ravithakkar011/ECE445-Home-Appliance-Energy-Monitor/boards/board3/plainboard.jpg

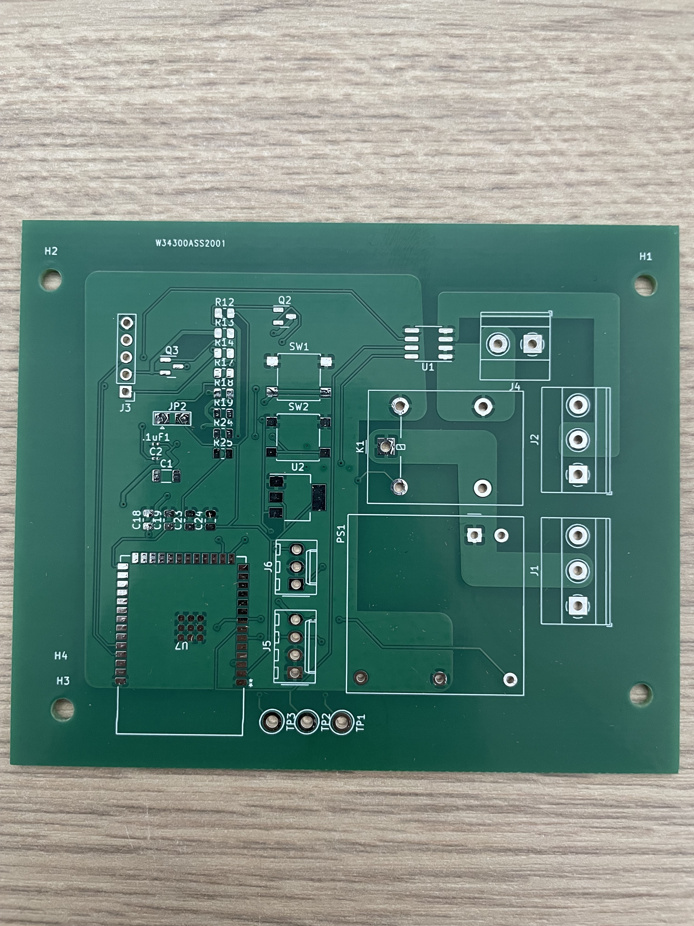
boards/board3/plainboard.jpg
