ravithakkar011/ECE445-Home-Appliance-Energy-Monitor/shared-notebook/FinalPresentation.pdf

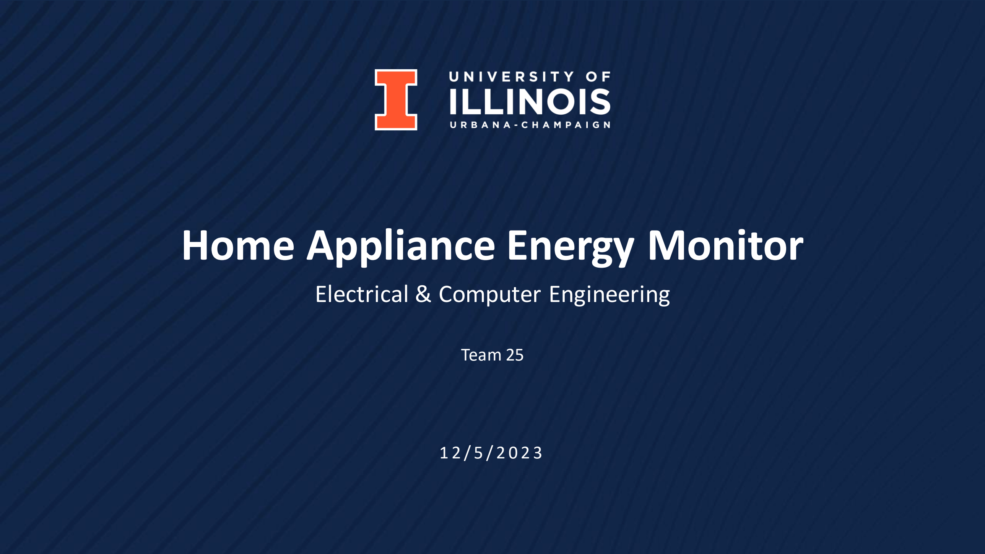
[picture p17: page 1]

# Home Appliance Energy Monitor

## Electrical & Computer Engineering

Team 25

1 2 / 5 / 2 0 2 3

## Team Members

- Guneet Sachdeva: Senior in Computer Engineering
- Om Patel: Senior in Computer Engineering
- Ravi Thakkar: Senior in Computer Engineering

Photos of Team Members

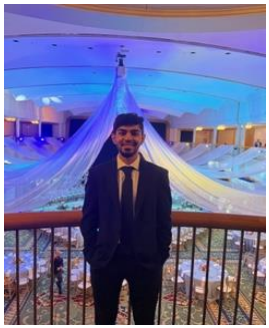
[picture p18: figure]
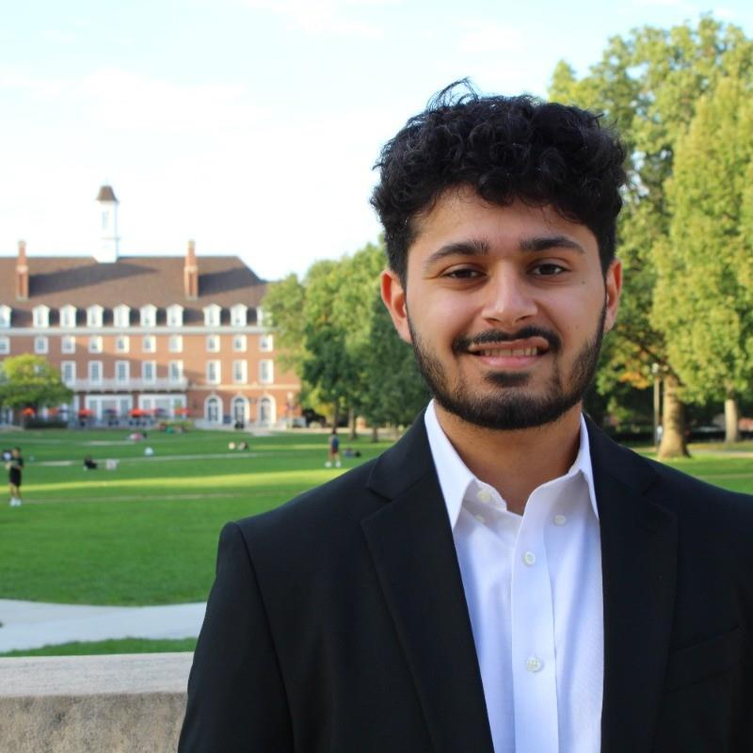
[picture p19: figure]

1 | G R A I N G E R E N G I N E E R I N G

## Team Intro

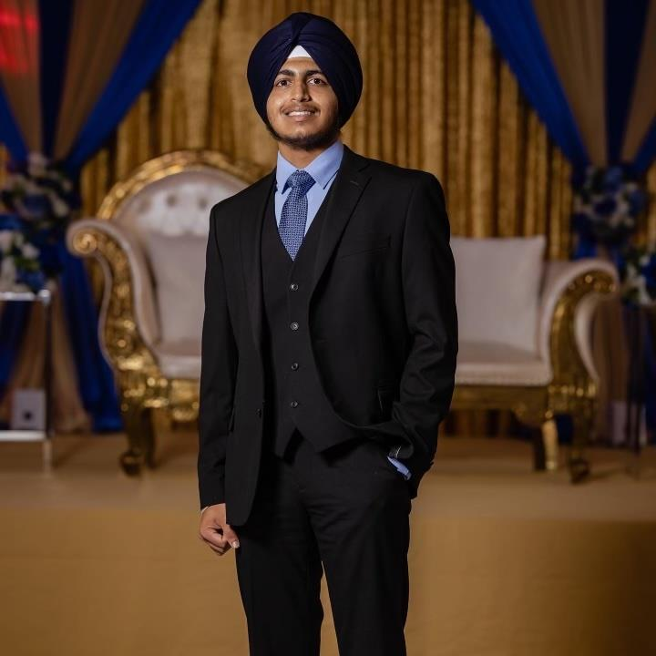
[picture p20: figure]

E L E C T R I C A L & C O M P U T E R E N G I N E E R I N G

## What compelled us to pick this project?

## Background

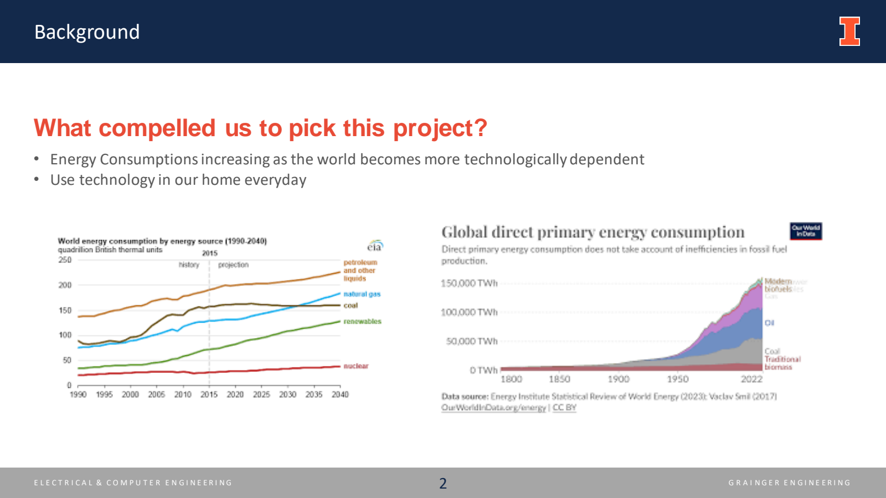
[picture p21: page 3]

- Energy Consumptions increasing as the world becomes more technologically dependent
- Use technology in our home everyday

## What problems need to be solved?

- The modern lifestyle does not allow us to be mindful of electricity consumption
- Users are unaware of which appliances disproportionately contribute to the total electricity consumption
- Therefore, an average of 34% of electricity in a household is wasted

## Problem

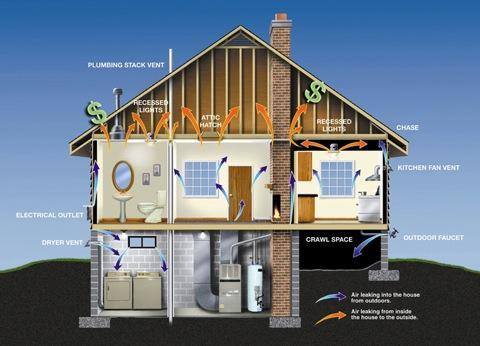
[picture p22: figure]

## What is the solution to the problem?

- An energy metering system that relays power consumption data to a user-friendly application

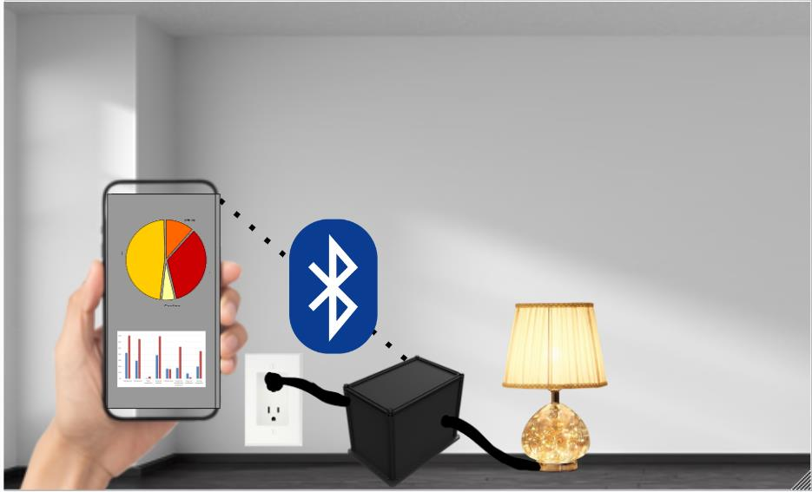
[picture p23: figure]

Visual Aid of Solution

## Solution

## Agenda

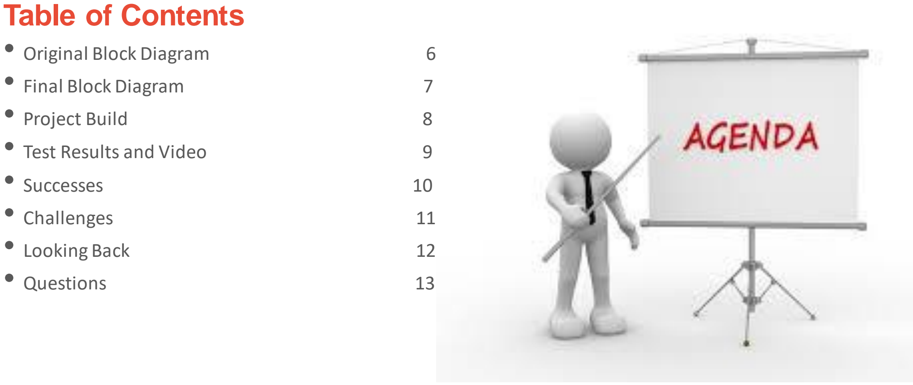
[picture p24: figure]
Table of Contents; • Original Block Diagram; • Final Block Diagram; • Project Build; • Test Results and Video; • Successes; • Challenges; • Looking Back; • Questions

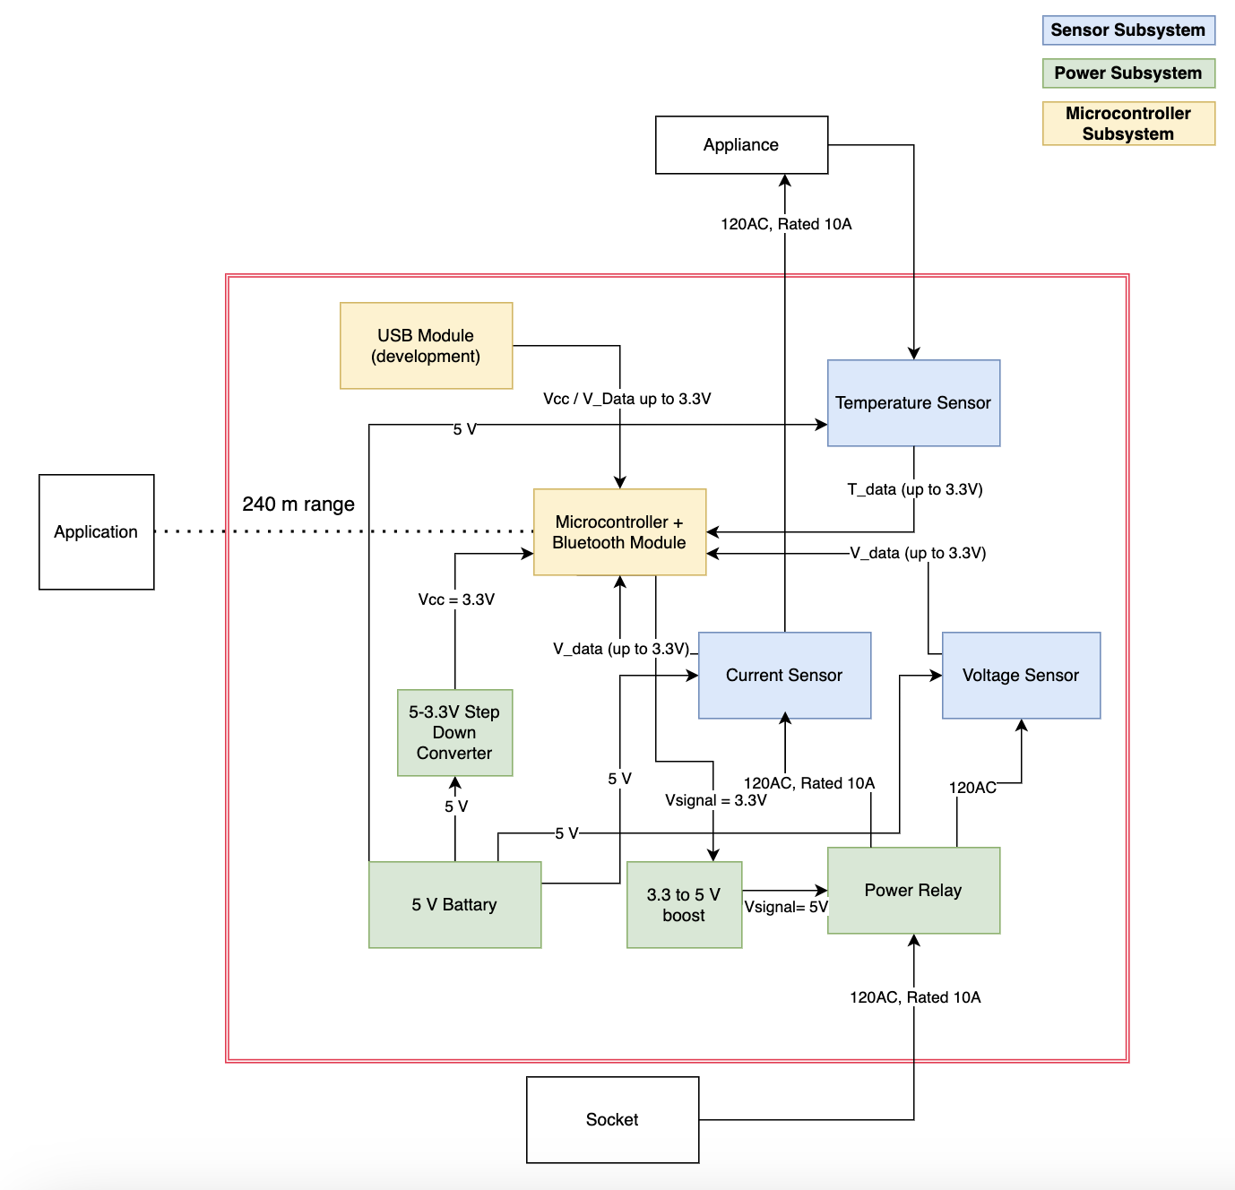
[picture p25: figure]

## - 4 Subsystem Model

### oHigh Power oLow Power oSensor

- Temperature
- Current
- Voltage

### oMicrocontroller

- MCU Control Firmware
- Graphical Application
- BLE Server/Service Setup Firmware

## Original Block Diagram

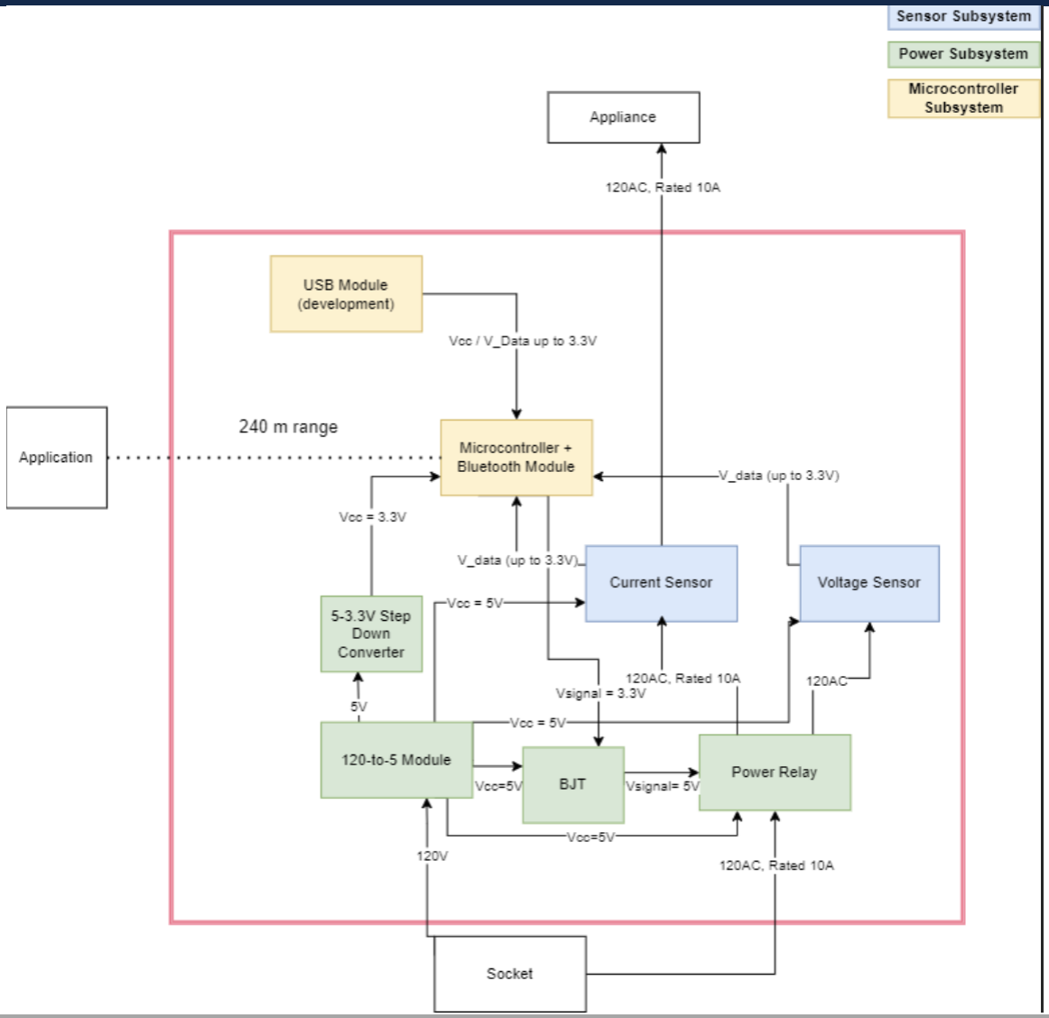
[picture p26: figure]

## - 3 Subsystem Model

### oHigh Power oLow Power oSensor

- Temperature
- Current
- Voltage

### oMicrocontroller

- MCU Control Firmware
- Graphical Application
- BLE Server/Service Setup Firmware

## Final Block Diagram

## What our project looks like?

## Project Build

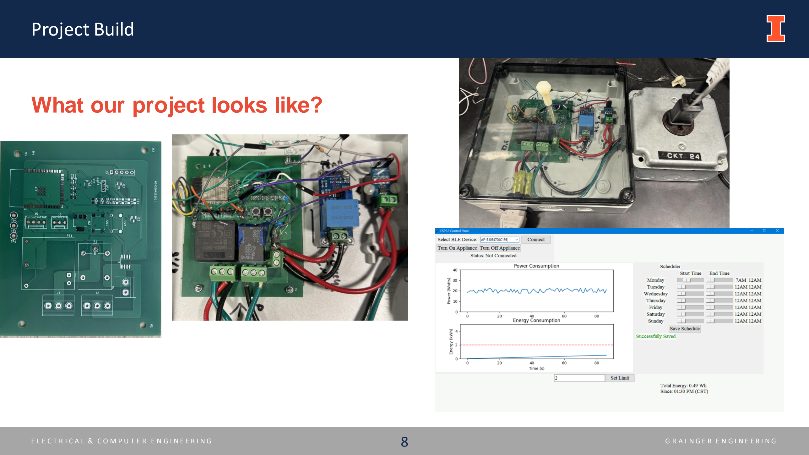
[picture p27: page 9]

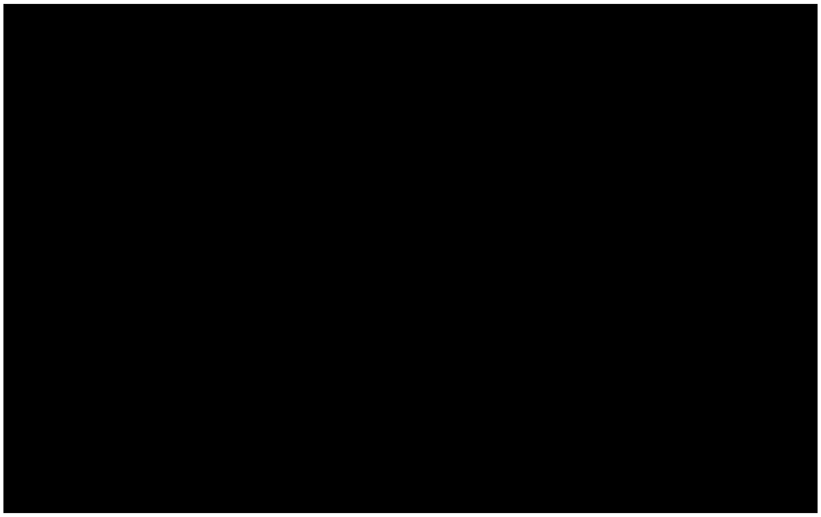
[picture p28: figure]

## Tests and Results: Fan

- Fan off, Power Relay On
- Voltmeter: about 120 Volts
- Ammeter: 0 A
- Fan on level 1, Power Relay On
- Voltmeter: about 120 Volts
- Ammeter: 242.5 mA
- Fan on level 2, Power Relay On
- Voltmeter: about 120 Volts
- Ammeter: 312.5 mA
- Fan on level 1, Power Relay Off
- Voltmeter: about 0 Volts
- Ammeter: 0 A

## Test Results and Video

## Where did we succeed in our project?

- Handling high voltage and current coming out of the socket
- Controlling power supply to the connected appliance
- Relaying information to the application via Bluetooth Low Energy

## Successes

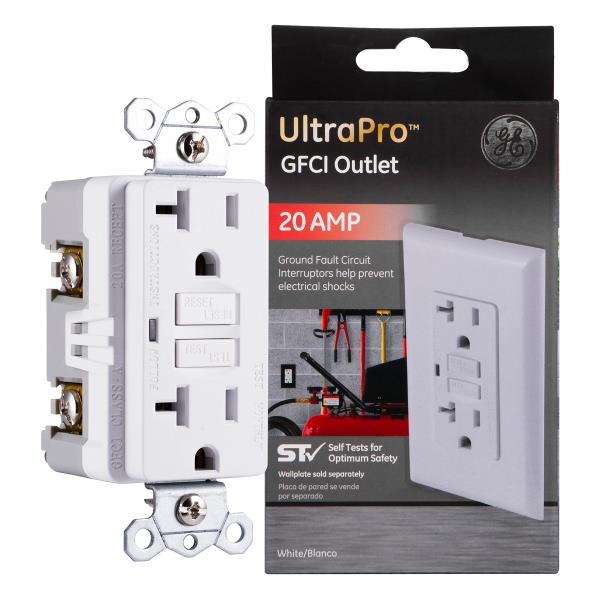
[picture p29: figure]
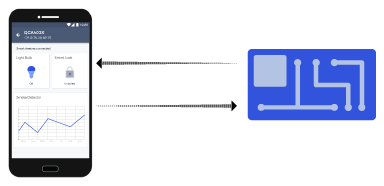
[picture p30: figure]
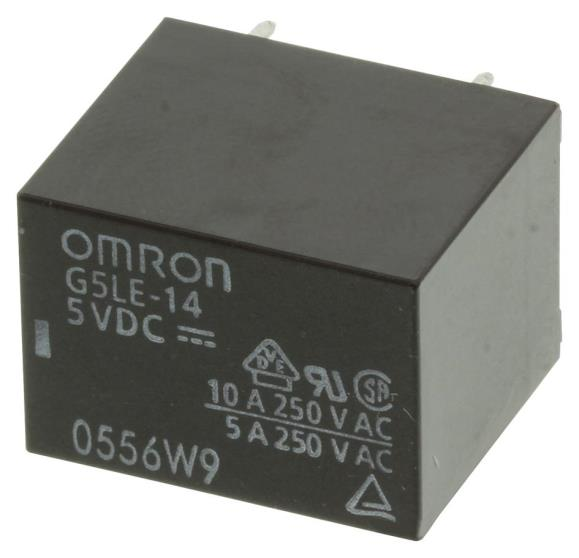
[picture p31: figure]

## - What are some challenges we faced with our project?

- Understanding the Microcontroller pin assignments
- Soldering the Microcontroller
- Current Sensor got Burnt during testing
- Too much power draw by Microcontroller chip
- Could not use 3.3V to 5V boost

## Challenges

## What process and design elements would we change?

- Solder components that use the oven first
- Get extra parts early on
- Check user rating of modules that we use
- Separate PCBs for high and low voltage
- Include more access points for testing

What did we learn?
- Theoretical circuit design vs physical implementation
- Microcontroller based logic
- Industry based design procedures

## Looking Back

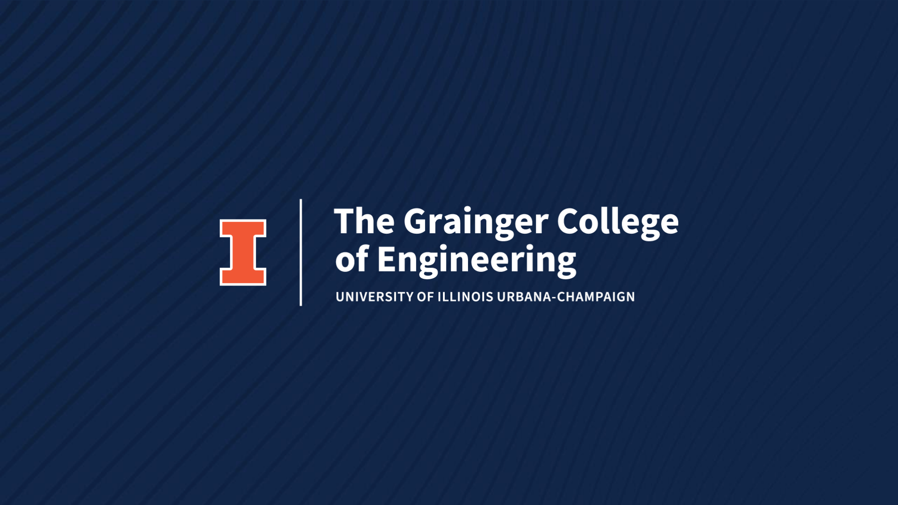
[picture p32: page 14]
