ravithakkar011/ECE445-Home-Appliance-Energy-Monitor/models/originalBlockDiagram.pdf

Sensor Subsystem

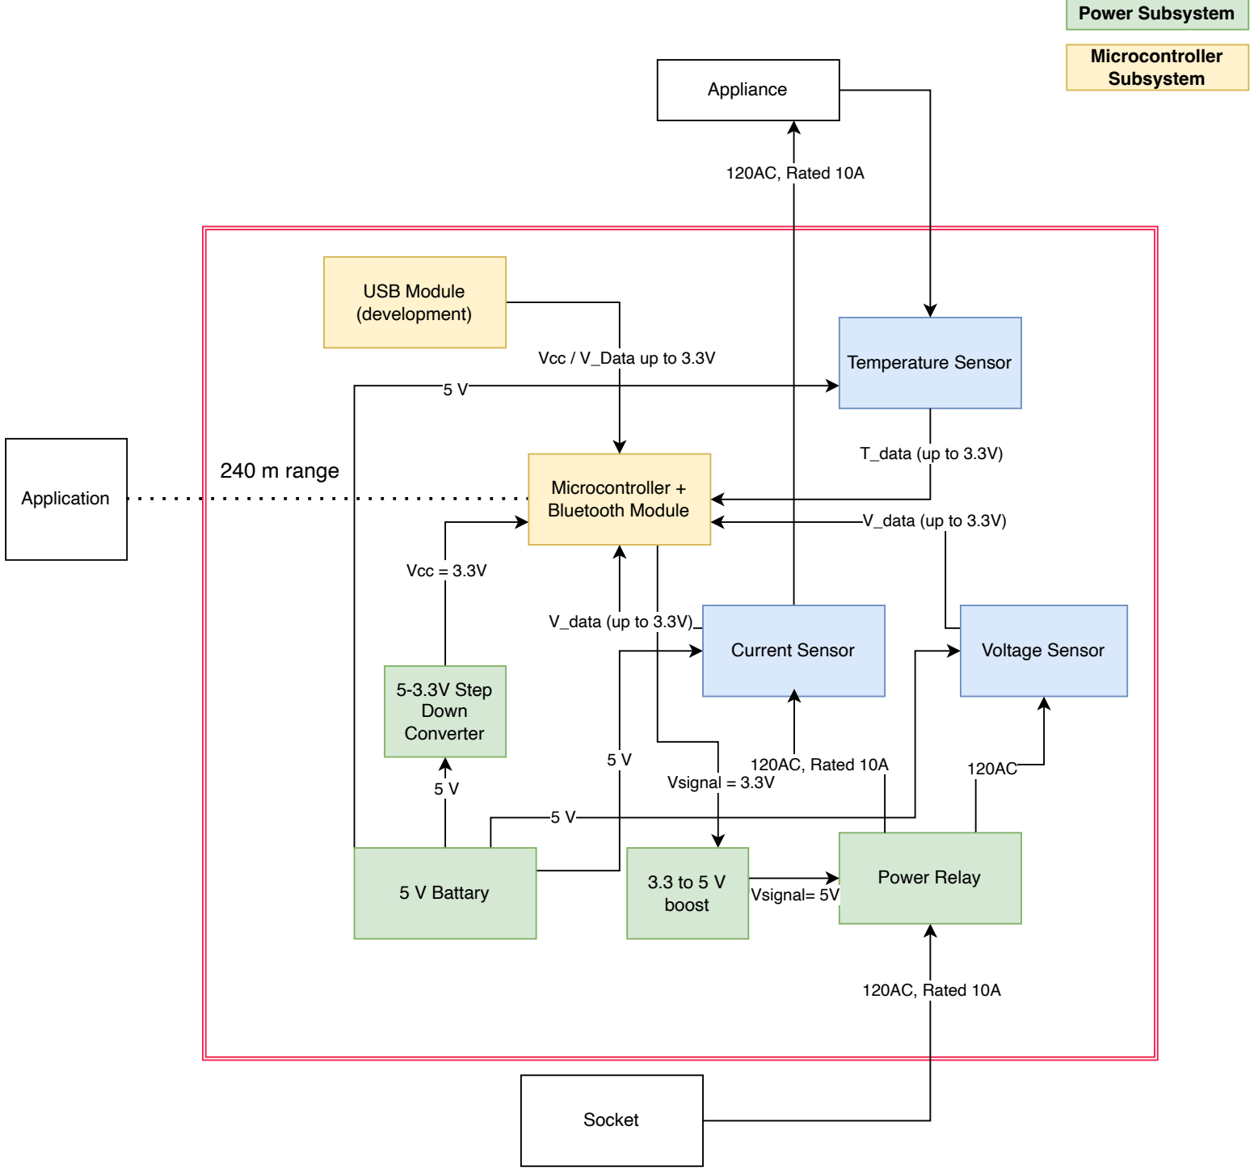
[picture p33: figure]
Appliance; Vsignal = 3.3V; Microcontroller + Bluetooth Module; 120AC, Rated 10A; Socket; Application; 240 m range; 5 V Battary; Power Relay; V_data (up to 3.3V); Voltage Sensor; Current Sensor; Vcc = 3.3V; 5-3.3V Step Down Converter; Power Subsystem; Microcontroller Subsystem; Vcc / V_Data up to 3.3V; USB Module (development); Vsignal= 5V 3.3 to 5 V boost; Temperature Sensor; T_data (up to 3.3V)
