ravithakkar011/ECE445-Home-Appliance-Energy-Monitor/notebooks/guneet/SensorEquationsAndUnderstanding.pdf

// currSensorValue = analogRead(A12);

Read the sensor values from an actual ADC pin

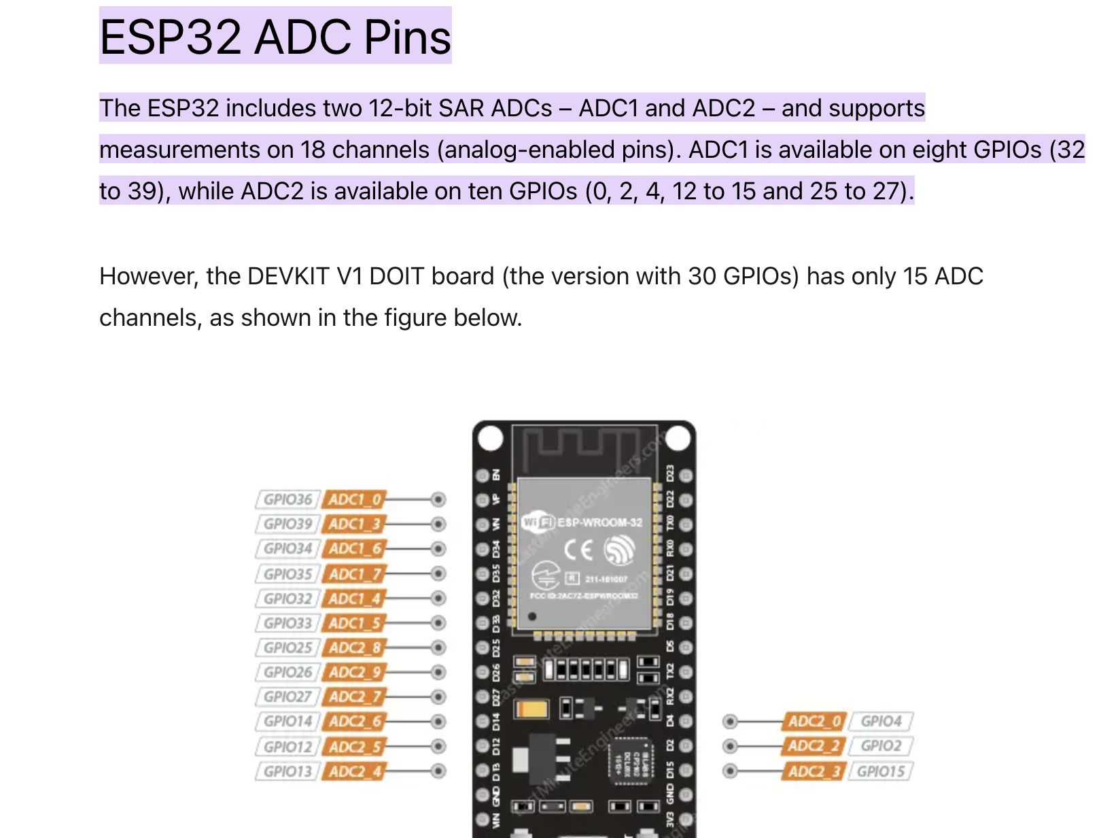
[picture p34: figure]

// currVoltage = (currSensorValue * (5.0/ 1024));

Have to bring this signal to a digital equivalent by multiplying by Vref and then dividing by the ADC resolution bits.

// current = (2.5 - currVoltage) / 0.185;

Match the Vout to a sensed current using the linear equation from the graph

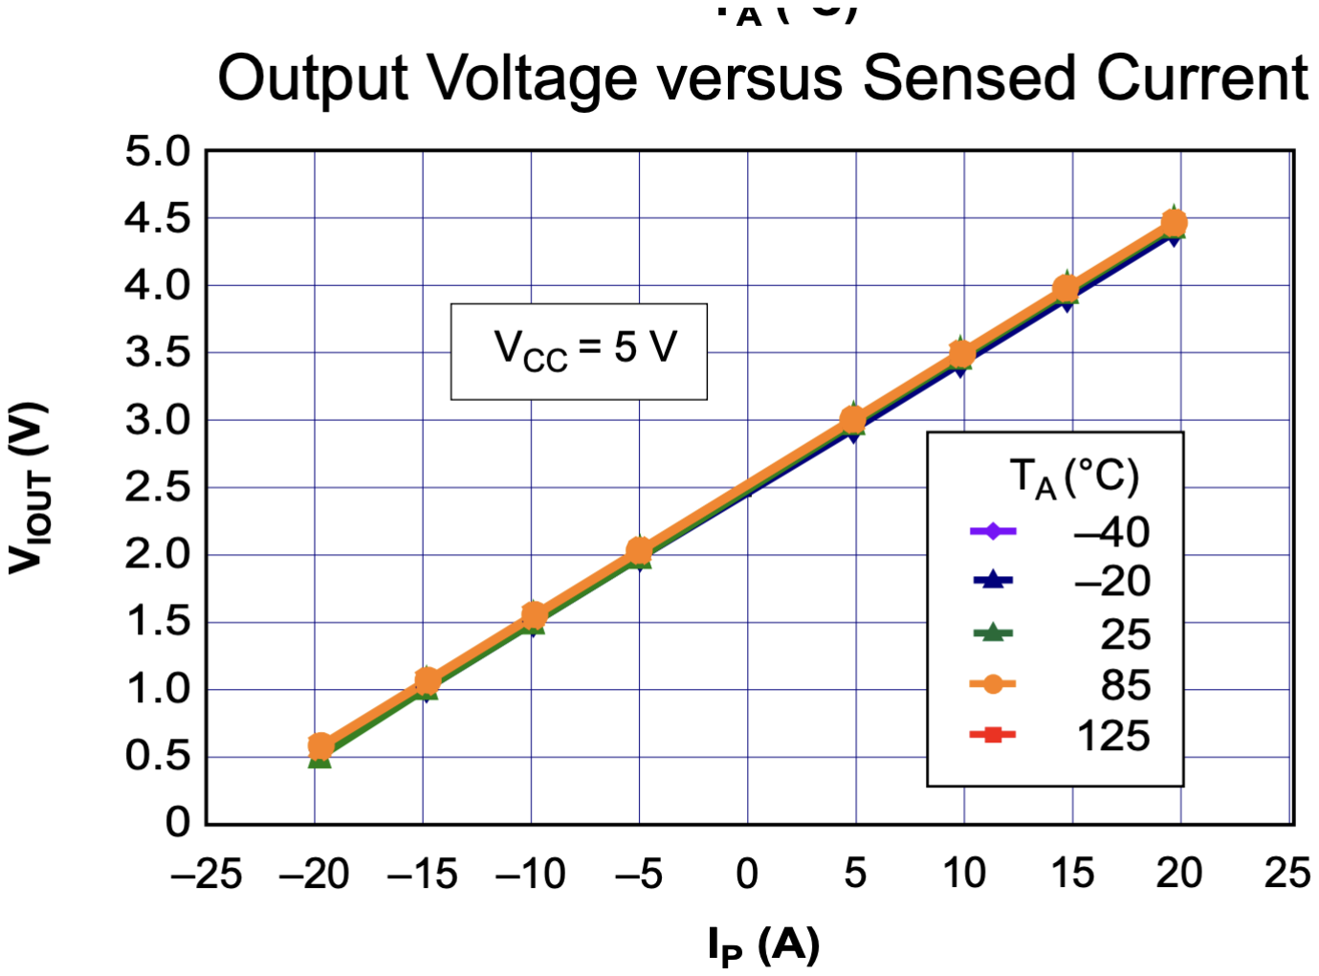
[picture p35: figure]

// volSensorValue = analogRead(12);
Analog read on an actual ADC pin

// voltage = (volSensorValue / 4095.0) * 3.3;
Have to bring this signal to a digital equivalent by multiplying by Vref and then dividing by the ADC resolution bits.

Don’t have anything else to do with the signal because the module takes care of everything else.
