ravithakkar011/ECE445-Home-Appliance-Energy-Monitor/notebooks/om/ 9. 9-19-23 Team Meeting.pdf

Date: 9/19/23

Overview: Team meeting to start Design Document

Record: Met with the team to start our design document. We started the design process by first picking the necessary parts. When looking for parts, we made sure that the high voltage interacting parts were rated for international standards of 250 V, 20 Amps. As a team we decided to use the following parts:

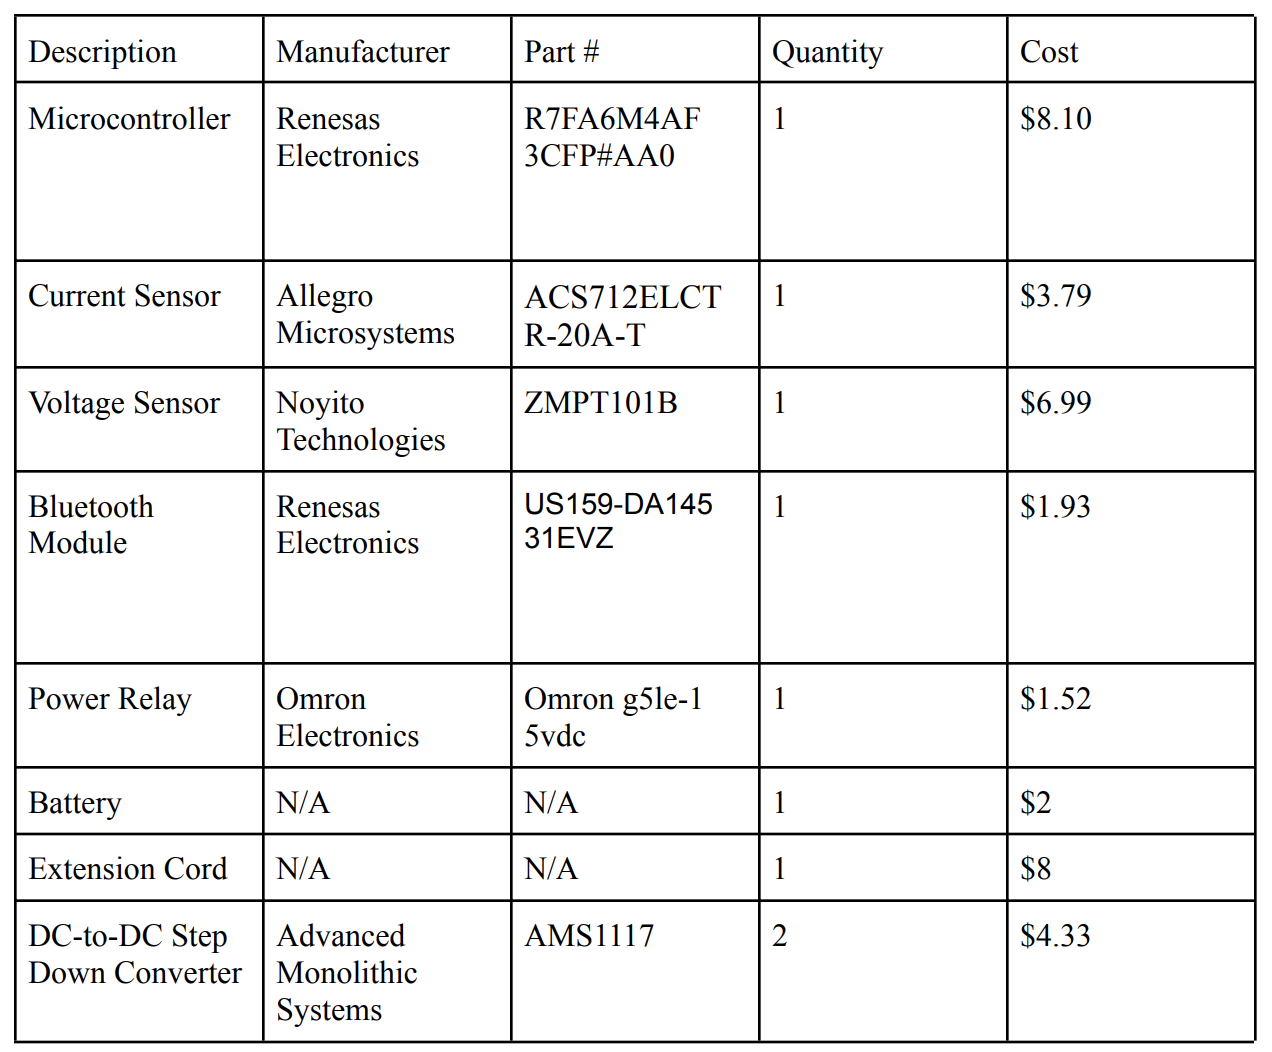
[picture p36: figure]

The microcontroller and bluetooth module were picked by Guneet Sachdeva as he has had prior experience using these components. Once we picked parts, we split up tasks where I was given the cost and schedule section, and the ethics section. I also helped with the subsystem description and requirements.
