ravithakkar011/ECE445-Home-Appliance-Energy-Monitor/notebooks/ravi/Peer Meeting Notes/9-1-23 Initial Design.pdf

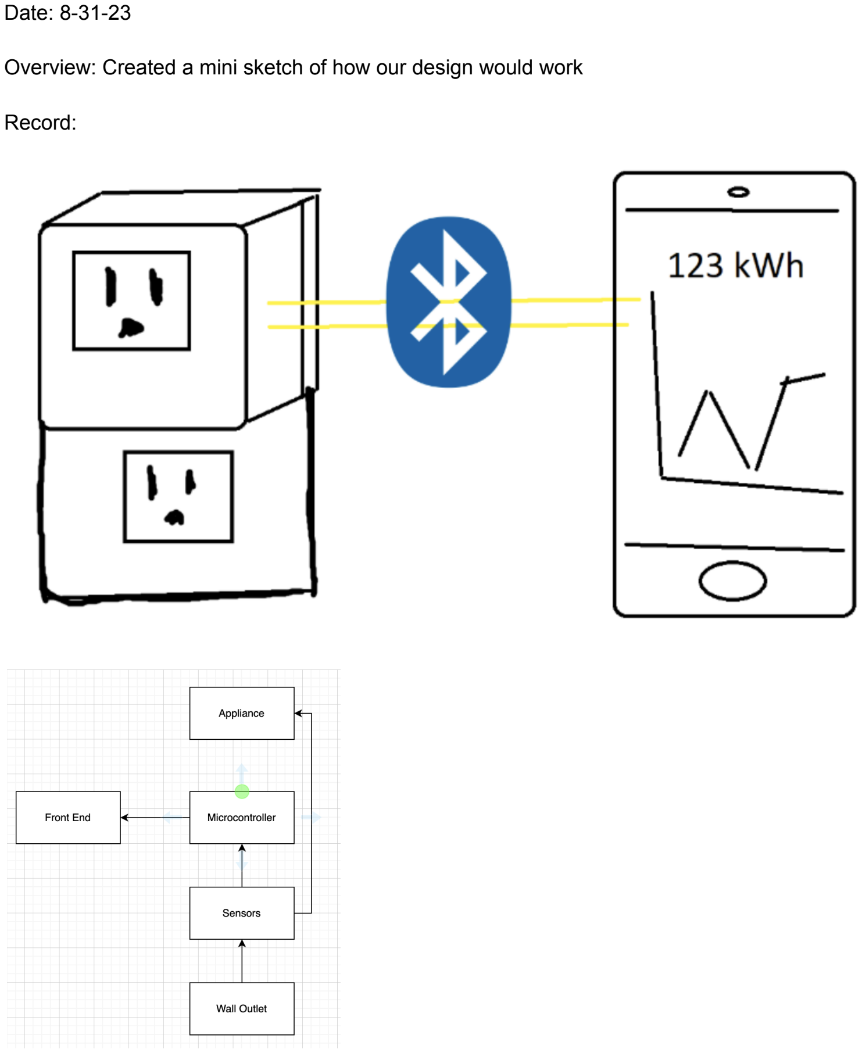
[picture p38: page 1]

Date: 8-31-23

Overview: Created a mini sketch of how our design would work

Record:
