ravithakkar011/ECE445-Home-Appliance-Energy-Monitor/notebooks/om/ 10. 9-21-23 Team Meeting.pdf

Date: 9/21/23

Overview: Team meeting with TA

Record: Discussed with our ta the parts that we picked and verified our block diagram. TA suggested that we add labels to our connections. This produced our submitted block diagram on the design document. Here is the block diagram:

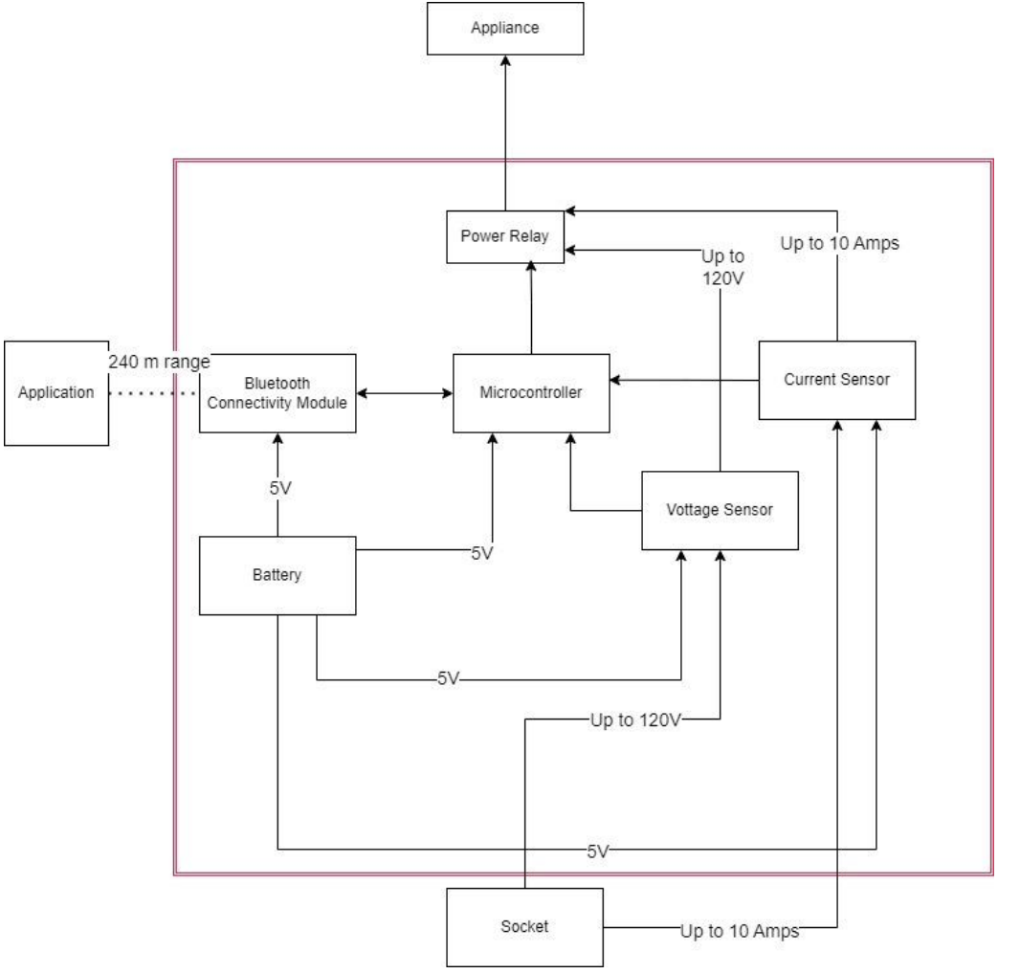
[picture p39: figure]

Not much else was discussed, the meeting was more for our team and TA to check that we were on track.
