ravithakkar011/ECE445-Home-Appliance-Energy-Monitor/notebooks/om/Schematic1_img.png

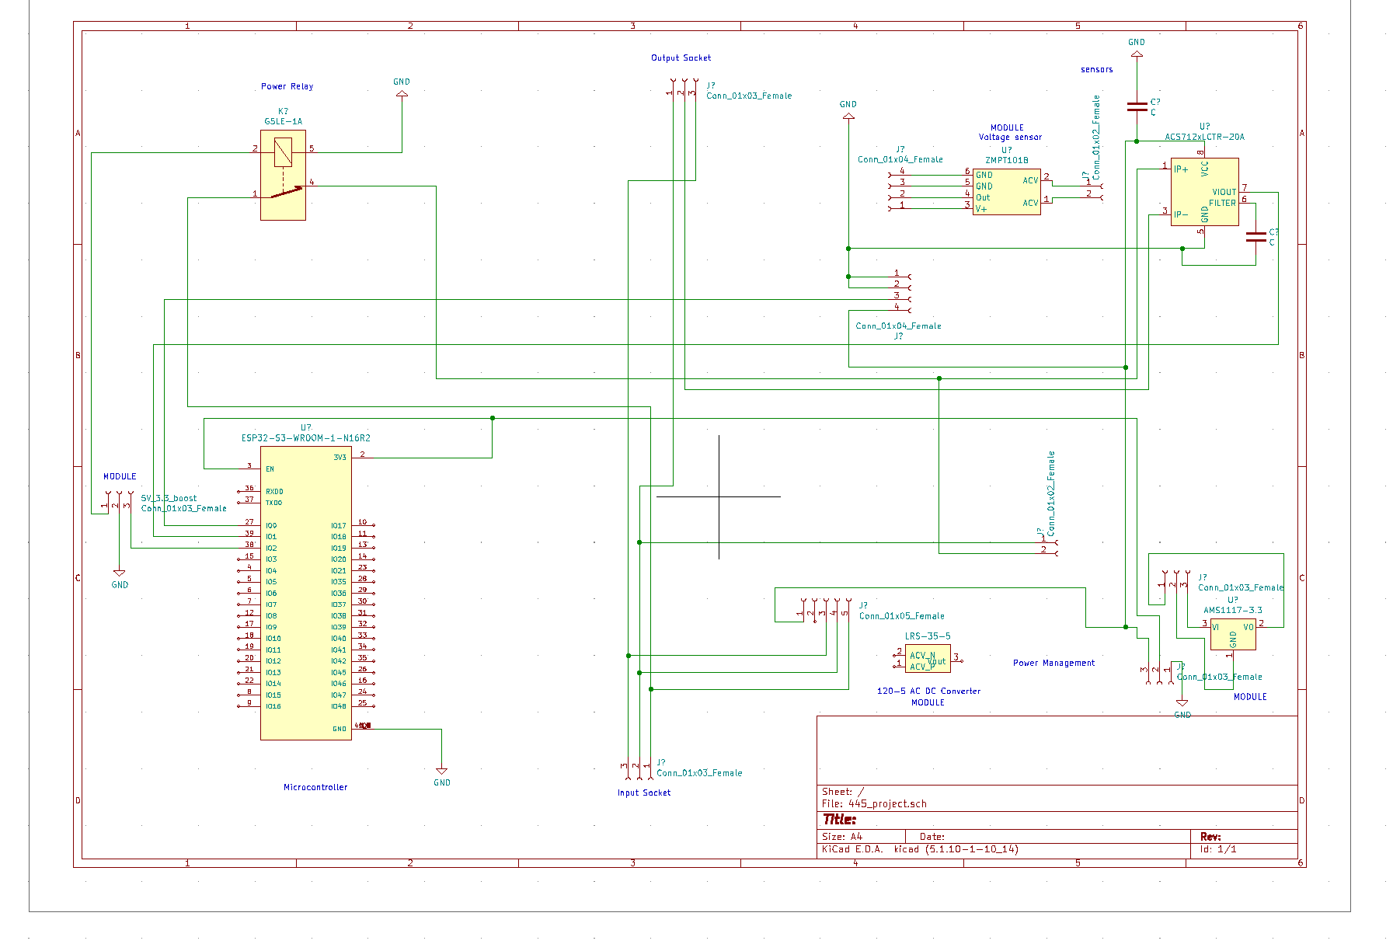
notebooks/om/Schematic1_img.png
