ravithakkar011/ECE445-Home-Appliance-Energy-Monitor/notebooks/ravi/BlockDiagram_Draft2.jpg

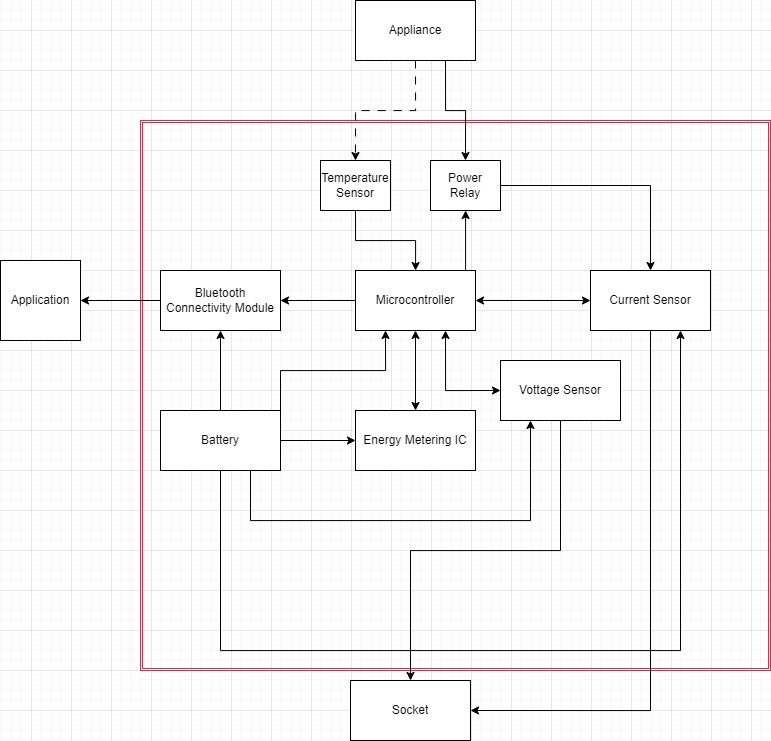
notebooks/ravi/BlockDiagram_Draft2.jpg
