ravithakkar011/ECE445-Home-Appliance-Energy-Monitor/code/Final ESP Python Interface/build/esp_controller/xref-esp_controller.html

# modulegraph cross reference for esp_controller.py, pyi_rth__tkinter.py, pyi_rth_inspect.py, pyi_rth_mplconfig.py, pyi_rth_multiprocessing.py, pyi_rth_pkgres.py, pyi_rth_pkgutil.py

esp_controller.py Script

imports: _collections_abc • _weakrefset • abc • asyncio • bleak • codecs • collections • collections.abc • copyreg • encodings • encodings.aliases • encodings.ascii • encodings.base64_codec • encodings.big5 • encodings.big5hkscs • encodings.bz2_codec • encodings.charmap • encodings.cp037 • encodings.cp1006 • encodings.cp1026 • encodings.cp1125 • encodings.cp1140 • encodings.cp1250 • encodings.cp1251 • encodings.cp1252 • encodings.cp1253 • encodings.cp1254 • encodings.cp1255 • encodings.cp1256 • encodings.cp1257 • encodings.cp1258 • encodings.cp273 • encodings.cp424 • encodings.cp437 • encodings.cp500 • encodings.cp720 • encodings.cp737 • encodings.cp775 • encodings.cp850 • encodings.cp852 • encodings.cp855 • encodings.cp856 • encodings.cp857 • encodings.cp858 • encodings.cp860 • encodings.cp861 • encodings.cp862 • encodings.cp863 • encodings.cp864 • encodings.cp865 • encodings.cp866 • encodings.cp869 • encodings.cp874 • encodings.cp875 • encodings.cp932 • encodings.cp949 • encodings.cp950 • encodings.euc_jis_2004 • encodings.euc_jisx0213 • encodings.euc_jp • encodings.euc_kr • encodings.gb18030 • encodings.gb2312 • encodings.gbk • encodings.hex_codec • encodings.hp_roman8 • encodings.hz • encodings.idna • encodings.iso2022_jp • encodings.iso2022_jp_1 • encodings.iso2022_jp_2 • encodings.iso2022_jp_2004 • encodings.iso2022_jp_3 • encodings.iso2022_jp_ext • encodings.iso2022_kr • encodings.iso8859_1 • encodings.iso8859_10 • encodings.iso8859_11 • encodings.iso8859_13 • encodings.iso8859_14 • encodings.iso8859_15 • encodings.iso8859_16 • encodings.iso8859_2 • encodings.iso8859_3 • encodings.iso8859_4 • encodings.iso8859_5 • encodings.iso8859_6 • encodings.iso8859_7 • encodings.iso8859_8 • encodings.iso8859_9 • encodings.johab • encodings.koi8_r • encodings.koi8_t • encodings.koi8_u • encodings.kz1048 • encodings.latin_1 • encodings.mac_arabic • encodings.mac_croatian • encodings.mac_cyrillic • encodings.mac_farsi • encodings.mac_greek • encodings.mac_iceland • encodings.mac_latin2 • encodings.mac_roman • encodings.mac_romanian • encodings.mac_turkish • encodings.mbcs • encodings.oem • encodings.palmos • encodings.ptcp154 • encodings.punycode • encodings.quopri_codec • encodings.raw_unicode_escape • encodings.rot_13 • encodings.shift_jis • encodings.shift_jis_2004 • encodings.shift_jisx0213 • encodings.tis_620 • encodings.undefined • encodings.unicode_escape • encodings.utf_16 • encodings.utf_16_be • encodings.utf_16_le • encodings.utf_32 • encodings.utf_32_be • encodings.utf_32_le • encodings.utf_7 • encodings.utf_8 • encodings.utf_8_sig • encodings.uu_codec • encodings.zlib_codec • enum • functools • genericpath • heapq • io • keyword • linecache • locale • matplotlib.backends.backend_tkagg • matplotlib.figure • ntpath • operator • os • posixpath • pyi_rth__tkinter.py • pyi_rth_inspect.py • pyi_rth_mplconfig.py • pyi_rth_multiprocessing.py • pyi_rth_pkgres.py • pyi_rth_pkgutil.py • re • re._casefix • re._compiler • re._constants • re._parser • reprlib • sre_compile • sre_constants • sre_parse • stat • threading • tkinter • tkinter.ttk • traceback • types • warnings • weakref

pyi_rth__tkinter.py Script

imports: os • sys

imported by: esp_controller.py

pyi_rth_inspect.py Script

imports: inspect • os • sys

imported by: esp_controller.py

pyi_rth_mplconfig.py Script

imports: _pyi_rth_utils.tempfile • atexit • os • shutil

imported by: esp_controller.py

pyi_rth_multiprocessing.py Script

imports: multiprocessing • multiprocessing.popen_forkserver • multiprocessing.popen_spawn_posix • multiprocessing.popen_spawn_win32 • multiprocessing.spawn • os • subprocess • sys • threading

imported by: esp_controller.py

pyi_rth_pkgres.py Script

imports: os • pathlib • pkg_resources • pyimod02_importers • sys

imported by: esp_controller.py

pyi_rth_pkgutil.py Script

imports: _pyi_rth_utils • pathlib • pkgutil • pyimod02_importers • sys

imported by: esp_controller.py

'IPython.core' MissingModule

imported by: matplotlib.backend_bases • matplotlib.pyplot

'android.broadcast' MissingModule

imported by: bleak.backends.p4android.scanner

'android.permissions' MissingModule

imported by: bleak.backends.p4android.scanner

'bleak_winrt.windows.applicationmodel' MissingModule

imported by: bleak_winrt.windows.devices.enumeration

'bleak_winrt.windows.devices.bluetooth.rfcomm' MissingModule

imported by: bleak_winrt.windows.devices.bluetooth

'bleak_winrt.windows.devices.radios' MissingModule

imported by: bleak_winrt.windows.devices.bluetooth

'bleak_winrt.windows.networking' MissingModule

imported by: bleak_winrt.windows.devices.bluetooth

'bleak_winrt.windows.security' MissingModule

imported by: bleak_winrt.windows.devices.enumeration

'bleak_winrt.windows.system' MissingModule

imported by: bleak_winrt.windows.storage.streams

'bleak_winrt.windows.ui' MissingModule

imported by: bleak_winrt.windows.devices.enumeration

'com.sun' MissingModule

imported by: pkg_resources._vendor.appdirs

'dbus_fast.aio' MissingModule

imported by: bleak.backends.bluezdbus.manager • bleak.backends.bluezdbus.signals

'dbus_fast.auth' MissingModule

imported by: bleak.backends.bluezdbus.utils

'dbus_fast.constants' MissingModule

imported by: bleak.backends.bluezdbus.client • bleak.backends.bluezdbus.utils

'dbus_fast.errors' MissingModule

imported by: bleak.backends.bluezdbus.signals

'dbus_fast.message' MissingModule

imported by: bleak.backends.bluezdbus.client • bleak.backends.bluezdbus.signals • bleak.backends.bluezdbus.utils

'dbus_fast.service' MissingModule

imported by: bleak.backends.bluezdbus.advertisement_monitor

'dbus_fast.signature' MissingModule

imported by: bleak.backends.bluezdbus.client

'dbus_fast.validators' MissingModule

imported by: bleak.backends.bluezdbus.signals

'java.lang' MissingModule

imported by: platform • xml.sax._exceptions

'org.python' MissingModule

imported by: copy • xml.sax

'pkg_resources.extern.importlib_resources' MissingModule

imported by: pkg_resources._vendor.jaraco.text

'pkg_resources.extern.jaraco' MissingModule

imported by: pkg_resources • pkg_resources._vendor.jaraco.text

'pkg_resources.extern.more_itertools' MissingModule

imported by: pkg_resources._vendor.jaraco.functools

'pkg_resources.extern.pyparsing' MissingModule

imported by: pkg_resources._vendor.packaging.markers • pkg_resources._vendor.packaging.requirements

'tornado.ioloop' MissingModule

imported by: matplotlib.backends.backend_webagg

'tornado.template' MissingModule

imported by: matplotlib.backends.backend_webagg

'tornado.web' MissingModule

imported by: matplotlib.backends.backend_webagg

'tornado.websocket' MissingModule

imported by: matplotlib.backends.backend_webagg

'win32com.shell' MissingModule

imported by: pkg_resources._vendor.appdirs

'winrt.windows' MissingModule

imported by: bleak.backends.winrt.characteristic • bleak.backends.winrt.client • bleak.backends.winrt.descriptor • bleak.backends.winrt.service

CoreBluetooth MissingModule

imported by: bleak.backends.corebluetooth.CentralManagerDelegate • bleak.backends.corebluetooth.PeripheralDelegate • bleak.backends.corebluetooth.characteristic • bleak.backends.corebluetooth.client • bleak.backends.corebluetooth.descriptor • bleak.backends.corebluetooth.scanner • bleak.backends.corebluetooth.service • bleak.backends.corebluetooth.utils

Foundation MissingModule

imported by: bleak.backends.corebluetooth.CentralManagerDelegate • bleak.backends.corebluetooth.PeripheralDelegate • bleak.backends.corebluetooth.client • bleak.backends.corebluetooth.scanner • bleak.backends.corebluetooth.utils

IPython MissingModule

imported by: matplotlib.backend_bases • matplotlib.pyplot

PIL Package

imports: PIL • PIL.BmpImagePlugin • PIL.ExifTags • PIL.GifImagePlugin • PIL.GimpGradientFile • PIL.GimpPaletteFile • PIL.Image • PIL.ImageChops • PIL.ImageCms • PIL.ImageColor • PIL.ImageFile • PIL.ImageFilter • PIL.ImageMode • PIL.ImageOps • PIL.ImagePalette • PIL.ImageQt • PIL.ImageSequence • PIL.ImageShow • PIL.ImageTk • PIL.ImageWin • PIL.Jpeg2KImagePlugin • PIL.JpegImagePlugin • PIL.PaletteFile • PIL.PdfParser • PIL.PngImagePlugin • PIL.PpmImagePlugin • PIL.PyAccess • PIL.TiffImagePlugin • PIL.TiffTags • PIL._imaging • PIL._imagingcms • PIL._imagingtk • PIL._version • PIL._webp • PIL.features

imported by: PIL • PIL.BlpImagePlugin • PIL.BmpImagePlugin • PIL.BufrStubImagePlugin • PIL.CurImagePlugin • PIL.DcxImagePlugin • PIL.DdsImagePlugin • PIL.EpsImagePlugin • PIL.ExifTags • PIL.FitsImagePlugin • PIL.FliImagePlugin • PIL.FpxImagePlugin • PIL.FtexImagePlugin • PIL.GbrImagePlugin • PIL.GifImagePlugin • PIL.GimpGradientFile • PIL.GimpPaletteFile • PIL.GribStubImagePlugin • PIL.Hdf5StubImagePlugin • PIL.IcnsImagePlugin • PIL.IcoImagePlugin • PIL.ImImagePlugin • PIL.Image • PIL.ImageChops • PIL.ImageCms • PIL.ImageColor • PIL.ImageFile • PIL.ImageFilter • PIL.ImageMode • PIL.ImageOps • PIL.ImagePalette • PIL.ImageQt • PIL.ImageSequence • PIL.ImageShow • PIL.ImageTk • PIL.ImageWin • PIL.ImtImagePlugin • PIL.IptcImagePlugin • PIL.Jpeg2KImagePlugin • PIL.JpegImagePlugin • PIL.JpegPresets • PIL.McIdasImagePlugin • PIL.MicImagePlugin • PIL.MpegImagePlugin • PIL.MpoImagePlugin • PIL.MspImagePlugin • PIL.PaletteFile • PIL.PalmImagePlugin • PIL.PcdImagePlugin • PIL.PcxImagePlugin • PIL.PdfImagePlugin • PIL.PdfParser • PIL.PixarImagePlugin • PIL.PngImagePlugin • PIL.PpmImagePlugin • PIL.PsdImagePlugin • PIL.PyAccess • PIL.QoiImagePlugin • PIL.SgiImagePlugin • PIL.SpiderImagePlugin • PIL.SunImagePlugin • PIL.TgaImagePlugin • PIL.TiffImagePlugin • PIL.TiffTags • PIL.WebPImagePlugin • PIL.WmfImagePlugin • PIL.XVThumbImagePlugin • PIL.XbmImagePlugin • PIL.XpmImagePlugin • PIL._binary • PIL._deprecate • PIL._imaging • PIL._imagingcms • PIL._imagingtk • PIL._util • PIL._version • PIL._webp • PIL.features • matplotlib.backends._backend_tk • matplotlib.backends.backend_webagg_core • matplotlib.colors

PIL.BlpImagePlugin SourceModule

imports: PIL • PIL.Image • PIL.ImageFile • PIL.JpegImagePlugin • enum • io • os • struct

imported by: PIL.Image

PIL.BmpImagePlugin SourceModule

imports: PIL • PIL.Image • PIL.ImageFile • PIL.ImagePalette • PIL._binary • os

imported by: PIL • PIL.CurImagePlugin • PIL.IcoImagePlugin • PIL.Image

PIL.BufrStubImagePlugin SourceModule

imports: PIL • PIL.Image • PIL.ImageFile

imported by: PIL.Image

PIL.CurImagePlugin SourceModule

imports: PIL • PIL.BmpImagePlugin • PIL.Image • PIL._binary

imported by: PIL.Image

PIL.DcxImagePlugin SourceModule

imports: PIL • PIL.Image • PIL.PcxImagePlugin • PIL._binary

imported by: PIL.Image

PIL.DdsImagePlugin SourceModule

imports: PIL • PIL.Image • PIL.ImageFile • PIL.ImagePalette • PIL._binary • io • struct

imported by: PIL.Image

PIL.EpsImagePlugin SourceModule

imports: PIL • PIL.Image • PIL.ImageFile • PIL._binary • PIL._deprecate • io • os • re • shutil • subprocess • sys • tempfile

imported by: PIL.Image

PIL.ExifTags SourceModule

imports: PIL • enum

imported by: PIL • PIL.Image • PIL.ImageOps • PIL.MpoImagePlugin • PIL.TiffImagePlugin

PIL.FitsImagePlugin SourceModule

imports: PIL • PIL.Image • PIL.ImageFile • math

imported by: PIL.Image

PIL.FliImagePlugin SourceModule

imports: PIL • PIL.Image • PIL.ImageFile • PIL.ImagePalette • PIL._binary • os

imported by: PIL.Image

PIL.FpxImagePlugin SourceModule

imports: PIL • PIL.Image • PIL.ImageFile • PIL._binary • olefile

imported by: PIL.Image

PIL.FtexImagePlugin SourceModule

imports: PIL • PIL.Image • PIL.ImageFile • enum • io • struct

imported by: PIL.Image

PIL.GbrImagePlugin SourceModule

imports: PIL • PIL.Image • PIL.ImageFile • PIL._binary

imported by: PIL.Image

PIL.GifImagePlugin SourceModule

imports: PIL • PIL.Image • PIL.ImageChops • PIL.ImageFile • PIL.ImagePalette • PIL.ImageSequence • PIL._binary • copy • enum • itertools • math • os • subprocess

imported by: PIL • PIL.Image

PIL.GimpGradientFile SourceModule

imports: PIL • PIL._binary • math

imported by: PIL • PIL.ImagePalette

PIL.GimpPaletteFile SourceModule

imports: PIL • PIL._binary • re

imported by: PIL • PIL.ImagePalette

PIL.GribStubImagePlugin SourceModule

imports: PIL • PIL.Image • PIL.ImageFile

imported by: PIL.Image

PIL.Hdf5StubImagePlugin SourceModule

imports: PIL • PIL.Image • PIL.ImageFile

imported by: PIL.Image

PIL.IcnsImagePlugin SourceModule

imports: PIL • PIL.Image • PIL.ImageFile • PIL.Jpeg2KImagePlugin • PIL.PngImagePlugin • PIL.features • io • os • struct • sys

imported by: PIL.Image

PIL.IcoImagePlugin SourceModule

imports: PIL • PIL.BmpImagePlugin • PIL.Image • PIL.ImageFile • PIL.PngImagePlugin • PIL._binary • io • math • warnings

imported by: PIL.Image

PIL.ImImagePlugin SourceModule

imports: PIL • PIL.Image • PIL.ImageFile • PIL.ImagePalette • os • re

imported by: PIL.Image

PIL.Image SourceModule

imports: PIL • PIL.BlpImagePlugin • PIL.BmpImagePlugin • PIL.BufrStubImagePlugin • PIL.CurImagePlugin • PIL.DcxImagePlugin • PIL.DdsImagePlugin • PIL.EpsImagePlugin • PIL.ExifTags • PIL.FitsImagePlugin • PIL.FliImagePlugin • PIL.FpxImagePlugin • PIL.FtexImagePlugin • PIL.GbrImagePlugin • PIL.GifImagePlugin • PIL.GribStubImagePlugin • PIL.Hdf5StubImagePlugin • PIL.IcnsImagePlugin • PIL.IcoImagePlugin • PIL.ImImagePlugin • PIL.ImageCms • PIL.ImageColor • PIL.ImageFilter • PIL.ImageMode • PIL.ImagePalette • PIL.ImageQt • PIL.ImageShow • PIL.ImtImagePlugin • PIL.IptcImagePlugin • PIL.Jpeg2KImagePlugin • PIL.JpegImagePlugin • PIL.McIdasImagePlugin • PIL.MicImagePlugin • PIL.MpegImagePlugin • PIL.MpoImagePlugin • PIL.MspImagePlugin • PIL.PalmImagePlugin • PIL.PcdImagePlugin • PIL.PcxImagePlugin • PIL.PdfImagePlugin • PIL.PixarImagePlugin • PIL.PngImagePlugin • PIL.PpmImagePlugin • PIL.PsdImagePlugin • PIL.PyAccess • PIL.QoiImagePlugin • PIL.SgiImagePlugin • PIL.SpiderImagePlugin • PIL.SunImagePlugin • PIL.TgaImagePlugin • PIL.TiffImagePlugin • PIL.TiffTags • PIL.WebPImagePlugin • PIL.WmfImagePlugin • PIL.XVThumbImagePlugin • PIL.XbmImagePlugin • PIL.XpmImagePlugin • PIL._binary • PIL._imaging • PIL._util • atexit • builtins • cffi • collections.abc • defusedxml • enum • io • logging • math • numpy • os • packaging.version • pathlib • re • struct • sys • tempfile • warnings

imported by: PIL • PIL.BlpImagePlugin • PIL.BmpImagePlugin • PIL.BufrStubImagePlugin • PIL.CurImagePlugin • PIL.DcxImagePlugin • PIL.DdsImagePlugin • PIL.EpsImagePlugin • PIL.FitsImagePlugin • PIL.FliImagePlugin • PIL.FpxImagePlugin • PIL.FtexImagePlugin • PIL.GbrImagePlugin • PIL.GifImagePlugin • PIL.GribStubImagePlugin • PIL.Hdf5StubImagePlugin • PIL.IcnsImagePlugin • PIL.IcoImagePlugin • PIL.ImImagePlugin • PIL.ImageChops • PIL.ImageCms • PIL.ImageColor • PIL.ImageFile • PIL.ImageFilter • PIL.ImageOps • PIL.ImageQt • PIL.ImageShow • PIL.ImageTk • PIL.ImageWin • PIL.ImtImagePlugin • PIL.IptcImagePlugin • PIL.Jpeg2KImagePlugin • PIL.JpegImagePlugin • PIL.McIdasImagePlugin • PIL.MicImagePlugin • PIL.MpegImagePlugin • PIL.MpoImagePlugin • PIL.MspImagePlugin • PIL.PalmImagePlugin • PIL.PcdImagePlugin • PIL.PcxImagePlugin • PIL.PdfImagePlugin • PIL.PixarImagePlugin • PIL.PngImagePlugin • PIL.PpmImagePlugin • PIL.PsdImagePlugin • PIL.QoiImagePlugin • PIL.SgiImagePlugin • PIL.SpiderImagePlugin • PIL.SunImagePlugin • PIL.TgaImagePlugin • PIL.TiffImagePlugin • PIL.WebPImagePlugin • PIL.WmfImagePlugin • PIL.XVThumbImagePlugin • PIL.XbmImagePlugin • PIL.XpmImagePlugin • PIL.features • matplotlib.backends._backend_tk • matplotlib.backends.backend_webagg_core • matplotlib.colors • matplotlib.image • matplotlib.pyplot

PIL.ImageChops SourceModule

imports: PIL • PIL.Image

imported by: PIL • PIL.GifImagePlugin • PIL.PngImagePlugin

PIL.ImageCms SourceModule

imports: PIL • PIL.Image • PIL.ImageWin • PIL._imagingcms • PIL._util • enum • sys

imported by: PIL • PIL.Image

PIL.ImageColor SourceModule

imports: PIL • PIL.Image • colorsys • re

imported by: PIL • PIL.Image • PIL.ImageOps • PIL.ImagePalette

PIL.ImageFile SourceModule

imports: PIL • PIL.Image • PIL._util • io • itertools • mmap • struct • sys

imported by: PIL • PIL.BlpImagePlugin • PIL.BmpImagePlugin • PIL.BufrStubImagePlugin • PIL.DdsImagePlugin • PIL.EpsImagePlugin • PIL.FitsImagePlugin • PIL.FliImagePlugin • PIL.FpxImagePlugin • PIL.FtexImagePlugin • PIL.GbrImagePlugin • PIL.GifImagePlugin • PIL.GribStubImagePlugin • PIL.Hdf5StubImagePlugin • PIL.IcnsImagePlugin • PIL.IcoImagePlugin • PIL.ImImagePlugin • PIL.ImtImagePlugin • PIL.IptcImagePlugin • PIL.Jpeg2KImagePlugin • PIL.JpegImagePlugin • PIL.McIdasImagePlugin • PIL.MpegImagePlugin • PIL.MpoImagePlugin • PIL.MspImagePlugin • PIL.PalmImagePlugin • PIL.PcdImagePlugin • PIL.PcxImagePlugin • PIL.PdfImagePlugin • PIL.PixarImagePlugin • PIL.PngImagePlugin • PIL.PpmImagePlugin • PIL.PsdImagePlugin • PIL.QoiImagePlugin • PIL.SgiImagePlugin • PIL.SpiderImagePlugin • PIL.SunImagePlugin • PIL.TgaImagePlugin • PIL.TiffImagePlugin • PIL.WebPImagePlugin • PIL.WmfImagePlugin • PIL.XVThumbImagePlugin • PIL.XbmImagePlugin • PIL.XpmImagePlugin

PIL.ImageFilter SourceModule

imports: PIL • PIL.Image • functools

imported by: PIL • PIL.Image

PIL.ImageMode SourceModule

imports: PIL • sys

imported by: PIL • PIL.Image

PIL.ImageOps SourceModule

imports: PIL • PIL.ExifTags • PIL.Image • PIL.ImageColor • PIL.ImagePalette • functools • operator • re

imported by: PIL • PIL.TiffImagePlugin

PIL.ImagePalette SourceModule

imports: PIL • PIL.GimpGradientFile • PIL.GimpPaletteFile • PIL.ImageColor • PIL.PaletteFile • array • random

imported by: PIL • PIL.BmpImagePlugin • PIL.DdsImagePlugin • PIL.FliImagePlugin • PIL.GifImagePlugin • PIL.ImImagePlugin • PIL.Image • PIL.ImageOps • PIL.PcxImagePlugin • PIL.PngImagePlugin • PIL.PsdImagePlugin • PIL.SunImagePlugin • PIL.TgaImagePlugin • PIL.TiffImagePlugin • PIL.XVThumbImagePlugin • PIL.XpmImagePlugin

PIL.ImageQt SourceModule

imports: PIL • PIL.Image • PIL._util • io • sys

imported by: PIL • PIL.Image

PIL.ImageSequence SourceModule

imports: PIL

imported by: PIL • PIL.GifImagePlugin • PIL.MpoImagePlugin • PIL.PdfImagePlugin • PIL.PngImagePlugin

PIL.ImageShow SourceModule

imports: PIL • PIL.Image • os • shlex • shutil • subprocess • sys

imported by: PIL • PIL.Image

PIL.ImageTk SourceModule

imports: PIL • PIL.Image • PIL._imagingtk • io

imported by: PIL • PIL.SpiderImagePlugin • matplotlib.backends._backend_tk

PIL.ImageWin SourceModule

imports: PIL • PIL.Image

imported by: PIL • PIL.ImageCms

PIL.ImtImagePlugin SourceModule

imports: PIL • PIL.Image • PIL.ImageFile • re

imported by: PIL.Image

PIL.IptcImagePlugin SourceModule

imports: PIL • PIL.Image • PIL.ImageFile • PIL.JpegImagePlugin • PIL.TiffImagePlugin • PIL._binary • io • os • tempfile

imported by: PIL.Image

PIL.Jpeg2KImagePlugin SourceModule

imports: PIL • PIL.Image • PIL.ImageFile • PIL._binary • io • os • struct

imported by: PIL • PIL.IcnsImagePlugin • PIL.Image

PIL.JpegImagePlugin SourceModule

imports: PIL • PIL.Image • PIL.ImageFile • PIL.JpegPresets • PIL.MpoImagePlugin • PIL.TiffImagePlugin • PIL._binary • array • io • math • os • struct • subprocess • sys • tempfile • warnings

imported by: PIL • PIL.BlpImagePlugin • PIL.Image • PIL.IptcImagePlugin • PIL.MpoImagePlugin

PIL.JpegPresets SourceModule

imports: PIL

imported by: PIL.JpegImagePlugin

PIL.McIdasImagePlugin SourceModule

imports: PIL • PIL.Image • PIL.ImageFile • struct

imported by: PIL.Image

PIL.MicImagePlugin SourceModule

imports: PIL • PIL.Image • PIL.TiffImagePlugin • olefile

imported by: PIL.Image

PIL.MpegImagePlugin SourceModule

imports: PIL • PIL.Image • PIL.ImageFile • PIL._binary

imported by: PIL.Image

PIL.MpoImagePlugin SourceModule

imports: PIL • PIL.ExifTags • PIL.Image • PIL.ImageFile • PIL.ImageSequence • PIL.JpegImagePlugin • PIL.TiffImagePlugin • PIL._binary • itertools • os • struct

imported by: PIL.Image • PIL.JpegImagePlugin

PIL.MspImagePlugin SourceModule

imports: PIL • PIL.Image • PIL.ImageFile • PIL._binary • io • struct

imported by: PIL.Image

PIL.PaletteFile SourceModule

imports: PIL • PIL._binary

imported by: PIL • PIL.ImagePalette

PIL.PalmImagePlugin SourceModule

imports: PIL • PIL.Image • PIL.ImageFile • PIL._binary

imported by: PIL.Image

PIL.PcdImagePlugin SourceModule

imports: PIL • PIL.Image • PIL.ImageFile

imported by: PIL.Image

PIL.PcxImagePlugin SourceModule

imports: PIL • PIL.Image • PIL.ImageFile • PIL.ImagePalette • PIL._binary • io • logging

imported by: PIL.DcxImagePlugin • PIL.Image

PIL.PdfImagePlugin SourceModule

imports: PIL • PIL.Image • PIL.ImageFile • PIL.ImageSequence • PIL.PdfParser • PIL.features • io • math • os • time

imported by: PIL.Image

PIL.PdfParser SourceModule

imports: PIL • calendar • codecs • collections • mmap • os • re • time • zlib

imported by: PIL • PIL.PdfImagePlugin

PIL.PixarImagePlugin SourceModule

imports: PIL • PIL.Image • PIL.ImageFile • PIL._binary

imported by: PIL.Image

PIL.PngImagePlugin SourceModule

imports: PIL • PIL.Image • PIL.ImageChops • PIL.ImageFile • PIL.ImagePalette • PIL.ImageSequence • PIL._binary • enum • itertools • logging • re • struct • warnings • zlib

imported by: PIL • PIL.IcnsImagePlugin • PIL.IcoImagePlugin • PIL.Image • matplotlib.colors • matplotlib.image

PIL.PpmImagePlugin SourceModule

imports: PIL • PIL.Image • PIL.ImageFile • PIL._binary

imported by: PIL • PIL.Image

PIL.PsdImagePlugin SourceModule

imports: PIL • PIL.Image • PIL.ImageFile • PIL.ImagePalette • PIL._binary • io

imported by: PIL.Image

PIL.PyAccess SourceModule

imports: PIL • PIL._deprecate • PIL._util • cffi • logging • sys

imported by: PIL • PIL.Image

PIL.QoiImagePlugin SourceModule

imports: PIL • PIL.Image • PIL.ImageFile • PIL._binary • os

imported by: PIL.Image

PIL.SgiImagePlugin SourceModule

imports: PIL • PIL.Image • PIL.ImageFile • PIL._binary • os • struct

imported by: PIL.Image

PIL.SpiderImagePlugin SourceModule

imports: PIL • PIL.Image • PIL.ImageFile • PIL.ImageTk • os • struct • sys

imported by: PIL.Image

PIL.SunImagePlugin SourceModule

imports: PIL • PIL.Image • PIL.ImageFile • PIL.ImagePalette • PIL._binary

imported by: PIL.Image

PIL.TgaImagePlugin SourceModule

imports: PIL • PIL.Image • PIL.ImageFile • PIL.ImagePalette • PIL._binary • warnings

imported by: PIL.Image

PIL.TiffImagePlugin SourceModule

imports: PIL • PIL.ExifTags • PIL.Image • PIL.ImageFile • PIL.ImageOps • PIL.ImagePalette • PIL.TiffTags • PIL._binary • collections.abc • fractions • io • itertools • logging • math • numbers • os • struct • warnings

imported by: PIL • PIL.Image • PIL.IptcImagePlugin • PIL.JpegImagePlugin • PIL.MicImagePlugin • PIL.MpoImagePlugin

PIL.TiffTags SourceModule

imports: PIL • collections

imported by: PIL • PIL.Image • PIL.TiffImagePlugin

PIL.WebPImagePlugin SourceModule

imports: PIL • PIL.Image • PIL.ImageFile • PIL._webp • io

imported by: PIL.Image

PIL.WmfImagePlugin SourceModule

imports: PIL • PIL.Image • PIL.ImageFile • PIL._binary

imported by: PIL.Image

PIL.XVThumbImagePlugin SourceModule

imports: PIL • PIL.Image • PIL.ImageFile • PIL.ImagePalette • PIL._binary

imported by: PIL.Image

PIL.XbmImagePlugin SourceModule

imports: PIL • PIL.Image • PIL.ImageFile • re

imported by: PIL.Image

PIL.XpmImagePlugin SourceModule

imports: PIL • PIL.Image • PIL.ImageFile • PIL.ImagePalette • PIL._binary • re

imported by: PIL.Image

PIL._binary SourceModule

imports: PIL • struct

imported by: PIL.BmpImagePlugin • PIL.CurImagePlugin • PIL.DcxImagePlugin • PIL.DdsImagePlugin • PIL.EpsImagePlugin • PIL.FliImagePlugin • PIL.FpxImagePlugin • PIL.GbrImagePlugin • PIL.GifImagePlugin • PIL.GimpGradientFile • PIL.GimpPaletteFile • PIL.IcoImagePlugin • PIL.Image • PIL.IptcImagePlugin • PIL.Jpeg2KImagePlugin • PIL.JpegImagePlugin • PIL.MpegImagePlugin • PIL.MpoImagePlugin • PIL.MspImagePlugin • PIL.PaletteFile • PIL.PalmImagePlugin • PIL.PcxImagePlugin • PIL.PixarImagePlugin • PIL.PngImagePlugin • PIL.PpmImagePlugin • PIL.PsdImagePlugin • PIL.QoiImagePlugin • PIL.SgiImagePlugin • PIL.SunImagePlugin • PIL.TgaImagePlugin • PIL.TiffImagePlugin • PIL.WmfImagePlugin • PIL.XVThumbImagePlugin • PIL.XpmImagePlugin

PIL._deprecate SourceModule

imports: PIL • __future__ • warnings

imported by: PIL.EpsImagePlugin • PIL.PyAccess

PIL._imaging C:\Users\Admin\myenv\Lib\site-packages\PIL\_imaging.cp311-win_amd64.pyd

imports: PIL

imported by: PIL • PIL.Image

PIL._imagingcms C:\Users\Admin\myenv\Lib\site-packages\PIL\_imagingcms.cp311-win_amd64.pyd

imports: PIL

imported by: PIL • PIL.ImageCms

PIL._imagingtk C:\Users\Admin\myenv\Lib\site-packages\PIL\_imagingtk.cp311-win_amd64.pyd

imports: PIL

imported by: PIL • PIL.ImageTk

PIL._util SourceModule

imports: PIL • os • pathlib

imported by: PIL.Image • PIL.ImageCms • PIL.ImageFile • PIL.ImageQt • PIL.PyAccess

PIL._version SourceModule

imports: PIL

imported by: PIL

PIL._webp C:\Users\Admin\myenv\Lib\site-packages\PIL\_webp.cp311-win_amd64.pyd

imports: PIL

imported by: PIL • PIL.WebPImagePlugin

PIL.features SourceModule

imports: PIL • PIL.Image • collections • os • sys • warnings

imported by: PIL • PIL.IcnsImagePlugin • PIL.PdfImagePlugin

StringIO MissingModule

imported by: six

__future__ SourceModule

imported by: PIL._deprecate • bleak • codeop • contourpy • contourpy.array • contourpy.chunk • contourpy.convert • contourpy.dechunk • contourpy.enum_util • contourpy.typecheck • contourpy.types • cycler • dateutil.parser._parser • doctest • matplotlib._mathtext • matplotlib._mathtext_data • matplotlib.pyplot • numpy._typing • numpy._typing._array_like • numpy._typing._nested_sequence • numpy.array_api._array_object • numpy.array_api._creation_functions • numpy.array_api._data_type_functions • numpy.array_api._elementwise_functions • numpy.array_api._indexing_functions • numpy.array_api._manipulation_functions • numpy.array_api._searching_functions • numpy.array_api._set_functions • numpy.array_api._sorting_functions • numpy.array_api._statistical_functions • numpy.array_api._typing • numpy.array_api._utility_functions • numpy.array_api.linalg • numpy.version • pydoc • six

_abc (builtin module)

imported by: abc

_aix_support SourceModule

imports: _bootsubprocess • subprocess • sys • sysconfig

imported by: sysconfig

_ast (builtin module)

imported by: ast

_asyncio C:\Python311\DLLs\_asyncio.pyd

imported by: asyncio.events • asyncio.futures • asyncio.tasks

_bisect (builtin module)

imported by: bisect

_blake2 (builtin module)

imported by: hashlib

_bootsubprocess SourceModule

imports: os

imported by: _aix_support

_bz2 C:\Python311\DLLs\_bz2.pyd

imported by: bz2

_codecs (builtin module)

imported by: codecs

_codecs_cn (builtin module)

imported by: encodings.gb18030 • encodings.gb2312 • encodings.gbk • encodings.hz

_codecs_hk (builtin module)

imported by: encodings.big5hkscs

_codecs_iso2022 (builtin module)

imported by: encodings.iso2022_jp • encodings.iso2022_jp_1 • encodings.iso2022_jp_2 • encodings.iso2022_jp_2004 • encodings.iso2022_jp_3 • encodings.iso2022_jp_ext • encodings.iso2022_kr

_codecs_jp (builtin module)

imported by: encodings.cp932 • encodings.euc_jis_2004 • encodings.euc_jisx0213 • encodings.euc_jp • encodings.shift_jis • encodings.shift_jis_2004 • encodings.shift_jisx0213

_codecs_kr (builtin module)

imported by: encodings.cp949 • encodings.euc_kr • encodings.johab

_codecs_tw (builtin module)

imported by: encodings.big5 • encodings.cp950

_collections (builtin module)

imported by: collections • threading

_collections_abc SourceModule

imports: abc • sys

imported by: collections • collections.abc • contextlib • esp_controller.py • locale • os • pathlib • random • types • weakref

_compat_pickle SourceModule

imported by: _pickle • pickle

_compression SourceModule

imports: io • sys

imported by: bz2 • gzip • lzma

_contextvars (builtin module)

imported by: contextvars

_csv (builtin module)

imported by: csv

_ctypes C:\Python311\DLLs\_ctypes.pyd

imported by: ctypes • numpy.core._dtype_ctypes

_datetime (builtin module)

imports: _strptime • time

imported by: datetime

_decimal C:\Python311\DLLs\_decimal.pyd

imported by: decimal

_dummy_thread MissingModule

imported by: numpy.core.arrayprint

_frozen_importlib ExcludedModule

imported by: importlib • importlib.abc • zipimport

_frozen_importlib_external MissingModule

imported by: importlib • importlib._bootstrap • importlib.abc • zipimport

_functools (builtin module)

imported by: functools

_hashlib C:\Python311\DLLs\_hashlib.pyd

imported by: hashlib • hmac

_heapq (builtin module)

imported by: heapq

_imp (builtin module)

imported by: imp • importlib • importlib._bootstrap_external • importlib.util • pkg_resources • sysconfig • zipimport

_io (builtin module)

imported by: importlib._bootstrap_external • io • zipimport

_json (builtin module)

imports: json.decoder

imported by: json.decoder • json.encoder • json.scanner

_locale (builtin module)

imported by: locale

_lzma C:\Python311\DLLs\_lzma.pyd

imported by: lzma

_manylinux MissingModule

imported by: packaging._manylinux • pkg_resources._vendor.packaging._manylinux

_md5 (builtin module)

imported by: hashlib

_multibytecodec (builtin module)

imported by: encodings.big5 • encodings.big5hkscs • encodings.cp932 • encodings.cp949 • encodings.cp950 • encodings.euc_jis_2004 • encodings.euc_jisx0213 • encodings.euc_jp • encodings.euc_kr • encodings.gb18030 • encodings.gb2312 • encodings.gbk • encodings.hz • encodings.iso2022_jp • encodings.iso2022_jp_1 • encodings.iso2022_jp_2 • encodings.iso2022_jp_2004 • encodings.iso2022_jp_3 • encodings.iso2022_jp_ext • encodings.iso2022_kr • encodings.johab • encodings.shift_jis • encodings.shift_jis_2004 • encodings.shift_jisx0213

_multiprocessing C:\Python311\DLLs\_multiprocessing.pyd

imported by: multiprocessing.connection • multiprocessing.queues • multiprocessing.resource_tracker • multiprocessing.synchronize

_opcode (builtin module)

imported by: opcode

_operator (builtin module)

imported by: hmac • operator

_overlapped C:\Python311\DLLs\_overlapped.pyd

imported by: asyncio.windows_events

_pickle (builtin module)

imports: _compat_pickle • codecs • copyreg

imported by: pickle

_posixshmem MissingModule

imported by: multiprocessing.resource_tracker • multiprocessing.shared_memory

_posixsubprocess MissingModule

imports: gc

imported by: multiprocessing.util • subprocess

_py_abc SourceModule

imports: _weakrefset

imported by: abc

_pydecimal SourceModule

imports: collections • contextvars • itertools • locale • math • numbers • re • sys

imported by: decimal

_pyi_rth_utils Package

imports: _pyi_rth_utils • _pyi_rth_utils._win32 • sys

imported by: _pyi_rth_utils • _pyi_rth_utils._win32 • _pyi_rth_utils.tempfile • pyi_rth_pkgutil.py

_pyi_rth_utils._win32 SourceModule

imports: _pyi_rth_utils • ctypes • ctypes.wintypes

imported by: _pyi_rth_utils • _pyi_rth_utils.tempfile

_pyi_rth_utils.tempfile SourceModule

imports: _pyi_rth_utils • _pyi_rth_utils._win32 • errno • os • sys • tempfile

imported by: pyi_rth_mplconfig.py

_queue C:\Python311\DLLs\_queue.pyd

imported by: queue

_random (builtin module)

imported by: random

_scproxy MissingModule

imported by: urllib.request

_sha1 (builtin module)

imported by: hashlib

_sha256 (builtin module)

imported by: hashlib

_sha3 (builtin module)

imported by: hashlib

_sha512 (builtin module)

imported by: hashlib • random

_signal (builtin module)

imported by: signal

_socket C:\Python311\DLLs\_socket.pyd

imported by: socket

_sre (builtin module)

imports: copy • re

imported by: re._compiler • re._constants

_ssl C:\Python311\DLLs\_ssl.pyd

imports: socket

imported by: ssl

_stat (builtin module)

imported by: stat

_statistics (builtin module)

imported by: statistics

_string (builtin module)

imported by: jinja2.sandbox • string

_strptime SourceModule

imports: _thread • calendar • datetime • locale • re • time

imported by: _datetime • datetime • time

_struct (builtin module)

imported by: struct

_thread (builtin module)

imported by: _strptime • _thread • asyncio.base_futures • dataclasses • functools • numpy.core.arrayprint • reprlib • tempfile • threading

_thread AliasNode

imports: _thread

imported by: dateutil.rrule • dateutil.tz._factories • dateutil.tz.tz • six.moves

_threading_local SourceModule

imports: contextlib • threading • weakref

imported by: threading

_tkinter C:\Python311\DLLs\_tkinter.pyd

imported by: tkinter

_tokenize (builtin module)

imported by: tokenize

_tracemalloc (builtin module)

imported by: tracemalloc

_typing (builtin module)

imported by: typing

_uuid C:\Python311\DLLs\_uuid.pyd

imported by: uuid

_warnings (builtin module)

imported by: importlib._bootstrap_external • warnings • zipimport

_weakref (builtin module)

imported by: _weakrefset • collections • weakref • xml.sax.expatreader

_weakrefset SourceModule

imports: _weakref • types

imported by: _py_abc • esp_controller.py • multiprocessing.process • threading • weakref

_winapi (builtin module)

imported by: asyncio.windows_events • asyncio.windows_utils • encodings • mimetypes • multiprocessing.connection • multiprocessing.heap • multiprocessing.popen_spawn_win32 • multiprocessing.reduction • multiprocessing.shared_memory • multiprocessing.spawn • ntpath • subprocess

_winreg MissingModule

imported by: pkg_resources._vendor.appdirs • platform

abc SourceModule

imports: _abc • _py_abc

imported by: _collections_abc • bleak.backends.characteristic • bleak.backends.client • bleak.backends.descriptor • bleak.backends.scanner • bleak.backends.service • contextlib • dataclasses • email._policybase • esp_controller.py • functools • importlib._abc • importlib.abc • importlib.metadata • importlib.resources.abc • inspect • io • matplotlib._mathtext • multiprocessing.reduction • numbers • numpy.polynomial._polybase • os • packaging.specifiers • pkg_resources._vendor.importlib_resources._compat • pkg_resources._vendor.importlib_resources.abc • pkg_resources._vendor.importlib_resources.simple • pkg_resources._vendor.packaging.specifiers • pkg_resources._vendor.pyparsing.core • pyparsing.core • selectors • typing • typing_extensions

android MissingModule

imported by: bleak.backends.p4android.client

argparse SourceModule

imports: copy • gettext • os • re • shutil • sys • textwrap • warnings

imported by: ast • bleak • calendar • code • dis • doctest • gzip • http.server • inspect • matplotlib.dviread • py_compile • tarfile • tokenize • unittest.main • zipfile

array (builtin module)

imported by: PIL.ImagePalette • PIL.JpegImagePlugin • multiprocessing.dummy • multiprocessing.managers • multiprocessing.reduction • pkg_resources._vendor.appdirs • socket

ast SourceModule

imports: _ast • argparse • collections • contextlib • enum • inspect • sys • warnings

imported by: inspect • jinja2.lexer • matplotlib.rcsetup • numpy.core._internal • numpy.lib.utils • numpy.matrixlib.defmatrix • packaging._parser • traceback

async_timeout MissingModule

imported by: bleak • bleak.backends.bluezdbus.client • bleak.backends.corebluetooth.CentralManagerDelegate • bleak.backends.corebluetooth.PeripheralDelegate • bleak.backends.p4android.scanner • bleak.backends.winrt.client

asyncio Package

imports: asyncio • asyncio.DefaultEventLoopPolicy • asyncio.base_events • asyncio.base_futures • asyncio.base_subprocess • asyncio.base_tasks • asyncio.constants • asyncio.coroutines • asyncio.events • asyncio.exceptions • asyncio.format_helpers • asyncio.futures • asyncio.locks • asyncio.mixins • asyncio.proactor_events • asyncio.protocols • asyncio.queues • asyncio.runners • asyncio.selector_events • asyncio.sslproto • asyncio.staggered • asyncio.streams • asyncio.subprocess • asyncio.taskgroups • asyncio.tasks • asyncio.threads • asyncio.timeouts • asyncio.transports • asyncio.trsock • asyncio.unix_events • asyncio.windows_events • asyncio.windows_utils • sys

imported by: asyncio • asyncio.base_events • asyncio.base_futures • asyncio.base_subprocess • asyncio.base_tasks • asyncio.constants • asyncio.coroutines • asyncio.events • asyncio.exceptions • asyncio.format_helpers • asyncio.futures • asyncio.locks • asyncio.log • asyncio.mixins • asyncio.proactor_events • asyncio.protocols • asyncio.queues • asyncio.runners • asyncio.selector_events • asyncio.sslproto • asyncio.staggered • asyncio.streams • asyncio.subprocess • asyncio.taskgroups • asyncio.tasks • asyncio.threads • asyncio.timeouts • asyncio.transports • asyncio.trsock • asyncio.unix_events • asyncio.windows_events • asyncio.windows_utils • bleak • bleak.backends.bluezdbus.client • bleak.backends.bluezdbus.manager • bleak.backends.bluezdbus.version • bleak.backends.client • bleak.backends.corebluetooth.CentralManagerDelegate • bleak.backends.corebluetooth.PeripheralDelegate • bleak.backends.corebluetooth.client • bleak.backends.p4android.client • bleak.backends.p4android.scanner • bleak.backends.p4android.utils • bleak.backends.scanner • bleak.backends.winrt.client • bleak.backends.winrt.scanner • esp_controller.py • jinja2.environment • matplotlib.backends.backend_webagg • matplotlib.backends.backend_webagg_core • unittest.async_case

asyncio.DefaultEventLoopPolicy MissingModule

imported by: asyncio • asyncio.events

asyncio.base_events SourceModule

imports: asyncio • asyncio.constants • asyncio.coroutines • asyncio.events • asyncio.exceptions • asyncio.futures • asyncio.log • asyncio.protocols • asyncio.sslproto • asyncio.staggered • asyncio.tasks • asyncio.transports • asyncio.trsock • collections • collections.abc • concurrent.futures • functools • heapq • itertools • os • socket • ssl • stat • subprocess • sys • threading • time • traceback • warnings • weakref

imported by: asyncio • asyncio.proactor_events • asyncio.selector_events • asyncio.unix_events

asyncio.base_futures SourceModule

imports: _thread • asyncio • asyncio.format_helpers • reprlib

imported by: asyncio • asyncio.base_tasks • asyncio.futures

asyncio.base_subprocess SourceModule

imports: asyncio • asyncio.log • asyncio.protocols • asyncio.transports • collections • subprocess • warnings

imported by: asyncio • asyncio.unix_events • asyncio.windows_events

asyncio.base_tasks SourceModule

imports: asyncio • asyncio.base_futures • asyncio.coroutines • linecache • reprlib • traceback

imported by: asyncio • asyncio.tasks

asyncio.constants SourceModule

imports: asyncio • enum

imported by: asyncio • asyncio.base_events • asyncio.format_helpers • asyncio.proactor_events • asyncio.selector_events • asyncio.sslproto • asyncio.unix_events

asyncio.coroutines SourceModule

imports: asyncio • collections.abc • inspect • os • sys • traceback • types

imported by: asyncio • asyncio.base_events • asyncio.base_tasks • asyncio.runners • asyncio.streams • asyncio.tasks • asyncio.unix_events

asyncio.events SourceModule

imports: _asyncio • asyncio • asyncio.DefaultEventLoopPolicy • asyncio.format_helpers • contextvars • os • socket • subprocess • sys • threading • warnings

imported by: asyncio • asyncio.base_events • asyncio.futures • asyncio.mixins • asyncio.runners • asyncio.selector_events • asyncio.staggered • asyncio.streams • asyncio.subprocess • asyncio.taskgroups • asyncio.tasks • asyncio.threads • asyncio.timeouts • asyncio.unix_events • asyncio.windows_events

asyncio.exceptions SourceModule

imports: asyncio

imported by: asyncio • asyncio.base_events • asyncio.futures • asyncio.locks • asyncio.proactor_events • asyncio.runners • asyncio.sslproto • asyncio.staggered • asyncio.streams • asyncio.taskgroups • asyncio.tasks • asyncio.timeouts • asyncio.unix_events • asyncio.windows_events

asyncio.format_helpers SourceModule

imports: asyncio • asyncio.constants • functools • inspect • reprlib • sys • traceback

imported by: asyncio • asyncio.base_futures • asyncio.events • asyncio.futures • asyncio.streams

asyncio.futures SourceModule

imports: _asyncio • asyncio • asyncio.base_futures • asyncio.events • asyncio.exceptions • asyncio.format_helpers • concurrent.futures • contextvars • logging • sys • types

imported by: asyncio • asyncio.base_events • asyncio.proactor_events • asyncio.selector_events • asyncio.tasks • asyncio.unix_events • asyncio.windows_events

asyncio.locks SourceModule

imports: asyncio • asyncio.exceptions • asyncio.mixins • asyncio.tasks • collections • enum

imported by: asyncio • asyncio.queues • asyncio.staggered

asyncio.log SourceModule

imports: asyncio • logging

imported by: asyncio.base_events • asyncio.base_subprocess • asyncio.proactor_events • asyncio.selector_events • asyncio.sslproto • asyncio.streams • asyncio.subprocess • asyncio.unix_events • asyncio.windows_events

asyncio.mixins SourceModule

imports: asyncio • asyncio.events • threading

imported by: asyncio • asyncio.locks • asyncio.queues

asyncio.proactor_events SourceModule

imports: asyncio • asyncio.base_events • asyncio.constants • asyncio.exceptions • asyncio.futures • asyncio.log • asyncio.protocols • asyncio.sslproto • asyncio.transports • asyncio.trsock • collections • io • os • signal • socket • threading • warnings

imported by: asyncio • asyncio.windows_events

asyncio.protocols SourceModule

imports: asyncio

imported by: asyncio • asyncio.base_events • asyncio.base_subprocess • asyncio.proactor_events • asyncio.selector_events • asyncio.sslproto • asyncio.streams • asyncio.subprocess

asyncio.queues SourceModule

imports: asyncio • asyncio.locks • asyncio.mixins • collections • heapq • types

imported by: asyncio • asyncio.tasks

asyncio.runners SourceModule

imports: asyncio • asyncio.coroutines • asyncio.events • asyncio.exceptions • asyncio.tasks • contextvars • enum • functools • signal • sys • threading

imported by: asyncio

asyncio.selector_events SourceModule

imports: asyncio • asyncio.base_events • asyncio.constants • asyncio.events • asyncio.futures • asyncio.log • asyncio.protocols • asyncio.sslproto • asyncio.transports • asyncio.trsock • collections • errno • functools • selectors • socket • ssl • warnings • weakref

imported by: asyncio • asyncio.unix_events • asyncio.windows_events

asyncio.sslproto SourceModule

imports: asyncio • asyncio.constants • asyncio.exceptions • asyncio.log • asyncio.protocols • asyncio.transports • collections • enum • ssl • warnings

imported by: asyncio • asyncio.base_events • asyncio.proactor_events • asyncio.selector_events

asyncio.staggered SourceModule

imports: asyncio • asyncio.events • asyncio.exceptions • asyncio.locks • asyncio.tasks • contextlib • typing

imported by: asyncio • asyncio.base_events

asyncio.streams SourceModule

imports: asyncio • asyncio.coroutines • asyncio.events • asyncio.exceptions • asyncio.format_helpers • asyncio.log • asyncio.protocols • asyncio.tasks • collections • socket • sys • warnings • weakref

imported by: asyncio • asyncio.subprocess

asyncio.subprocess SourceModule

imports: asyncio • asyncio.events • asyncio.log • asyncio.protocols • asyncio.streams • asyncio.tasks • subprocess

imported by: asyncio

asyncio.taskgroups SourceModule

imports: asyncio • asyncio.events • asyncio.exceptions • asyncio.tasks

imported by: asyncio

asyncio.tasks SourceModule

imports: _asyncio • asyncio • asyncio.base_tasks • asyncio.coroutines • asyncio.events • asyncio.exceptions • asyncio.futures • asyncio.queues • concurrent.futures • contextvars • functools • inspect • itertools • types • warnings • weakref

imported by: asyncio • asyncio.base_events • asyncio.locks • asyncio.runners • asyncio.staggered • asyncio.streams • asyncio.subprocess • asyncio.taskgroups • asyncio.timeouts • asyncio.unix_events • asyncio.windows_events

asyncio.threads SourceModule

imports: asyncio • asyncio.events • contextvars • functools

imported by: asyncio

asyncio.timeouts SourceModule

imports: asyncio • asyncio.events • asyncio.exceptions • asyncio.tasks • enum • types • typing

imported by: asyncio

asyncio.transports SourceModule

imports: asyncio

imported by: asyncio • asyncio.base_events • asyncio.base_subprocess • asyncio.proactor_events • asyncio.selector_events • asyncio.sslproto • asyncio.unix_events

asyncio.trsock SourceModule

imports: asyncio • socket

imported by: asyncio • asyncio.base_events • asyncio.proactor_events • asyncio.selector_events

asyncio.unix_events SourceModule

imports: asyncio • asyncio.base_events • asyncio.base_subprocess • asyncio.constants • asyncio.coroutines • asyncio.events • asyncio.exceptions • asyncio.futures • asyncio.log • asyncio.selector_events • asyncio.tasks • asyncio.transports • errno • io • itertools • os • selectors • signal • socket • stat • subprocess • sys • threading • warnings

imported by: asyncio

asyncio.windows_events SourceModule

imports: _overlapped • _winapi • asyncio • asyncio.base_subprocess • asyncio.events • asyncio.exceptions • asyncio.futures • asyncio.log • asyncio.proactor_events • asyncio.selector_events • asyncio.tasks • asyncio.windows_utils • errno • math • msvcrt • socket • struct • sys • time • weakref

imported by: asyncio

asyncio.windows_utils SourceModule

imports: _winapi • asyncio • itertools • msvcrt • os • subprocess • sys • tempfile • warnings

imported by: asyncio • asyncio.windows_events

atexit (builtin module)

imported by: PIL.Image • logging • matplotlib • matplotlib._pylab_helpers • multiprocessing.util • pyi_rth_mplconfig.py • weakref

base64 SourceModule

imports: binascii • getopt • re • struct • sys

imported by: email._encoded_words • email.base64mime • email.encoders • encodings.base64_codec • http.server • matplotlib.colors • matplotlib.font_manager • secrets • ssl • urllib.request • xmlrpc.client

bdb SourceModule

imports: fnmatch • inspect • linecache • os • reprlib • sys

imported by: pdb

binascii (builtin module)

imported by: base64 • email._encoded_words • email.base64mime • email.contentmanager • email.header • email.message • encodings.hex_codec • encodings.uu_codec • http.server • plistlib • quopri • secrets • zipfile

bisect SourceModule

imports: _bisect

imported by: dateutil.tz.tz • multiprocessing.heap • random • statistics • urllib.request

bleak Package

imports: __future__ • argparse • async_timeout • asyncio • bleak • bleak.backends.bluezdbus.scanner • bleak.backends.characteristic • bleak.backends.client • bleak.backends.corebluetooth.scanner • bleak.backends.device • bleak.backends.scanner • bleak.backends.service • bleak.backends.winrt.client • bleak.exc • bleak.uuids • collections.abc • functools • inspect • logging • os • sys • typing • typing_extensions • uuid • warnings

imported by: bleak • bleak.assigned_numbers • bleak.backends • bleak.backends.bluezdbus.client • bleak.backends.corebluetooth.client • bleak.backends.winrt.client • bleak.exc • bleak.uuids • esp_controller.py

bleak.assigned_numbers SourceModule

imports: bleak • enum

imported by: bleak.backends.bluezdbus.advertisement_monitor • bleak.backends.winrt.scanner

bleak.backends Package

imports: bleak

imported by: bleak.backends.bluezdbus • bleak.backends.characteristic • bleak.backends.client • bleak.backends.corebluetooth • bleak.backends.descriptor • bleak.backends.device • bleak.backends.p4android • bleak.backends.scanner • bleak.backends.service • bleak.backends.winrt

bleak.backends.bluezdbus Package

imports: bleak.backends • bleak.backends.bluezdbus • bleak.backends.bluezdbus.defs

imported by: bleak.backends.bluezdbus • bleak.backends.bluezdbus.advertisement_monitor • bleak.backends.bluezdbus.characteristic • bleak.backends.bluezdbus.client • bleak.backends.bluezdbus.defs • bleak.backends.bluezdbus.descriptor • bleak.backends.bluezdbus.manager • bleak.backends.bluezdbus.scanner • bleak.backends.bluezdbus.service • bleak.backends.bluezdbus.signals • bleak.backends.bluezdbus.utils • bleak.backends.bluezdbus.version

bleak.backends.bluezdbus.advertisement_monitor SourceModule

imports: 'dbus_fast.service' • bleak.assigned_numbers • bleak.backends.bluezdbus • bleak.backends.bluezdbus.defs • logging • typing

imported by: bleak.backends.bluezdbus.manager • bleak.backends.bluezdbus.scanner

bleak.backends.bluezdbus.characteristic SourceModule

imports: bleak.backends.bluezdbus • bleak.backends.bluezdbus.defs • bleak.backends.bluezdbus.utils • bleak.backends.characteristic • bleak.backends.descriptor • typing • uuid

imported by: bleak.backends.bluezdbus.client • bleak.backends.bluezdbus.manager • bleak.backends.bluezdbus.service

bleak.backends.bluezdbus.client SourceModule

imports: 'dbus_fast.constants' • 'dbus_fast.message' • 'dbus_fast.signature' • async_timeout • asyncio • bleak • bleak.backends.bluezdbus • bleak.backends.bluezdbus.characteristic • bleak.backends.bluezdbus.defs • bleak.backends.bluezdbus.manager • bleak.backends.bluezdbus.scanner • bleak.backends.bluezdbus.utils • bleak.backends.bluezdbus.version • bleak.backends.characteristic • bleak.backends.client • bleak.backends.device • bleak.backends.service • bleak.exc • collections.abc • dbus_fast • logging • os • sys • typing • typing_extensions • uuid • warnings

imported by: bleak.backends.client

bleak.backends.bluezdbus.defs SourceModule

imports: bleak.backends.bluezdbus • typing

imported by: bleak.backends.bluezdbus • bleak.backends.bluezdbus.advertisement_monitor • bleak.backends.bluezdbus.characteristic • bleak.backends.bluezdbus.client • bleak.backends.bluezdbus.descriptor • bleak.backends.bluezdbus.manager • bleak.backends.bluezdbus.scanner

bleak.backends.bluezdbus.descriptor SourceModule

imports: bleak.backends.bluezdbus • bleak.backends.bluezdbus.defs • bleak.backends.descriptor

imported by: bleak.backends.bluezdbus.manager

bleak.backends.bluezdbus.manager SourceModule

imports: 'dbus_fast.aio' • asyncio • bleak.backends.bluezdbus • bleak.backends.bluezdbus.advertisement_monitor • bleak.backends.bluezdbus.characteristic • bleak.backends.bluezdbus.defs • bleak.backends.bluezdbus.descriptor • bleak.backends.bluezdbus.service • bleak.backends.bluezdbus.signals • bleak.backends.bluezdbus.utils • bleak.backends.service • bleak.exc • contextlib • dbus_fast • logging • os • typing • weakref

imported by: bleak.backends.bluezdbus.client • bleak.backends.bluezdbus.scanner

bleak.backends.bluezdbus.scanner SourceModule

imports: bleak.backends.bluezdbus • bleak.backends.bluezdbus.advertisement_monitor • bleak.backends.bluezdbus.defs • bleak.backends.bluezdbus.manager • bleak.backends.bluezdbus.utils • bleak.backends.scanner • bleak.exc • dbus_fast • logging • typing • warnings

imported by: bleak • bleak.backends.bluezdbus.client • bleak.backends.scanner

bleak.backends.bluezdbus.service SourceModule

imports: bleak.backends.bluezdbus • bleak.backends.bluezdbus.characteristic • bleak.backends.bluezdbus.utils • bleak.backends.service • typing

imported by: bleak.backends.bluezdbus.manager

bleak.backends.bluezdbus.signals SourceModule

imports: 'dbus_fast.aio' • 'dbus_fast.errors' • 'dbus_fast.message' • 'dbus_fast.validators' • bleak.backends.bluezdbus • re • typing

imported by: bleak.backends.bluezdbus.manager

bleak.backends.bluezdbus.utils SourceModule

imports: 'dbus_fast.auth' • 'dbus_fast.constants' • 'dbus_fast.message' • bleak.backends.bluezdbus • bleak.exc • os • re

imported by: bleak.backends.bluezdbus.characteristic • bleak.backends.bluezdbus.client • bleak.backends.bluezdbus.manager • bleak.backends.bluezdbus.scanner • bleak.backends.bluezdbus.service

bleak.backends.bluezdbus.version SourceModule

imports: asyncio • bleak.backends.bluezdbus • contextlib • logging • re • typing

imported by: bleak.backends.bluezdbus.client

bleak.backends.characteristic SourceModule

imports: abc • bleak.backends • bleak.backends.descriptor • bleak.uuids • enum • typing • uuid

imported by: bleak • bleak.backends.bluezdbus.characteristic • bleak.backends.bluezdbus.client • bleak.backends.client • bleak.backends.corebluetooth.characteristic • bleak.backends.corebluetooth.client • bleak.backends.p4android.characteristic • bleak.backends.p4android.client • bleak.backends.service • bleak.backends.winrt.characteristic • bleak.backends.winrt.client

bleak.backends.client SourceModule

imports: abc • asyncio • bleak.backends • bleak.backends.bluezdbus.client • bleak.backends.characteristic • bleak.backends.corebluetooth.client • bleak.backends.device • bleak.backends.p4android.client • bleak.backends.service • bleak.backends.winrt.client • bleak.exc • collections.abc • os • platform • sys • typing • typing_extensions • uuid • warnings

imported by: bleak • bleak.backends.bluezdbus.client • bleak.backends.corebluetooth.PeripheralDelegate • bleak.backends.corebluetooth.client • bleak.backends.p4android.client • bleak.backends.winrt.client

bleak.backends.corebluetooth Package

imports: bleak.backends • objc

imported by: bleak.backends.corebluetooth.CentralManagerDelegate • bleak.backends.corebluetooth.PeripheralDelegate • bleak.backends.corebluetooth.characteristic • bleak.backends.corebluetooth.client • bleak.backends.corebluetooth.descriptor • bleak.backends.corebluetooth.scanner • bleak.backends.corebluetooth.service • bleak.backends.corebluetooth.utils

bleak.backends.corebluetooth.CentralManagerDelegate SourceModule

imports: CoreBluetooth • Foundation • async_timeout • asyncio • bleak.backends.corebluetooth • bleak.exc • libdispatch • logging • objc • sys • threading • typing

imported by: bleak.backends.corebluetooth.client • bleak.backends.corebluetooth.scanner

bleak.backends.corebluetooth.PeripheralDelegate SourceModule

imports: CoreBluetooth • Foundation • async_timeout • asyncio • bleak.backends.client • bleak.backends.corebluetooth • bleak.exc • itertools • logging • objc • sys • typing

imported by: bleak.backends.corebluetooth.client

bleak.backends.corebluetooth.characteristic SourceModule

imports: CoreBluetooth • bleak.backends.characteristic • bleak.backends.corebluetooth • bleak.backends.corebluetooth.descriptor • bleak.backends.corebluetooth.utils • bleak.backends.descriptor • enum • typing

imported by: bleak.backends.corebluetooth.client • bleak.backends.corebluetooth.service

bleak.backends.corebluetooth.client SourceModule

imports: CoreBluetooth • Foundation • asyncio • bleak • bleak.backends.characteristic • bleak.backends.client • bleak.backends.corebluetooth • bleak.backends.corebluetooth.CentralManagerDelegate • bleak.backends.corebluetooth.PeripheralDelegate • bleak.backends.corebluetooth.characteristic • bleak.backends.corebluetooth.descriptor • bleak.backends.corebluetooth.scanner • bleak.backends.corebluetooth.service • bleak.backends.corebluetooth.utils • bleak.backends.device • bleak.backends.service • bleak.exc • collections.abc • logging • sys • typing • typing_extensions • uuid

imported by: bleak.backends.client

bleak.backends.corebluetooth.descriptor SourceModule

imports: CoreBluetooth • bleak.backends.corebluetooth • bleak.backends.corebluetooth.utils • bleak.backends.descriptor

imported by: bleak.backends.corebluetooth.characteristic • bleak.backends.corebluetooth.client

bleak.backends.corebluetooth.scanner SourceModule

imports: CoreBluetooth • Foundation • bleak.backends.corebluetooth • bleak.backends.corebluetooth.CentralManagerDelegate • bleak.backends.corebluetooth.utils • bleak.backends.scanner • bleak.exc • logging • objc • typing

imported by: bleak • bleak.backends.corebluetooth.client • bleak.backends.scanner

bleak.backends.corebluetooth.service SourceModule

imports: CoreBluetooth • bleak.backends.corebluetooth • bleak.backends.corebluetooth.characteristic • bleak.backends.corebluetooth.utils • bleak.backends.service • typing

imported by: bleak.backends.corebluetooth.client

bleak.backends.corebluetooth.utils SourceModule

imports: CoreBluetooth • Foundation • bleak.backends.corebluetooth • bleak.uuids

imported by: bleak.backends.corebluetooth.characteristic • bleak.backends.corebluetooth.client • bleak.backends.corebluetooth.descriptor • bleak.backends.corebluetooth.scanner • bleak.backends.corebluetooth.service

bleak.backends.descriptor SourceModule

imports: abc • bleak.backends • bleak.uuids • typing

imported by: bleak.backends.bluezdbus.characteristic • bleak.backends.bluezdbus.descriptor • bleak.backends.characteristic • bleak.backends.corebluetooth.characteristic • bleak.backends.corebluetooth.descriptor • bleak.backends.p4android.characteristic • bleak.backends.p4android.descriptor • bleak.backends.service • bleak.backends.winrt.characteristic • bleak.backends.winrt.descriptor

bleak.backends.device SourceModule

imports: bleak.backends • typing • warnings

imported by: bleak • bleak.backends.bluezdbus.client • bleak.backends.client • bleak.backends.corebluetooth.client • bleak.backends.p4android.client • bleak.backends.scanner • bleak.backends.winrt.client

bleak.backends.p4android Package

imports: bleak.backends • bleak.backends.p4android • bleak.backends.p4android.defs • bleak.backends.p4android.utils

imported by: bleak.backends.p4android • bleak.backends.p4android.characteristic • bleak.backends.p4android.client • bleak.backends.p4android.defs • bleak.backends.p4android.descriptor • bleak.backends.p4android.scanner • bleak.backends.p4android.service • bleak.backends.p4android.utils

bleak.backends.p4android.characteristic SourceModule

imports: bleak.backends.characteristic • bleak.backends.descriptor • bleak.backends.p4android • bleak.backends.p4android.defs • bleak.exc • typing • uuid

imported by: bleak.backends.p4android.client • bleak.backends.p4android.service

bleak.backends.p4android.client SourceModule

imports: android • asyncio • bleak.backends.characteristic • bleak.backends.client • bleak.backends.device • bleak.backends.p4android • bleak.backends.p4android.characteristic • bleak.backends.p4android.defs • bleak.backends.p4android.descriptor • bleak.backends.p4android.service • bleak.backends.p4android.utils • bleak.backends.service • bleak.exc • jnius • logging • typing • uuid • warnings

imported by: bleak.backends.client

bleak.backends.p4android.defs SourceModule

imports: bleak.backends.p4android • bleak.exc • enum • jnius

imported by: bleak.backends.p4android • bleak.backends.p4android.characteristic • bleak.backends.p4android.client • bleak.backends.p4android.scanner

bleak.backends.p4android.descriptor SourceModule

imports: bleak.backends.descriptor • bleak.backends.p4android

imported by: bleak.backends.p4android.client

bleak.backends.p4android.scanner SourceModule

imports: 'android.broadcast' • 'android.permissions' • async_timeout • asyncio • bleak.backends.p4android • bleak.backends.p4android.defs • bleak.backends.p4android.utils • bleak.backends.scanner • bleak.exc • jnius • logging • sys • typing • warnings

imported by: bleak.backends.scanner

bleak.backends.p4android.service SourceModule

imports: bleak.backends.p4android • bleak.backends.p4android.characteristic • bleak.backends.service • typing

imported by: bleak.backends.p4android.client

bleak.backends.p4android.utils SourceModule

imports: asyncio • bleak.backends.p4android • bleak.exc • jnius • logging • warnings

imported by: bleak.backends.p4android • bleak.backends.p4android.client • bleak.backends.p4android.scanner

bleak.backends.scanner SourceModule

imports: abc • asyncio • bleak.backends • bleak.backends.bluezdbus.scanner • bleak.backends.corebluetooth.scanner • bleak.backends.device • bleak.backends.p4android.scanner • bleak.backends.winrt.scanner • bleak.exc • inspect • os • platform • typing

imported by: bleak • bleak.backends.bluezdbus.scanner • bleak.backends.corebluetooth.scanner • bleak.backends.p4android.scanner • bleak.backends.winrt.scanner

bleak.backends.service SourceModule

imports: abc • bleak.backends • bleak.backends.characteristic • bleak.backends.descriptor • bleak.exc • bleak.uuids • logging • typing • uuid

imported by: bleak • bleak.backends.bluezdbus.client • bleak.backends.bluezdbus.manager • bleak.backends.bluezdbus.service • bleak.backends.client • bleak.backends.corebluetooth.client • bleak.backends.corebluetooth.service • bleak.backends.p4android.client • bleak.backends.p4android.service • bleak.backends.winrt.client • bleak.backends.winrt.service

bleak.backends.winrt Package

imports: bleak.backends

imported by: bleak.backends.winrt.characteristic • bleak.backends.winrt.client • bleak.backends.winrt.descriptor • bleak.backends.winrt.scanner • bleak.backends.winrt.service

bleak.backends.winrt.characteristic SourceModule

imports: 'winrt.windows' • bleak.backends.characteristic • bleak.backends.descriptor • bleak.backends.winrt • bleak_winrt.windows.devices.bluetooth.genericattributeprofile • sys • typing • uuid

imported by: bleak.backends.winrt.client • bleak.backends.winrt.service

bleak.backends.winrt.client SourceModule

imports: 'winrt.windows' • async_timeout • asyncio • bleak • bleak.backends.characteristic • bleak.backends.client • bleak.backends.device • bleak.backends.service • bleak.backends.winrt • bleak.backends.winrt.characteristic • bleak.backends.winrt.descriptor • bleak.backends.winrt.scanner • bleak.backends.winrt.service • bleak.exc • bleak_winrt.windows.devices.bluetooth • bleak_winrt.windows.devices.bluetooth.genericattributeprofile • bleak_winrt.windows.devices.enumeration • bleak_winrt.windows.foundation • bleak_winrt.windows.storage.streams • collections.abc • ctypes • logging • sys • typing • typing_extensions • uuid • warnings

imported by: bleak • bleak.backends.client

bleak.backends.winrt.descriptor SourceModule

imports: 'winrt.windows' • bleak.backends.descriptor • bleak.backends.winrt • bleak_winrt.windows.devices.bluetooth.genericattributeprofile • sys

imported by: bleak.backends.winrt.client

bleak.backends.winrt.scanner SourceModule

imports: asyncio • bleak.assigned_numbers • bleak.backends.scanner • bleak.backends.winrt • bleak.uuids • bleak_winrt.windows.devices.bluetooth.advertisement • logging • sys • typing • uuid • winrt

imported by: bleak.backends.scanner • bleak.backends.winrt.client

bleak.backends.winrt.service SourceModule

imports: 'winrt.windows' • bleak.backends.service • bleak.backends.winrt • bleak.backends.winrt.characteristic • bleak_winrt.windows.devices.bluetooth.genericattributeprofile • sys • typing

imported by: bleak.backends.winrt.client

bleak.exc SourceModule

imports: bleak • typing

imported by: bleak • bleak.backends.bluezdbus.client • bleak.backends.bluezdbus.manager • bleak.backends.bluezdbus.scanner • bleak.backends.bluezdbus.utils • bleak.backends.client • bleak.backends.corebluetooth.CentralManagerDelegate • bleak.backends.corebluetooth.PeripheralDelegate • bleak.backends.corebluetooth.client • bleak.backends.corebluetooth.scanner • bleak.backends.p4android.characteristic • bleak.backends.p4android.client • bleak.backends.p4android.defs • bleak.backends.p4android.scanner • bleak.backends.p4android.utils • bleak.backends.scanner • bleak.backends.service • bleak.backends.winrt.client

bleak.uuids SourceModule

imports: bleak • typing • uuid

imported by: bleak • bleak.backends.characteristic • bleak.backends.corebluetooth.utils • bleak.backends.descriptor • bleak.backends.service • bleak.backends.winrt.scanner

bleak_winrt Package

imports: bleak_winrt • bleak_winrt._winrt • importlib.machinery • importlib.util • types

imported by: bleak_winrt • bleak_winrt._winrt • bleak_winrt.windows • bleak_winrt.windows.devices.bluetooth • bleak_winrt.windows.devices.bluetooth.advertisement • bleak_winrt.windows.devices.bluetooth.genericattributeprofile • bleak_winrt.windows.devices.enumeration • bleak_winrt.windows.foundation • bleak_winrt.windows.foundation.collections • bleak_winrt.windows.storage.streams

bleak_winrt._winrt C:\Users\Admin\myenv\Lib\site-packages\bleak_winrt\_winrt.pyd

imports: bleak_winrt

imported by: bleak_winrt

bleak_winrt.windows NamespacePackage

imports: bleak_winrt

imported by: bleak_winrt.windows.devices • bleak_winrt.windows.foundation • bleak_winrt.windows.storage

bleak_winrt.windows.devices NamespacePackage

imports: bleak_winrt.windows

imported by: bleak_winrt.windows.devices.bluetooth • bleak_winrt.windows.devices.enumeration

bleak_winrt.windows.devices.bluetooth Package

imports: 'bleak_winrt.windows.devices.bluetooth.rfcomm' • 'bleak_winrt.windows.devices.radios' • 'bleak_winrt.windows.networking' • bleak_winrt • bleak_winrt.windows.devices • bleak_winrt.windows.devices.bluetooth.genericattributeprofile • bleak_winrt.windows.devices.enumeration • bleak_winrt.windows.foundation • bleak_winrt.windows.foundation.collections • bleak_winrt.windows.storage.streams • enum

imported by: bleak.backends.winrt.client • bleak_winrt.windows.devices.bluetooth.advertisement • bleak_winrt.windows.devices.bluetooth.genericattributeprofile

bleak_winrt.windows.devices.bluetooth.advertisement Package

imports: bleak_winrt • bleak_winrt.windows.devices.bluetooth • bleak_winrt.windows.foundation • bleak_winrt.windows.foundation.collections • bleak_winrt.windows.storage.streams • enum

imported by: bleak.backends.winrt.scanner

bleak_winrt.windows.devices.bluetooth.genericattributeprofile Package

imports: bleak_winrt • bleak_winrt.windows.devices.bluetooth • bleak_winrt.windows.devices.enumeration • bleak_winrt.windows.foundation • bleak_winrt.windows.foundation.collections • bleak_winrt.windows.storage.streams • enum

imported by: bleak.backends.winrt.characteristic • bleak.backends.winrt.client • bleak.backends.winrt.descriptor • bleak.backends.winrt.service • bleak_winrt.windows.devices.bluetooth

bleak_winrt.windows.devices.enumeration Package

imports: 'bleak_winrt.windows.applicationmodel' • 'bleak_winrt.windows.security' • 'bleak_winrt.windows.ui' • bleak_winrt • bleak_winrt.windows.devices • bleak_winrt.windows.foundation • bleak_winrt.windows.foundation.collections • bleak_winrt.windows.storage.streams • enum

imported by: bleak.backends.winrt.client • bleak_winrt.windows.devices.bluetooth • bleak_winrt.windows.devices.bluetooth.genericattributeprofile

bleak_winrt.windows.foundation Package

imports: bleak_winrt • bleak_winrt.windows • bleak_winrt.windows.foundation.collections • enum

imported by: bleak.backends.winrt.client • bleak_winrt.windows.devices.bluetooth • bleak_winrt.windows.devices.bluetooth.advertisement • bleak_winrt.windows.devices.bluetooth.genericattributeprofile • bleak_winrt.windows.devices.enumeration • bleak_winrt.windows.foundation.collections • bleak_winrt.windows.storage.streams

bleak_winrt.windows.foundation.collections Package

imports: bleak_winrt • bleak_winrt.windows.foundation • enum

imported by: bleak_winrt.windows.devices.bluetooth • bleak_winrt.windows.devices.bluetooth.advertisement • bleak_winrt.windows.devices.bluetooth.genericattributeprofile • bleak_winrt.windows.devices.enumeration • bleak_winrt.windows.foundation • bleak_winrt.windows.storage.streams

bleak_winrt.windows.storage NamespacePackage

imports: bleak_winrt.windows

imported by: bleak_winrt.windows.storage.streams

bleak_winrt.windows.storage.streams Package

imports: 'bleak_winrt.windows.system' • bleak_winrt • bleak_winrt.windows.foundation • bleak_winrt.windows.foundation.collections • bleak_winrt.windows.storage • enum

imported by: bleak.backends.winrt.client • bleak_winrt.windows.devices.bluetooth • bleak_winrt.windows.devices.bluetooth.advertisement • bleak_winrt.windows.devices.bluetooth.genericattributeprofile • bleak_winrt.windows.devices.enumeration

builtins (builtin module)

imported by: PIL.Image • bz2 • codecs • dataclasses • doctest • enum • gettext • gzip • inspect • locale • lzma • matplotlib.axes._axes • numpy • numpy.core.numeric • numpy.core.numerictypes • numpy.lib.function_base • numpy.ma.core • operator • pydoc • reprlib • subprocess • tarfile • tokenize • warnings

bz2 SourceModule

imports: _bz2 • _compression • builtins • io • os

imported by: encodings.bz2_codec • matplotlib.cbook • numpy.lib._datasource • shutil • tarfile • zipfile

calendar SourceModule

imports: argparse • datetime • itertools • locale • sys

imported by: PIL.PdfParser • _strptime • dateutil.parser._parser • dateutil.parser.isoparser • dateutil.relativedelta • dateutil.rrule • email._parseaddr • http.cookiejar • ssl

certifi MissingModule

imported by: matplotlib

cffi MissingModule

imported by: PIL.Image • PIL.PyAccess

cmd SourceModule

imports: readline • string • sys

imported by: pdb

code SourceModule

imports: argparse • codeop • readline • sys • traceback

imported by: pdb

codecs SourceModule

imports: _codecs • builtins • encodings • sys

imported by: PIL.PdfParser • _pickle • encodings • encodings.ascii • encodings.base64_codec • encodings.big5 • encodings.big5hkscs • encodings.bz2_codec • encodings.charmap • encodings.cp037 • encodings.cp1006 • encodings.cp1026 • encodings.cp1125 • encodings.cp1140 • encodings.cp1250 • encodings.cp1251 • encodings.cp1252 • encodings.cp1253 • encodings.cp1254 • encodings.cp1255 • encodings.cp1256 • encodings.cp1257 • encodings.cp1258 • encodings.cp273 • encodings.cp424 • encodings.cp437 • encodings.cp500 • encodings.cp720 • encodings.cp737 • encodings.cp775 • encodings.cp850 • encodings.cp852 • encodings.cp855 • encodings.cp856 • encodings.cp857 • encodings.cp858 • encodings.cp860 • encodings.cp861 • encodings.cp862 • encodings.cp863 • encodings.cp864 • encodings.cp865 • encodings.cp866 • encodings.cp869 • encodings.cp874 • encodings.cp875 • encodings.cp932 • encodings.cp949 • encodings.cp950 • encodings.euc_jis_2004 • encodings.euc_jisx0213 • encodings.euc_jp • encodings.euc_kr • encodings.gb18030 • encodings.gb2312 • encodings.gbk • encodings.hex_codec • encodings.hp_roman8 • encodings.hz • encodings.idna • encodings.iso2022_jp • encodings.iso2022_jp_1 • encodings.iso2022_jp_2 • encodings.iso2022_jp_2004 • encodings.iso2022_jp_3 • encodings.iso2022_jp_ext • encodings.iso2022_kr • encodings.iso8859_1 • encodings.iso8859_10 • encodings.iso8859_11 • encodings.iso8859_13 • encodings.iso8859_14 • encodings.iso8859_15 • encodings.iso8859_16 • encodings.iso8859_2 • encodings.iso8859_3 • encodings.iso8859_4 • encodings.iso8859_5 • encodings.iso8859_6 • encodings.iso8859_7 • encodings.iso8859_8 • encodings.iso8859_9 • encodings.johab • encodings.koi8_r • encodings.koi8_t • encodings.koi8_u • encodings.kz1048 • encodings.latin_1 • encodings.mac_arabic • encodings.mac_croatian • encodings.mac_cyrillic • encodings.mac_farsi • encodings.mac_greek • encodings.mac_iceland • encodings.mac_latin2 • encodings.mac_roman • encodings.mac_romanian • encodings.mac_turkish • encodings.mbcs • encodings.oem • encodings.palmos • encodings.ptcp154 • encodings.punycode • encodings.quopri_codec • encodings.raw_unicode_escape • encodings.rot_13 • encodings.shift_jis • encodings.shift_jis_2004 • encodings.shift_jisx0213 • encodings.tis_620 • encodings.undefined • encodings.unicode_escape • encodings.utf_16 • encodings.utf_16_be • encodings.utf_16_le • encodings.utf_32 • encodings.utf_32_be • encodings.utf_32_le • encodings.utf_7 • encodings.utf_8 • encodings.utf_8_sig • encodings.uu_codec • encodings.zlib_codec • esp_controller.py • json • pickle • plistlib • tokenize • xml.sax.saxutils

codeop SourceModule

imports: __future__ • warnings

imported by: code

collections Package

imports: _collections • _collections_abc • _weakref • copy • heapq • itertools • keyword • operator • reprlib • sys

imported by: PIL.PdfParser • PIL.TiffTags • PIL.features • _pydecimal • ast • asyncio.base_events • asyncio.base_subprocess • asyncio.locks • asyncio.proactor_events • asyncio.queues • asyncio.selector_events • asyncio.sslproto • asyncio.streams • collections.abc • concurrent.futures._base • contextlib • dateutil.tz._factories • dateutil.tz.tz • difflib • dis • doctest • email.feedparser • esp_controller.py • functools • importlib.metadata • importlib.metadata._collections • importlib.resources.readers • inspect • jinja2.environment • jinja2.filters • jinja2.lexer • jinja2.loaders • jinja2.nodes • jinja2.runtime • jinja2.sandbox • jinja2.tests • jinja2.utils • matplotlib • matplotlib._afm • matplotlib._pylab_helpers • matplotlib.artist • matplotlib.backend_bases • matplotlib.category • matplotlib.cbook • matplotlib.dviread • matplotlib.font_manager • matplotlib.patches • matplotlib.textpath • mpl_toolkits.mplot3d.axes3d • multiprocessing.heap • multiprocessing.pool • multiprocessing.queues • numpy.core.overrides • numpy.core.records • packaging._manylinux • packaging.version • pkg_resources • pkg_resources._vendor.importlib_resources.readers • pkg_resources._vendor.jaraco.functools • pkg_resources._vendor.more_itertools.more • pkg_resources._vendor.more_itertools.recipes • pkg_resources._vendor.packaging._manylinux • pkg_resources._vendor.packaging.version • pkg_resources._vendor.pyparsing.util • pkg_resources._vendor.zipp • pkgutil • platform • pprint • pydoc • pyparsing.core • pyparsing.util • queue • selectors • shlex • shutil • ssl • statistics • string • threading • tkinter • tokenize • typing • typing_extensions • unittest._log • unittest.case • unittest.util • urllib.parse

collections.abc SourceModule

imports: _collections_abc • collections

imported by: PIL.Image • PIL.TiffImagePlugin • asyncio.base_events • asyncio.coroutines • bleak • bleak.backends.bluezdbus.client • bleak.backends.client • bleak.backends.corebluetooth.client • bleak.backends.winrt.client • cycler • esp_controller.py • http.client • inspect • jinja2.filters • jinja2.loaders • jinja2.runtime • jinja2.sandbox • jinja2.tests • jinja2.utils • logging • matplotlib • matplotlib._mathtext • matplotlib.axes._base • matplotlib.cbook • matplotlib.cm • matplotlib.colors • matplotlib.markers • matplotlib.pyplot • matplotlib.spines • matplotlib.typing • numpy._typing._array_like • numpy._typing._dtype_like • numpy._typing._nested_sequence • numpy._typing._shape • numpy.array_api._creation_functions • numpy.array_api._data_type_functions • numpy.core._ufunc_config • numpy.lib.function_base • numpy.lib.npyio • pkg_resources._vendor.more_itertools.more • pkg_resources._vendor.pyparsing.core • pkg_resources._vendor.pyparsing.results • pyparsing.core • pyparsing.results • selectors • traceback • tracemalloc • typing • typing_extensions

colorsys SourceModule

imported by: PIL.ImageColor

com MissingModule

imported by: pkg_resources._vendor.appdirs

concurrent Package

imported by: concurrent.futures

concurrent.futures Package

imports: concurrent • concurrent.futures._base • concurrent.futures.process • concurrent.futures.thread

imported by: asyncio.base_events • asyncio.futures • asyncio.tasks • concurrent.futures._base • concurrent.futures.process • concurrent.futures.thread

concurrent.futures._base SourceModule

imports: collections • concurrent.futures • logging • threading • time • types

imported by: concurrent.futures • concurrent.futures.process • concurrent.futures.thread

concurrent.futures.process SourceModule

imports: concurrent.futures • concurrent.futures._base • functools • itertools • multiprocessing • multiprocessing.connection • multiprocessing.queues • multiprocessing.synchronize • os • queue • sys • threading • traceback • weakref

imported by: concurrent.futures

concurrent.futures.thread SourceModule

imports: concurrent.futures • concurrent.futures._base • itertools • os • queue • threading • types • weakref

imported by: concurrent.futures

contextlib SourceModule

imports: _collections_abc • abc • collections • functools • os • sys • types

imported by: _threading_local • ast • asyncio.staggered • bleak.backends.bluezdbus.manager • bleak.backends.bluezdbus.version • dateutil.tz.tz • getpass • glob • http.server • importlib.metadata • importlib.resources._adapters • importlib.resources._common • importlib.util • jinja2.compiler • matplotlib • matplotlib._api.deprecation • matplotlib.artist • matplotlib.axes._base • matplotlib.backend_bases • matplotlib.backends._backend_tk • matplotlib.backends.backend_agg • matplotlib.backends.backend_webagg • matplotlib.cbook • matplotlib.contour • matplotlib.figure • matplotlib.layout_engine • matplotlib.pyplot • matplotlib.style.core • matplotlib.widgets • mpl_toolkits.mplot3d.art3d • numpy.core._methods • numpy.core._ufunc_config • numpy.core.arrayprint • numpy.core.memmap • numpy.core.records • numpy.lib.histograms • numpy.lib.npyio • numpy.testing._private.utils • packaging._manylinux • packaging._tokenizer • pkg_resources._vendor.importlib_resources._adapters • pkg_resources._vendor.importlib_resources._common • pkg_resources._vendor.importlib_resources._compat • pkg_resources._vendor.jaraco.context • pkg_resources._vendor.packaging._musllinux • pkg_resources._vendor.pyparsing.testing • pkg_resources._vendor.zipp • pyparsing.testing • subprocess • traceback • typing • unittest.case • urllib.request • zipfile

contextvars SourceModule

imports: _contextvars

imported by: _pydecimal • asyncio.events • asyncio.futures • asyncio.runners • asyncio.tasks • asyncio.threads • numpy.core._ufunc_config • unittest.async_case

contourpy Package

imports: __future__ • contourpy._contourpy • contourpy._version • contourpy.chunk • contourpy.convert • contourpy.dechunk • contourpy.enum_util • numpy • numpy.typing • typing

imported by: contourpy._contourpy • contourpy._version • contourpy.array • contourpy.chunk • contourpy.convert • contourpy.dechunk • contourpy.enum_util • contourpy.typecheck • contourpy.types • matplotlib.contour

contourpy._contourpy C:\Users\Admin\myenv\Lib\site-packages\contourpy\_contourpy.cp311-win_amd64.pyd

imports: contourpy

imported by: contourpy • contourpy.array • contourpy.convert • contourpy.dechunk • contourpy.enum_util • contourpy.typecheck

contourpy._version SourceModule

imports: contourpy

imported by: contourpy

contourpy.array SourceModule

imports: __future__ • contourpy • contourpy._contourpy • contourpy.typecheck • contourpy.types • itertools • numpy • typing

imported by: contourpy.convert • contourpy.dechunk

contourpy.chunk SourceModule

imports: __future__ • contourpy • math

imported by: contourpy

contourpy.convert SourceModule

imports: __future__ • contourpy • contourpy._contourpy • contourpy.array • contourpy.enum_util • contourpy.typecheck • contourpy.types • numpy • typing

imported by: contourpy

contourpy.dechunk SourceModule

imports: __future__ • contourpy • contourpy._contourpy • contourpy.array • contourpy.enum_util • contourpy.typecheck • typing

imported by: contourpy

contourpy.enum_util SourceModule

imports: __future__ • contourpy • contourpy._contourpy

imported by: contourpy • contourpy.convert • contourpy.dechunk • contourpy.typecheck

contourpy.typecheck SourceModule

imports: __future__ • contourpy • contourpy._contourpy • contourpy.enum_util • contourpy.types • numpy • typing

imported by: contourpy.array • contourpy.convert • contourpy.dechunk

contourpy.types SourceModule

imports: __future__ • contourpy • numpy

imported by: contourpy.array • contourpy.convert • contourpy.typecheck

copy SourceModule

imports: 'org.python' • copyreg • types • weakref

imported by: PIL.GifImagePlugin • _sre • argparse • collections • cycler • dataclasses • email.generator • gettext • http.cookiejar • http.server • matplotlib._mathtext • matplotlib.font_manager • matplotlib.gridspec • matplotlib.lines • matplotlib.markers • matplotlib.path • matplotlib.transforms • matplotlib.widgets • numpy.ma.core • pkg_resources._vendor.pyparsing.core • pyparsing.core • tarfile • weakref • webbrowser

copyreg SourceModule

imports: functools • operator

imported by: _pickle • copy • esp_controller.py • multiprocessing.reduction • numpy.core • pickle • re

csv SourceModule

imports: _csv • io • re

imported by: importlib.metadata

ctypes Package

imports: _ctypes • ctypes._endian • ctypes.wintypes • nt • os • struct • sys • types

imported by: _pyi_rth_utils._win32 • bleak.backends.winrt.client • ctypes._endian • ctypes.wintypes • dateutil.tz.win • multiprocessing.sharedctypes • numpy._distributor_init • numpy.core._dtype_ctypes • numpy.core._internal • numpy.ctypeslib • packaging._manylinux • pkg_resources._vendor.appdirs • pkg_resources._vendor.packaging._manylinux

ctypes._endian SourceModule

imports: ctypes • sys

imported by: ctypes

ctypes.wintypes SourceModule

imports: ctypes

imported by: _pyi_rth_utils._win32 • ctypes • dateutil.tz.win

cycler Package

imports: __future__ • collections.abc • copy • functools • itertools • operator • typing

imported by: matplotlib.pyplot • matplotlib.rcsetup • matplotlib.widgets

dataclasses SourceModule

imports: _thread • abc • builtins • copy • functools • inspect • itertools • keyword • re • sys • types

imported by: matplotlib._text_helpers • matplotlib.font_manager • numpy.array_api._data_type_functions • packaging._tokenizer • pprint

datetime SourceModule

imports: _datetime • _strptime • math • operator • sys • time

imported by: _strptime • calendar • dateutil.easter • dateutil.parser._parser • dateutil.parser.isoparser • dateutil.relativedelta • dateutil.rrule • dateutil.tz._common • dateutil.tz._factories • dateutil.tz.tz • dateutil.tz.win • email.utils • http.cookiejar • http.server • matplotlib.axis • matplotlib.backends.backend_webagg_core • matplotlib.dates • matplotlib.pyplot • pkg_resources._vendor.pyparsing.common • plistlib • pyparsing.common • xmlrpc.client

dateutil Package

imports: dateutil • dateutil._version • dateutil.easter • dateutil.relativedelta • dateutil.rrule • dateutil.tz

imported by: dateutil • dateutil._common • dateutil._version • dateutil.easter • dateutil.parser • dateutil.parser._parser • dateutil.parser.isoparser • dateutil.relativedelta • dateutil.rrule • dateutil.tz • dateutil.tz.tz • dateutil.zoneinfo

dateutil._common SourceModule

imports: dateutil

imported by: dateutil.relativedelta • dateutil.rrule

dateutil._version SourceModule

imports: dateutil

imported by: dateutil

dateutil.easter SourceModule

imports: datetime • dateutil

imported by: dateutil • dateutil.rrule

dateutil.parser Package

imports: dateutil • dateutil.parser._parser • dateutil.parser.isoparser • functools • warnings

imported by: dateutil.parser._parser • dateutil.parser.isoparser • dateutil.rrule • dateutil.tz.tz • matplotlib.category • matplotlib.dates

dateutil.parser._parser SourceModule

imports: __future__ • calendar • datetime • dateutil • dateutil.parser • dateutil.relativedelta • dateutil.tz • decimal • io • re • six • string • time • warnings

imported by: dateutil.parser • dateutil.tz.tz

dateutil.parser.isoparser SourceModule

imports: calendar • datetime • dateutil • dateutil.parser • dateutil.tz • functools • re • six

imported by: dateutil.parser

dateutil.relativedelta SourceModule

imports: calendar • datetime • dateutil • dateutil._common • math • operator • six • warnings

imported by: dateutil • dateutil.parser._parser • dateutil.tz.tz • matplotlib.dates

dateutil.rrule SourceModule

imports: _thread • calendar • datetime • dateutil • dateutil._common • dateutil.easter • dateutil.parser • dateutil.tz • fractions • functools • heapq • itertools • math • re • six • six.moves • six.moves.range • sys • warnings

imported by: dateutil • dateutil.tz.tz • matplotlib.dates

dateutil.tz Package

imports: dateutil • dateutil.tz.tz • dateutil.tz.tzfile

imported by: dateutil • dateutil.parser._parser • dateutil.parser.isoparser • dateutil.rrule • dateutil.tz._common • dateutil.tz._factories • dateutil.tz.tz • dateutil.tz.win • dateutil.zoneinfo • matplotlib.axis • matplotlib.dates

dateutil.tz._common SourceModule

imports: datetime • dateutil.tz • functools • six

imported by: dateutil.tz.tz • dateutil.tz.win

dateutil.tz._factories SourceModule

imports: _thread • collections • datetime • dateutil.tz • six.moves • weakref

imported by: dateutil.tz.tz

dateutil.tz.tz SourceModule

imports: _thread • bisect • collections • contextlib • datetime • dateutil • dateutil.parser • dateutil.parser._parser • dateutil.relativedelta • dateutil.rrule • dateutil.tz • dateutil.tz._common • dateutil.tz._factories • dateutil.tz.win • dateutil.zoneinfo • os • six • six.moves • struct • sys • time • warnings • weakref

imported by: dateutil.tz

dateutil.tz.tzfile MissingModule

imported by: dateutil.tz • dateutil.zoneinfo

dateutil.tz.win SourceModule

imports: ctypes • ctypes.wintypes • datetime • dateutil.tz • dateutil.tz._common • six • six.moves • struct • winreg

imported by: dateutil.tz.tz

dateutil.zoneinfo Package

imports: dateutil • dateutil.tz • dateutil.tz.tzfile • io • json • pkgutil • tarfile • warnings

imported by: dateutil.tz.tz

dbus_fast MissingModule

imported by: bleak.backends.bluezdbus.client • bleak.backends.bluezdbus.manager • bleak.backends.bluezdbus.scanner

decimal SourceModule

imports: _decimal • _pydecimal

imported by: dateutil.parser._parser • fractions • matplotlib.units • statistics • xmlrpc.client

defusedxml MissingModule

imported by: PIL.Image

difflib SourceModule

imports: collections • difflib • heapq • re • types

imported by: difflib • doctest • numpy.testing._private.utils • unittest.case

dis SourceModule

imports: argparse • collections • io • opcode • sys • types

imported by: inspect • pdb

doctest SourceModule

imports: __future__ • argparse • builtins • collections • difflib • inspect • io • linecache • os • pdb • re • sys • traceback • unittest

imported by: numpy.testing._private.utils

email Package

imports: email._header_value_parser • email.charset • email.errors • email.header • email.parser

imported by: email._encoded_words • email._header_value_parser • email._parseaddr • email._policybase • email.base64mime • email.charset • email.contentmanager • email.encoders • email.errors • email.feedparser • email.generator • email.header • email.headerregistry • email.iterators • email.message • email.parser • email.policy • email.quoprimime • email.utils • importlib.metadata • urllib.request

email._encoded_words SourceModule

imports: base64 • binascii • email • email.errors • functools • re • string

imported by: email._header_value_parser • email.message

email._header_value_parser SourceModule

imports: email • email._encoded_words • email.errors • email.utils • operator • re • string • sys • urllib

imported by: email • email.headerregistry

email._parseaddr SourceModule

imports: calendar • email • time

imported by: email.utils

email._policybase SourceModule

imports: abc • email • email.charset • email.header • email.utils

imported by: email.feedparser • email.message • email.parser • email.policy

email.base64mime SourceModule

imports: base64 • binascii • email

imported by: email.charset • email.header

email.charset SourceModule

imports: email • email.base64mime • email.encoders • email.errors • email.quoprimime • functools

imported by: email • email._policybase • email.contentmanager • email.header • email.message • email.utils

email.contentmanager SourceModule

imports: binascii • email • email.charset • email.errors • email.message • email.quoprimime

imported by: email.policy

email.encoders SourceModule

imports: base64 • email • quopri

imported by: email.charset

email.errors SourceModule

imports: email

imported by: email • email._encoded_words • email._header_value_parser • email.charset • email.contentmanager • email.feedparser • email.header • email.headerregistry • email.message

email.feedparser SourceModule

imports: collections • email • email._policybase • email.errors • email.message • io • re

imported by: email.parser • packaging.metadata

email.generator SourceModule

imports: copy • email • email.utils • io • random • re • sys • time

imported by: email.message

email.header SourceModule

imports: binascii • email • email.base64mime • email.charset • email.errors • email.quoprimime • re

imported by: email • email._policybase • packaging.metadata

email.headerregistry SourceModule

imports: email • email._header_value_parser • email.errors • email.utils • types

imported by: email.policy

email.iterators SourceModule

imports: email • io • sys

imported by: email.message

email.message SourceModule

imports: binascii • email • email._encoded_words • email._policybase • email.charset • email.errors • email.generator • email.iterators • email.policy • email.utils • io • quopri • re

imported by: email.contentmanager • email.feedparser • email.policy • http.client • importlib.metadata._adapters • packaging.metadata • pydoc

email.parser SourceModule

imports: email • email._policybase • email.feedparser • io

imported by: email • http.client • packaging.metadata • pkg_resources

email.policy SourceModule

imports: email • email._policybase • email.contentmanager • email.headerregistry • email.message • email.utils • re • sys

imported by: email.message • packaging.metadata

email.quoprimime SourceModule

imports: email • re • string

imported by: email.charset • email.contentmanager • email.header

email.utils SourceModule

imports: datetime • email • email._parseaddr • email.charset • os • random • re • socket • time • urllib.parse

imported by: email._header_value_parser • email._policybase • email.generator • email.headerregistry • email.message • email.policy • http.server • urllib.request

encodings Package

imports: _winapi • codecs • encodings • encodings.aliases • encodings.ascii • encodings.base64_codec • encodings.big5 • encodings.big5hkscs • encodings.bz2_codec • encodings.charmap • encodings.cp037 • encodings.cp1006 • encodings.cp1026 • encodings.cp1125 • encodings.cp1140 • encodings.cp1250 • encodings.cp1251 • encodings.cp1252 • encodings.cp1253 • encodings.cp1254 • encodings.cp1255 • encodings.cp1256 • encodings.cp1257 • encodings.cp1258 • encodings.cp273 • encodings.cp424 • encodings.cp437 • encodings.cp500 • encodings.cp720 • encodings.cp737 • encodings.cp775 • encodings.cp850 • encodings.cp852 • encodings.cp855 • encodings.cp856 • encodings.cp857 • encodings.cp858 • encodings.cp860 • encodings.cp861 • encodings.cp862 • encodings.cp863 • encodings.cp864 • encodings.cp865 • encodings.cp866 • encodings.cp869 • encodings.cp874 • encodings.cp875 • encodings.cp932 • encodings.cp949 • encodings.cp950 • encodings.euc_jis_2004 • encodings.euc_jisx0213 • encodings.euc_jp • encodings.euc_kr • encodings.gb18030 • encodings.gb2312 • encodings.gbk • encodings.hex_codec • encodings.hp_roman8 • encodings.hz • encodings.idna • encodings.iso2022_jp • encodings.iso2022_jp_1 • encodings.iso2022_jp_2 • encodings.iso2022_jp_2004 • encodings.iso2022_jp_3 • encodings.iso2022_jp_ext • encodings.iso2022_kr • encodings.iso8859_1 • encodings.iso8859_10 • encodings.iso8859_11 • encodings.iso8859_13 • encodings.iso8859_14 • encodings.iso8859_15 • encodings.iso8859_16 • encodings.iso8859_2 • encodings.iso8859_3 • encodings.iso8859_4 • encodings.iso8859_5 • encodings.iso8859_6 • encodings.iso8859_7 • encodings.iso8859_8 • encodings.iso8859_9 • encodings.johab • encodings.koi8_r • encodings.koi8_t • encodings.koi8_u • encodings.kz1048 • encodings.latin_1 • encodings.mac_arabic • encodings.mac_croatian • encodings.mac_cyrillic • encodings.mac_farsi • encodings.mac_greek • encodings.mac_iceland • encodings.mac_latin2 • encodings.mac_roman • encodings.mac_romanian • encodings.mac_turkish • encodings.mbcs • encodings.oem • encodings.palmos • encodings.ptcp154 • encodings.punycode • encodings.quopri_codec • encodings.raw_unicode_escape • encodings.rot_13 • encodings.shift_jis • encodings.shift_jis_2004 • encodings.shift_jisx0213 • encodings.tis_620 • encodings.undefined • encodings.unicode_escape • encodings.utf_16 • encodings.utf_16_be • encodings.utf_16_le • encodings.utf_32 • encodings.utf_32_be • encodings.utf_32_le • encodings.utf_7 • encodings.utf_8 • encodings.utf_8_sig • encodings.uu_codec • encodings.zlib_codec • sys

imported by: codecs • encodings • encodings.aliases • encodings.ascii • encodings.base64_codec • encodings.big5 • encodings.big5hkscs • encodings.bz2_codec • encodings.charmap • encodings.cp037 • encodings.cp1006 • encodings.cp1026 • encodings.cp1125 • encodings.cp1140 • encodings.cp1250 • encodings.cp1251 • encodings.cp1252 • encodings.cp1253 • encodings.cp1254 • encodings.cp1255 • encodings.cp1256 • encodings.cp1257 • encodings.cp1258 • encodings.cp273 • encodings.cp424 • encodings.cp437 • encodings.cp500 • encodings.cp720 • encodings.cp737 • encodings.cp775 • encodings.cp850 • encodings.cp852 • encodings.cp855 • encodings.cp856 • encodings.cp857 • encodings.cp858 • encodings.cp860 • encodings.cp861 • encodings.cp862 • encodings.cp863 • encodings.cp864 • encodings.cp865 • encodings.cp866 • encodings.cp869 • encodings.cp874 • encodings.cp875 • encodings.cp932 • encodings.cp949 • encodings.cp950 • encodings.euc_jis_2004 • encodings.euc_jisx0213 • encodings.euc_jp • encodings.euc_kr • encodings.gb18030 • encodings.gb2312 • encodings.gbk • encodings.hex_codec • encodings.hp_roman8 • encodings.hz • encodings.idna • encodings.iso2022_jp • encodings.iso2022_jp_1 • encodings.iso2022_jp_2 • encodings.iso2022_jp_2004 • encodings.iso2022_jp_3 • encodings.iso2022_jp_ext • encodings.iso2022_kr • encodings.iso8859_1 • encodings.iso8859_10 • encodings.iso8859_11 • encodings.iso8859_13 • encodings.iso8859_14 • encodings.iso8859_15 • encodings.iso8859_16 • encodings.iso8859_2 • encodings.iso8859_3 • encodings.iso8859_4 • encodings.iso8859_5 • encodings.iso8859_6 • encodings.iso8859_7 • encodings.iso8859_8 • encodings.iso8859_9 • encodings.johab • encodings.koi8_r • encodings.koi8_t • encodings.koi8_u • encodings.kz1048 • encodings.latin_1 • encodings.mac_arabic • encodings.mac_croatian • encodings.mac_cyrillic • encodings.mac_farsi • encodings.mac_greek • encodings.mac_iceland • encodings.mac_latin2 • encodings.mac_roman • encodings.mac_romanian • encodings.mac_turkish • encodings.mbcs • encodings.oem • encodings.palmos • encodings.ptcp154 • encodings.punycode • encodings.quopri_codec • encodings.raw_unicode_escape • encodings.rot_13 • encodings.shift_jis • encodings.shift_jis_2004 • encodings.shift_jisx0213 • encodings.tis_620 • encodings.undefined • encodings.unicode_escape • encodings.utf_16 • encodings.utf_16_be • encodings.utf_16_le • encodings.utf_32 • encodings.utf_32_be • encodings.utf_32_le • encodings.utf_7 • encodings.utf_8 • encodings.utf_8_sig • encodings.uu_codec • encodings.zlib_codec • esp_controller.py • locale

encodings.aliases SourceModule

imports: encodings

imported by: encodings • esp_controller.py • locale

encodings.ascii SourceModule

imports: codecs • encodings

imported by: encodings • esp_controller.py

encodings.base64_codec SourceModule

imports: base64 • codecs • encodings

imported by: encodings • esp_controller.py

encodings.big5 SourceModule

imports: _codecs_tw • _multibytecodec • codecs • encodings

imported by: encodings • esp_controller.py

encodings.big5hkscs SourceModule

imports: _codecs_hk • _multibytecodec • codecs • encodings

imported by: encodings • esp_controller.py

encodings.bz2_codec SourceModule

imports: bz2 • codecs • encodings

imported by: encodings • esp_controller.py

encodings.charmap SourceModule

imports: codecs • encodings

imported by: encodings • esp_controller.py

encodings.cp037 SourceModule

imports: codecs • encodings

imported by: encodings • esp_controller.py

encodings.cp1006 SourceModule

imports: codecs • encodings

imported by: encodings • esp_controller.py

encodings.cp1026 SourceModule

imports: codecs • encodings

imported by: encodings • esp_controller.py

encodings.cp1125 SourceModule

imports: codecs • encodings

imported by: encodings • esp_controller.py

encodings.cp1140 SourceModule

imports: codecs • encodings

imported by: encodings • esp_controller.py

encodings.cp1250 SourceModule

imports: codecs • encodings

imported by: encodings • esp_controller.py

encodings.cp1251 SourceModule

imports: codecs • encodings

imported by: encodings • esp_controller.py

encodings.cp1252 SourceModule

imports: codecs • encodings

imported by: encodings • esp_controller.py

encodings.cp1253 SourceModule

imports: codecs • encodings

imported by: encodings • esp_controller.py

encodings.cp1254 SourceModule

imports: codecs • encodings

imported by: encodings • esp_controller.py

encodings.cp1255 SourceModule

imports: codecs • encodings

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

imports: _codecs_jp • _multibytecodec • codecs • encodings

imported by: encodings • esp_controller.py

encodings.tis_620 SourceModule

imports: codecs • encodings

imported by: encodings • esp_controller.py

encodings.undefined SourceModule

imports: codecs • encodings

imported by: encodings • esp_controller.py

encodings.unicode_escape SourceModule

imports: codecs • encodings

imported by: encodings • esp_controller.py

encodings.utf_16 SourceModule

imports: codecs • encodings • sys

imported by: encodings • esp_controller.py

encodings.utf_16_be SourceModule

imports: codecs • encodings

imported by: encodings • esp_controller.py

encodings.utf_16_le SourceModule

imports: codecs • encodings

imported by: encodings • esp_controller.py

encodings.utf_32 SourceModule

imports: codecs • encodings • sys

imported by: encodings • esp_controller.py

encodings.utf_32_be SourceModule

imports: codecs • encodings

imported by: encodings • esp_controller.py

encodings.utf_32_le SourceModule

imports: codecs • encodings

imported by: encodings • esp_controller.py

encodings.utf_7 SourceModule

imports: codecs • encodings

imported by: encodings • esp_controller.py

encodings.utf_8 SourceModule

imports: codecs • encodings

imported by: encodings • esp_controller.py

encodings.utf_8_sig SourceModule

imports: codecs • encodings

imported by: encodings • esp_controller.py

encodings.uu_codec SourceModule

imports: binascii • codecs • encodings • io

imported by: encodings • esp_controller.py

encodings.zlib_codec SourceModule

imports: codecs • encodings • zlib

imported by: encodings • esp_controller.py

enum SourceModule

imports: builtins • functools • operator • sys • types • warnings

imported by: PIL.BlpImagePlugin • PIL.ExifTags • PIL.FtexImagePlugin • PIL.GifImagePlugin • PIL.Image • PIL.ImageCms • PIL.PngImagePlugin • ast • asyncio.constants • asyncio.locks • asyncio.runners • asyncio.sslproto • asyncio.timeouts • bleak.assigned_numbers • bleak.backends.characteristic • bleak.backends.corebluetooth.characteristic • bleak.backends.p4android.defs • bleak_winrt.windows.devices.bluetooth • bleak_winrt.windows.devices.bluetooth.advertisement • bleak_winrt.windows.devices.bluetooth.genericattributeprofile • bleak_winrt.windows.devices.enumeration • bleak_winrt.windows.foundation • bleak_winrt.windows.foundation.collections • bleak_winrt.windows.storage.streams • esp_controller.py • http • inspect • jinja2.utils • matplotlib._enums • matplotlib._mathtext • matplotlib.backend_bases • matplotlib.backend_tools • matplotlib.dviread • matplotlib.pyplot • numpy._globals • numpy.array_api._array_object • packaging._elffile • pkg_resources._vendor.pyparsing.core • plistlib • py_compile • pyparsing.core • re • signal • socket • ssl • tkinter • uuid

errno (builtin module)

imported by: _pyi_rth_utils.tempfile • asyncio.selector_events • asyncio.unix_events • asyncio.windows_events • gettext • gzip • http.client • jinja2.bccache • matplotlib.backends.backend_webagg • multiprocessing.forkserver • multiprocessing.queues • multiprocessing.shared_memory • pathlib • pkg_resources • shutil • socket • ssl • subprocess • tempfile • xmlrpc.client

fcntl MissingModule

imported by: subprocess

fnmatch SourceModule

imports: functools • os • posixpath • re

imported by: bdb • glob • jinja2.bccache • pathlib • shutil • tkinter.filedialog • tracemalloc • unittest.loader • urllib.request

fractions SourceModule

imports: decimal • math • numbers • operator • re • sys

imported by: PIL.TiffImagePlugin • dateutil.rrule • statistics

ftplib SourceModule

imports: netrc • re • socket • ssl • sys • warnings

imported by: urllib.request

functools SourceModule

imports: _functools • _thread • abc • collections • reprlib • types • typing • weakref

imported by: PIL.ImageFilter • PIL.ImageOps • asyncio.base_events • asyncio.format_helpers • asyncio.runners • asyncio.selector_events • asyncio.tasks • asyncio.threads • bleak • concurrent.futures.process • contextlib • copyreg • cycler • dataclasses • dateutil.parser • dateutil.parser.isoparser • dateutil.rrule • dateutil.tz._common • email._encoded_words • email.charset • enum • esp_controller.py • fnmatch • importlib.metadata • importlib.metadata._functools • importlib.resources._common • importlib.resources._legacy • importlib.util • inspect • jinja2.async_utils • jinja2.compiler • jinja2.environment • jinja2.runtime • linecache • locale • markupsafe • matplotlib • matplotlib._api • matplotlib._api.deprecation • matplotlib._cm • matplotlib._fontconfig_pattern • matplotlib._mathtext • matplotlib.artist • matplotlib.axes._axes • matplotlib.axes._base • matplotlib.axis • matplotlib.backend_bases • matplotlib.backend_tools • matplotlib.bezier • matplotlib.cbook • matplotlib.cm • matplotlib.colors • matplotlib.contour • matplotlib.dates • matplotlib.dviread • matplotlib.font_manager • matplotlib.mathtext • matplotlib.mlab • matplotlib.offsetbox • matplotlib.patches • matplotlib.path • matplotlib.pyplot • matplotlib.rcsetup • matplotlib.spines • matplotlib.texmanager • matplotlib.text • matplotlib.transforms • mpl_toolkits.mplot3d.axes3d • multiprocessing.reduction • multiprocessing.shared_memory • numpy.core.arrayprint • numpy.core.defchararray • numpy.core.fromnumeric • numpy.core.function_base • numpy.core.multiarray • numpy.core.numeric • numpy.core.overrides • numpy.core.shape_base • numpy.fft._pocketfft • numpy.lib.arraysetops • numpy.lib.arrayterator • numpy.lib.function_base • numpy.lib.histograms • numpy.lib.index_tricks • numpy.lib.nanfunctions • numpy.lib.npyio • numpy.lib.polynomial • numpy.lib.shape_base • numpy.lib.twodim_base • numpy.lib.type_check • numpy.lib.ufunclike • numpy.lib.utils • numpy.linalg.linalg • numpy.ma.core • numpy.polynomial.polyutils • numpy.testing._private.utils • operator • packaging._manylinux • packaging._musllinux • pathlib • pdb • pickle • pkg_resources • pkg_resources._vendor.importlib_resources._common • pkg_resources._vendor.importlib_resources._legacy • pkg_resources._vendor.jaraco.context • pkg_resources._vendor.jaraco.functools • pkg_resources._vendor.jaraco.text • pkg_resources._vendor.more_itertools.more • pkg_resources._vendor.packaging._manylinux • pkg_resources._vendor.packaging._musllinux • pkg_resources._vendor.packaging.specifiers • pkg_resources._vendor.pyparsing.core • pkg_resources._vendor.pyparsing.util • pkgutil • platform • pyparsing.core • pyparsing.util • re • six • statistics • tempfile • threading • tokenize • tracemalloc • types • typing • typing_extensions • unittest.case • unittest.loader • unittest.result • unittest.signals • urllib.parse

gc (builtin module)

imports: time

imported by: _posixsubprocess • matplotlib.cbook • numpy.testing._private.utils • weakref

genericpath SourceModule

imports: os • stat

imported by: esp_controller.py • ntpath • posixpath

getopt SourceModule

imports: gettext • os • sys

imported by: base64 • mimetypes • pdb • pydoc • quopri • webbrowser

getpass SourceModule

imports: contextlib • io • msvcrt • os • pwd • sys • termios • warnings

imported by: urllib.request

gettext SourceModule

imports: builtins • copy • errno • locale • os • re • struct • sys • warnings

imported by: argparse • getopt • jinja2.ext

gi MissingModule

imported by: matplotlib.cbook

glob SourceModule

imports: contextlib • fnmatch • itertools • os • re • stat • sys

imported by: numpy._distributor_init • pdb • webbrowser

grp MissingModule

imported by: pathlib • shutil • subprocess • tarfile

gzip SourceModule

imports: _compression • argparse • builtins • errno • io • os • struct • sys • time • warnings • zlib

imported by: matplotlib.cbook • numpy.lib._datasource • tarfile • xmlrpc.client

hashlib SourceModule

imports: _blake2 • _hashlib • _md5 • _sha1 • _sha256 • _sha3 • _sha512 • logging • warnings

imported by: hmac • jinja2.bccache • jinja2.loaders • matplotlib.texmanager • random • urllib.request • uuid

heapq SourceModule

imports: _heapq

imported by: asyncio.base_events • asyncio.queues • collections • dateutil.rrule • difflib • esp_controller.py • pkg_resources._vendor.more_itertools.more • queue

hmac SourceModule

imports: _hashlib • _operator • hashlib • warnings

imported by: multiprocessing.connection • secrets

html Package

imports: html.entities • re

imported by: html.entities • http.server • markupsafe

html.entities SourceModule

imports: html

imported by: html • pkg_resources._vendor.pyparsing.helpers • pyparsing.helpers

http Package

imports: enum

imported by: http.client • http.cookiejar • http.server

http.client SourceModule

imports: collections.abc • email.message • email.parser • errno • http • io • re • socket • ssl • sys • urllib.parse • warnings

imported by: http.cookiejar • http.server • urllib.request • xmlrpc.client

http.cookiejar SourceModule

imports: calendar • copy • datetime • http • http.client • io • logging • os • re • threading • time • traceback • urllib.parse • urllib.request • warnings

imported by: urllib.request

http.server SourceModule

imports: argparse • base64 • binascii • contextlib • copy • datetime • email.utils • html • http • http.client • io • mimetypes • os • posixpath • pwd • select • shutil • socket • socketserver • subprocess • sys • time • urllib.parse

imported by: pydoc

imp SourceModule

imports: _imp • importlib • importlib._bootstrap • importlib._bootstrap_external • importlib.machinery • importlib.util • os • sys • tokenize • types • warnings

imported by: pkg_resources

importlib Package

imports: _frozen_importlib • _frozen_importlib_external • _imp • importlib • importlib._bootstrap • importlib._bootstrap_external • sys • warnings

imported by: imp • importlib • importlib._abc • importlib._bootstrap • importlib._bootstrap_external • importlib.abc • importlib.machinery • importlib.metadata • importlib.readers • importlib.resources • importlib.resources._common • importlib.util • inspect • jinja2.loaders • matplotlib • matplotlib.backend_bases • matplotlib.colors • matplotlib.pyplot • pkg_resources • pkg_resources._vendor.importlib_resources._common • pkgutil

importlib._abc SourceModule

imports: abc • importlib • importlib._bootstrap • warnings

imported by: importlib.abc • importlib.util

importlib._bootstrap SourceModule

imports: _frozen_importlib_external • importlib

imported by: imp • importlib • importlib._abc • importlib.machinery • importlib.util • pydoc

importlib._bootstrap_external SourceModule

imports: _imp • _io • _warnings • importlib • importlib.metadata • importlib.readers • marshal • nt • posix • sys • tokenize • winreg

imported by: imp • importlib • importlib.abc • importlib.machinery • importlib.util • py_compile • pydoc

importlib.abc SourceModule

imports: _frozen_importlib • _frozen_importlib_external • abc • importlib • importlib._abc • importlib._bootstrap_external • importlib.machinery • importlib.resources.abc • warnings

imported by: importlib.metadata

importlib.machinery SourceModule

imports: importlib • importlib._bootstrap • importlib._bootstrap_external

imported by: bleak_winrt • imp • importlib.abc • inspect • numpy.compat.py3k • packaging.tags • pkg_resources • pkg_resources._vendor.packaging.tags • pkgutil • py_compile • pydoc • runpy

importlib.metadata Package

imports: abc • collections • contextlib • csv • email • functools • importlib • importlib.abc • importlib.metadata • importlib.metadata._adapters • importlib.metadata._collections • importlib.metadata._functools • importlib.metadata._itertools • importlib.metadata._meta • itertools • operator • os • pathlib • posixpath • re • sys • textwrap • typing • warnings • zipfile

imported by: importlib._bootstrap_external • importlib.metadata • importlib.metadata._adapters • importlib.metadata._collections • importlib.metadata._functools • importlib.metadata._itertools • importlib.metadata._meta • importlib.metadata._text

importlib.metadata._adapters SourceModule

imports: email.message • importlib.metadata • importlib.metadata._text • re • textwrap

imported by: importlib.metadata

importlib.metadata._collections SourceModule

imports: collections • importlib.metadata

imported by: importlib.metadata

importlib.metadata._functools SourceModule

imports: functools • importlib.metadata • types

imported by: importlib.metadata • importlib.metadata._text

importlib.metadata._itertools SourceModule

imports: importlib.metadata • itertools

imported by: importlib.metadata

importlib.metadata._meta SourceModule

imports: importlib.metadata • typing

imported by: importlib.metadata

importlib.metadata._text SourceModule

imports: importlib.metadata • importlib.metadata._functools • re

imported by: importlib.metadata._adapters

importlib.readers SourceModule

imports: importlib • importlib.resources.readers

imported by: importlib._bootstrap_external • zipimport

importlib.resources Package

imports: importlib • importlib.resources • importlib.resources._common • importlib.resources._legacy • importlib.resources.abc

imported by: importlib.resources • importlib.resources._adapters • importlib.resources._common • importlib.resources._itertools • importlib.resources._legacy • importlib.resources.abc • importlib.resources.readers • matplotlib.style.core • pkg_resources._vendor.jaraco.text

importlib.resources._adapters SourceModule

imports: contextlib • importlib.resources • importlib.resources.abc • io

imported by: importlib.resources._common

importlib.resources._common SourceModule

imports: contextlib • functools • importlib • importlib.resources • importlib.resources._adapters • importlib.resources.abc • os • pathlib • tempfile • types • typing

imported by: importlib.resources • importlib.resources._legacy

importlib.resources._itertools SourceModule

imports: importlib.resources • itertools • typing

imported by: importlib.resources.readers

importlib.resources._legacy SourceModule

imports: functools • importlib.resources • importlib.resources._common • os • pathlib • types • typing • warnings

imported by: importlib.resources

importlib.resources.abc SourceModule

imports: abc • importlib.resources • io • os • typing

imported by: importlib.abc • importlib.resources • importlib.resources._adapters • importlib.resources._common • importlib.resources.readers

importlib.resources.readers SourceModule

imports: collections • importlib.resources • importlib.resources._itertools • importlib.resources.abc • operator • pathlib • zipfile

imported by: importlib.readers

importlib.util SourceModule

imports: _imp • contextlib • functools • importlib • importlib._abc • importlib._bootstrap • importlib._bootstrap_external • sys • types • warnings

imported by: bleak_winrt • imp • jinja2.loaders • numpy.testing._private.extbuild • pkg_resources.extern • pkgutil • py_compile • pydoc • runpy • six • zipfile

importlib_resources MissingModule

imported by: matplotlib.style.core

inspect SourceModule

imports: abc • argparse • ast • builtins • collections • collections.abc • dis • enum • functools • importlib • importlib.machinery • itertools • keyword • linecache • operator • os • re • sys • token • tokenize • types

imported by: ast • asyncio.coroutines • asyncio.format_helpers • asyncio.tasks • bdb • bleak • bleak.backends.scanner • dataclasses • doctest • jinja2.async_utils • jinja2.nodes • matplotlib • matplotlib._api.deprecation • matplotlib._docstring • matplotlib.artist • matplotlib.axes._base • matplotlib.backend_bases • matplotlib.colors • matplotlib.figure • matplotlib.patches • matplotlib.pyplot • matplotlib.scale • mpl_toolkits.mplot3d.axis3d • numpy.lib.utils • numpy.ma.core • numpy.testing._private.utils • pdb • pkg_resources • pkg_resources._vendor.jaraco.functools • pkg_resources._vendor.pyparsing.diagram • pkg_resources._vendor.pyparsing.exceptions • pkgutil • pydoc • pyi_rth_inspect.py • pyparsing.diagram • pyparsing.exceptions • pyparsing.util • typing_extensions • unittest.async_case

io SourceModule

imports: _io • abc • warnings

imported by: PIL.BlpImagePlugin • PIL.DdsImagePlugin • PIL.EpsImagePlugin • PIL.FtexImagePlugin • PIL.IcnsImagePlugin • PIL.IcoImagePlugin • PIL.Image • PIL.ImageFile • PIL.ImageQt • PIL.ImageTk • PIL.IptcImagePlugin • PIL.Jpeg2KImagePlugin • PIL.JpegImagePlugin • PIL.MspImagePlugin • PIL.PcxImagePlugin • PIL.PdfImagePlugin • PIL.PsdImagePlugin • PIL.TiffImagePlugin • PIL.WebPImagePlugin • _compression • asyncio.proactor_events • asyncio.unix_events • bz2 • csv • dateutil.parser._parser • dateutil.zoneinfo • dis • doctest • email.feedparser • email.generator • email.iterators • email.message • email.parser • encodings.quopri_codec • encodings.uu_codec • esp_controller.py • getpass • gzip • http.client • http.cookiejar • http.server • importlib.resources._adapters • importlib.resources.abc • jinja2.bccache • jinja2.compiler • logging • lzma • matplotlib.backend_bases • matplotlib.backends.backend_webagg • matplotlib.backends.backend_webagg_core • matplotlib.colors • matplotlib.font_manager • multiprocessing.connection • multiprocessing.popen_forkserver • multiprocessing.popen_spawn_posix • multiprocessing.reduction • numpy.compat.py3k • numpy.lib._datasource • numpy.lib.format • numpy.lib.utils • numpy.testing._private.utils • os • pathlib • pdb • pickle • pkg_resources • pkg_resources._vendor.importlib_resources._adapters • pkg_resources._vendor.importlib_resources.simple • pkg_resources._vendor.pyparsing.diagram • pkg_resources._vendor.zipp • plistlib • pprint • pydoc • pyparsing.diagram • quopri • runpy • shlex • six • socket • socketserver • subprocess • tarfile • tempfile • tokenize • unittest.result • urllib.request • uuid • xml.sax • xml.sax.saxutils • xmlrpc.client • zipfile

itertools (builtin module)

imported by: PIL.GifImagePlugin • PIL.ImageFile • PIL.MpoImagePlugin • PIL.PngImagePlugin • PIL.TiffImagePlugin • _pydecimal • asyncio.base_events • asyncio.tasks • asyncio.unix_events • asyncio.windows_utils • bleak.backends.corebluetooth.PeripheralDelegate • calendar • collections • concurrent.futures.process • concurrent.futures.thread • contourpy.array • cycler • dataclasses • dateutil.rrule • glob • importlib.metadata • importlib.metadata._itertools • importlib.resources._itertools • inspect • jinja2.compiler • jinja2.filters • jinja2.runtime • matplotlib._api • matplotlib._layoutgrid • matplotlib.axes._axes • matplotlib.backend_bases • matplotlib.category • matplotlib.cbook • matplotlib.collections • matplotlib.colors • matplotlib.dviread • matplotlib.figure • matplotlib.legend • matplotlib.legend_handler • matplotlib.stackplot • matplotlib.ticker • matplotlib.widgets • mpl_toolkits.mplot3d.axes3d • multiprocessing.connection • multiprocessing.pool • multiprocessing.process • multiprocessing.util • numpy.core.einsumfunc • numpy.core.numeric • numpy.core.shape_base • numpy.lib.npyio • numpy.lib.recfunctions • numpy.ma.extras • packaging.specifiers • packaging.version • pickle • pkg_resources • pkg_resources._vendor.importlib_resources._itertools • pkg_resources._vendor.importlib_resources.simple • pkg_resources._vendor.jaraco.functools • pkg_resources._vendor.jaraco.text • pkg_resources._vendor.more_itertools.more • pkg_resources._vendor.more_itertools.recipes • pkg_resources._vendor.packaging.specifiers • pkg_resources._vendor.packaging.version • pkg_resources._vendor.pyparsing.unicode • pkg_resources._vendor.pyparsing.util • pkg_resources._vendor.zipp • platform • plistlib • pyparsing.unicode • pyparsing.util • random • reprlib • six • statistics • threading • tkinter.font • tokenize • traceback • weakref • zipfile

java MissingModule

imported by: platform

jinja2 Package

imports: jinja2 • jinja2.bccache • jinja2.environment • jinja2.exceptions • jinja2.ext • jinja2.loaders • jinja2.nodes • jinja2.runtime • jinja2.utils

imported by: jinja2 • jinja2._identifier • jinja2.async_utils • jinja2.bccache • jinja2.compiler • jinja2.constants • jinja2.debug • jinja2.defaults • jinja2.environment • jinja2.exceptions • jinja2.ext • jinja2.filters • jinja2.idtracking • jinja2.lexer • jinja2.loaders • jinja2.nodes • jinja2.optimizer • jinja2.parser • jinja2.runtime • jinja2.sandbox • jinja2.tests • jinja2.utils • jinja2.visitor • pkg_resources._vendor.pyparsing.diagram • pyparsing.diagram

jinja2._identifier SourceModule

imports: jinja2 • re

imported by: jinja2.lexer

jinja2.async_utils SourceModule

imports: functools • inspect • jinja2 • jinja2.utils • typing

imported by: jinja2.filters • jinja2.runtime

jinja2.bccache SourceModule

imports: errno • fnmatch • hashlib • io • jinja2 • jinja2.environment • marshal • os • pickle • stat • sys • tempfile • types • typing • typing_extensions

imported by: jinja2 • jinja2.environment

jinja2.compiler SourceModule

imports: contextlib • functools • io • itertools • jinja2 • jinja2.environment • jinja2.exceptions • jinja2.idtracking • jinja2.nodes • jinja2.optimizer • jinja2.runtime • jinja2.utils • jinja2.visitor • keyword • markupsafe • typing • typing_extensions

imported by: jinja2.environment • jinja2.nodes

jinja2.constants SourceModule

imports: jinja2

imported by: jinja2.utils

jinja2.debug SourceModule

imports: jinja2 • jinja2.exceptions • jinja2.runtime • jinja2.utils • sys • types • typing

imported by: jinja2.environment

jinja2.defaults SourceModule

imports: jinja2 • jinja2.filters • jinja2.tests • jinja2.utils • typing • typing_extensions

imported by: jinja2.environment • jinja2.ext

jinja2.environment SourceModule

imports: asyncio • collections • functools • jinja2 • jinja2.bccache • jinja2.compiler • jinja2.debug • jinja2.defaults • jinja2.exceptions • jinja2.ext • jinja2.lexer • jinja2.loaders • jinja2.nodes • jinja2.parser • jinja2.runtime • jinja2.utils • markupsafe • os • types • typing • typing_extensions • weakref • zipfile

imported by: jinja2 • jinja2.bccache • jinja2.compiler • jinja2.ext • jinja2.filters • jinja2.lexer • jinja2.loaders • jinja2.nodes • jinja2.optimizer • jinja2.parser • jinja2.runtime • jinja2.sandbox • jinja2.tests • jinja2.utils

jinja2.exceptions SourceModule

imports: jinja2 • jinja2.runtime • typing

imported by: jinja2 • jinja2.compiler • jinja2.debug • jinja2.environment • jinja2.ext • jinja2.filters • jinja2.lexer • jinja2.loaders • jinja2.parser • jinja2.runtime • jinja2.sandbox

jinja2.ext SourceModule

imports: gettext • jinja2 • jinja2.defaults • jinja2.environment • jinja2.exceptions • jinja2.lexer • jinja2.nodes • jinja2.parser • jinja2.runtime • jinja2.utils • markupsafe • pprint • re • typing • typing_extensions

imported by: jinja2 • jinja2.environment

jinja2.filters SourceModule

imports: collections • collections.abc • itertools • jinja2 • jinja2.async_utils • jinja2.environment • jinja2.exceptions • jinja2.nodes • jinja2.runtime • jinja2.sandbox • jinja2.utils • markupsafe • math • random • re • textwrap • typing • typing_extensions

imported by: jinja2.defaults

jinja2.idtracking SourceModule

imports: jinja2 • jinja2.nodes • jinja2.visitor • typing

imported by: jinja2.compiler

jinja2.lexer SourceModule

imports: ast • collections • jinja2 • jinja2._identifier • jinja2.environment • jinja2.exceptions • jinja2.utils • re • sys • typing • typing_extensions

imported by: jinja2.environment • jinja2.ext • jinja2.parser • jinja2.utils

jinja2.loaders SourceModule

imports: collections • collections.abc • hashlib • importlib • importlib.util • jinja2 • jinja2.environment • jinja2.exceptions • jinja2.utils • os • posixpath • sys • types • typing • weakref • zipimport

imported by: jinja2 • jinja2.environment

jinja2.nodes SourceModule

imports: collections • inspect • jinja2 • jinja2.compiler • jinja2.environment • jinja2.utils • markupsafe • operator • typing • typing_extensions

imported by: jinja2 • jinja2.compiler • jinja2.environment • jinja2.ext • jinja2.filters • jinja2.idtracking • jinja2.optimizer • jinja2.parser • jinja2.runtime • jinja2.visitor

jinja2.optimizer SourceModule

imports: jinja2 • jinja2.environment • jinja2.nodes • jinja2.visitor • typing

imported by: jinja2.compiler

jinja2.parser SourceModule

imports: jinja2 • jinja2.environment • jinja2.exceptions • jinja2.lexer • jinja2.nodes • typing • typing_extensions

imported by: jinja2.environment • jinja2.ext

jinja2.runtime SourceModule

imports: collections • collections.abc • functools • itertools • jinja2 • jinja2.async_utils • jinja2.environment • jinja2.exceptions • jinja2.nodes • jinja2.utils • logging • markupsafe • sys • typing • typing_extensions

imported by: jinja2 • jinja2.compiler • jinja2.debug • jinja2.environment • jinja2.exceptions • jinja2.ext • jinja2.filters • jinja2.sandbox • jinja2.tests • jinja2.utils

jinja2.sandbox SourceModule

imports: _string • collections • collections.abc • jinja2 • jinja2.environment • jinja2.exceptions • jinja2.runtime • markupsafe • operator • string • types • typing

imported by: jinja2.filters

jinja2.tests SourceModule

imports: collections • collections.abc • jinja2 • jinja2.environment • jinja2.runtime • jinja2.utils • numbers • operator • typing

imported by: jinja2.defaults

jinja2.utils SourceModule

imports: collections • collections.abc • enum • jinja2 • jinja2.constants • jinja2.environment • jinja2.lexer • jinja2.runtime • json • markupsafe • os • pprint • random • re • threading • types • typing • typing_extensions • urllib.parse

imported by: jinja2 • jinja2.async_utils • jinja2.compiler • jinja2.debug • jinja2.defaults • jinja2.environment • jinja2.ext • jinja2.filters • jinja2.lexer • jinja2.loaders • jinja2.nodes • jinja2.runtime • jinja2.tests

jinja2.visitor SourceModule

imports: jinja2 • jinja2.nodes • typing • typing_extensions

imported by: jinja2.compiler • jinja2.idtracking • jinja2.optimizer

jnius MissingModule

imported by: bleak.backends.p4android.client • bleak.backends.p4android.defs • bleak.backends.p4android.scanner • bleak.backends.p4android.utils

json Package

imports: codecs • json.decoder • json.encoder • json.scanner

imported by: dateutil.zoneinfo • jinja2.utils • json.decoder • json.encoder • json.scanner • matplotlib.backends.backend_webagg • matplotlib.backends.backend_webagg_core • matplotlib.font_manager • numpy._version

json.decoder SourceModule

imports: _json • json • json.scanner • re

imported by: _json • json

json.encoder SourceModule

imports: _json • json • re

imported by: json

json.scanner SourceModule

imports: _json • json • re

imported by: json • json.decoder

keyword SourceModule

imported by: collections • dataclasses • esp_controller.py • inspect • jinja2.compiler

kiwisolver Package

imports: kiwisolver._cext • kiwisolver.exceptions

imported by: kiwisolver._cext • kiwisolver.exceptions • matplotlib._layoutgrid

kiwisolver._cext C:\Users\Admin\myenv\Lib\site-packages\kiwisolver\_cext.cp311-win_amd64.pyd

imports: kiwisolver

imported by: kiwisolver

kiwisolver.exceptions SourceModule

imports: kiwisolver

imported by: kiwisolver

libdispatch MissingModule

imported by: bleak.backends.corebluetooth.CentralManagerDelegate

linecache SourceModule

imports: functools • os • sys • tokenize

imported by: asyncio.base_tasks • bdb • doctest • esp_controller.py • inspect • pdb • pkg_resources • traceback • tracemalloc • warnings

locale SourceModule

imports: _collections_abc • _locale • builtins • encodings • encodings.aliases • functools • os • re • sys • warnings

imported by: _pydecimal • _strptime • calendar • esp_controller.py • gettext • matplotlib • matplotlib.ticker • subprocess • tkinter.filedialog

logging Package

imports: atexit • collections.abc • io • os • pickle • re • string • sys • threading • time • traceback • types • warnings • weakref

imported by: PIL.Image • PIL.PcxImagePlugin • PIL.PngImagePlugin • PIL.PyAccess • PIL.TiffImagePlugin • asyncio.futures • asyncio.log • bleak • bleak.backends.bluezdbus.advertisement_monitor • bleak.backends.bluezdbus.client • bleak.backends.bluezdbus.manager • bleak.backends.bluezdbus.scanner • bleak.backends.bluezdbus.version • bleak.backends.corebluetooth.CentralManagerDelegate • bleak.backends.corebluetooth.PeripheralDelegate • bleak.backends.corebluetooth.client • bleak.backends.corebluetooth.scanner • bleak.backends.p4android.client • bleak.backends.p4android.scanner • bleak.backends.p4android.utils • bleak.backends.service • bleak.backends.winrt.client • bleak.backends.winrt.scanner • concurrent.futures._base • hashlib • http.cookiejar • jinja2.runtime • matplotlib • matplotlib._afm • matplotlib._constrained_layout • matplotlib._layoutgrid • matplotlib._mathtext • matplotlib.artist • matplotlib.axes._axes • matplotlib.axes._base • matplotlib.axis • matplotlib.backend_bases • matplotlib.backends._backend_tk • matplotlib.backends.backend_webagg_core • matplotlib.category • matplotlib.colorbar • matplotlib.dates • matplotlib.dviread • matplotlib.figure • matplotlib.font_manager • matplotlib.gridspec • matplotlib.image • matplotlib.legend • matplotlib.lines • matplotlib.mathtext • matplotlib.pyplot • matplotlib.style.core • matplotlib.texmanager • matplotlib.text • matplotlib.textpath • matplotlib.ticker • multiprocessing.util • packaging.tags • pkg_resources._vendor.packaging.tags • unittest._log

lzma SourceModule

imports: _compression • _lzma • builtins • io • os

imported by: numpy.lib._datasource • shutil • tarfile • zipfile

markupsafe Package

imports: functools • html • markupsafe • markupsafe._native • markupsafe._speedups • re • string • sys • typing • typing_extensions

imported by: jinja2.compiler • jinja2.environment • jinja2.ext • jinja2.filters • jinja2.nodes • jinja2.runtime • jinja2.sandbox • jinja2.utils • markupsafe • markupsafe._native • markupsafe._speedups

markupsafe._native SourceModule

imports: markupsafe • typing

imported by: markupsafe

markupsafe._speedups C:\Users\Admin\myenv\Lib\site-packages\markupsafe\_speedups.cp311-win_amd64.pyd

imports: markupsafe

imported by: markupsafe

marshal (builtin module)

imported by: importlib._bootstrap_external • jinja2.bccache • pkgutil • zipimport

math (builtin module)

imported by: PIL.FitsImagePlugin • PIL.GifImagePlugin • PIL.GimpGradientFile • PIL.IcoImagePlugin • PIL.Image • PIL.JpegImagePlugin • PIL.PdfImagePlugin • PIL.TiffImagePlugin • _pydecimal • asyncio.windows_events • contourpy.chunk • datetime • dateutil.relativedelta • dateutil.rrule • fractions • jinja2.filters • matplotlib._api.deprecation • matplotlib.axes._axes • matplotlib.backends._backend_tk • matplotlib.backends.backend_agg • matplotlib.bezier • matplotlib.cbook • matplotlib.collections • matplotlib.contour • matplotlib.image • matplotlib.patches • matplotlib.projections.polar • matplotlib.quiver • matplotlib.text • matplotlib.ticker • matplotlib.transforms • mpl_toolkits.mplot3d.art3d • mpl_toolkits.mplot3d.axes3d • numpy • numpy.core._machar • numpy.lib • numpy.lib.index_tricks • pkg_resources._vendor.more_itertools.more • random • selectors • statistics

matplotlib Package

imports: atexit • certifi • collections • collections.abc • contextlib • functools • importlib • inspect • locale • logging • matplotlib • matplotlib._afm • matplotlib._api • matplotlib._blocking_input • matplotlib._c_internal_utils • matplotlib._cm • matplotlib._docstring • matplotlib._image • matplotlib._mathtext • matplotlib._qhull • matplotlib._text_helpers • matplotlib._tight_bbox • matplotlib._tri • matplotlib._version • matplotlib.axes • matplotlib.backend_tools • matplotlib.cbook • matplotlib.cm • matplotlib.collections • matplotlib.colors • matplotlib.dviread • matplotlib.font_manager • matplotlib.ft2font • matplotlib.legend_handler • matplotlib.lines • matplotlib.offsetbox • matplotlib.projections • matplotlib.pyplot • matplotlib.rcsetup • matplotlib.scale • matplotlib.style • matplotlib.style.core • matplotlib.text • matplotlib.ticker • matplotlib.transforms • matplotlib.widgets • numpy • os • packaging.version • pathlib • pprint • re • setuptools_scm • shutil • ssl • subprocess • sys • tempfile • urllib.request • warnings • winreg

imported by: matplotlib • matplotlib._afm • matplotlib._api • matplotlib._blocking_input • matplotlib._c_internal_utils • matplotlib._cm • matplotlib._cm_listed • matplotlib._color_data • matplotlib._constrained_layout • matplotlib._docstring • matplotlib._enums • matplotlib._fontconfig_pattern • matplotlib._image • matplotlib._layoutgrid • matplotlib._mathtext • matplotlib._mathtext_data • matplotlib._path • matplotlib._pylab_helpers • matplotlib._qhull • matplotlib._text_helpers • matplotlib._tight_bbox • matplotlib._tight_layout • matplotlib._tri • matplotlib._version • matplotlib.artist • matplotlib.axes • matplotlib.axes._axes • matplotlib.axes._base • matplotlib.axes._secondary_axes • matplotlib.axis • matplotlib.backend_bases • matplotlib.backend_managers • matplotlib.backend_tools • matplotlib.backends • matplotlib.backends._backend_tk • matplotlib.backends.backend_agg • matplotlib.backends.backend_webagg • matplotlib.backends.backend_webagg_core • matplotlib.bezier • matplotlib.category • matplotlib.cbook • matplotlib.cm • matplotlib.collections • matplotlib.colorbar • matplotlib.colors • matplotlib.container • matplotlib.contour • matplotlib.dates • matplotlib.dviread • matplotlib.figure • matplotlib.font_manager • matplotlib.ft2font • matplotlib.gridspec • matplotlib.hatch • matplotlib.image • matplotlib.layout_engine • matplotlib.legend • matplotlib.legend_handler • matplotlib.lines • matplotlib.markers • matplotlib.mathtext • matplotlib.mlab • matplotlib.offsetbox • matplotlib.patches • matplotlib.path • matplotlib.patheffects • matplotlib.projections • matplotlib.projections.geo • matplotlib.projections.polar • matplotlib.pyplot • matplotlib.quiver • matplotlib.rcsetup • matplotlib.scale • matplotlib.spines • matplotlib.stackplot • matplotlib.streamplot • matplotlib.style • matplotlib.style.core • matplotlib.table • matplotlib.texmanager • matplotlib.text • matplotlib.textpath • matplotlib.ticker • matplotlib.transforms • matplotlib.tri • matplotlib.tri._triangulation • matplotlib.tri._tricontour • matplotlib.tri._trifinder • matplotlib.tri._triinterpolate • matplotlib.tri._tripcolor • matplotlib.tri._trirefine • matplotlib.tri._tritools • matplotlib.typing • matplotlib.units • matplotlib.widgets • mpl_toolkits.mplot3d.art3d • mpl_toolkits.mplot3d.axes3d • mpl_toolkits.mplot3d.axis3d • mpl_toolkits.mplot3d.proj3d

matplotlib._afm SourceModule

imports: collections • logging • matplotlib • matplotlib._mathtext_data • re

imported by: matplotlib • matplotlib.font_manager

matplotlib._api Package

imports: functools • itertools • matplotlib • matplotlib._api • matplotlib._api.deprecation • re • sys • warnings

imported by: matplotlib • matplotlib._api • matplotlib._api.deprecation • matplotlib._constrained_layout • matplotlib._docstring • matplotlib._fontconfig_pattern • matplotlib._text_helpers • matplotlib._tight_layout • matplotlib.artist • matplotlib.axes._axes • matplotlib.axes._base • matplotlib.axes._secondary_axes • matplotlib.axis • matplotlib.backend_bases • matplotlib.backend_managers • matplotlib.backend_tools • matplotlib.backends._backend_tk • matplotlib.backends.backend_agg • matplotlib.backends.backend_webagg_core • matplotlib.bezier • matplotlib.category • matplotlib.cbook • matplotlib.cm • matplotlib.collections • matplotlib.colorbar • matplotlib.colors • matplotlib.contour • matplotlib.dates • matplotlib.dviread • matplotlib.figure • matplotlib.font_manager • matplotlib.gridspec • matplotlib.hatch • matplotlib.image • matplotlib.legend • matplotlib.lines • matplotlib.markers • matplotlib.mathtext • matplotlib.mlab • matplotlib.offsetbox • matplotlib.patches • matplotlib.path • matplotlib.projections.geo • matplotlib.projections.polar • matplotlib.pyplot • matplotlib.quiver • matplotlib.rcsetup • matplotlib.scale • matplotlib.spines • matplotlib.stackplot • matplotlib.streamplot • matplotlib.style.core • matplotlib.table • matplotlib.texmanager • matplotlib.text • matplotlib.ticker • matplotlib.transforms • matplotlib.tri._triangulation • matplotlib.tri._trifinder • matplotlib.tri._triinterpolate • matplotlib.tri._tripcolor • matplotlib.tri._trirefine • matplotlib.tri._tritools • matplotlib.widgets • mpl_toolkits.mplot3d.axes3d • mpl_toolkits.mplot3d.axis3d • mpl_toolkits.mplot3d.proj3d

matplotlib._api.deprecation SourceModule

imports: contextlib • functools • inspect • math • matplotlib._api • warnings

imported by: matplotlib._api

matplotlib._blocking_input SourceModule

imports: matplotlib

imported by: matplotlib • matplotlib.figure

matplotlib._c_internal_utils C:\Users\Admin\myenv\Lib\site-packages\matplotlib\_c_internal_utils.cp311-win_amd64.pyd

imports: matplotlib

imported by: matplotlib • matplotlib.backends._backend_tk • matplotlib.cbook

matplotlib._cm SourceModule

imports: functools • matplotlib • numpy

imported by: matplotlib • matplotlib.cm • matplotlib.colors

matplotlib._cm_listed SourceModule

imports: matplotlib • matplotlib.colors

imported by: matplotlib.cm

matplotlib._color_data SourceModule

imports: matplotlib

imported by: matplotlib.colors

matplotlib._constrained_layout SourceModule

imports: logging • matplotlib • matplotlib._api • matplotlib._layoutgrid • matplotlib.artist • matplotlib.transforms • numpy

imported by: matplotlib.layout_engine

matplotlib._docstring SourceModule

imports: inspect • matplotlib • matplotlib._api • matplotlib.artist

imported by: matplotlib • matplotlib._enums • matplotlib.axes._axes • matplotlib.axes._base • matplotlib.axes._secondary_axes • matplotlib.backend_bases • matplotlib.collections • matplotlib.colorbar • matplotlib.contour • matplotlib.figure • matplotlib.legend • matplotlib.lines • matplotlib.mlab • matplotlib.offsetbox • matplotlib.patches • matplotlib.projections • matplotlib.pyplot • matplotlib.quiver • matplotlib.scale • matplotlib.spines • matplotlib.style.core • matplotlib.table • matplotlib.text • matplotlib.tri._tricontour • matplotlib.widgets • mpl_toolkits.mplot3d.axes3d

matplotlib._enums SourceModule

imports: enum • matplotlib • matplotlib._docstring • matplotlib.pyplot • numpy

imported by: matplotlib.backend_bases • matplotlib.collections • matplotlib.lines • matplotlib.markers • matplotlib.patches • matplotlib.rcsetup • matplotlib.typing

matplotlib._fontconfig_pattern SourceModule

imports: functools • matplotlib • matplotlib._api • pyparsing • re

imported by: matplotlib.font_manager • matplotlib.rcsetup

matplotlib._image C:\Users\Admin\myenv\Lib\site-packages\matplotlib\_image.cp311-win_amd64.pyd

imports: matplotlib

imported by: matplotlib • matplotlib.image

matplotlib._layoutgrid SourceModule

imports: itertools • kiwisolver • logging • matplotlib • matplotlib.patches • matplotlib.transforms • numpy

imported by: matplotlib._constrained_layout

matplotlib._mathtext SourceModule

imports: __future__ • abc • collections.abc • copy • enum • functools • logging • matplotlib • matplotlib._mathtext_data • matplotlib.cbook • matplotlib.font_manager • matplotlib.ft2font • numpy • os • packaging.version • pyparsing • re • string • types • typing • unicodedata

imported by: matplotlib • matplotlib.mathtext

matplotlib._mathtext_data SourceModule

imports: __future__ • matplotlib

imported by: matplotlib._afm • matplotlib._mathtext

matplotlib._path C:\Users\Admin\myenv\Lib\site-packages\matplotlib\_path.cp311-win_amd64.pyd

imports: matplotlib

imported by: matplotlib.collections • matplotlib.lines • matplotlib.path • matplotlib.transforms

matplotlib._pylab_helpers SourceModule

imports: atexit • collections • matplotlib

imported by: matplotlib.backend_bases • matplotlib.backend_tools • matplotlib.backends._backend_tk • matplotlib.backends.backend_webagg • matplotlib.figure • matplotlib.gridspec • matplotlib.pyplot

matplotlib._qhull C:\Users\Admin\myenv\Lib\site-packages\matplotlib\_qhull.cp311-win_amd64.pyd

imports: matplotlib

imported by: matplotlib • matplotlib.tri._triangulation

matplotlib._text_helpers SourceModule

imports: dataclasses • matplotlib • matplotlib._api • matplotlib.ft2font

imported by: matplotlib • matplotlib.textpath

matplotlib._tight_bbox SourceModule

imports: matplotlib • matplotlib.transforms

imported by: matplotlib • matplotlib.backend_bases

matplotlib._tight_layout SourceModule

imports: matplotlib • matplotlib._api • matplotlib.artist • matplotlib.font_manager • matplotlib.transforms • numpy

imported by: matplotlib.gridspec • matplotlib.layout_engine

matplotlib._tri C:\Users\Admin\myenv\Lib\site-packages\matplotlib\_tri.cp311-win_amd64.pyd

imports: matplotlib

imported by: matplotlib • matplotlib.tri._triangulation • matplotlib.tri._tricontour • matplotlib.tri._trifinder

matplotlib._version SourceModule

imports: matplotlib • typing

imported by: matplotlib

matplotlib.artist SourceModule

imports: collections • contextlib • functools • inspect • logging • matplotlib • matplotlib._api • matplotlib.backend_bases • matplotlib.cbook • matplotlib.cm • matplotlib.colors • matplotlib.patches • matplotlib.path • matplotlib.transforms • numbers • numpy • re • warnings

imported by: matplotlib._constrained_layout • matplotlib._docstring • matplotlib._tight_layout • matplotlib.axes._base • matplotlib.axis • matplotlib.cbook • matplotlib.collections • matplotlib.colorbar • matplotlib.container • matplotlib.figure • matplotlib.image • matplotlib.legend • matplotlib.lines • matplotlib.offsetbox • matplotlib.patches • matplotlib.pyplot • matplotlib.quiver • matplotlib.spines • matplotlib.table • matplotlib.text • mpl_toolkits.mplot3d.art3d • mpl_toolkits.mplot3d.axes3d • mpl_toolkits.mplot3d.axis3d

matplotlib.axes Package

imports: matplotlib • matplotlib.axes • matplotlib.axes.Axes • matplotlib.axes._axes • matplotlib.axes._base

imported by: matplotlib • matplotlib.axes • matplotlib.axes._axes • matplotlib.axes._base • matplotlib.axes._secondary_axes • matplotlib.figure • matplotlib.legend • matplotlib.projections • matplotlib.projections.geo • matplotlib.projections.polar • matplotlib.pyplot • matplotlib.tri._triplot • mpl_toolkits.mplot3d.axes3d

matplotlib.axes.Axes MissingModule

imported by: matplotlib.axes • matplotlib.figure • matplotlib.legend • matplotlib.projections.geo • matplotlib.projections.polar • matplotlib.pyplot • mpl_toolkits.mplot3d.axes3d

matplotlib.axes._axes SourceModule

imports: builtins • functools • itertools • logging • math • matplotlib • matplotlib._api • matplotlib._docstring • matplotlib.axes • matplotlib.axes._base • matplotlib.axes._secondary_axes • matplotlib.category • matplotlib.cbook • matplotlib.collections • matplotlib.colors • matplotlib.container • matplotlib.contour • matplotlib.dates • matplotlib.image • matplotlib.legend • matplotlib.lines • matplotlib.markers • matplotlib.mlab • matplotlib.patches • matplotlib.path • matplotlib.quiver • matplotlib.stackplot • matplotlib.streamplot • matplotlib.table • matplotlib.text • matplotlib.ticker • matplotlib.transforms • matplotlib.tri • matplotlib.units • numbers • numpy • numpy.ma

imported by: matplotlib.axes

matplotlib.axes._base SourceModule

imports: collections.abc • contextlib • functools • inspect • logging • matplotlib • matplotlib._api • matplotlib._docstring • matplotlib.artist • matplotlib.axes • matplotlib.axis • matplotlib.cbook • matplotlib.collections • matplotlib.colors • matplotlib.font_manager • matplotlib.gridspec • matplotlib.image • matplotlib.lines • matplotlib.offsetbox • matplotlib.patches • matplotlib.rcsetup • matplotlib.spines • matplotlib.table • matplotlib.text • matplotlib.ticker • matplotlib.transforms • numbers • numpy • operator • types

imported by: matplotlib.axes • matplotlib.axes._axes • matplotlib.axes._secondary_axes • matplotlib.pyplot • mpl_toolkits.mplot3d.axes3d

matplotlib.axes._secondary_axes SourceModule

imports: matplotlib • matplotlib._api • matplotlib._docstring • matplotlib.axes • matplotlib.axes._base • matplotlib.axis • matplotlib.ticker • numbers • numpy

imported by: matplotlib.axes._axes

matplotlib.axis SourceModule

imports: datetime • dateutil.tz • functools • logging • matplotlib • matplotlib._api • matplotlib.artist • matplotlib.cbook • matplotlib.colors • matplotlib.lines • matplotlib.scale • matplotlib.text • matplotlib.ticker • matplotlib.transforms • matplotlib.units • numbers • numpy • warnings

imported by: matplotlib.axes._base • matplotlib.axes._secondary_axes • matplotlib.projections.geo • matplotlib.projections.polar • matplotlib.pyplot • mpl_toolkits.mplot3d.axis3d

matplotlib.backend_bases SourceModule

imports: 'IPython.core' • IPython • collections • contextlib • enum • functools • importlib • inspect • io • itertools • logging • matplotlib • matplotlib._api • matplotlib._docstring • matplotlib._enums • matplotlib._pylab_helpers • matplotlib._tight_bbox • matplotlib.backend_managers • matplotlib.backend_tools • matplotlib.cbook • matplotlib.collections • matplotlib.colors • matplotlib.figure • matplotlib.layout_engine • matplotlib.path • matplotlib.pyplot • matplotlib.texmanager • matplotlib.text • matplotlib.transforms • matplotlib.widgets • numpy • os • sys • time • weakref

imported by: matplotlib.artist • matplotlib.backend_tools • matplotlib.backends._backend_tk • matplotlib.backends.backend_agg • matplotlib.backends.backend_webagg • matplotlib.backends.backend_webagg_core • matplotlib.contour • matplotlib.figure • matplotlib.image • matplotlib.patheffects • matplotlib.pyplot

matplotlib.backend_managers SourceModule

imports: matplotlib • matplotlib._api • matplotlib.backend_tools • matplotlib.cbook • matplotlib.widgets

imported by: matplotlib.backend_bases

matplotlib.backend_tools SourceModule

imports: enum • functools • matplotlib • matplotlib._api • matplotlib._pylab_helpers • matplotlib.backend_bases • matplotlib.cbook • numpy • re • time • types • uuid • weakref

imported by: matplotlib • matplotlib.backend_bases • matplotlib.backend_managers • matplotlib.backends._backend_tk • matplotlib.backends.backend_webagg_core • matplotlib.widgets

matplotlib.backends Package

imports: matplotlib • matplotlib.backends • matplotlib.backends._backend_tk • matplotlib.backends._tkagg • matplotlib.backends.backend_agg • matplotlib.backends.backend_tkagg • matplotlib.backends.backend_webagg • matplotlib.backends.backend_webagg_core

imported by: matplotlib.backends • matplotlib.backends._backend_agg • matplotlib.backends._backend_tk • matplotlib.backends._tkagg • matplotlib.backends.backend_agg • matplotlib.backends.backend_tkagg • matplotlib.backends.backend_webagg • matplotlib.backends.backend_webagg_core • matplotlib.figure • matplotlib.mathtext • matplotlib.pyplot

matplotlib.backends._backend_agg C:\Users\Admin\myenv\Lib\site-packages\matplotlib\backends\_backend_agg.cp311-win_amd64.pyd

imports: matplotlib.backends

imported by: matplotlib.backends.backend_agg

matplotlib.backends._backend_tk SourceModule

imports: PIL • PIL.Image • PIL.ImageTk • contextlib • logging • math • matplotlib • matplotlib._api • matplotlib._c_internal_utils • matplotlib._pylab_helpers • matplotlib.backend_bases • matplotlib.backend_tools • matplotlib.backends • matplotlib.backends._tkagg • matplotlib.cbook • ntpath • numpy • pathlib • sys • tkinter • tkinter.filedialog • tkinter.font • tkinter.messagebox • tkinter.simpledialog • uuid • weakref

imported by: matplotlib.backends • matplotlib.backends.backend_tkagg

matplotlib.backends._tkagg C:\Users\Admin\myenv\Lib\site-packages\matplotlib\backends\_tkagg.cp311-win_amd64.pyd

imports: matplotlib.backends

imported by: matplotlib.backends • matplotlib.backends._backend_tk

matplotlib.backends.backend_agg SourceModule

imports: contextlib • math • matplotlib • matplotlib._api • matplotlib.backend_bases • matplotlib.backends • matplotlib.backends._backend_agg • matplotlib.cbook • matplotlib.font_manager • matplotlib.ft2font • matplotlib.mathtext • matplotlib.path • matplotlib.transforms • numpy

imported by: matplotlib.backends • matplotlib.backends.backend_tkagg • matplotlib.backends.backend_webagg_core • matplotlib.mathtext

matplotlib.backends.backend_tkagg SourceModule

imports: matplotlib.backends • matplotlib.backends._backend_tk • matplotlib.backends.backend_agg

imported by: esp_controller.py • matplotlib.backends

matplotlib.backends.backend_webagg SourceModule

imports: 'tornado.ioloop' • 'tornado.template' • 'tornado.web' • 'tornado.websocket' • asyncio • contextlib • errno • io • json • matplotlib • matplotlib._pylab_helpers • matplotlib.backend_bases • matplotlib.backends • matplotlib.backends.backend_webagg_core • mimetypes • pathlib • random • signal • sys • threading • tornado • webbrowser

imported by: matplotlib.backends • matplotlib.figure

matplotlib.backends.backend_webagg_core SourceModule

imports: PIL • PIL.Image • asyncio • datetime • io • json • logging • matplotlib • matplotlib._api • matplotlib.backend_bases • matplotlib.backend_tools • matplotlib.backends • matplotlib.backends.backend_agg • matplotlib.pyplot • numpy • os • pathlib • tornado

imported by: matplotlib.backends • matplotlib.backends.backend_webagg

matplotlib.bezier SourceModule

imports: functools • math • matplotlib • matplotlib._api • matplotlib.path • numpy • warnings

imported by: matplotlib.patches • matplotlib.path

matplotlib.category SourceModule

imports: collections • dateutil.parser • itertools • logging • matplotlib • matplotlib._api • matplotlib.ticker • matplotlib.units • numpy

imported by: matplotlib.axes._axes

matplotlib.cbook SourceModule

imports: bz2 • collections • collections.abc • contextlib • functools • gc • gi • gzip • itertools • math • matplotlib • matplotlib._api • matplotlib._c_internal_utils • matplotlib.artist • numpy • numpy.exceptions • operator • os • pathlib • shlex • subprocess • sys • time • traceback • types • weakref

imported by: matplotlib • matplotlib._mathtext • matplotlib.artist • matplotlib.axes._axes • matplotlib.axes._base • matplotlib.axis • matplotlib.backend_bases • matplotlib.backend_managers • matplotlib.backend_tools • matplotlib.backends._backend_tk • matplotlib.backends.backend_agg • matplotlib.cm • matplotlib.collections • matplotlib.colorbar • matplotlib.colors • matplotlib.container • matplotlib.contour • matplotlib.dates • matplotlib.dviread • matplotlib.figure • matplotlib.font_manager • matplotlib.image • matplotlib.legend • matplotlib.legend_handler • matplotlib.lines • matplotlib.markers • matplotlib.mlab • matplotlib.patches • matplotlib.path • matplotlib.projections.polar • matplotlib.pyplot • matplotlib.quiver • matplotlib.rcsetup • matplotlib.texmanager • matplotlib.text • matplotlib.ticker • matplotlib.tri._triplot • matplotlib.units • matplotlib.widgets • mpl_toolkits.mplot3d.art3d • mpl_toolkits.mplot3d.axes3d

matplotlib.cm SourceModule

imports: collections.abc • functools • matplotlib • matplotlib._api • matplotlib._cm • matplotlib._cm_listed • matplotlib.cbook • matplotlib.colors • matplotlib.scale • numpy • numpy.ma

imported by: matplotlib • matplotlib.artist • matplotlib.collections • matplotlib.colorbar • matplotlib.contour • matplotlib.image • matplotlib.pyplot • matplotlib.streamplot

matplotlib.collections SourceModule

imports: itertools • math • matplotlib • matplotlib._api • matplotlib._docstring • matplotlib._enums • matplotlib._path • matplotlib.artist • matplotlib.cbook • matplotlib.cm • matplotlib.colors • matplotlib.hatch • matplotlib.lines • matplotlib.path • matplotlib.patheffects • matplotlib.transforms • numbers • numpy • warnings

imported by: matplotlib • matplotlib.axes._axes • matplotlib.axes._base • matplotlib.backend_bases • matplotlib.colorbar • matplotlib.contour • matplotlib.legend • matplotlib.legend_handler • matplotlib.pyplot • matplotlib.quiver • matplotlib.streamplot • matplotlib.tri._tripcolor • matplotlib.widgets • mpl_toolkits.mplot3d.art3d • mpl_toolkits.mplot3d.axes3d

matplotlib.colorbar SourceModule

imports: logging • matplotlib • matplotlib._api • matplotlib._docstring • matplotlib.artist • matplotlib.cbook • matplotlib.cm • matplotlib.collections • matplotlib.colors • matplotlib.contour • matplotlib.patches • matplotlib.path • matplotlib.spines • matplotlib.ticker • matplotlib.transforms • numpy

imported by: matplotlib.figure • matplotlib.pyplot

matplotlib.colors SourceModule

imports: PIL • PIL.Image • PIL.PngImagePlugin • base64 • collections.abc • functools • importlib • inspect • io • itertools • matplotlib • matplotlib._api • matplotlib._cm • matplotlib._color_data • matplotlib.cbook • matplotlib.scale • numbers • numpy • re

imported by: matplotlib • matplotlib._cm_listed • matplotlib.artist • matplotlib.axes._axes • matplotlib.axes._base • matplotlib.axis • matplotlib.backend_bases • matplotlib.cm • matplotlib.collections • matplotlib.colorbar • matplotlib.contour • matplotlib.image • matplotlib.legend • matplotlib.lines • matplotlib.patches • matplotlib.patheffects • matplotlib.pyplot • matplotlib.rcsetup • matplotlib.streamplot • matplotlib.widgets • mpl_toolkits.mplot3d.art3d • mpl_toolkits.mplot3d.axes3d • mpl_toolkits.mplot3d.axis3d

matplotlib.container SourceModule

imports: matplotlib • matplotlib.artist • matplotlib.cbook

imported by: matplotlib.axes._axes • matplotlib.legend • matplotlib.pyplot • mpl_toolkits.mplot3d.axes3d

matplotlib.contour SourceModule

imports: contextlib • contourpy • functools • math • matplotlib • matplotlib._api • matplotlib._docstring • matplotlib.backend_bases • matplotlib.cbook • matplotlib.cm • matplotlib.collections • matplotlib.colors • matplotlib.font_manager • matplotlib.lines • matplotlib.patches • matplotlib.path • matplotlib.text • matplotlib.ticker • matplotlib.transforms • numbers • numpy • numpy.ma

imported by: matplotlib.axes._axes • matplotlib.colorbar • matplotlib.pyplot • matplotlib.tri._tricontour

matplotlib.dates SourceModule

imports: datetime • dateutil.parser • dateutil.relativedelta • dateutil.rrule • dateutil.tz • functools • logging • matplotlib • matplotlib._api • matplotlib.cbook • matplotlib.ticker • matplotlib.units • numpy • re

imported by: matplotlib.axes._axes

matplotlib.dviread SourceModule

imports: argparse • collections • enum • functools • itertools • logging • matplotlib • matplotlib._api • matplotlib.cbook • numpy • os • pathlib • re • struct • subprocess • sys

imported by: matplotlib • matplotlib.texmanager • matplotlib.textpath

matplotlib.figure SourceModule

imports: contextlib • inspect • itertools • logging • matplotlib • matplotlib._api • matplotlib._blocking_input • matplotlib._docstring • matplotlib._pylab_helpers • matplotlib.artist • matplotlib.axes • matplotlib.axes.Axes • matplotlib.backend_bases • matplotlib.backends • matplotlib.backends.backend_webagg • matplotlib.cbook • matplotlib.colorbar • matplotlib.gridspec • matplotlib.image • matplotlib.layout_engine • matplotlib.legend • matplotlib.patches • matplotlib.projections • matplotlib.pyplot • matplotlib.text • matplotlib.transforms • numbers • numpy • threading

imported by: esp_controller.py • matplotlib.backend_bases • matplotlib.font_manager • matplotlib.image • matplotlib.legend • matplotlib.mathtext • matplotlib.pyplot

matplotlib.font_manager SourceModule

imports: base64 • collections • copy • dataclasses • functools • io • json • logging • matplotlib • matplotlib._afm • matplotlib._api • matplotlib._fontconfig_pattern • matplotlib.cbook • matplotlib.figure • matplotlib.ft2font • matplotlib.rcsetup • numbers • os • pathlib • re • subprocess • sys • threading • typing • winreg

imported by: matplotlib • matplotlib._mathtext • matplotlib._tight_layout • matplotlib.axes._base • matplotlib.backends.backend_agg • matplotlib.contour • matplotlib.legend • matplotlib.mathtext • matplotlib.offsetbox • matplotlib.text • matplotlib.textpath • matplotlib.ticker

matplotlib.ft2font C:\Users\Admin\myenv\Lib\site-packages\matplotlib\ft2font.cp311-win_amd64.pyd

imports: matplotlib

imported by: matplotlib • matplotlib._mathtext • matplotlib._text_helpers • matplotlib.backends.backend_agg • matplotlib.font_manager • matplotlib.mathtext • matplotlib.textpath

matplotlib.gridspec SourceModule

imports: copy • logging • matplotlib • matplotlib._api • matplotlib._pylab_helpers • matplotlib._tight_layout • matplotlib.transforms • numbers • numpy

imported by: matplotlib.axes._base • matplotlib.figure • matplotlib.pyplot

matplotlib.hatch SourceModule

imports: matplotlib • matplotlib._api • matplotlib.path • numpy

imported by: matplotlib.collections • matplotlib.patches • matplotlib.path

matplotlib.image SourceModule

imports: PIL.Image • PIL.PngImagePlugin • logging • math • matplotlib • matplotlib._api • matplotlib._image • matplotlib.artist • matplotlib.backend_bases • matplotlib.cbook • matplotlib.cm • matplotlib.colors • matplotlib.figure • matplotlib.pyplot • matplotlib.transforms • numpy • os • pathlib • urllib • urllib.parse • warnings

imported by: matplotlib.axes._axes • matplotlib.axes._base • matplotlib.figure • matplotlib.offsetbox • matplotlib.pyplot • mpl_toolkits.mplot3d.axes3d

matplotlib.layout_engine SourceModule

imports: contextlib • matplotlib • matplotlib._constrained_layout • matplotlib._tight_layout

imported by: matplotlib.backend_bases • matplotlib.figure

matplotlib.legend SourceModule

imports: itertools • logging • matplotlib • matplotlib._api • matplotlib._docstring • matplotlib.artist • matplotlib.axes • matplotlib.axes.Axes • matplotlib.cbook • matplotlib.collections • matplotlib.colors • matplotlib.container • matplotlib.figure • matplotlib.font_manager • matplotlib.legend_handler • matplotlib.lines • matplotlib.offsetbox • matplotlib.patches • matplotlib.text • matplotlib.transforms • numbers • numpy • time

imported by: matplotlib.axes._axes • matplotlib.figure • matplotlib.pyplot

matplotlib.legend_handler SourceModule

imports: itertools • matplotlib • matplotlib.cbook • matplotlib.collections • matplotlib.lines • matplotlib.patches • numpy

imported by: matplotlib • matplotlib.legend

matplotlib.lines SourceModule

imports: copy • logging • matplotlib • matplotlib._api • matplotlib._docstring • matplotlib._enums • matplotlib._path • matplotlib.artist • matplotlib.cbook • matplotlib.colors • matplotlib.markers • matplotlib.path • matplotlib.patheffects • matplotlib.transforms • numbers • numpy

imported by: matplotlib • matplotlib.axes._axes • matplotlib.axes._base • matplotlib.axis • matplotlib.collections • matplotlib.contour • matplotlib.legend • matplotlib.legend_handler • matplotlib.patches • matplotlib.pyplot • matplotlib.streamplot • matplotlib.tri._triplot • matplotlib.widgets • mpl_toolkits.mplot3d.art3d • mpl_toolkits.mplot3d.axes3d • mpl_toolkits.mplot3d.axis3d

matplotlib.markers SourceModule

imports: collections.abc • copy • matplotlib • matplotlib._api • matplotlib._enums • matplotlib.cbook • matplotlib.path • matplotlib.text • matplotlib.transforms • numpy

imported by: matplotlib.axes._axes • matplotlib.lines • matplotlib.projections.polar • matplotlib.typing

matplotlib.mathtext SourceModule

imports: functools • logging • matplotlib • matplotlib._api • matplotlib._mathtext • matplotlib.backends • matplotlib.backends.backend_agg • matplotlib.figure • matplotlib.font_manager • matplotlib.ft2font

imported by: matplotlib.backends.backend_agg • matplotlib.textpath

matplotlib.mlab SourceModule

imports: functools • matplotlib • matplotlib._api • matplotlib._docstring • matplotlib.cbook • numbers • numpy

imported by: matplotlib.axes._axes • matplotlib.pyplot

matplotlib.offsetbox SourceModule

imports: functools • matplotlib • matplotlib._api • matplotlib._docstring • matplotlib.artist • matplotlib.font_manager • matplotlib.image • matplotlib.patches • matplotlib.path • matplotlib.text • matplotlib.transforms • numpy

imported by: matplotlib • matplotlib.axes._base • matplotlib.legend • matplotlib.text

matplotlib.patches SourceModule

imports: collections • functools • inspect • math • matplotlib • matplotlib._api • matplotlib._docstring • matplotlib._enums • matplotlib.artist • matplotlib.bezier • matplotlib.cbook • matplotlib.colors • matplotlib.hatch • matplotlib.lines • matplotlib.path • matplotlib.patheffects • matplotlib.transforms • numbers • numpy • textwrap • types

imported by: matplotlib._layoutgrid • matplotlib.artist • matplotlib.axes._axes • matplotlib.axes._base • matplotlib.colorbar • matplotlib.contour • matplotlib.figure • matplotlib.legend • matplotlib.legend_handler • matplotlib.offsetbox • matplotlib.patheffects • matplotlib.projections.geo • matplotlib.projections.polar • matplotlib.pyplot • matplotlib.quiver • matplotlib.spines • matplotlib.streamplot • matplotlib.table • matplotlib.text • matplotlib.widgets • mpl_toolkits.mplot3d.art3d • mpl_toolkits.mplot3d.axes3d • mpl_toolkits.mplot3d.axis3d

matplotlib.path SourceModule

imports: copy • functools • matplotlib • matplotlib._api • matplotlib._path • matplotlib.bezier • matplotlib.cbook • matplotlib.hatch • matplotlib.transforms • numpy • weakref

imported by: matplotlib.artist • matplotlib.axes._axes • matplotlib.backend_bases • matplotlib.backends.backend_agg • matplotlib.bezier • matplotlib.collections • matplotlib.colorbar • matplotlib.contour • matplotlib.hatch • matplotlib.lines • matplotlib.markers • matplotlib.offsetbox • matplotlib.patches • matplotlib.patheffects • matplotlib.projections.geo • matplotlib.projections.polar • matplotlib.spines • matplotlib.table • matplotlib.textpath • matplotlib.transforms • matplotlib.typing • mpl_toolkits.mplot3d.art3d

matplotlib.patheffects SourceModule

imports: matplotlib • matplotlib.backend_bases • matplotlib.colors • matplotlib.patches • matplotlib.path • matplotlib.transforms • numpy

imported by: matplotlib.collections • matplotlib.lines • matplotlib.patches • matplotlib.pyplot • matplotlib.text

matplotlib.projections Package

imports: matplotlib • matplotlib._docstring • matplotlib.axes • matplotlib.projections.geo • matplotlib.projections.polar • mpl_toolkits.mplot3d • warnings

imported by: matplotlib • matplotlib.figure • matplotlib.projections.geo • matplotlib.projections.polar • matplotlib.pyplot • matplotlib.text

matplotlib.projections.geo SourceModule

imports: matplotlib • matplotlib._api • matplotlib.axes • matplotlib.axes.Axes • matplotlib.axis • matplotlib.patches • matplotlib.path • matplotlib.projections • matplotlib.spines • matplotlib.ticker • matplotlib.transforms • numpy

imported by: matplotlib.projections

matplotlib.projections.polar SourceModule

imports: math • matplotlib • matplotlib._api • matplotlib.axes • matplotlib.axes.Axes • matplotlib.axis • matplotlib.cbook • matplotlib.markers • matplotlib.patches • matplotlib.path • matplotlib.projections • matplotlib.spines • matplotlib.ticker • matplotlib.transforms • numpy • types

imported by: matplotlib.projections

matplotlib.pyplot SourceModule

imports: 'IPython.core' • IPython • PIL.Image • __future__ • collections.abc • contextlib • cycler • datetime • enum • functools • importlib • inspect • logging • matplotlib • matplotlib._api • matplotlib._docstring • matplotlib._pylab_helpers • matplotlib.artist • matplotlib.axes • matplotlib.axes.Axes • matplotlib.axes._base • matplotlib.axis • matplotlib.backend_bases • matplotlib.backends • matplotlib.cbook • matplotlib.cm • matplotlib.collections • matplotlib.colorbar • matplotlib.colors • matplotlib.container • matplotlib.contour • matplotlib.figure • matplotlib.gridspec • matplotlib.image • matplotlib.legend • matplotlib.lines • matplotlib.mlab • matplotlib.patches • matplotlib.patheffects • matplotlib.projections • matplotlib.quiver • matplotlib.rcsetup • matplotlib.scale • matplotlib.style • matplotlib.text • matplotlib.ticker • matplotlib.transforms • matplotlib.typing • matplotlib.widgets • numpy • numpy.typing • os • pathlib • re • sys • threading • time • typing • typing_extensions

imported by: matplotlib • matplotlib._enums • matplotlib.backend_bases • matplotlib.backends.backend_webagg_core • matplotlib.figure • matplotlib.image

matplotlib.quiver SourceModule

imports: math • matplotlib • matplotlib._api • matplotlib._docstring • matplotlib.artist • matplotlib.cbook • matplotlib.collections • matplotlib.patches • matplotlib.text • matplotlib.transforms • numpy • numpy.ma

imported by: matplotlib.axes._axes • matplotlib.pyplot

matplotlib.rcsetup SourceModule

imports: ast • cycler • functools • matplotlib • matplotlib._api • matplotlib._enums • matplotlib._fontconfig_pattern • matplotlib.cbook • matplotlib.colors • numbers • numpy • operator • os • re

imported by: matplotlib • matplotlib.axes._base • matplotlib.font_manager • matplotlib.pyplot

matplotlib.scale SourceModule

imports: inspect • matplotlib • matplotlib._api • matplotlib._docstring • matplotlib.ticker • matplotlib.transforms • numpy • textwrap

imported by: matplotlib • matplotlib.axis • matplotlib.cm • matplotlib.colors • matplotlib.pyplot

matplotlib.spines SourceModule

imports: collections.abc • functools • matplotlib • matplotlib._api • matplotlib._docstring • matplotlib.artist • matplotlib.patches • matplotlib.path • matplotlib.transforms • numpy

imported by: matplotlib.axes._base • matplotlib.colorbar • matplotlib.projections.geo • matplotlib.projections.polar

matplotlib.stackplot SourceModule

imports: itertools • matplotlib • matplotlib._api • numpy

imported by: matplotlib.axes._axes

matplotlib.streamplot SourceModule

imports: matplotlib • matplotlib._api • matplotlib.cm • matplotlib.collections • matplotlib.colors • matplotlib.lines • matplotlib.patches • numpy

imported by: matplotlib.axes._axes

matplotlib.style Package

imports: matplotlib • matplotlib.style.core

imported by: matplotlib • matplotlib.pyplot • matplotlib.style.core

matplotlib.style.core SourceModule

imports: contextlib • importlib.resources • importlib_resources • logging • matplotlib • matplotlib._api • matplotlib._docstring • matplotlib.style • os • pathlib • sys • warnings

imported by: matplotlib • matplotlib.style

matplotlib.table SourceModule

imports: matplotlib • matplotlib._api • matplotlib._docstring • matplotlib.artist • matplotlib.patches • matplotlib.path • matplotlib.text • matplotlib.transforms • numpy

imported by: matplotlib.axes._axes • matplotlib.axes._base

matplotlib.texmanager SourceModule

imports: functools • hashlib • logging • matplotlib • matplotlib._api • matplotlib.cbook • matplotlib.dviread • numpy • os • pathlib • subprocess • tempfile

imported by: matplotlib.backend_bases • matplotlib.textpath

matplotlib.text SourceModule

imports: functools • logging • math • matplotlib • matplotlib._api • matplotlib._docstring • matplotlib.artist • matplotlib.cbook • matplotlib.font_manager • matplotlib.offsetbox • matplotlib.patches • matplotlib.patheffects • matplotlib.projections • matplotlib.textpath • matplotlib.transforms • numbers • numpy • weakref

imported by: matplotlib • matplotlib.axes._axes • matplotlib.axes._base • matplotlib.axis • matplotlib.backend_bases • matplotlib.contour • matplotlib.figure • matplotlib.legend • matplotlib.markers • matplotlib.offsetbox • matplotlib.pyplot • matplotlib.quiver • matplotlib.table • matplotlib.textpath • matplotlib.widgets • mpl_toolkits.mplot3d.art3d

matplotlib.textpath SourceModule

imports: collections • logging • matplotlib • matplotlib._text_helpers • matplotlib.dviread • matplotlib.font_manager • matplotlib.ft2font • matplotlib.mathtext • matplotlib.path • matplotlib.texmanager • matplotlib.text • matplotlib.transforms • numpy • urllib.parse

imported by: matplotlib.text

matplotlib.ticker SourceModule

imports: itertools • locale • logging • math • matplotlib • matplotlib._api • matplotlib.cbook • matplotlib.font_manager • matplotlib.transforms • numbers • numpy

imported by: matplotlib • matplotlib.axes._axes • matplotlib.axes._base • matplotlib.axes._secondary_axes • matplotlib.axis • matplotlib.category • matplotlib.colorbar • matplotlib.contour • matplotlib.dates • matplotlib.projections.geo • matplotlib.projections.polar • matplotlib.pyplot • matplotlib.scale • matplotlib.widgets

matplotlib.transforms SourceModule

imports: copy • functools • math • matplotlib • matplotlib._api • matplotlib._path • matplotlib.path • numpy • numpy.linalg • textwrap • weakref

imported by: matplotlib • matplotlib._constrained_layout • matplotlib._layoutgrid • matplotlib._tight_bbox • matplotlib._tight_layout • matplotlib.artist • matplotlib.axes._axes • matplotlib.axes._base • matplotlib.axis • matplotlib.backend_bases • matplotlib.backends.backend_agg • matplotlib.collections • matplotlib.colorbar • matplotlib.contour • matplotlib.figure • matplotlib.gridspec • matplotlib.image • matplotlib.legend • matplotlib.lines • matplotlib.markers • matplotlib.offsetbox • matplotlib.patches • matplotlib.path • matplotlib.patheffects • matplotlib.projections.geo • matplotlib.projections.polar • matplotlib.pyplot • matplotlib.quiver • matplotlib.scale • matplotlib.spines • matplotlib.table • matplotlib.text • matplotlib.textpath • matplotlib.ticker • matplotlib.widgets • mpl_toolkits.mplot3d.axes3d • mpl_toolkits.mplot3d.axis3d

matplotlib.tri Package

imports: matplotlib • matplotlib.tri._triangulation • matplotlib.tri._tricontour • matplotlib.tri._trifinder • matplotlib.tri._triinterpolate • matplotlib.tri._tripcolor • matplotlib.tri._triplot • matplotlib.tri._trirefine • matplotlib.tri._tritools

imported by: matplotlib.axes._axes • matplotlib.tri._triangulation • matplotlib.tri._tricontour • matplotlib.tri._trifinder • matplotlib.tri._triinterpolate • matplotlib.tri._tripcolor • matplotlib.tri._triplot • matplotlib.tri._trirefine • matplotlib.tri._tritools

matplotlib.tri._triangulation SourceModule

imports: matplotlib • matplotlib._api • matplotlib._qhull • matplotlib._tri • matplotlib.tri • matplotlib.tri._trifinder • numpy • sys

imported by: matplotlib.tri • matplotlib.tri._tricontour • matplotlib.tri._tripcolor • matplotlib.tri._triplot • matplotlib.tri._trirefine • mpl_toolkits.mplot3d.axes3d

matplotlib.tri._tricontour SourceModule

imports: matplotlib • matplotlib._docstring • matplotlib._tri • matplotlib.contour • matplotlib.tri • matplotlib.tri._triangulation • numpy

imported by: matplotlib.tri

matplotlib.tri._trifinder SourceModule

imports: matplotlib • matplotlib._api • matplotlib._tri • matplotlib.tri • numpy

imported by: matplotlib.tri • matplotlib.tri._triangulation • matplotlib.tri._triinterpolate

matplotlib.tri._triinterpolate SourceModule

imports: matplotlib • matplotlib._api • matplotlib.tri • matplotlib.tri._trifinder • matplotlib.tri._tritools • numpy

imported by: matplotlib.tri • matplotlib.tri._trirefine

matplotlib.tri._tripcolor SourceModule

imports: matplotlib • matplotlib._api • matplotlib.collections • matplotlib.tri • matplotlib.tri._triangulation • numpy

imported by: matplotlib.tri

matplotlib.tri._triplot SourceModule

imports: matplotlib.axes • matplotlib.cbook • matplotlib.lines • matplotlib.tri • matplotlib.tri._triangulation • numpy

imported by: matplotlib.tri

matplotlib.tri._trirefine SourceModule

imports: matplotlib • matplotlib._api • matplotlib.tri • matplotlib.tri._triangulation • matplotlib.tri._triinterpolate • numpy

imported by: matplotlib.tri

matplotlib.tri._tritools SourceModule

imports: matplotlib • matplotlib._api • matplotlib.tri • numpy

imported by: matplotlib.tri • matplotlib.tri._triinterpolate

matplotlib.typing SourceModule

imports: collections.abc • matplotlib • matplotlib._enums • matplotlib.markers • matplotlib.path • pathlib • typing

imported by: matplotlib.pyplot

matplotlib.units SourceModule

imports: decimal • matplotlib • matplotlib.cbook • numbers • numpy • numpy.ma

imported by: matplotlib.axes._axes • matplotlib.axis • matplotlib.category • matplotlib.dates

matplotlib.widgets SourceModule

imports: contextlib • copy • cycler • itertools • matplotlib • matplotlib._api • matplotlib._docstring • matplotlib.backend_tools • matplotlib.cbook • matplotlib.collections • matplotlib.colors • matplotlib.lines • matplotlib.patches • matplotlib.text • matplotlib.ticker • matplotlib.transforms • numbers • numpy

imported by: matplotlib • matplotlib.backend_bases • matplotlib.backend_managers • matplotlib.pyplot

mimetypes SourceModule

imports: _winapi • getopt • os • posixpath • sys • urllib.parse • winreg

imported by: http.server • matplotlib.backends.backend_webagg • urllib.request

mmap (builtin module)

imported by: PIL.ImageFile • PIL.PdfParser • multiprocessing.heap • multiprocessing.shared_memory • numpy.core.memmap

mpl_toolkits Package

imports: os

imported by: mpl_toolkits.mplot3d

mpl_toolkits.mplot3d Package

imports: mpl_toolkits • mpl_toolkits.mplot3d • mpl_toolkits.mplot3d.art3d • mpl_toolkits.mplot3d.axes3d • mpl_toolkits.mplot3d.axis3d • mpl_toolkits.mplot3d.proj3d

imported by: matplotlib.projections • mpl_toolkits.mplot3d • mpl_toolkits.mplot3d.art3d • mpl_toolkits.mplot3d.axes3d • mpl_toolkits.mplot3d.axis3d • mpl_toolkits.mplot3d.proj3d

mpl_toolkits.mplot3d.art3d SourceModule

imports: contextlib • math • matplotlib • matplotlib.artist • matplotlib.cbook • matplotlib.collections • matplotlib.colors • matplotlib.lines • matplotlib.patches • matplotlib.path • matplotlib.text • mpl_toolkits.mplot3d • mpl_toolkits.mplot3d.proj3d • numpy

imported by: mpl_toolkits.mplot3d • mpl_toolkits.mplot3d.axes3d • mpl_toolkits.mplot3d.axis3d

mpl_toolkits.mplot3d.axes3d SourceModule

imports: collections • functools • itertools • math • matplotlib • matplotlib._api • matplotlib._docstring • matplotlib.artist • matplotlib.axes • matplotlib.axes.Axes • matplotlib.axes._base • matplotlib.cbook • matplotlib.collections • matplotlib.colors • matplotlib.container • matplotlib.image • matplotlib.lines • matplotlib.patches • matplotlib.transforms • matplotlib.tri._triangulation • mpl_toolkits.mplot3d • mpl_toolkits.mplot3d.art3d • mpl_toolkits.mplot3d.axis3d • mpl_toolkits.mplot3d.proj3d • numpy • textwrap

imported by: mpl_toolkits.mplot3d

mpl_toolkits.mplot3d.axis3d SourceModule

imports: inspect • matplotlib • matplotlib._api • matplotlib.artist • matplotlib.axis • matplotlib.colors • matplotlib.lines • matplotlib.patches • matplotlib.transforms • mpl_toolkits.mplot3d • mpl_toolkits.mplot3d.art3d • mpl_toolkits.mplot3d.proj3d • numpy

imported by: mpl_toolkits.mplot3d • mpl_toolkits.mplot3d.axes3d

mpl_toolkits.mplot3d.proj3d SourceModule

imports: matplotlib • matplotlib._api • mpl_toolkits.mplot3d • numpy

imported by: mpl_toolkits.mplot3d • mpl_toolkits.mplot3d.art3d • mpl_toolkits.mplot3d.axes3d • mpl_toolkits.mplot3d.axis3d

msvcrt (builtin module)

imported by: asyncio.windows_events • asyncio.windows_utils • getpass • multiprocessing.popen_spawn_win32 • multiprocessing.spawn • subprocess

multiprocessing Package

imports: multiprocessing • multiprocessing.AuthenticationError • multiprocessing.BufferTooShort • multiprocessing.TimeoutError • multiprocessing.connection • multiprocessing.context • multiprocessing.forkserver • multiprocessing.get_context • multiprocessing.get_start_method • multiprocessing.pool • multiprocessing.process • multiprocessing.reduction • multiprocessing.resource_sharer • multiprocessing.resource_tracker • multiprocessing.set_start_method • multiprocessing.shared_memory • multiprocessing.spawn • multiprocessing.util • sys

imported by: concurrent.futures.process • multiprocessing • multiprocessing.connection • multiprocessing.context • multiprocessing.dummy • multiprocessing.forkserver • multiprocessing.heap • multiprocessing.managers • multiprocessing.pool • multiprocessing.popen_fork • multiprocessing.popen_forkserver • multiprocessing.popen_spawn_posix • multiprocessing.popen_spawn_win32 • multiprocessing.process • multiprocessing.queues • multiprocessing.reduction • multiprocessing.resource_sharer • multiprocessing.resource_tracker • multiprocessing.shared_memory • multiprocessing.sharedctypes • multiprocessing.spawn • multiprocessing.synchronize • multiprocessing.util • pyi_rth_multiprocessing.py

multiprocessing.AuthenticationError MissingModule

imported by: multiprocessing • multiprocessing.connection

multiprocessing.BufferTooShort MissingModule

imported by: multiprocessing • multiprocessing.connection

multiprocessing.TimeoutError MissingModule

imported by: multiprocessing • multiprocessing.pool

multiprocessing.connection SourceModule

imports: _multiprocessing • _winapi • hmac • io • itertools • multiprocessing • multiprocessing.AuthenticationError • multiprocessing.BufferTooShort • multiprocessing.context • multiprocessing.resource_sharer • multiprocessing.util • os • selectors • socket • struct • sys • tempfile • time • xmlrpc.client

imported by: concurrent.futures.process • multiprocessing • multiprocessing.context • multiprocessing.forkserver • multiprocessing.managers • multiprocessing.pool • multiprocessing.popen_fork • multiprocessing.popen_forkserver • multiprocessing.process • multiprocessing.queues • multiprocessing.resource_sharer

multiprocessing.context SourceModule

imports: multiprocessing • multiprocessing.connection • multiprocessing.forkserver • multiprocessing.managers • multiprocessing.pool • multiprocessing.popen_fork • multiprocessing.popen_forkserver • multiprocessing.popen_spawn_posix • multiprocessing.popen_spawn_win32 • multiprocessing.process • multiprocessing.queues • multiprocessing.reduction • multiprocessing.sharedctypes • multiprocessing.spawn • multiprocessing.synchronize • multiprocessing.util • os • sys • threading

imported by: multiprocessing • multiprocessing.connection • multiprocessing.forkserver • multiprocessing.heap • multiprocessing.managers • multiprocessing.popen_forkserver • multiprocessing.popen_spawn_posix • multiprocessing.popen_spawn_win32 • multiprocessing.process • multiprocessing.queues • multiprocessing.reduction • multiprocessing.resource_sharer • multiprocessing.sharedctypes • multiprocessing.spawn • multiprocessing.synchronize

multiprocessing.dummy Package

imports: array • multiprocessing • multiprocessing.dummy.connection • multiprocessing.pool • queue • sys • threading • weakref

imported by: multiprocessing.dummy.connection • multiprocessing.pool

multiprocessing.dummy.connection SourceModule

imports: multiprocessing.dummy • queue

imported by: multiprocessing.dummy

multiprocessing.forkserver SourceModule

imports: errno • multiprocessing • multiprocessing.connection • multiprocessing.context • multiprocessing.process • multiprocessing.resource_tracker • multiprocessing.spawn • multiprocessing.util • os • selectors • signal • socket • struct • sys • threading • warnings

imported by: multiprocessing • multiprocessing.context • multiprocessing.popen_forkserver • multiprocessing.util

multiprocessing.get_context MissingModule

imported by: multiprocessing • multiprocessing.managers • multiprocessing.pool • multiprocessing.sharedctypes

multiprocessing.get_start_method MissingModule

imported by: multiprocessing • multiprocessing.spawn

multiprocessing.heap SourceModule

imports: _winapi • bisect • collections • mmap • multiprocessing • multiprocessing.context • multiprocessing.util • os • sys • tempfile • threading

imported by: multiprocessing.sharedctypes • multiprocessing.synchronize

multiprocessing.managers SourceModule

imports: array • multiprocessing • multiprocessing.connection • multiprocessing.context • multiprocessing.get_context • multiprocessing.pool • multiprocessing.process • multiprocessing.resource_tracker • multiprocessing.shared_memory • multiprocessing.util • os • queue • signal • sys • threading • time • traceback • types

imported by: multiprocessing.context

multiprocessing.pool SourceModule

imports: collections • itertools • multiprocessing • multiprocessing.TimeoutError • multiprocessing.connection • multiprocessing.dummy • multiprocessing.get_context • multiprocessing.util • os • queue • threading • time • traceback • types • warnings

imported by: multiprocessing • multiprocessing.context • multiprocessing.dummy • multiprocessing.managers

multiprocessing.popen_fork SourceModule

imports: multiprocessing • multiprocessing.connection • multiprocessing.util • os • signal

imported by: multiprocessing.context • multiprocessing.popen_forkserver • multiprocessing.popen_spawn_posix

multiprocessing.popen_forkserver SourceModule

imports: io • multiprocessing • multiprocessing.connection • multiprocessing.context • multiprocessing.forkserver • multiprocessing.popen_fork • multiprocessing.spawn • multiprocessing.util • os

imported by: multiprocessing.context • pyi_rth_multiprocessing.py

multiprocessing.popen_spawn_posix SourceModule

imports: io • multiprocessing • multiprocessing.context • multiprocessing.popen_fork • multiprocessing.resource_tracker • multiprocessing.spawn • multiprocessing.util • os

imported by: multiprocessing.context • pyi_rth_multiprocessing.py

multiprocessing.popen_spawn_win32 SourceModule

imports: _winapi • msvcrt • multiprocessing • multiprocessing.context • multiprocessing.spawn • multiprocessing.util • os • signal • sys

imported by: multiprocessing.context • pyi_rth_multiprocessing.py

multiprocessing.process SourceModule

imports: _weakrefset • itertools • multiprocessing • multiprocessing.connection • multiprocessing.context • multiprocessing.util • os • signal • sys • threading • traceback

imported by: multiprocessing • multiprocessing.context • multiprocessing.forkserver • multiprocessing.managers • multiprocessing.resource_sharer • multiprocessing.spawn • multiprocessing.synchronize • multiprocessing.util

multiprocessing.queues SourceModule

imports: _multiprocessing • collections • errno • multiprocessing • multiprocessing.connection • multiprocessing.context • multiprocessing.synchronize • multiprocessing.util • os • queue • sys • threading • time • traceback • types • weakref

imported by: concurrent.futures.process • multiprocessing.context

multiprocessing.reduction SourceModule

imports: _winapi • abc • array • copyreg • functools • io • multiprocessing • multiprocessing.context • multiprocessing.resource_sharer • os • pickle • socket • sys

imported by: multiprocessing • multiprocessing.context

multiprocessing.resource_sharer SourceModule

imports: multiprocessing • multiprocessing.connection • multiprocessing.context • multiprocessing.process • multiprocessing.util • os • signal • socket • sys • threading

imported by: multiprocessing • multiprocessing.connection • multiprocessing.reduction

multiprocessing.resource_tracker SourceModule

imports: _multiprocessing • _posixshmem • multiprocessing • multiprocessing.spawn • multiprocessing.util • os • signal • sys • threading • warnings

imported by: multiprocessing • multiprocessing.forkserver • multiprocessing.managers • multiprocessing.popen_spawn_posix • multiprocessing.shared_memory • multiprocessing.spawn • multiprocessing.synchronize • multiprocessing.util

multiprocessing.set_start_method MissingModule

imported by: multiprocessing • multiprocessing.spawn

multiprocessing.shared_memory SourceModule

imports: _posixshmem • _winapi • errno • functools • mmap • multiprocessing • multiprocessing.resource_tracker • os • secrets • struct • types

imported by: multiprocessing • multiprocessing.managers

multiprocessing.sharedctypes SourceModule

imports: ctypes • multiprocessing • multiprocessing.context • multiprocessing.get_context • multiprocessing.heap • weakref

imported by: multiprocessing.context

multiprocessing.spawn SourceModule

imports: _winapi • msvcrt • multiprocessing • multiprocessing.context • multiprocessing.get_start_method • multiprocessing.process • multiprocessing.resource_tracker • multiprocessing.set_start_method • multiprocessing.util • os • runpy • sys • types

imported by: multiprocessing • multiprocessing.context • multiprocessing.forkserver • multiprocessing.popen_forkserver • multiprocessing.popen_spawn_posix • multiprocessing.popen_spawn_win32 • multiprocessing.resource_tracker • pyi_rth_multiprocessing.py

multiprocessing.synchronize SourceModule

imports: _multiprocessing • multiprocessing • multiprocessing.context • multiprocessing.heap • multiprocessing.process • multiprocessing.resource_tracker • multiprocessing.util • struct • sys • tempfile • threading • time

imported by: concurrent.futures.process • multiprocessing.context • multiprocessing.queues

multiprocessing.util SourceModule

imports: _posixsubprocess • atexit • itertools • logging • multiprocessing • multiprocessing.forkserver • multiprocessing.process • multiprocessing.resource_tracker • os • shutil • subprocess • sys • tempfile • threading • traceback • weakref

imported by: multiprocessing • multiprocessing.connection • multiprocessing.context • multiprocessing.forkserver • multiprocessing.heap • multiprocessing.managers • multiprocessing.pool • multiprocessing.popen_fork • multiprocessing.popen_forkserver • multiprocessing.popen_spawn_posix • multiprocessing.popen_spawn_win32 • multiprocessing.process • multiprocessing.queues • multiprocessing.resource_sharer • multiprocessing.resource_tracker • multiprocessing.spawn • multiprocessing.synchronize

netrc SourceModule

imports: os • pwd • shlex • stat

imported by: ftplib

nt (builtin module)

imported by: ctypes • importlib._bootstrap_external • ntpath • os • shutil

ntpath SourceModule

imports: _winapi • genericpath • nt • os • stat • string • sys

imported by: esp_controller.py • ntpath • os • pathlib • pkg_resources

ntpath AliasNode

imports: ntpath • os

imported by: matplotlib.backends._backend_tk • numpy.core.memmap • os • pkg_resources • pkgutil • py_compile • sysconfig • tracemalloc • unittest • unittest.util

nturl2path SourceModule

imports: string • urllib.parse

imported by: urllib.request

numbers SourceModule

imports: abc

imported by: PIL.TiffImagePlugin • _pydecimal • fractions • jinja2.tests • matplotlib.artist • matplotlib.axes._axes • matplotlib.axes._base • matplotlib.axes._secondary_axes • matplotlib.axis • matplotlib.collections • matplotlib.colors • matplotlib.contour • matplotlib.figure • matplotlib.font_manager • matplotlib.gridspec • matplotlib.legend • matplotlib.lines • matplotlib.mlab • matplotlib.patches • matplotlib.rcsetup • matplotlib.text • matplotlib.ticker • matplotlib.units • matplotlib.widgets • numpy.core.arrayprint • numpy.core.numeric • numpy.core.numerictypes • numpy.polynomial._polybase • statistics

numpy Package

imports: builtins • math • numpy • numpy.__config__ • numpy._distributor_init • numpy._globals • numpy._pytesttester • numpy.amax • numpy.amin • numpy.array • numpy.array_api • numpy.bool_ • numpy.bytes_ • numpy.compat • numpy.complexfloating • numpy.core • numpy.core._dtype_ctypes • numpy.core._multiarray_tests • numpy.ctypeslib • numpy.datetime64 • numpy.dtype • numpy.dtypes • numpy.exceptions • numpy.expand_dims • numpy.eye • numpy.fft • numpy.float32 • numpy.float64 • numpy.floating • numpy.generic • numpy.histogramdd • numpy.int16 • numpy.int32 • numpy.int64 • numpy.int8 • numpy.integer • numpy.iscomplexobj • numpy.isfinite • numpy.isinf • numpy.isnan • numpy.lib • numpy.linalg • numpy.ma • numpy.matrixlib • numpy.ndarray • numpy.number • numpy.object_ • numpy.polynomial • numpy.random • numpy.recarray • numpy.str_ • numpy.testing • numpy.timedelta64 • numpy.ufunc • numpy.uint16 • numpy.uint32 • numpy.uint64 • numpy.uint8 • numpy.unsignedinteger • numpy.version • numpy.void • os • pathlib • sys • warnings

imported by: PIL.Image • contourpy • contourpy.array • contourpy.convert • contourpy.typecheck • contourpy.types • matplotlib • matplotlib._cm • matplotlib._constrained_layout • matplotlib._enums • matplotlib._layoutgrid • matplotlib._mathtext • matplotlib._tight_layout • matplotlib.artist • matplotlib.axes._axes • matplotlib.axes._base • matplotlib.axes._secondary_axes • matplotlib.axis • matplotlib.backend_bases • matplotlib.backend_tools • matplotlib.backends._backend_tk • matplotlib.backends.backend_agg • matplotlib.backends.backend_webagg_core • matplotlib.bezier • matplotlib.category • matplotlib.cbook • matplotlib.cm • matplotlib.collections • matplotlib.colorbar • matplotlib.colors • matplotlib.contour • matplotlib.dates • matplotlib.dviread • matplotlib.figure • matplotlib.gridspec • matplotlib.hatch • matplotlib.image • matplotlib.legend • matplotlib.legend_handler • matplotlib.lines • matplotlib.markers • matplotlib.mlab • matplotlib.offsetbox • matplotlib.patches • matplotlib.path • matplotlib.patheffects • matplotlib.projections.geo • matplotlib.projections.polar • matplotlib.pyplot • matplotlib.quiver • matplotlib.rcsetup • matplotlib.scale • matplotlib.spines • matplotlib.stackplot • matplotlib.streamplot • matplotlib.table • matplotlib.texmanager • matplotlib.text • matplotlib.textpath • matplotlib.ticker • matplotlib.transforms • matplotlib.tri._triangulation • matplotlib.tri._tricontour • matplotlib.tri._trifinder • matplotlib.tri._triinterpolate • matplotlib.tri._tripcolor • matplotlib.tri._triplot • matplotlib.tri._trirefine • matplotlib.tri._tritools • matplotlib.units • matplotlib.widgets • mpl_toolkits.mplot3d.art3d • mpl_toolkits.mplot3d.axes3d • mpl_toolkits.mplot3d.axis3d • mpl_toolkits.mplot3d.proj3d • numpy • numpy.__config__ • numpy._distributor_init • numpy._globals • numpy._pytesttester • numpy._typing • numpy._typing._array_like • numpy._typing._dtype_like • numpy._typing._scalars • numpy._utils • numpy._version • numpy.array_api • numpy.array_api._array_object • numpy.array_api._constants • numpy.array_api._creation_functions • numpy.array_api._data_type_functions • numpy.array_api._dtypes • numpy.array_api._elementwise_functions • numpy.array_api._indexing_functions • numpy.array_api._manipulation_functions • numpy.array_api._searching_functions • numpy.array_api._set_functions • numpy.array_api._sorting_functions • numpy.array_api._statistical_functions • numpy.array_api._typing • numpy.array_api._utility_functions • numpy.array_api.linalg • numpy.compat • numpy.core • numpy.core._dtype • numpy.core._dtype_ctypes • numpy.core._internal • numpy.core.arrayprint • numpy.core.defchararray • numpy.core.fromnumeric • numpy.core.function_base • numpy.core.memmap • numpy.core.numeric • numpy.ctypeslib • numpy.dtypes • numpy.exceptions • numpy.fft • numpy.lib • numpy.lib._iotools • numpy.lib.arraypad • numpy.lib.arraysetops • numpy.lib.format • numpy.lib.function_base • numpy.lib.histograms • numpy.lib.index_tricks • numpy.lib.nanfunctions • numpy.lib.npyio • numpy.lib.recfunctions • numpy.lib.stride_tricks • numpy.lib.twodim_base • numpy.lib.utils • numpy.linalg • numpy.linalg.linalg • numpy.ma • numpy.ma.core • numpy.ma.extras • numpy.ma.mrecords • numpy.matrixlib • numpy.polynomial • numpy.polynomial._polybase • numpy.polynomial.chebyshev • numpy.polynomial.hermite • numpy.polynomial.hermite_e • numpy.polynomial.laguerre • numpy.polynomial.legendre • numpy.polynomial.polynomial • numpy.polynomial.polyutils • numpy.random • numpy.testing • numpy.testing._private.utils • numpy.testing.overrides • numpy.typing • numpy.version

numpy.__config__ SourceModule

imports: numpy • numpy.core._multiarray_umath • os • sys

imported by: numpy

numpy._distributor_init SourceModule

imports: ctypes • glob • numpy • os • warnings

imported by: numpy

numpy._globals SourceModule

imports: enum • numpy • numpy._utils

imported by: numpy • numpy.core._methods

numpy._pytesttester SourceModule

imports: numpy • numpy.array_api • numpy.testing • os • sys • warnings

imported by: numpy • numpy.core • numpy.fft • numpy.lib • numpy.linalg • numpy.ma • numpy.matrixlib • numpy.polynomial • numpy.random • numpy.testing • numpy.typing

numpy._typing Package

imports: __future__ • numpy • numpy._typing._array_like • numpy._typing._char_codes • numpy._typing._dtype_like • numpy._typing._nbit • numpy._typing._nested_sequence • numpy._typing._scalars • numpy._typing._shape • numpy._typing._ufunc • numpy._utils • numpy.ufunc • typing

imported by: numpy._typing._add_docstring • numpy._typing._array_like • numpy._typing._char_codes • numpy._typing._dtype_like • numpy._typing._nbit • numpy._typing._nested_sequence • numpy._typing._scalars • numpy._typing._shape • numpy.linalg.linalg • numpy.typing

numpy._typing._add_docstring SourceModule

imports: numpy._typing • numpy._typing._array_like • re • textwrap

imported by: numpy.typing

numpy._typing._array_like SourceModule

imports: __future__ • collections.abc • numpy • numpy._typing • numpy._typing._nested_sequence • numpy.bool_ • numpy.bytes_ • numpy.complexfloating • numpy.datetime64 • numpy.dtype • numpy.floating • numpy.generic • numpy.integer • numpy.ndarray • numpy.number • numpy.object_ • numpy.str_ • numpy.timedelta64 • numpy.unsignedinteger • numpy.void • typing

imported by: numpy._typing • numpy._typing._add_docstring

numpy._typing._char_codes SourceModule

imports: numpy._typing • typing

imported by: numpy._typing • numpy._typing._dtype_like

numpy._typing._dtype_like SourceModule

imports: collections.abc • numpy • numpy._typing • numpy._typing._char_codes • numpy._typing._shape • typing

imported by: numpy._typing

numpy._typing._nbit SourceModule

imports: numpy._typing • typing

imported by: numpy._typing

numpy._typing._nested_sequence SourceModule

imports: __future__ • collections.abc • numpy._typing • typing

imported by: numpy._typing • numpy._typing._array_like

numpy._typing._scalars SourceModule

imports: numpy • numpy._typing • typing

imported by: numpy._typing

numpy._typing._shape SourceModule

imports: collections.abc • numpy._typing • typing

imported by: numpy._typing • numpy._typing._dtype_like

numpy._typing._ufunc MissingModule

imported by: numpy._typing

numpy._utils Package

imports: numpy

imported by: numpy._globals • numpy._typing • numpy._utils._inspect • numpy.compat • numpy.core._exceptions • numpy.core._machar • numpy.core._ufunc_config • numpy.core.defchararray • numpy.core.fromnumeric • numpy.core.getlimits • numpy.core.memmap • numpy.core.numerictypes • numpy.core.overrides • numpy.core.records • numpy.lib._datasource • numpy.lib.function_base • numpy.lib.index_tricks • numpy.lib.polynomial • numpy.lib.type_check • numpy.lib.utils • numpy.linalg.linalg • numpy.matrixlib.defmatrix

numpy._utils._inspect SourceModule

imports: numpy._utils • types

imported by: numpy.compat • numpy.core.overrides

numpy._version SourceModule

imports: json • numpy

imported by: numpy.version

numpy._version_meson MissingModule

imported by: numpy.version

numpy.amax MissingModule

imported by: numpy • numpy.ma.core

numpy.amin MissingModule

imported by: numpy • numpy.ma.core

numpy.array MissingModule

imported by: numpy • numpy.ma.core • numpy.ma.extras • numpy.ma.mrecords

numpy.array_api Package

imports: numpy • numpy.array_api • numpy.array_api._constants • numpy.array_api._creation_functions • numpy.array_api._data_type_functions • numpy.array_api._dtypes • numpy.array_api._elementwise_functions • numpy.array_api._indexing_functions • numpy.array_api._manipulation_functions • numpy.array_api._searching_functions • numpy.array_api._set_functions • numpy.array_api._sorting_functions • numpy.array_api._statistical_functions • numpy.array_api._utility_functions • numpy.array_api.linalg • warnings

imported by: numpy • numpy._pytesttester • numpy.array_api • numpy.array_api._array_object • numpy.array_api._constants • numpy.array_api._creation_functions • numpy.array_api._data_type_functions • numpy.array_api._dtypes • numpy.array_api._elementwise_functions • numpy.array_api._indexing_functions • numpy.array_api._manipulation_functions • numpy.array_api._searching_functions • numpy.array_api._set_functions • numpy.array_api._sorting_functions • numpy.array_api._statistical_functions • numpy.array_api._typing • numpy.array_api._utility_functions • numpy.array_api.linalg

numpy.array_api._array_object SourceModule

imports: __future__ • enum • numpy • numpy.array_api • numpy.array_api._creation_functions • numpy.array_api._dtypes • numpy.array_api._elementwise_functions • numpy.array_api._typing • numpy.array_api.linalg • numpy.typing • operator • types • typing

imported by: numpy.array_api._creation_functions • numpy.array_api._data_type_functions • numpy.array_api._elementwise_functions • numpy.array_api._indexing_functions • numpy.array_api._manipulation_functions • numpy.array_api._searching_functions • numpy.array_api._set_functions • numpy.array_api._sorting_functions • numpy.array_api._statistical_functions • numpy.array_api._typing • numpy.array_api._utility_functions • numpy.array_api.linalg

numpy.array_api._constants SourceModule

imports: numpy • numpy.array_api

imported by: numpy.array_api

numpy.array_api._creation_functions SourceModule

imports: __future__ • collections.abc • numpy • numpy.array_api • numpy.array_api._array_object • numpy.array_api._dtypes • numpy.array_api._typing • typing

imported by: numpy.array_api • numpy.array_api._array_object

numpy.array_api._data_type_functions SourceModule

imports: __future__ • collections.abc • dataclasses • numpy • numpy.array_api • numpy.array_api._array_object • numpy.array_api._dtypes • numpy.array_api._typing • typing

imported by: numpy.array_api • numpy.array_api._manipulation_functions

numpy.array_api._dtypes SourceModule

imports: numpy • numpy.array_api

imported by: numpy.array_api • numpy.array_api._array_object • numpy.array_api._creation_functions • numpy.array_api._data_type_functions • numpy.array_api._elementwise_functions • numpy.array_api._indexing_functions • numpy.array_api._searching_functions • numpy.array_api._sorting_functions • numpy.array_api._statistical_functions • numpy.array_api.linalg

numpy.array_api._elementwise_functions SourceModule

imports: __future__ • numpy • numpy.array_api • numpy.array_api._array_object • numpy.array_api._dtypes

imported by: numpy.array_api • numpy.array_api._array_object

numpy.array_api._indexing_functions SourceModule

imports: __future__ • numpy • numpy.array_api • numpy.array_api._array_object • numpy.array_api._dtypes

imported by: numpy.array_api

numpy.array_api._manipulation_functions SourceModule

imports: __future__ • numpy • numpy.array_api • numpy.array_api._array_object • numpy.array_api._data_type_functions • typing

imported by: numpy.array_api • numpy.array_api.linalg

numpy.array_api._searching_functions SourceModule

imports: __future__ • numpy • numpy.array_api • numpy.array_api._array_object • numpy.array_api._dtypes • typing

imported by: numpy.array_api

numpy.array_api._set_functions SourceModule

imports: __future__ • numpy • numpy.array_api • numpy.array_api._array_object • typing

imported by: numpy.array_api

numpy.array_api._sorting_functions SourceModule

imports: __future__ • numpy • numpy.array_api • numpy.array_api._array_object • numpy.array_api._dtypes

imported by: numpy.array_api

numpy.array_api._statistical_functions SourceModule

imports: __future__ • numpy • numpy.array_api • numpy.array_api._array_object • numpy.array_api._dtypes • numpy.array_api._typing • typing

imported by: numpy.array_api

numpy.array_api._typing SourceModule

imports: __future__ • numpy • numpy.array_api • numpy.array_api._array_object • numpy.dtype • numpy.float32 • numpy.float64 • numpy.int16 • numpy.int32 • numpy.int64 • numpy.int8 • numpy.uint16 • numpy.uint32 • numpy.uint64 • numpy.uint8 • typing

imported by: numpy.array_api._array_object • numpy.array_api._creation_functions • numpy.array_api._data_type_functions • numpy.array_api._statistical_functions • numpy.array_api.linalg

numpy.array_api._utility_functions SourceModule

imports: __future__ • numpy • numpy.array_api • numpy.array_api._array_object • typing

imported by: numpy.array_api

numpy.array_api.linalg SourceModule

imports: __future__ • numpy • numpy.array_api • numpy.array_api._array_object • numpy.array_api._dtypes • numpy.array_api._manipulation_functions • numpy.array_api._typing • numpy.core.numeric • numpy.linalg • numpy.linalg._umath_linalg • numpy.linalg.linalg • typing

imported by: numpy.array_api • numpy.array_api._array_object

numpy.bool_ MissingModule

imported by: numpy • numpy._typing._array_like • numpy.ma.core • numpy.ma.mrecords

numpy.bytes_ MissingModule

imported by: numpy • numpy._typing._array_like

numpy.compat Package

imports: numpy • numpy._utils • numpy._utils._inspect • numpy.compat • numpy.compat.py3k

imported by: numpy • numpy.compat • numpy.compat.py3k • numpy.core._methods • numpy.core._type_aliases • numpy.core.defchararray • numpy.core.memmap • numpy.core.numerictypes • numpy.core.records • numpy.lib._iotools • numpy.lib.format • numpy.lib.npyio • numpy.ma.core

numpy.compat.py3k SourceModule

imports: importlib.machinery • io • numpy.compat • os • pathlib • pickle • pickle5 • sys

imported by: numpy.compat

numpy.complexfloating MissingModule

imported by: numpy • numpy._typing._array_like

numpy.core Package

imports: copyreg • numpy • numpy._pytesttester • numpy.core • numpy.core.Inf • numpy.core._add_newdocs • numpy.core._add_newdocs_scalars • numpy.core._asarray • numpy.core._dtype • numpy.core._dtype_ctypes • numpy.core._exceptions • numpy.core._internal • numpy.core._machar • numpy.core._methods • numpy.core.add • numpy.core.all • numpy.core.amax • numpy.core.amin • numpy.core.arange • numpy.core.argsort • numpy.core.array • numpy.core.array2string • numpy.core.array_repr • numpy.core.asanyarray • numpy.core.asarray • numpy.core.atleast_1d • numpy.core.atleast_2d • numpy.core.atleast_3d • numpy.core.bool_ • numpy.core.cdouble • numpy.core.complexfloating • numpy.core.conjugate • numpy.core.count_nonzero • numpy.core.csingle • numpy.core.defchararray • numpy.core.divide • numpy.core.dot • numpy.core.double • numpy.core.einsumfunc • numpy.core.empty • numpy.core.empty_like • numpy.core.errstate • numpy.core.finfo • numpy.core.float32 • numpy.core.float_ • numpy.core.fromnumeric • numpy.core.function_base • numpy.core.geterrobj • numpy.core.getlimits • numpy.core.hstack • numpy.core.iinfo • numpy.core.inexact • numpy.core.inf • numpy.core.intc • numpy.core.integer • numpy.core.intp • numpy.core.isfinite • numpy.core.isnan • numpy.core.isnat • numpy.core.isscalar • numpy.core.linspace • numpy.core.matmul • numpy.core.max • numpy.core.memmap • numpy.core.moveaxis • numpy.core.multiarray • numpy.core.multiply • numpy.core.ndarray • numpy.core.newaxis • numpy.core.number • numpy.core.numeric • numpy.core.numerictypes • numpy.core.object_ • numpy.core.ones • numpy.core.overrides • numpy.core.prod • numpy.core.reciprocal • numpy.core.records • numpy.core.result_type • numpy.core.shape_base • numpy.core.sign • numpy.core.signbit • numpy.core.single • numpy.core.sort • numpy.core.sqrt • numpy.core.sum • numpy.core.swapaxes • numpy.core.transpose • numpy.core.ufunc • numpy.core.umath • numpy.core.vstack • numpy.core.zeros • numpy.version • os • sys • warnings

imported by: numpy • numpy.core • numpy.core._add_newdocs • numpy.core._add_newdocs_scalars • numpy.core._asarray • numpy.core._dtype • numpy.core._dtype_ctypes • numpy.core._exceptions • numpy.core._internal • numpy.core._machar • numpy.core._methods • numpy.core._multiarray_tests • numpy.core._multiarray_umath • numpy.core._string_helpers • numpy.core._type_aliases • numpy.core._ufunc_config • numpy.core.arrayprint • numpy.core.defchararray • numpy.core.einsumfunc • numpy.core.fromnumeric • numpy.core.function_base • numpy.core.getlimits • numpy.core.memmap • numpy.core.multiarray • numpy.core.numeric • numpy.core.numerictypes • numpy.core.overrides • numpy.core.records • numpy.core.shape_base • numpy.core.umath • numpy.fft._pocketfft • numpy.fft.helper • numpy.lib.arraysetops • numpy.lib.function_base • numpy.lib.histograms • numpy.lib.index_tricks • numpy.lib.mixins • numpy.lib.nanfunctions • numpy.lib.npyio • numpy.lib.polynomial • numpy.lib.shape_base • numpy.lib.twodim_base • numpy.lib.type_check • numpy.lib.utils • numpy.linalg.linalg • numpy.ma.core • numpy.testing._private.utils

numpy.core.Inf MissingModule

imported by: numpy.core • numpy.linalg.linalg

numpy.core._add_newdocs SourceModule

imports: numpy.core • numpy.core.function_base • numpy.core.overrides

imported by: numpy.core

numpy.core._add_newdocs_scalars SourceModule

imports: numpy.core • numpy.core.function_base • numpy.core.numerictypes • os • sys

imported by: numpy.core

numpy.core._asarray SourceModule

imports: numpy.core • numpy.core.multiarray • numpy.core.overrides

imported by: numpy.core • numpy.core.numeric

numpy.core._dtype SourceModule

imports: numpy • numpy.core

imported by: numpy.core • numpy.core._type_aliases • numpy.core.numerictypes

numpy.core._dtype_ctypes SourceModule

imports: _ctypes • ctypes • numpy • numpy.core

imported by: numpy • numpy.core

numpy.core._exceptions SourceModule

imports: numpy._utils • numpy.core

imported by: numpy.core • numpy.core._methods

numpy.core._internal SourceModule

imports: ast • ctypes • numpy • numpy.core • numpy.core.multiarray • numpy.exceptions • re • sys • warnings

imported by: numpy.core • numpy.ctypeslib

numpy.core._machar SourceModule

imports: math • numpy._utils • numpy.core • numpy.core._ufunc_config • numpy.core.fromnumeric

imported by: numpy.core • numpy.core.getlimits

numpy.core._methods SourceModule

imports: contextlib • numpy._globals • numpy.compat • numpy.core • numpy.core._exceptions • numpy.core._ufunc_config • numpy.core.multiarray • numpy.core.numerictypes • numpy.core.umath • numpy.lib.stride_tricks • warnings

imported by: numpy.core • numpy.core.fromnumeric

numpy.core._multiarray_tests C:\Users\Admin\myenv\Lib\site-packages\numpy\core\_multiarray_tests.cp311-win_amd64.pyd

imports: numpy.core

imported by: numpy

numpy.core._multiarray_umath C:\Users\Admin\myenv\Lib\site-packages\numpy\core\_multiarray_umath.cp311-win_amd64.pyd

imports: numpy.core

imported by: numpy.__config__ • numpy.core.multiarray • numpy.core.overrides • numpy.core.umath • numpy.lib • numpy.lib.npyio • numpy.lib.utils

numpy.core._string_helpers SourceModule

imports: numpy.core

imported by: numpy.core._type_aliases • numpy.core.numerictypes

numpy.core._type_aliases SourceModule

imports: numpy.compat • numpy.core • numpy.core._dtype • numpy.core._string_helpers • numpy.core.multiarray

imported by: numpy.core.numerictypes

numpy.core._ufunc_config SourceModule

imports: collections.abc • contextlib • contextvars • numpy._utils • numpy.core • numpy.core.umath

imported by: numpy.core._machar • numpy.core._methods • numpy.core.numeric

numpy.core.add MissingModule

imported by: numpy.core • numpy.linalg.linalg

numpy.core.all MissingModule

imported by: numpy.core • numpy.linalg.linalg • numpy.testing._private.utils

numpy.core.amax MissingModule

imported by: numpy.core • numpy.linalg.linalg

numpy.core.amin MissingModule

imported by: numpy.core • numpy.linalg.linalg

numpy.core.arange MissingModule

imported by: numpy.core • numpy.fft.helper • numpy.testing._private.utils

numpy.core.argsort MissingModule

imported by: numpy.core • numpy.linalg.linalg

numpy.core.array MissingModule

imported by: numpy.core • numpy.lib.polynomial • numpy.linalg.linalg • numpy.testing._private.utils

numpy.core.array2string MissingModule

imported by: numpy.core • numpy.testing._private.utils

numpy.core.array_repr MissingModule

imported by: numpy.core • numpy.testing._private.utils

numpy.core.arrayprint SourceModule

imports: _dummy_thread • _thread • contextlib • functools • numbers • numpy • numpy.core • numpy.core.fromnumeric • numpy.core.multiarray • numpy.core.numeric • numpy.core.numerictypes • numpy.core.overrides • numpy.core.umath • operator • sys • warnings

imported by: numpy.core.numeric • numpy.core.records

numpy.core.asanyarray MissingModule

imported by: numpy.core • numpy.linalg.linalg

numpy.core.asarray MissingModule

imported by: numpy.core • numpy.fft._pocketfft • numpy.fft.helper • numpy.lib.utils • numpy.linalg.linalg

numpy.core.atleast_1d MissingModule

imported by: numpy.core • numpy.lib.polynomial

numpy.core.atleast_2d MissingModule

imported by: numpy.core • numpy.linalg.linalg

numpy.core.atleast_3d MissingModule

imported by: numpy.core • numpy.lib.shape_base

numpy.core.bool_ MissingModule

imported by: numpy.core • numpy.testing._private.utils

numpy.core.cdouble MissingModule

imported by: numpy.core • numpy.linalg.linalg

numpy.core.complexfloating MissingModule

imported by: numpy.core • numpy.linalg.linalg

numpy.core.conjugate MissingModule

imported by: numpy.core • numpy.fft._pocketfft

numpy.core.count_nonzero MissingModule

imported by: numpy.core • numpy.linalg.linalg

numpy.core.csingle MissingModule

imported by: numpy.core • numpy.linalg.linalg

numpy.core.defchararray SourceModule

imports: functools • numpy • numpy._utils • numpy.compat • numpy.core • numpy.core.multiarray • numpy.core.numeric • numpy.core.numerictypes • numpy.core.overrides

imported by: numpy.core

numpy.core.divide MissingModule

imported by: numpy.core • numpy.linalg.linalg

numpy.core.dot MissingModule

imported by: numpy.core • numpy.lib.polynomial • numpy.linalg.linalg

numpy.core.double MissingModule

imported by: numpy.core • numpy.linalg.linalg

numpy.core.einsumfunc SourceModule

imports: itertools • numpy.core • numpy.core.multiarray • numpy.core.numeric • numpy.core.overrides • operator

imported by: numpy.core

numpy.core.empty MissingModule

imported by: numpy.core • numpy.fft.helper • numpy.linalg.linalg • numpy.testing._private.utils

numpy.core.empty_like MissingModule

imported by: numpy.core • numpy.linalg.linalg

numpy.core.errstate MissingModule

imported by: numpy.core • numpy.linalg.linalg • numpy.testing._private.utils

numpy.core.finfo MissingModule

imported by: numpy.core • numpy.lib.polynomial • numpy.linalg.linalg

numpy.core.float32 MissingModule

imported by: numpy.core • numpy.testing._private.utils

numpy.core.float_ MissingModule

imported by: numpy.core • numpy.testing._private.utils

numpy.core.fromnumeric SourceModule

imports: functools • numpy • numpy._utils • numpy.core • numpy.core._methods • numpy.core.multiarray • numpy.core.numerictypes • numpy.core.overrides • numpy.core.umath • types • warnings

imported by: numpy.core • numpy.core._machar • numpy.core.arrayprint • numpy.core.numeric • numpy.core.shape_base • numpy.lib.function_base • numpy.lib.shape_base • numpy.testing._private.utils

numpy.core.function_base SourceModule

imports: functools • numpy • numpy.core • numpy.core.multiarray • numpy.core.numeric • numpy.core.overrides • operator • types • warnings

imported by: numpy.core • numpy.core._add_newdocs • numpy.core._add_newdocs_scalars • numpy.lib.function_base

numpy.core.geterrobj MissingModule

imported by: numpy.core • numpy.linalg.linalg

numpy.core.getlimits SourceModule

imports: numpy._utils • numpy.core • numpy.core._machar • numpy.core.numeric • numpy.core.numerictypes • numpy.core.umath • warnings

imported by: numpy.core • numpy.lib.type_check

numpy.core.hstack MissingModule

imported by: numpy.core • numpy.lib.polynomial

numpy.core.iinfo MissingModule

imported by: numpy.core • numpy.lib.twodim_base

numpy.core.inexact MissingModule

imported by: numpy.core • numpy.linalg.linalg

numpy.core.inf MissingModule

imported by: numpy.core • numpy.testing._private.utils

numpy.core.intc MissingModule

imported by: numpy.core • numpy.linalg.linalg

numpy.core.integer MissingModule

imported by: numpy.core • numpy.fft.helper

numpy.core.intp MissingModule

imported by: numpy.core • numpy.linalg.linalg • numpy.testing._private.utils

numpy.core.isfinite MissingModule

imported by: numpy.core • numpy.linalg.linalg

numpy.core.isnan MissingModule

imported by: numpy.core • numpy.linalg.linalg • numpy.testing._private.utils

numpy.core.isnat MissingModule

imported by: numpy.core • numpy.testing._private.utils

numpy.core.isscalar MissingModule

imported by: numpy.core • numpy.lib.polynomial • numpy.testing._private.utils

numpy.core.linspace MissingModule

imported by: numpy.core • numpy.lib.index_tricks

numpy.core.matmul MissingModule

imported by: numpy.core • numpy.linalg.linalg

numpy.core.max MissingModule

imported by: numpy.core • numpy.testing._private.utils

numpy.core.memmap SourceModule

imports: contextlib • mmap • ntpath • numpy • numpy._utils • numpy.compat • numpy.core • numpy.core.numeric

imported by: numpy.core

numpy.core.moveaxis MissingModule

imported by: numpy.core • numpy.linalg.linalg

numpy.core.multiarray SourceModule

imports: functools • numpy.core • numpy.core._multiarray_umath • numpy.core.overrides

imported by: numpy.core • numpy.core._asarray • numpy.core._internal • numpy.core._methods • numpy.core._type_aliases • numpy.core.arrayprint • numpy.core.defchararray • numpy.core.einsumfunc • numpy.core.fromnumeric • numpy.core.function_base • numpy.core.numeric • numpy.core.numerictypes • numpy.core.shape_base • numpy.ctypeslib • numpy.fft._pocketfft • numpy.lib.function_base • numpy.lib.index_tricks • numpy.lib.npyio • numpy.lib.shape_base • numpy.linalg.linalg • numpy.ma.core • numpy.ma.extras • numpy.polynomial.chebyshev • numpy.polynomial.hermite • numpy.polynomial.hermite_e • numpy.polynomial.laguerre • numpy.polynomial.legendre • numpy.polynomial.polynomial • numpy.polynomial.polyutils

numpy.core.multiply MissingModule

imported by: numpy.core • numpy.linalg.linalg

numpy.core.ndarray MissingModule

imported by: numpy.core • numpy.lib.utils • numpy.testing._private.utils

numpy.core.newaxis MissingModule

imported by: numpy.core • numpy.linalg.linalg

numpy.core.number MissingModule

imported by: numpy.core • numpy.testing._private.utils

numpy.core.numeric SourceModule

imports: builtins • functools • itertools • numbers • numpy • numpy.core • numpy.core._asarray • numpy.core._ufunc_config • numpy.core.arrayprint • numpy.core.fromnumeric • numpy.core.multiarray • numpy.core.numerictypes • numpy.core.overrides • numpy.core.shape_base • numpy.core.umath • numpy.exceptions • numpy.eye • operator • sys • warnings

imported by: numpy.array_api.linalg • numpy.core • numpy.core.arrayprint • numpy.core.defchararray • numpy.core.einsumfunc • numpy.core.function_base • numpy.core.getlimits • numpy.core.memmap • numpy.core.records • numpy.core.shape_base • numpy.lib._iotools • numpy.lib.function_base • numpy.lib.index_tricks • numpy.lib.polynomial • numpy.lib.scimath • numpy.lib.shape_base • numpy.lib.stride_tricks • numpy.lib.twodim_base • numpy.lib.type_check • numpy.lib.ufunclike • numpy.ma.core • numpy.ma.extras • numpy.matrixlib.defmatrix

numpy.core.numerictypes SourceModule

imports: builtins • numbers • numpy._utils • numpy.compat • numpy.core • numpy.core._dtype • numpy.core._string_helpers • numpy.core._type_aliases • numpy.core.multiarray • warnings

imported by: numpy.core • numpy.core._add_newdocs_scalars • numpy.core._methods • numpy.core.arrayprint • numpy.core.defchararray • numpy.core.fromnumeric • numpy.core.getlimits • numpy.core.numeric • numpy.core.records • numpy.lib.function_base • numpy.lib.index_tricks • numpy.lib.scimath • numpy.lib.utils • numpy.ma.core • numpy.testing._private.utils

numpy.core.object_ MissingModule

imported by: numpy.core • numpy.linalg.linalg • numpy.testing._private.utils

numpy.core.ones MissingModule

imported by: numpy.core • numpy.lib.polynomial

numpy.core.overrides SourceModule

imports: collections • functools • numpy._utils • numpy._utils._inspect • numpy.core • numpy.core._multiarray_umath • os

imported by: numpy.core • numpy.core._add_newdocs • numpy.core._asarray • numpy.core.arrayprint • numpy.core.defchararray • numpy.core.einsumfunc • numpy.core.fromnumeric • numpy.core.function_base • numpy.core.multiarray • numpy.core.numeric • numpy.core.shape_base • numpy.fft._pocketfft • numpy.fft.helper • numpy.lib.arraypad • numpy.lib.arraysetops • numpy.lib.function_base • numpy.lib.histograms • numpy.lib.index_tricks • numpy.lib.nanfunctions • numpy.lib.npyio • numpy.lib.polynomial • numpy.lib.recfunctions • numpy.lib.scimath • numpy.lib.shape_base • numpy.lib.stride_tricks • numpy.lib.twodim_base • numpy.lib.type_check • numpy.lib.ufunclike • numpy.linalg.linalg • numpy.testing.overrides

numpy.core.prod MissingModule

imported by: numpy.core • numpy.linalg.linalg

numpy.core.reciprocal MissingModule

imported by: numpy.core • numpy.linalg.linalg

numpy.core.records SourceModule

imports: collections • contextlib • numpy._utils • numpy.compat • numpy.core • numpy.core.arrayprint • numpy.core.numeric • numpy.core.numerictypes • warnings

imported by: numpy.core • numpy.ma.mrecords

numpy.core.result_type MissingModule

imported by: numpy.core • numpy.testing._private.utils

numpy.core.shape_base SourceModule

imports: functools • itertools • numpy.core • numpy.core.fromnumeric • numpy.core.multiarray • numpy.core.numeric • numpy.core.overrides • operator • warnings

imported by: numpy.core • numpy.core.numeric • numpy.lib.shape_base

numpy.core.sign MissingModule

imported by: numpy.core • numpy.linalg.linalg

numpy.core.signbit MissingModule

imported by: numpy.core • numpy.testing._private.utils

numpy.core.single MissingModule

imported by: numpy.core • numpy.linalg.linalg

numpy.core.sort MissingModule

imported by: numpy.core • numpy.linalg.linalg

numpy.core.sqrt MissingModule

imported by: numpy.core • numpy.fft._pocketfft • numpy.linalg.linalg

numpy.core.sum MissingModule

imported by: numpy.core • numpy.linalg.linalg

numpy.core.swapaxes MissingModule

imported by: numpy.core • numpy.fft._pocketfft • numpy.linalg.linalg

numpy.core.transpose MissingModule

imported by: numpy.core • numpy.lib.function_base

numpy.core.ufunc MissingModule

imported by: numpy.core • numpy.lib.utils

numpy.core.umath SourceModule

imports: numpy.core • numpy.core._multiarray_umath

imported by: numpy.core • numpy.core._methods • numpy.core._ufunc_config • numpy.core.arrayprint • numpy.core.fromnumeric • numpy.core.getlimits • numpy.core.numeric • numpy.lib.function_base • numpy.lib.mixins • numpy.ma.core • numpy.polynomial.polyutils • numpy.testing.overrides

numpy.core.vstack MissingModule

imported by: numpy.core • numpy.lib.shape_base

numpy.core.zeros MissingModule

imported by: numpy.core • numpy.fft._pocketfft • numpy.linalg.linalg

numpy.ctypeslib SourceModule

imports: ctypes • numpy • numpy.core._internal • numpy.core.multiarray • numpy.dtype • numpy.integer • numpy.ndarray • os • sys • sysconfig

imported by: numpy

numpy.datetime64 MissingModule

imported by: numpy • numpy._typing._array_like

numpy.dtype MissingModule

imported by: numpy • numpy._typing._array_like • numpy.array_api._typing • numpy.ctypeslib • numpy.ma.mrecords

numpy.dtypes SourceModule

imports: numpy • numpy.dtypes

imported by: numpy • numpy.dtypes

numpy.exceptions SourceModule

imports: numpy

imported by: matplotlib.cbook • numpy • numpy.core._internal • numpy.core.numeric

numpy.expand_dims MissingModule

imported by: numpy • numpy.ma.core

numpy.eye MissingModule

imported by: numpy • numpy.core.numeric

numpy.fft Package

imports: numpy • numpy._pytesttester • numpy.fft • numpy.fft._pocketfft • numpy.fft._pocketfft_internal • numpy.fft.helper

imported by: numpy • numpy.fft • numpy.fft._pocketfft • numpy.fft._pocketfft_internal • numpy.fft.helper

numpy.fft._pocketfft SourceModule

imports: functools • numpy.core • numpy.core.asarray • numpy.core.conjugate • numpy.core.multiarray • numpy.core.overrides • numpy.core.sqrt • numpy.core.swapaxes • numpy.core.zeros • numpy.fft • numpy.fft._pocketfft_internal

imported by: numpy.fft

numpy.fft._pocketfft_internal C:\Users\Admin\myenv\Lib\site-packages\numpy\fft\_pocketfft_internal.cp311-win_amd64.pyd

imports: numpy.fft

imported by: numpy.fft • numpy.fft._pocketfft

numpy.fft.helper SourceModule

imports: numpy.core • numpy.core.arange • numpy.core.asarray • numpy.core.empty • numpy.core.integer • numpy.core.overrides • numpy.fft

imported by: numpy.fft

numpy.float32 MissingModule

imported by: numpy • numpy.array_api._typing

numpy.float64 MissingModule

imported by: numpy • numpy.array_api._typing

numpy.floating MissingModule

imported by: numpy • numpy._typing._array_like

numpy.generic MissingModule

imported by: numpy • numpy._typing._array_like

numpy.histogramdd MissingModule

imported by: numpy • numpy.lib.twodim_base

numpy.int16 MissingModule

imported by: numpy • numpy.array_api._typing

numpy.int32 MissingModule

imported by: numpy • numpy.array_api._typing

numpy.int64 MissingModule

imported by: numpy • numpy.array_api._typing

numpy.int8 MissingModule

imported by: numpy • numpy.array_api._typing

numpy.integer MissingModule

imported by: numpy • numpy._typing._array_like • numpy.ctypeslib

numpy.iscomplexobj MissingModule

imported by: numpy • numpy.ma.core

numpy.isfinite MissingModule

imported by: numpy • numpy.testing._private.utils

numpy.isinf MissingModule

imported by: numpy • numpy.testing._private.utils

numpy.isnan MissingModule

imported by: numpy • numpy.testing._private.utils

numpy.lib Package

imports: math • numpy • numpy._pytesttester • numpy.core._multiarray_umath • numpy.lib • numpy.lib._version • numpy.lib.arraypad • numpy.lib.arraysetops • numpy.lib.arrayterator • numpy.lib.format • numpy.lib.function_base • numpy.lib.histograms • numpy.lib.imag • numpy.lib.index_tricks • numpy.lib.iscomplexobj • numpy.lib.mixins • numpy.lib.nanfunctions • numpy.lib.npyio • numpy.lib.polynomial • numpy.lib.real • numpy.lib.recfunctions • numpy.lib.scimath • numpy.lib.shape_base • numpy.lib.stride_tricks • numpy.lib.twodim_base • numpy.lib.type_check • numpy.lib.ufunclike • numpy.lib.utils • numpy.version • warnings

imported by: numpy • numpy.lib • numpy.lib._datasource • numpy.lib._iotools • numpy.lib._version • numpy.lib.arraypad • numpy.lib.arraysetops • numpy.lib.arrayterator • numpy.lib.format • numpy.lib.function_base • numpy.lib.histograms • numpy.lib.index_tricks • numpy.lib.mixins • numpy.lib.nanfunctions • numpy.lib.npyio • numpy.lib.polynomial • numpy.lib.recfunctions • numpy.lib.scimath • numpy.lib.shape_base • numpy.lib.stride_tricks • numpy.lib.twodim_base • numpy.lib.type_check • numpy.lib.ufunclike • numpy.lib.utils • numpy.testing._private.utils • numpy.testing.overrides

numpy.lib._datasource SourceModule

imports: bz2 • gzip • io • lzma • numpy._utils • numpy.lib • os • shutil • tempfile • urllib.error • urllib.parse • urllib.request

imported by: numpy.lib.npyio

numpy.lib._iotools SourceModule

imports: numpy • numpy.compat • numpy.core.numeric • numpy.lib

imported by: numpy.lib.npyio • numpy.lib.recfunctions

numpy.lib._version SourceModule

imports: numpy.lib • re

imported by: numpy.lib

numpy.lib.arraypad SourceModule

imports: numpy • numpy.core.overrides • numpy.lib • numpy.lib.index_tricks

imported by: numpy.lib

numpy.lib.arraysetops SourceModule

imports: functools • numpy • numpy.core • numpy.core.overrides • numpy.lib

imported by: numpy.lib

numpy.lib.arrayterator SourceModule

imports: functools • numpy.lib • operator

imported by: numpy.lib

numpy.lib.format SourceModule

imports: io • numpy • numpy.compat • numpy.lib • numpy.lib.utils • struct • tokenize • warnings

imported by: numpy.lib • numpy.lib.npyio

numpy.lib.function_base SourceModule

imports: builtins • collections.abc • functools • numpy • numpy._utils • numpy.core • numpy.core.fromnumeric • numpy.core.function_base • numpy.core.multiarray • numpy.core.numeric • numpy.core.numerictypes • numpy.core.overrides • numpy.core.transpose • numpy.core.umath • numpy.lib • numpy.lib.histograms • numpy.lib.twodim_base • re • sys • warnings

imported by: numpy.lib • numpy.lib.index_tricks • numpy.lib.nanfunctions • numpy.lib.polynomial • numpy.ma.core • numpy.ma.extras

numpy.lib.histograms SourceModule

imports: contextlib • functools • numpy • numpy.core • numpy.core.overrides • numpy.lib • operator • warnings

imported by: numpy.lib • numpy.lib.function_base

numpy.lib.imag MissingModule

imported by: numpy.lib • numpy.testing._private.utils

numpy.lib.index_tricks SourceModule

imports: functools • math • numpy • numpy._utils • numpy.core • numpy.core.linspace • numpy.core.multiarray • numpy.core.numeric • numpy.core.numerictypes • numpy.core.overrides • numpy.lib • numpy.lib.function_base • numpy.lib.stride_tricks • numpy.matrixlib • sys • warnings

imported by: numpy.lib • numpy.lib.arraypad • numpy.lib.shape_base • numpy.ma.extras

numpy.lib.iscomplexobj MissingModule

imported by: numpy.lib • numpy.testing._private.utils

numpy.lib.mixins SourceModule

imports: numpy.core • numpy.core.umath • numpy.lib

imported by: numpy.lib

numpy.lib.nanfunctions SourceModule

imports: functools • numpy • numpy.core • numpy.core.overrides • numpy.lib • numpy.lib.function_base • warnings

imported by: numpy.lib

numpy.lib.npyio SourceModule

imports: collections.abc • contextlib • functools • itertools • numpy • numpy.compat • numpy.core • numpy.core._multiarray_umath • numpy.core.multiarray • numpy.core.overrides • numpy.lib • numpy.lib._datasource • numpy.lib._iotools • numpy.lib.format • numpy.ma • numpy.ma.mrecords • operator • os • re • warnings • weakref • zipfile

imported by: numpy.lib

numpy.lib.polynomial SourceModule

imports: functools • numpy._utils • numpy.core • numpy.core.array • numpy.core.atleast_1d • numpy.core.dot • numpy.core.finfo • numpy.core.hstack • numpy.core.isscalar • numpy.core.numeric • numpy.core.ones • numpy.core.overrides • numpy.lib • numpy.lib.function_base • numpy.lib.twodim_base • numpy.lib.type_check • numpy.linalg • re • warnings

imported by: numpy.lib

numpy.lib.real MissingModule

imported by: numpy.lib • numpy.testing._private.utils

numpy.lib.recfunctions SourceModule

imports: itertools • numpy • numpy.core.overrides • numpy.lib • numpy.lib._iotools • numpy.ma • numpy.ma.mrecords • numpy.ndarray • numpy.recarray

imported by: numpy.lib • numpy.testing.overrides

numpy.lib.scimath SourceModule

imports: numpy.core.numeric • numpy.core.numerictypes • numpy.core.overrides • numpy.lib • numpy.lib.type_check

imported by: numpy.lib

numpy.lib.shape_base SourceModule

imports: functools • numpy.core • numpy.core.atleast_3d • numpy.core.fromnumeric • numpy.core.multiarray • numpy.core.numeric • numpy.core.overrides • numpy.core.shape_base • numpy.core.vstack • numpy.lib • numpy.lib.index_tricks • numpy.matrixlib.defmatrix

imported by: numpy.lib

numpy.lib.stride_tricks SourceModule

imports: numpy • numpy.core.numeric • numpy.core.overrides • numpy.lib

imported by: numpy.core._methods • numpy.lib • numpy.lib.index_tricks • numpy.lib.twodim_base

numpy.lib.twodim_base SourceModule

imports: functools • numpy • numpy.core • numpy.core.iinfo • numpy.core.numeric • numpy.core.overrides • numpy.histogramdd • numpy.lib • numpy.lib.stride_tricks • operator

imported by: numpy.lib • numpy.lib.function_base • numpy.lib.polynomial • numpy.linalg.linalg

numpy.lib.type_check SourceModule

imports: functools • numpy._utils • numpy.core • numpy.core.getlimits • numpy.core.numeric • numpy.core.overrides • numpy.lib • numpy.lib.ufunclike

imported by: numpy.lib • numpy.lib.polynomial • numpy.lib.scimath

numpy.lib.ufunclike SourceModule

imports: functools • numpy.core.numeric • numpy.core.overrides • numpy.lib • warnings

imported by: numpy.lib • numpy.lib.type_check

numpy.lib.utils SourceModule

imports: ast • functools • inspect • io • numpy • numpy._utils • numpy.core • numpy.core._multiarray_umath • numpy.core.asarray • numpy.core.ndarray • numpy.core.numerictypes • numpy.core.ufunc • numpy.lib • os • platform • pprint • pydoc • re • sys • textwrap • threadpoolctl • types • warnings

imported by: numpy.lib • numpy.lib.format

numpy.linalg Package

imports: numpy • numpy._pytesttester • numpy.linalg • numpy.linalg._umath_linalg • numpy.linalg.linalg

imported by: matplotlib.transforms • numpy • numpy.array_api.linalg • numpy.lib.polynomial • numpy.linalg • numpy.linalg._umath_linalg • numpy.linalg.lapack_lite • numpy.linalg.linalg • numpy.matrixlib.defmatrix • numpy.polynomial.chebyshev • numpy.polynomial.hermite • numpy.polynomial.hermite_e • numpy.polynomial.laguerre • numpy.polynomial.legendre • numpy.polynomial.polynomial

numpy.linalg._umath_linalg C:\Users\Admin\myenv\Lib\site-packages\numpy\linalg\_umath_linalg.cp311-win_amd64.pyd

imports: numpy.linalg

imported by: numpy.array_api.linalg • numpy.linalg • numpy.linalg.linalg

numpy.linalg.lapack_lite C:\Users\Admin\myenv\Lib\site-packages\numpy\linalg\lapack_lite.cp311-win_amd64.pyd

imports: numpy.linalg

imported by: numpy.testing._private.utils

numpy.linalg.linalg SourceModule

imports: functools • numpy • numpy._typing • numpy._utils • numpy.core • numpy.core.Inf • numpy.core.add • numpy.core.all • numpy.core.amax • numpy.core.amin • numpy.core.argsort • numpy.core.array • numpy.core.asanyarray • numpy.core.asarray • numpy.core.atleast_2d • numpy.core.cdouble • numpy.core.complexfloating • numpy.core.count_nonzero • numpy.core.csingle • numpy.core.divide • numpy.core.dot • numpy.core.double • numpy.core.empty • numpy.core.empty_like • numpy.core.errstate • numpy.core.finfo • numpy.core.geterrobj • numpy.core.inexact • numpy.core.intc • numpy.core.intp • numpy.core.isfinite • numpy.core.isnan • numpy.core.matmul • numpy.core.moveaxis • numpy.core.multiarray • numpy.core.multiply • numpy.core.newaxis • numpy.core.object_ • numpy.core.overrides • numpy.core.prod • numpy.core.reciprocal • numpy.core.sign • numpy.core.single • numpy.core.sort • numpy.core.sqrt • numpy.core.sum • numpy.core.swapaxes • numpy.core.zeros • numpy.lib.twodim_base • numpy.linalg • numpy.linalg._umath_linalg • operator • typing • warnings

imported by: numpy.array_api.linalg • numpy.linalg

numpy.ma Package

imports: numpy • numpy._pytesttester • numpy.ma • numpy.ma.core • numpy.ma.extras

imported by: matplotlib.axes._axes • matplotlib.cm • matplotlib.contour • matplotlib.quiver • matplotlib.units • numpy • numpy.lib.npyio • numpy.lib.recfunctions • numpy.ma • numpy.ma.core • numpy.ma.extras • numpy.ma.mrecords

numpy.ma.core SourceModule

imports: builtins • copy • functools • inspect • numpy • numpy.amax • numpy.amin • numpy.array • numpy.bool_ • numpy.compat • numpy.core • numpy.core.multiarray • numpy.core.numeric • numpy.core.numerictypes • numpy.core.umath • numpy.expand_dims • numpy.iscomplexobj • numpy.lib.function_base • numpy.ma • numpy.ndarray • operator • re • textwrap • warnings

imported by: numpy.ma • numpy.ma.extras

numpy.ma.extras SourceModule

imports: itertools • numpy • numpy.array • numpy.core.multiarray • numpy.core.numeric • numpy.lib.function_base • numpy.lib.index_tricks • numpy.ma • numpy.ma.core • numpy.ndarray • warnings

imported by: numpy.ma

numpy.ma.mrecords SourceModule

imports: numpy • numpy.array • numpy.bool_ • numpy.core.records • numpy.dtype • numpy.ma • numpy.ndarray • numpy.recarray • warnings

imported by: numpy.lib.npyio • numpy.lib.recfunctions

numpy.matrixlib Package

imports: numpy • numpy._pytesttester • numpy.matrixlib • numpy.matrixlib.defmatrix

imported by: numpy • numpy.lib.index_tricks • numpy.matrixlib • numpy.matrixlib.defmatrix

numpy.matrixlib.defmatrix SourceModule

imports: ast • numpy._utils • numpy.core.numeric • numpy.linalg • numpy.matrixlib • sys • warnings

imported by: numpy.lib.shape_base • numpy.matrixlib

numpy.ndarray MissingModule

imported by: numpy • numpy._typing._array_like • numpy.ctypeslib • numpy.lib.recfunctions • numpy.ma.core • numpy.ma.extras • numpy.ma.mrecords

numpy.number MissingModule

imported by: numpy • numpy._typing._array_like

numpy.object_ MissingModule

imported by: numpy • numpy._typing._array_like

numpy.polynomial Package

imports: numpy • numpy._pytesttester • numpy.polynomial • numpy.polynomial._polybase • numpy.polynomial.chebyshev • numpy.polynomial.hermite • numpy.polynomial.hermite_e • numpy.polynomial.laguerre • numpy.polynomial.legendre • numpy.polynomial.polynomial • numpy.polynomial.polyutils

imported by: numpy • numpy.polynomial • numpy.polynomial._polybase • numpy.polynomial.chebyshev • numpy.polynomial.hermite • numpy.polynomial.hermite_e • numpy.polynomial.laguerre • numpy.polynomial.legendre • numpy.polynomial.polynomial • numpy.polynomial.polyutils

numpy.polynomial._polybase SourceModule

imports: abc • numbers • numpy • numpy.polynomial • numpy.polynomial.polyutils • os

imported by: numpy.polynomial • numpy.polynomial.chebyshev • numpy.polynomial.hermite • numpy.polynomial.hermite_e • numpy.polynomial.laguerre • numpy.polynomial.legendre • numpy.polynomial.polynomial

numpy.polynomial.chebyshev SourceModule

imports: numpy • numpy.core.multiarray • numpy.linalg • numpy.polynomial • numpy.polynomial._polybase • numpy.polynomial.polynomial • numpy.polynomial.polyutils

imported by: numpy.polynomial

numpy.polynomial.hermite SourceModule

imports: numpy • numpy.core.multiarray • numpy.linalg • numpy.polynomial • numpy.polynomial._polybase • numpy.polynomial.polynomial • numpy.polynomial.polyutils

imported by: numpy.polynomial

numpy.polynomial.hermite_e SourceModule

imports: numpy • numpy.core.multiarray • numpy.linalg • numpy.polynomial • numpy.polynomial._polybase • numpy.polynomial.polynomial • numpy.polynomial.polyutils

imported by: numpy.polynomial

numpy.polynomial.laguerre SourceModule

imports: numpy • numpy.core.multiarray • numpy.linalg • numpy.polynomial • numpy.polynomial._polybase • numpy.polynomial.polynomial • numpy.polynomial.polyutils

imported by: numpy.polynomial

numpy.polynomial.legendre SourceModule

imports: numpy • numpy.core.multiarray • numpy.linalg • numpy.polynomial • numpy.polynomial._polybase • numpy.polynomial.polynomial • numpy.polynomial.polyutils

imported by: numpy.polynomial

numpy.polynomial.polynomial SourceModule

imports: numpy • numpy.core.multiarray • numpy.linalg • numpy.polynomial • numpy.polynomial._polybase • numpy.polynomial.polyutils

imported by: numpy.polynomial • numpy.polynomial.chebyshev • numpy.polynomial.hermite • numpy.polynomial.hermite_e • numpy.polynomial.laguerre • numpy.polynomial.legendre

numpy.polynomial.polyutils SourceModule

imports: functools • numpy • numpy.core.multiarray • numpy.core.umath • numpy.polynomial • operator • warnings

imported by: numpy.polynomial • numpy.polynomial._polybase • numpy.polynomial.chebyshev • numpy.polynomial.hermite • numpy.polynomial.hermite_e • numpy.polynomial.laguerre • numpy.polynomial.legendre • numpy.polynomial.polynomial

numpy.random Package

imports: numpy • numpy._pytesttester • numpy.random • numpy.random._bounded_integers • numpy.random._common • numpy.random._generator • numpy.random._mt19937 • numpy.random._pcg64 • numpy.random._philox • numpy.random._pickle • numpy.random._sfc64 • numpy.random.bit_generator • numpy.random.mtrand

imported by: numpy • numpy.random • numpy.random._bounded_integers • numpy.random._common • numpy.random._generator • numpy.random._mt19937 • numpy.random._pcg64 • numpy.random._philox • numpy.random._pickle • numpy.random._sfc64 • numpy.random.bit_generator • numpy.random.mtrand

numpy.random._bounded_integers C:\Users\Admin\myenv\Lib\site-packages\numpy\random\_bounded_integers.cp311-win_amd64.pyd

imports: numpy.random

imported by: numpy.random

numpy.random._common C:\Users\Admin\myenv\Lib\site-packages\numpy\random\_common.cp311-win_amd64.pyd

imports: numpy.random

imported by: numpy.random

numpy.random._generator C:\Users\Admin\myenv\Lib\site-packages\numpy\random\_generator.cp311-win_amd64.pyd

imports: numpy.random

imported by: numpy.random • numpy.random._pickle

numpy.random._mt19937 C:\Users\Admin\myenv\Lib\site-packages\numpy\random\_mt19937.cp311-win_amd64.pyd

imports: numpy.random

imported by: numpy.random • numpy.random._pickle

numpy.random._pcg64 C:\Users\Admin\myenv\Lib\site-packages\numpy\random\_pcg64.cp311-win_amd64.pyd

imports: numpy.random

imported by: numpy.random • numpy.random._pickle

numpy.random._philox C:\Users\Admin\myenv\Lib\site-packages\numpy\random\_philox.cp311-win_amd64.pyd

imports: numpy.random

imported by: numpy.random • numpy.random._pickle

numpy.random._pickle SourceModule

imports: numpy.random • numpy.random._generator • numpy.random._mt19937 • numpy.random._pcg64 • numpy.random._philox • numpy.random._sfc64 • numpy.random.mtrand

imported by: numpy.random

numpy.random._sfc64 C:\Users\Admin\myenv\Lib\site-packages\numpy\random\_sfc64.cp311-win_amd64.pyd

imports: numpy.random

imported by: numpy.random • numpy.random._pickle

numpy.random.bit_generator C:\Users\Admin\myenv\Lib\site-packages\numpy\random\bit_generator.cp311-win_amd64.pyd

imports: numpy.random

imported by: numpy.random

numpy.random.mtrand C:\Users\Admin\myenv\Lib\site-packages\numpy\random\mtrand.cp311-win_amd64.pyd

imports: numpy.random

imported by: numpy.random • numpy.random._pickle

numpy.recarray MissingModule

imported by: numpy • numpy.lib.recfunctions • numpy.ma.mrecords

numpy.str_ MissingModule

imported by: numpy • numpy._typing._array_like

numpy.testing Package

imports: numpy • numpy._pytesttester • numpy.testing • numpy.testing._private • numpy.testing._private.extbuild • numpy.testing._private.utils • numpy.testing.overrides • unittest

imported by: numpy • numpy._pytesttester • numpy.testing • numpy.testing._private • numpy.testing.overrides

numpy.testing._private Package

imports: numpy.testing • numpy.testing._private.extbuild

imported by: numpy.testing • numpy.testing._private.extbuild • numpy.testing._private.utils

numpy.testing._private.extbuild SourceModule

imports: importlib.util • numpy.testing._private • os • pathlib • sys • sysconfig

imported by: numpy.testing • numpy.testing._private

numpy.testing._private.utils SourceModule

imports: contextlib • difflib • doctest • functools • gc • inspect • io • numpy • numpy.core • numpy.core.all • numpy.core.arange • numpy.core.array • numpy.core.array2string • numpy.core.array_repr • numpy.core.bool_ • numpy.core.empty • numpy.core.errstate • numpy.core.float32 • numpy.core.float_ • numpy.core.fromnumeric • numpy.core.inf • numpy.core.intp • numpy.core.isnan • numpy.core.isnat • numpy.core.isscalar • numpy.core.max • numpy.core.ndarray • numpy.core.number • numpy.core.numerictypes • numpy.core.object_ • numpy.core.result_type • numpy.core.signbit • numpy.isfinite • numpy.isinf • numpy.isnan • numpy.lib • numpy.lib.imag • numpy.lib.iscomplexobj • numpy.lib.real • numpy.linalg.lapack_lite • numpy.testing._private • operator • os • platform • pprint • psutil • re • shutil • subprocess • sys • sysconfig • tempfile • time • traceback • unittest • unittest.case • warnings • win32pdh

imported by: numpy.testing

numpy.testing.overrides SourceModule

imports: numpy • numpy.core.overrides • numpy.core.umath • numpy.lib • numpy.lib.recfunctions • numpy.testing • numpy.ufunc

imported by: numpy.testing

numpy.timedelta64 MissingModule

imported by: numpy • numpy._typing._array_like

numpy.typing Package

imports: numpy • numpy._pytesttester • numpy._typing • numpy._typing._add_docstring

imported by: contourpy • matplotlib.pyplot • numpy.array_api._array_object

numpy.ufunc MissingModule

imported by: numpy • numpy._typing • numpy.testing.overrides

numpy.uint16 MissingModule

imported by: numpy • numpy.array_api._typing

numpy.uint32 MissingModule

imported by: numpy • numpy.array_api._typing

numpy.uint64 MissingModule

imported by: numpy • numpy.array_api._typing

numpy.uint8 MissingModule

imported by: numpy • numpy.array_api._typing

numpy.unsignedinteger MissingModule

imported by: numpy • numpy._typing._array_like

numpy.version SourceModule

imports: __future__ • numpy • numpy._version • numpy._version_meson

imported by: numpy • numpy.core • numpy.lib

numpy.void MissingModule

imported by: numpy • numpy._typing._array_like

objc MissingModule

imported by: bleak.backends.corebluetooth • bleak.backends.corebluetooth.CentralManagerDelegate • bleak.backends.corebluetooth.PeripheralDelegate • bleak.backends.corebluetooth.scanner

olefile MissingModule

imported by: PIL.FpxImagePlugin • PIL.MicImagePlugin

opcode SourceModule

imports: _opcode

imported by: dis

operator SourceModule

imports: _operator • builtins • functools

imported by: PIL.ImageOps • collections • copyreg • cycler • datetime • dateutil.relativedelta • email._header_value_parser • enum • esp_controller.py • fractions • importlib.metadata • importlib.resources.readers • inspect • jinja2.nodes • jinja2.sandbox • jinja2.tests • matplotlib.axes._base • matplotlib.cbook • matplotlib.rcsetup • numpy.array_api._array_object • numpy.core.arrayprint • numpy.core.einsumfunc • numpy.core.function_base • numpy.core.numeric • numpy.core.shape_base • numpy.lib.arrayterator • numpy.lib.histograms • numpy.lib.npyio • numpy.lib.twodim_base • numpy.linalg.linalg • numpy.ma.core • numpy.polynomial.polyutils • numpy.testing._private.utils • packaging.markers • pathlib • pkg_resources • pkg_resources._vendor.importlib_resources.readers • pkg_resources._vendor.jaraco.context • pkg_resources._vendor.more_itertools.more • pkg_resources._vendor.more_itertools.recipes • pkg_resources._vendor.packaging._musllinux • pkg_resources._vendor.packaging.markers • pkg_resources._vendor.pyparsing.core • pyparsing.core • random • six • statistics • typing • typing_extensions

org MissingModule

imported by: pickle

os SourceModule

imports: _collections_abc • abc • io • nt • ntpath • ntpath • posix • posixpath • stat • subprocess • sys • warnings

imported by: PIL.BlpImagePlugin • PIL.BmpImagePlugin • PIL.EpsImagePlugin • PIL.FliImagePlugin • PIL.GifImagePlugin • PIL.IcnsImagePlugin • PIL.ImImagePlugin • PIL.Image • PIL.ImageShow • PIL.IptcImagePlugin • PIL.Jpeg2KImagePlugin • PIL.JpegImagePlugin • PIL.MpoImagePlugin • PIL.PdfImagePlugin • PIL.PdfParser • PIL.QoiImagePlugin • PIL.SgiImagePlugin • PIL.SpiderImagePlugin • PIL.TiffImagePlugin • PIL._util • PIL.features • _bootsubprocess • _pyi_rth_utils.tempfile • argparse • asyncio.base_events • asyncio.coroutines • asyncio.events • asyncio.proactor_events • asyncio.unix_events • asyncio.windows_utils • bdb • bleak • bleak.backends.bluezdbus.client • bleak.backends.bluezdbus.manager • bleak.backends.bluezdbus.utils • bleak.backends.client • bleak.backends.scanner • bz2 • concurrent.futures.process • concurrent.futures.thread • contextlib • ctypes • dateutil.tz.tz • doctest • email.utils • esp_controller.py • fnmatch • genericpath • getopt • getpass • gettext • glob • gzip • http.cookiejar • http.server • imp • importlib.metadata • importlib.resources._common • importlib.resources._legacy • importlib.resources.abc • inspect • jinja2.bccache • jinja2.environment • jinja2.loaders • jinja2.utils • linecache • locale • logging • lzma • matplotlib • matplotlib._mathtext • matplotlib.backend_bases • matplotlib.backends.backend_webagg_core • matplotlib.cbook • matplotlib.dviread • matplotlib.font_manager • matplotlib.image • matplotlib.pyplot • matplotlib.rcsetup • matplotlib.style.core • matplotlib.texmanager • mimetypes • mpl_toolkits • multiprocessing.connection • multiprocessing.context • multiprocessing.forkserver • multiprocessing.heap • multiprocessing.managers • multiprocessing.pool • multiprocessing.popen_fork • multiprocessing.popen_forkserver • multiprocessing.popen_spawn_posix • multiprocessing.popen_spawn_win32 • multiprocessing.process • multiprocessing.queues • multiprocessing.reduction • multiprocessing.resource_sharer • multiprocessing.resource_tracker • multiprocessing.shared_memory • multiprocessing.spawn • multiprocessing.util • netrc • ntpath • ntpath • numpy • numpy.__config__ • numpy._distributor_init • numpy._pytesttester • numpy.compat.py3k • numpy.core • numpy.core._add_newdocs_scalars • numpy.core.overrides • numpy.ctypeslib • numpy.lib._datasource • numpy.lib.npyio • numpy.lib.utils • numpy.polynomial._polybase • numpy.testing._private.extbuild • numpy.testing._private.utils • packaging._elffile • packaging._manylinux • packaging.markers • pathlib • pdb • pkg_resources • pkg_resources._vendor.appdirs • pkg_resources._vendor.importlib_resources._common • pkg_resources._vendor.importlib_resources._legacy • pkg_resources._vendor.jaraco.context • pkg_resources._vendor.packaging._manylinux • pkg_resources._vendor.packaging._musllinux • pkg_resources._vendor.packaging.markers • pkg_resources._vendor.pyparsing.core • pkgutil • platform • plistlib • posixpath • py_compile • pydoc • pyi_rth__tkinter.py • pyi_rth_inspect.py • pyi_rth_mplconfig.py • pyi_rth_multiprocessing.py • pyi_rth_pkgres.py • pyparsing.core • random • runpy • shlex • shutil • socket • socketserver • ssl • subprocess • sysconfig • tarfile • tempfile • threading • tkinter • tkinter.filedialog • unittest.loader • unittest.main • urllib.request • uuid • webbrowser • xml.sax • xml.sax.saxutils • zipfile

packaging Package

imports: packaging • pkg_resources

imported by: packaging • packaging._elffile • packaging._manylinux • packaging._musllinux • packaging._parser • packaging._structures • packaging._tokenizer • packaging.markers • packaging.metadata • packaging.requirements • packaging.specifiers • packaging.tags • packaging.utils • packaging.version • pkg_resources

packaging._elffile SourceModule

imports: enum • os • packaging • struct • typing

imported by: packaging._manylinux • packaging._musllinux • pkg_resources

packaging._manylinux SourceModule

imports: _manylinux • collections • contextlib • ctypes • functools • os • packaging • packaging._elffile • re • sys • typing • warnings

imported by: packaging.tags • pkg_resources

packaging._musllinux SourceModule

imports: functools • packaging • packaging._elffile • re • subprocess • sys • sysconfig • typing

imported by: packaging.tags • pkg_resources

packaging._parser SourceModule

imports: ast • packaging • packaging._tokenizer • typing

imported by: packaging.markers • packaging.requirements • pkg_resources

packaging._structures SourceModule

imports: packaging

imported by: packaging.version • pkg_resources

packaging._tokenizer SourceModule

imports: contextlib • dataclasses • packaging • packaging.specifiers • re • typing

imported by: packaging._parser • packaging.markers • packaging.requirements • pkg_resources

packaging.markers SourceModule

imports: operator • os • packaging • packaging._parser • packaging._tokenizer • packaging.specifiers • packaging.utils • platform • sys • typing

imported by: packaging.requirements • pkg_resources

packaging.metadata SourceModule

imports: email.feedparser • email.header • email.message • email.parser • email.policy • packaging • sys • typing • typing_extensions

imported by: pkg_resources

packaging.requirements SourceModule

imports: packaging • packaging._parser • packaging._tokenizer • packaging.markers • packaging.specifiers • typing • urllib.parse

imported by: pkg_resources

packaging.specifiers SourceModule

imports: abc • itertools • packaging • packaging.utils • packaging.version • re • typing

imported by: packaging._tokenizer • packaging.markers • packaging.requirements • pkg_resources

packaging.tags SourceModule

imports: importlib.machinery • logging • packaging • packaging._manylinux • packaging._musllinux • platform • subprocess • sys • sysconfig • typing

imported by: packaging.utils • pkg_resources

packaging.utils SourceModule

imports: packaging • packaging.tags • packaging.version • re • typing

imported by: packaging.markers • packaging.specifiers • pkg_resources

packaging.version SourceModule

imports: collections • itertools • packaging • packaging._structures • re • typing

imported by: PIL.Image • matplotlib • matplotlib._mathtext • packaging.specifiers • packaging.utils • pkg_resources

pathlib SourceModule

imports: _collections_abc • errno • fnmatch • functools • grp • io • ntpath • operator • os • posixpath • pwd • re • stat • sys • urllib.parse • warnings

imported by: PIL.Image • PIL._util • importlib.metadata • importlib.resources._common • importlib.resources._legacy • importlib.resources.readers • matplotlib • matplotlib.backends._backend_tk • matplotlib.backends.backend_webagg • matplotlib.backends.backend_webagg_core • matplotlib.cbook • matplotlib.dviread • matplotlib.font_manager • matplotlib.image • matplotlib.pyplot • matplotlib.style.core • matplotlib.texmanager • matplotlib.typing • numpy • numpy.compat.py3k • numpy.testing._private.extbuild • pkg_resources._vendor.importlib_resources._common • pkg_resources._vendor.importlib_resources._compat • pkg_resources._vendor.importlib_resources._legacy • pkg_resources._vendor.importlib_resources.readers • pkg_resources._vendor.pyparsing.core • pkg_resources._vendor.zipp • pyi_rth_pkgres.py • pyi_rth_pkgutil.py • pyparsing.core • zipfile

pdb SourceModule

imports: bdb • cmd • code • dis • functools • getopt • glob • inspect • io • linecache • os • pdb • pprint • pydoc • re • readline • runpy • shlex • signal • sys • tokenize • traceback • typing

imported by: doctest • pdb • pkg_resources._vendor.pyparsing.core • pyparsing.core

pickle SourceModule

imports: _compat_pickle • _pickle • codecs • copyreg • functools • io • itertools • org • pprint • re • struct • sys • types

imported by: jinja2.bccache • logging • multiprocessing.reduction • numpy.compat.py3k • tracemalloc

pickle5 MissingModule

imported by: numpy.compat.py3k

pkg_resources Package

imports: 'pkg_resources.extern.jaraco' • _imp • collections • email.parser • errno • functools • imp • importlib • importlib.machinery • inspect • io • itertools • linecache • ntpath • ntpath • operator • os • packaging • packaging._elffile • packaging._manylinux • packaging._musllinux • packaging._parser • packaging._structures • packaging._tokenizer • packaging.markers • packaging.metadata • packaging.requirements • packaging.specifiers • packaging.tags • packaging.utils • packaging.version • pkg_resources._vendor • pkg_resources._vendor.appdirs • pkg_resources._vendor.importlib_resources • pkg_resources._vendor.importlib_resources._adapters • pkg_resources._vendor.importlib_resources._common • pkg_resources._vendor.importlib_resources._compat • pkg_resources._vendor.importlib_resources._itertools • pkg_resources._vendor.importlib_resources._legacy • pkg_resources._vendor.importlib_resources.abc • pkg_resources._vendor.importlib_resources.readers • pkg_resources._vendor.importlib_resources.simple • pkg_resources._vendor.jaraco • pkg_resources._vendor.jaraco.context • pkg_resources._vendor.jaraco.functools • pkg_resources._vendor.jaraco.text • pkg_resources._vendor.more_itertools • pkg_resources._vendor.more_itertools.more • pkg_resources._vendor.more_itertools.recipes • pkg_resources._vendor.packaging • pkg_resources._vendor.packaging.__about__ • pkg_resources._vendor.packaging._manylinux • pkg_resources._vendor.packaging._musllinux • pkg_resources._vendor.packaging._structures • pkg_resources._vendor.packaging.markers • pkg_resources._vendor.packaging.requirements • pkg_resources._vendor.packaging.specifiers • pkg_resources._vendor.packaging.tags • pkg_resources._vendor.packaging.utils • pkg_resources._vendor.packaging.version • pkg_resources._vendor.pyparsing • pkg_resources._vendor.pyparsing.actions • pkg_resources._vendor.pyparsing.common • pkg_resources._vendor.pyparsing.core • pkg_resources._vendor.pyparsing.exceptions • pkg_resources._vendor.pyparsing.helpers • pkg_resources._vendor.pyparsing.results • pkg_resources._vendor.pyparsing.testing • pkg_resources._vendor.pyparsing.unicode • pkg_resources._vendor.pyparsing.util • pkg_resources._vendor.zipp • pkg_resources.extern • pkg_resources.extern.appdirs • pkg_resources.extern.packaging • pkgutil • platform • plistlib • posixpath • re • stat • sys • sysconfig • tempfile • textwrap • time • types • warnings • zipfile • zipimport

imported by: packaging • pkg_resources._vendor • pkg_resources.extern • pyi_rth_pkgres.py

pkg_resources._vendor Package

imports: pkg_resources

imported by: pkg_resources • pkg_resources._vendor.appdirs • pkg_resources._vendor.importlib_resources • pkg_resources._vendor.jaraco • pkg_resources._vendor.more_itertools • pkg_resources._vendor.packaging • pkg_resources._vendor.pyparsing • pkg_resources._vendor.zipp

pkg_resources._vendor.appdirs SourceModule

imports: 'com.sun' • 'win32com.shell' • _winreg • array • com • ctypes • os • pkg_resources._vendor • platform • sys • win32api • win32com • winreg

imported by: pkg_resources

pkg_resources._vendor.importlib_resources Package

imports: pkg_resources._vendor • pkg_resources._vendor.importlib_resources • pkg_resources._vendor.importlib_resources._adapters • pkg_resources._vendor.importlib_resources._common • pkg_resources._vendor.importlib_resources._legacy • pkg_resources._vendor.importlib_resources.abc • pkg_resources._vendor.importlib_resources.readers

imported by: pkg_resources • pkg_resources._vendor.importlib_resources • pkg_resources._vendor.importlib_resources._adapters • pkg_resources._vendor.importlib_resources._common • pkg_resources._vendor.importlib_resources._compat • pkg_resources._vendor.importlib_resources._itertools • pkg_resources._vendor.importlib_resources._legacy • pkg_resources._vendor.importlib_resources.abc • pkg_resources._vendor.importlib_resources.readers • pkg_resources._vendor.importlib_resources.simple

pkg_resources._vendor.importlib_resources._adapters SourceModule

imports: contextlib • io • pkg_resources._vendor.importlib_resources • pkg_resources._vendor.importlib_resources.abc

imported by: pkg_resources • pkg_resources._vendor.importlib_resources • pkg_resources._vendor.importlib_resources._compat

pkg_resources._vendor.importlib_resources._common SourceModule

imports: contextlib • functools • importlib • os • pathlib • pkg_resources._vendor.importlib_resources • pkg_resources._vendor.importlib_resources._compat • pkg_resources._vendor.importlib_resources.abc • tempfile • types • typing

imported by: pkg_resources • pkg_resources._vendor.importlib_resources • pkg_resources._vendor.importlib_resources._legacy

pkg_resources._vendor.importlib_resources._compat SourceModule

imports: abc • contextlib • pathlib • pkg_resources._vendor.importlib_resources • pkg_resources._vendor.importlib_resources._adapters • pkg_resources._vendor.importlib_resources.readers • pkg_resources._vendor.zipp • sys • typing • zipfile

imported by: pkg_resources • pkg_resources._vendor.importlib_resources._common • pkg_resources._vendor.importlib_resources.abc • pkg_resources._vendor.importlib_resources.readers

pkg_resources._vendor.importlib_resources._itertools SourceModule

imports: itertools • pkg_resources._vendor.importlib_resources • typing

imported by: pkg_resources • pkg_resources._vendor.importlib_resources.readers

pkg_resources._vendor.importlib_resources._legacy SourceModule

imports: functools • os • pathlib • pkg_resources._vendor.importlib_resources • pkg_resources._vendor.importlib_resources._common • types • typing • warnings

imported by: pkg_resources • pkg_resources._vendor.importlib_resources

pkg_resources._vendor.importlib_resources.abc SourceModule

imports: abc • pkg_resources._vendor.importlib_resources • pkg_resources._vendor.importlib_resources._compat • typing

imported by: pkg_resources • pkg_resources._vendor.importlib_resources • pkg_resources._vendor.importlib_resources._adapters • pkg_resources._vendor.importlib_resources._common • pkg_resources._vendor.importlib_resources.readers • pkg_resources._vendor.importlib_resources.simple

pkg_resources._vendor.importlib_resources.readers SourceModule

imports: collections • operator • pathlib • pkg_resources._vendor.importlib_resources • pkg_resources._vendor.importlib_resources._compat • pkg_resources._vendor.importlib_resources._itertools • pkg_resources._vendor.importlib_resources.abc

imported by: pkg_resources • pkg_resources._vendor.importlib_resources • pkg_resources._vendor.importlib_resources._compat

pkg_resources._vendor.importlib_resources.simple SourceModule

imports: abc • io • itertools • pkg_resources._vendor.importlib_resources • pkg_resources._vendor.importlib_resources.abc • typing

imported by: pkg_resources

pkg_resources._vendor.jaraco Package

imports: pkg_resources._vendor

imported by: pkg_resources • pkg_resources._vendor.jaraco.context • pkg_resources._vendor.jaraco.functools • pkg_resources._vendor.jaraco.text

pkg_resources._vendor.jaraco.context SourceModule

imports: contextlib • functools • operator • os • pkg_resources._vendor.jaraco • shutil • subprocess • tempfile

imported by: pkg_resources

pkg_resources._vendor.jaraco.functools SourceModule

imports: 'pkg_resources.extern.more_itertools' • collections • functools • inspect • itertools • pkg_resources._vendor.jaraco • time • types • typing

imported by: pkg_resources

pkg_resources._vendor.jaraco.text Package

imports: 'pkg_resources.extern.importlib_resources' • 'pkg_resources.extern.jaraco' • functools • importlib.resources • itertools • pkg_resources._vendor.jaraco • re • textwrap

imported by: pkg_resources

pkg_resources._vendor.more_itertools Package

imports: pkg_resources._vendor • pkg_resources._vendor.more_itertools.more • pkg_resources._vendor.more_itertools.recipes

imported by: pkg_resources • pkg_resources._vendor.more_itertools.more • pkg_resources._vendor.more_itertools.recipes

pkg_resources._vendor.more_itertools.more SourceModule

imports: collections • collections.abc • functools • heapq • itertools • math • operator • pkg_resources._vendor.more_itertools • pkg_resources._vendor.more_itertools.recipes • queue • random • sys • time • warnings

imported by: pkg_resources • pkg_resources._vendor.more_itertools

pkg_resources._vendor.more_itertools.recipes SourceModule

imports: collections • itertools • operator • pkg_resources._vendor.more_itertools • random • warnings

imported by: pkg_resources • pkg_resources._vendor.more_itertools • pkg_resources._vendor.more_itertools.more

pkg_resources._vendor.packaging Package

imports: pkg_resources._vendor • pkg_resources._vendor.packaging • pkg_resources._vendor.packaging.__about__

imported by: pkg_resources • pkg_resources._vendor.packaging • pkg_resources._vendor.packaging.__about__ • pkg_resources._vendor.packaging._manylinux • pkg_resources._vendor.packaging._musllinux • pkg_resources._vendor.packaging._structures • pkg_resources._vendor.packaging.markers • pkg_resources._vendor.packaging.requirements • pkg_resources._vendor.packaging.specifiers • pkg_resources._vendor.packaging.tags • pkg_resources._vendor.packaging.utils • pkg_resources._vendor.packaging.version

pkg_resources._vendor.packaging.__about__ SourceModule

imports: pkg_resources._vendor.packaging

imported by: pkg_resources • pkg_resources._vendor.packaging

pkg_resources._vendor.packaging._manylinux SourceModule

imports: _manylinux • collections • ctypes • functools • os • pkg_resources._vendor.packaging • re • struct • sys • typing • warnings

imported by: pkg_resources • pkg_resources._vendor.packaging.tags

pkg_resources._vendor.packaging._musllinux SourceModule

imports: contextlib • functools • operator • os • pkg_resources._vendor.packaging • re • struct • subprocess • sys • sysconfig • typing

imported by: pkg_resources • pkg_resources._vendor.packaging.tags

pkg_resources._vendor.packaging._structures SourceModule

imports: pkg_resources._vendor.packaging

imported by: pkg_resources • pkg_resources._vendor.packaging.version

pkg_resources._vendor.packaging.markers SourceModule

imports: 'pkg_resources.extern.pyparsing' • operator • os • pkg_resources._vendor.packaging • pkg_resources._vendor.packaging.specifiers • platform • sys • typing

imported by: pkg_resources • pkg_resources._vendor.packaging.requirements

pkg_resources._vendor.packaging.requirements SourceModule

imports: 'pkg_resources.extern.pyparsing' • pkg_resources._vendor.packaging • pkg_resources._vendor.packaging.markers • pkg_resources._vendor.packaging.specifiers • re • string • typing • urllib.parse

imported by: pkg_resources

pkg_resources._vendor.packaging.specifiers SourceModule

imports: abc • functools • itertools • pkg_resources._vendor.packaging • pkg_resources._vendor.packaging.utils • pkg_resources._vendor.packaging.version • re • typing • warnings

imported by: pkg_resources • pkg_resources._vendor.packaging.markers • pkg_resources._vendor.packaging.requirements

pkg_resources._vendor.packaging.tags SourceModule

imports: importlib.machinery • logging • pkg_resources._vendor.packaging • pkg_resources._vendor.packaging._manylinux • pkg_resources._vendor.packaging._musllinux • platform • sys • sysconfig • typing

imported by: pkg_resources • pkg_resources._vendor.packaging.utils

pkg_resources._vendor.packaging.utils SourceModule

imports: pkg_resources._vendor.packaging • pkg_resources._vendor.packaging.tags • pkg_resources._vendor.packaging.version • re • typing

imported by: pkg_resources • pkg_resources._vendor.packaging.specifiers

pkg_resources._vendor.packaging.version SourceModule

imports: collections • itertools • pkg_resources._vendor.packaging • pkg_resources._vendor.packaging._structures • re • typing • warnings

imported by: pkg_resources • pkg_resources._vendor.packaging.specifiers • pkg_resources._vendor.packaging.utils

pkg_resources._vendor.pyparsing Package

imports: pkg_resources._vendor • pkg_resources._vendor.pyparsing • pkg_resources._vendor.pyparsing.actions • pkg_resources._vendor.pyparsing.common • pkg_resources._vendor.pyparsing.core • pkg_resources._vendor.pyparsing.exceptions • pkg_resources._vendor.pyparsing.helpers • pkg_resources._vendor.pyparsing.results • pkg_resources._vendor.pyparsing.testing • pkg_resources._vendor.pyparsing.unicode • pkg_resources._vendor.pyparsing.util • typing

imported by: pkg_resources • pkg_resources._vendor.pyparsing • pkg_resources._vendor.pyparsing.actions • pkg_resources._vendor.pyparsing.common • pkg_resources._vendor.pyparsing.core • pkg_resources._vendor.pyparsing.diagram • pkg_resources._vendor.pyparsing.exceptions • pkg_resources._vendor.pyparsing.helpers • pkg_resources._vendor.pyparsing.results • pkg_resources._vendor.pyparsing.testing • pkg_resources._vendor.pyparsing.unicode • pkg_resources._vendor.pyparsing.util

pkg_resources._vendor.pyparsing.actions SourceModule

imports: pkg_resources._vendor.pyparsing • pkg_resources._vendor.pyparsing.core • pkg_resources._vendor.pyparsing.exceptions • pkg_resources._vendor.pyparsing.util

imported by: pkg_resources • pkg_resources._vendor.pyparsing • pkg_resources._vendor.pyparsing.core

pkg_resources._vendor.pyparsing.common SourceModule

imports: datetime • pkg_resources._vendor.pyparsing • pkg_resources._vendor.pyparsing.core • pkg_resources._vendor.pyparsing.helpers

imported by: pkg_resources • pkg_resources._vendor.pyparsing

pkg_resources._vendor.pyparsing.core SourceModule

imports: abc • collections.abc • copy • enum • functools • operator • os • pathlib • pdb • pkg_resources._vendor.pyparsing • pkg_resources._vendor.pyparsing.actions • pkg_resources._vendor.pyparsing.diagram • pkg_resources._vendor.pyparsing.exceptions • pkg_resources._vendor.pyparsing.results • pkg_resources._vendor.pyparsing.testing • pkg_resources._vendor.pyparsing.unicode • pkg_resources._vendor.pyparsing.util • re • string • sys • threading • traceback • types • typing • warnings

imported by: pkg_resources • pkg_resources._vendor.pyparsing • pkg_resources._vendor.pyparsing.actions • pkg_resources._vendor.pyparsing.common • pkg_resources._vendor.pyparsing.exceptions • pkg_resources._vendor.pyparsing.helpers • pkg_resources._vendor.pyparsing.testing

pkg_resources._vendor.pyparsing.diagram Package

imports: inspect • io • jinja2 • pkg_resources._vendor.pyparsing • pyparsing • railroad • typing

imported by: pkg_resources._vendor.pyparsing.core

pkg_resources._vendor.pyparsing.exceptions SourceModule

imports: inspect • pkg_resources._vendor.pyparsing • pkg_resources._vendor.pyparsing.core • pkg_resources._vendor.pyparsing.unicode • pkg_resources._vendor.pyparsing.util • re • sys • typing

imported by: pkg_resources • pkg_resources._vendor.pyparsing • pkg_resources._vendor.pyparsing.actions • pkg_resources._vendor.pyparsing.core

pkg_resources._vendor.pyparsing.helpers SourceModule

imports: html.entities • pkg_resources._vendor.pyparsing • pkg_resources._vendor.pyparsing.core • pkg_resources._vendor.pyparsing.util • re • typing

imported by: pkg_resources • pkg_resources._vendor.pyparsing • pkg_resources._vendor.pyparsing.common

pkg_resources._vendor.pyparsing.results SourceModule

imports: collections.abc • pkg_resources._vendor.pyparsing • pprint • typing • weakref

imported by: pkg_resources • pkg_resources._vendor.pyparsing • pkg_resources._vendor.pyparsing.core

pkg_resources._vendor.pyparsing.testing SourceModule

imports: contextlib • pkg_resources._vendor.pyparsing • pkg_resources._vendor.pyparsing.core • typing

imported by: pkg_resources • pkg_resources._vendor.pyparsing • pkg_resources._vendor.pyparsing.core

pkg_resources._vendor.pyparsing.unicode SourceModule

imports: itertools • pkg_resources._vendor.pyparsing • sys • typing

imported by: pkg_resources • pkg_resources._vendor.pyparsing • pkg_resources._vendor.pyparsing.core • pkg_resources._vendor.pyparsing.exceptions

pkg_resources._vendor.pyparsing.util SourceModule

imports: collections • functools • itertools • pkg_resources._vendor.pyparsing • types • typing • warnings

imported by: pkg_resources • pkg_resources._vendor.pyparsing • pkg_resources._vendor.pyparsing.actions • pkg_resources._vendor.pyparsing.core • pkg_resources._vendor.pyparsing.exceptions • pkg_resources._vendor.pyparsing.helpers

pkg_resources._vendor.zipp SourceModule

imports: collections • contextlib • io • itertools • pathlib • pkg_resources._vendor • posixpath • sys • zipfile

imported by: pkg_resources • pkg_resources._vendor.importlib_resources._compat

pkg_resources.extern Package

imports: importlib.util • pkg_resources • pkg_resources.extern.appdirs • pkg_resources.extern.packaging • sys

imported by: pkg_resources

pkg_resources.extern.appdirs MissingModule

imported by: pkg_resources • pkg_resources.extern

pkg_resources.extern.packaging MissingModule

imported by: pkg_resources • pkg_resources.extern

pkgutil SourceModule

imports: collections • functools • importlib • importlib.machinery • importlib.util • inspect • marshal • ntpath • os • re • sys • types • warnings • zipimport

imported by: dateutil.zoneinfo • pkg_resources • pydoc • pyi_rth_pkgutil.py • runpy

platform SourceModule

imports: 'java.lang' • _winreg • collections • functools • itertools • java • os • re • socket • struct • subprocess • sys • vms_lib • winreg

imported by: bleak.backends.client • bleak.backends.scanner • numpy.lib.utils • numpy.testing._private.utils • packaging.markers • packaging.tags • pkg_resources • pkg_resources._vendor.appdirs • pkg_resources._vendor.packaging.markers • pkg_resources._vendor.packaging.tags • pydoc • uuid

plistlib SourceModule

imports: binascii • codecs • datetime • enum • io • itertools • os • re • struct • xml.parsers.expat

imported by: pkg_resources

posix MissingModule

imports: resource

imported by: importlib._bootstrap_external • os • posixpath • shutil

posixpath SourceModule

imports: genericpath • os • posix • pwd • re • stat • sys

imported by: esp_controller.py • fnmatch • http.server • importlib.metadata • jinja2.loaders • mimetypes • os • pathlib • pkg_resources • pkg_resources._vendor.zipp • urllib.request • zipfile

pprint SourceModule

imports: collections • dataclasses • io • re • sys • time • types

imported by: jinja2.ext • jinja2.utils • matplotlib • numpy.lib.utils • numpy.testing._private.utils • pdb • pickle • pkg_resources._vendor.pyparsing.results • pyparsing.results • sysconfig • unittest.case

psutil MissingModule

imported by: numpy.testing._private.utils

pwd MissingModule

imported by: getpass • http.server • netrc • pathlib • posixpath • shutil • subprocess • tarfile • webbrowser

py_compile SourceModule

imports: argparse • enum • importlib._bootstrap_external • importlib.machinery • importlib.util • ntpath • os • sys • traceback

imported by: zipfile

pydoc SourceModule

imports: __future__ • builtins • collections • email.message • getopt • http.server • importlib._bootstrap • importlib._bootstrap_external • importlib.machinery • importlib.util • inspect • io • os • pkgutil • platform • pydoc_data.topics • re • reprlib • select • subprocess • sys • sysconfig • tempfile • textwrap • threading • time • tokenize • traceback • tty • urllib.parse • warnings • webbrowser

imported by: numpy.lib.utils • pdb

pydoc_data Package

imported by: pydoc_data.topics

pydoc_data.topics SourceModule

imports: pydoc_data

imported by: pydoc

pyexpat C:\Python311\DLLs\pyexpat.pyd

imported by: xml.parsers.expat

pyimod02_importers MissingModule

imported by: pyi_rth_pkgres.py • pyi_rth_pkgutil.py

pyparsing Package

imports: pyparsing • pyparsing.Word • pyparsing.actions • pyparsing.common • pyparsing.core • pyparsing.exceptions • pyparsing.helpers • pyparsing.results • pyparsing.testing • pyparsing.unicode • pyparsing.util • typing

imported by: matplotlib._fontconfig_pattern • matplotlib._mathtext • pkg_resources._vendor.pyparsing.diagram • pyparsing • pyparsing.actions • pyparsing.common • pyparsing.core • pyparsing.diagram • pyparsing.exceptions • pyparsing.helpers • pyparsing.results • pyparsing.testing • pyparsing.unicode • pyparsing.util

pyparsing.Word MissingModule

imported by: pyparsing • pyparsing.unicode

pyparsing.actions SourceModule

imports: pyparsing • pyparsing.core • pyparsing.exceptions • pyparsing.util

imported by: pyparsing • pyparsing.core

pyparsing.common SourceModule

imports: datetime • pyparsing • pyparsing.core • pyparsing.helpers

imported by: pyparsing

pyparsing.core SourceModule

imports: abc • collections • collections.abc • copy • enum • functools • operator • os • pathlib • pdb • pyparsing • pyparsing.actions • pyparsing.diagram • pyparsing.exceptions • pyparsing.results • pyparsing.testing • pyparsing.unicode • pyparsing.util • re • string • sys • threading • traceback • types • typing • warnings

imported by: pyparsing • pyparsing.actions • pyparsing.common • pyparsing.exceptions • pyparsing.helpers • pyparsing.testing

pyparsing.diagram Package

imports: inspect • io • jinja2 • pyparsing • railroad • typing

imported by: pyparsing.core

pyparsing.exceptions SourceModule

imports: inspect • pyparsing • pyparsing.core • pyparsing.unicode • pyparsing.util • re • sys • typing

imported by: pyparsing • pyparsing.actions • pyparsing.core

pyparsing.helpers SourceModule

imports: html.entities • pyparsing • pyparsing.core • pyparsing.util • re • sys • typing

imported by: pyparsing • pyparsing.common

pyparsing.results SourceModule

imports: collections.abc • pprint • pyparsing • typing

imported by: pyparsing • pyparsing.core

pyparsing.testing SourceModule

imports: contextlib • pyparsing • pyparsing.core • typing

imported by: pyparsing • pyparsing.core

pyparsing.unicode SourceModule

imports: itertools • pyparsing • pyparsing.Word • sys • typing

imported by: pyparsing • pyparsing.core • pyparsing.exceptions

pyparsing.util SourceModule

imports: collections • functools • inspect • itertools • pyparsing • types • typing • warnings

imported by: pyparsing • pyparsing.actions • pyparsing.core • pyparsing.exceptions • pyparsing.helpers

queue SourceModule

imports: _queue • collections • heapq • threading • time • types

imported by: concurrent.futures.process • concurrent.futures.thread • multiprocessing.dummy • multiprocessing.dummy.connection • multiprocessing.managers • multiprocessing.pool • multiprocessing.queues • pkg_resources._vendor.more_itertools.more

quopri SourceModule

imports: binascii • getopt • io • sys

imported by: email.encoders • email.message • encodings.quopri_codec

railroad MissingModule

imported by: pkg_resources._vendor.pyparsing.diagram • pyparsing.diagram

random SourceModule

imports: _collections_abc • _random • _sha512 • bisect • hashlib • itertools • math • operator • os • statistics • time • warnings

imported by: PIL.ImagePalette • email.generator • email.utils • jinja2.filters • jinja2.utils • matplotlib.backends.backend_webagg • pkg_resources._vendor.more_itertools.more • pkg_resources._vendor.more_itertools.recipes • secrets • statistics • tempfile • uuid

re Package

imports: copyreg • enum • functools • re • re._compiler • re._constants • re._parser • warnings

imported by: PIL.EpsImagePlugin • PIL.GimpPaletteFile • PIL.ImImagePlugin • PIL.Image • PIL.ImageColor • PIL.ImageOps • PIL.ImtImagePlugin • PIL.PdfParser • PIL.PngImagePlugin • PIL.XbmImagePlugin • PIL.XpmImagePlugin • _pydecimal • _sre • _strptime • argparse • base64 • bleak.backends.bluezdbus.signals • bleak.backends.bluezdbus.utils • bleak.backends.bluezdbus.version • csv • dataclasses • dateutil.parser._parser • dateutil.parser.isoparser • dateutil.rrule • difflib • doctest • email._encoded_words • email._header_value_parser • email.feedparser • email.generator • email.header • email.message • email.policy • email.quoprimime • email.utils • encodings.idna • esp_controller.py • fnmatch • fractions • ftplib • gettext • glob • html • http.client • http.cookiejar • importlib.metadata • importlib.metadata._adapters • importlib.metadata._text • inspect • jinja2._identifier • jinja2.ext • jinja2.filters • jinja2.lexer • jinja2.utils • json.decoder • json.encoder • json.scanner • locale • logging • markupsafe • matplotlib • matplotlib._afm • matplotlib._api • matplotlib._fontconfig_pattern • matplotlib._mathtext • matplotlib.artist • matplotlib.backend_tools • matplotlib.colors • matplotlib.dates • matplotlib.dviread • matplotlib.font_manager • matplotlib.pyplot • matplotlib.rcsetup • numpy._typing._add_docstring • numpy.core._internal • numpy.lib._version • numpy.lib.function_base • numpy.lib.npyio • numpy.lib.polynomial • numpy.lib.utils • numpy.ma.core • numpy.testing._private.utils • packaging._manylinux • packaging._musllinux • packaging._tokenizer • packaging.specifiers • packaging.utils • packaging.version • pathlib • pdb • pickle • pkg_resources • pkg_resources._vendor.jaraco.text • pkg_resources._vendor.packaging._manylinux • pkg_resources._vendor.packaging._musllinux • pkg_resources._vendor.packaging.requirements • pkg_resources._vendor.packaging.specifiers • pkg_resources._vendor.packaging.utils • pkg_resources._vendor.packaging.version • pkg_resources._vendor.pyparsing.core • pkg_resources._vendor.pyparsing.exceptions • pkg_resources._vendor.pyparsing.helpers • pkgutil • platform • plistlib • posixpath • pprint • pydoc • pyparsing.core • pyparsing.exceptions • pyparsing.helpers • re • re._casefix • re._compiler • re._constants • re._parser • shlex • sre_compile • sre_constants • sre_parse • string • sysconfig • tarfile • textwrap • tkinter • tokenize • typing • unittest.case • unittest.loader • urllib.parse • urllib.request • warnings

re._casefix SourceModule

imports: re

imported by: esp_controller.py • re._compiler

re._compiler SourceModule

imports: _sre • re • re._casefix • re._constants • re._parser • sys

imported by: esp_controller.py • re • sre_compile

re._constants SourceModule

imports: _sre • re

imported by: esp_controller.py • re • re._compiler • re._parser • sre_constants

re._parser SourceModule

imports: re • re._constants • unicodedata • warnings

imported by: esp_controller.py • re • re._compiler • sre_parse

readline MissingModule

imported by: cmd • code • pdb

reprlib SourceModule

imports: _thread • builtins • itertools

imported by: asyncio.base_futures • asyncio.base_tasks • asyncio.format_helpers • bdb • collections • esp_controller.py • functools • pydoc

resource MissingModule

imported by: posix

runpy SourceModule

imports: importlib.machinery • importlib.util • io • os • pkgutil • sys • warnings

imported by: multiprocessing.spawn • pdb

secrets SourceModule

imports: base64 • binascii • hmac • random

imported by: multiprocessing.shared_memory

select C:\Python311\DLLs\select.pyd

imported by: http.server • pydoc • selectors • subprocess

selectors SourceModule

imports: abc • collections • collections.abc • math • select • sys

imported by: asyncio.selector_events • asyncio.unix_events • multiprocessing.connection • multiprocessing.forkserver • socket • socketserver • subprocess

setuptools_scm MissingModule

imported by: matplotlib

shlex SourceModule

imports: collections • io • os • re • sys • warnings

imported by: PIL.ImageShow • matplotlib.cbook • netrc • pdb • webbrowser

shutil SourceModule

imports: bz2 • collections • errno • fnmatch • grp • lzma • nt • os • posix • pwd • stat • sys • tarfile • zipfile • zlib

imported by: PIL.EpsImagePlugin • PIL.ImageShow • argparse • http.server • matplotlib • multiprocessing.util • numpy.lib._datasource • numpy.testing._private.utils • pkg_resources._vendor.jaraco.context • pyi_rth_mplconfig.py • tarfile • tempfile • uuid • webbrowser • zipfile

signal SourceModule

imports: _signal • enum

imported by: asyncio.proactor_events • asyncio.runners • asyncio.unix_events • matplotlib.backends.backend_webagg • multiprocessing.forkserver • multiprocessing.managers • multiprocessing.popen_fork • multiprocessing.popen_spawn_win32 • multiprocessing.process • multiprocessing.resource_sharer • multiprocessing.resource_tracker • pdb • subprocess • unittest.signals

six SourceModule

imports: StringIO • __future__ • functools • importlib.util • io • itertools • operator • struct • sys • types

imported by: dateutil.parser._parser • dateutil.parser.isoparser • dateutil.relativedelta • dateutil.rrule • dateutil.tz._common • dateutil.tz.tz • dateutil.tz.win • six.moves

six.moves RuntimePackage

imports: _thread • six • six.moves.range • winreg

imported by: dateutil.rrule • dateutil.tz._factories • dateutil.tz.tz • dateutil.tz.win

six.moves.range MissingModule

imported by: dateutil.rrule • six.moves

socket SourceModule

imports: _socket • array • enum • errno • io • os • selectors • sys

imported by: _ssl • asyncio.base_events • asyncio.events • asyncio.proactor_events • asyncio.selector_events • asyncio.streams • asyncio.trsock • asyncio.unix_events • asyncio.windows_events • email.utils • ftplib • http.client • http.server • multiprocessing.connection • multiprocessing.forkserver • multiprocessing.reduction • multiprocessing.resource_sharer • platform • socketserver • ssl • urllib.request • uuid • webbrowser

socketserver SourceModule

imports: io • os • selectors • socket • sys • threading • time • traceback

imported by: http.server

sre_compile SourceModule

imports: re • re._compiler • warnings

imported by: esp_controller.py

sre_constants SourceModule

imports: re • re._constants • warnings

imported by: esp_controller.py

sre_parse SourceModule

imports: re • re._parser • warnings

imported by: esp_controller.py

ssl SourceModule

imports: _ssl • base64 • calendar • collections • enum • errno • os • socket • sys • time • warnings

imported by: asyncio.base_events • asyncio.selector_events • asyncio.sslproto • ftplib • http.client • matplotlib • urllib.request

stat SourceModule

imports: _stat

imported by: asyncio.base_events • asyncio.unix_events • esp_controller.py • genericpath • glob • jinja2.bccache • netrc • ntpath • os • pathlib • pkg_resources • posixpath • shutil • tarfile • zipfile

statistics SourceModule

imports: _statistics • bisect • collections • decimal • fractions • functools • itertools • math • numbers • operator • random • sys

imported by: random

string SourceModule

imports: _string • collections • re

imported by: cmd • dateutil.parser._parser • email._encoded_words • email._header_value_parser • email.quoprimime • jinja2.sandbox • logging • markupsafe • matplotlib._mathtext • ntpath • nturl2path • pkg_resources._vendor.packaging.requirements • pkg_resources._vendor.pyparsing.core • pyparsing.core • urllib.request

stringprep SourceModule

imports: unicodedata

imported by: encodings.idna

struct SourceModule

imports: _struct

imported by: PIL.BlpImagePlugin • PIL.DdsImagePlugin • PIL.FtexImagePlugin • PIL.IcnsImagePlugin • PIL.Image • PIL.ImageFile • PIL.Jpeg2KImagePlugin • PIL.JpegImagePlugin • PIL.McIdasImagePlugin • PIL.MpoImagePlugin • PIL.MspImagePlugin • PIL.PngImagePlugin • PIL.SgiImagePlugin • PIL.SpiderImagePlugin • PIL.TiffImagePlugin • PIL._binary • asyncio.windows_events • base64 • ctypes • dateutil.tz.tz • dateutil.tz.win • gettext • gzip • matplotlib.dviread • multiprocessing.connection • multiprocessing.forkserver • multiprocessing.shared_memory • multiprocessing.synchronize • numpy.lib.format • packaging._elffile • pickle • pkg_resources._vendor.packaging._manylinux • pkg_resources._vendor.packaging._musllinux • platform • plistlib • six • tarfile • zipfile

subprocess SourceModule

imports: _posixsubprocess • _winapi • builtins • contextlib • errno • fcntl • grp • io • locale • msvcrt • os • pwd • select • selectors • signal • sys • threading • time • types • warnings

imported by: PIL.EpsImagePlugin • PIL.GifImagePlugin • PIL.ImageShow • PIL.JpegImagePlugin • _aix_support • asyncio.base_events • asyncio.base_subprocess • asyncio.events • asyncio.subprocess • asyncio.unix_events • asyncio.windows_utils • http.server • matplotlib • matplotlib.cbook • matplotlib.dviread • matplotlib.font_manager • matplotlib.texmanager • multiprocessing.util • numpy.testing._private.utils • os • packaging._musllinux • packaging.tags • pkg_resources._vendor.jaraco.context • pkg_resources._vendor.packaging._musllinux • platform • pydoc • pyi_rth_multiprocessing.py • uuid • webbrowser

sys (builtin module)

imported by: PIL.EpsImagePlugin • PIL.IcnsImagePlugin • PIL.Image • PIL.ImageCms • PIL.ImageFile • PIL.ImageMode • PIL.ImageQt • PIL.ImageShow • PIL.JpegImagePlugin • PIL.PyAccess • PIL.SpiderImagePlugin • PIL.features • _aix_support • _collections_abc • _compression • _pydecimal • _pyi_rth_utils • _pyi_rth_utils.tempfile • argparse • ast • asyncio • asyncio.base_events • asyncio.coroutines • asyncio.events • asyncio.format_helpers • asyncio.futures • asyncio.runners • asyncio.streams • asyncio.unix_events • asyncio.windows_events • asyncio.windows_utils • base64 • bdb • bleak • bleak.backends.bluezdbus.client • bleak.backends.client • bleak.backends.corebluetooth.CentralManagerDelegate • bleak.backends.corebluetooth.PeripheralDelegate • bleak.backends.corebluetooth.client • bleak.backends.p4android.scanner • bleak.backends.winrt.characteristic • bleak.backends.winrt.client • bleak.backends.winrt.descriptor • bleak.backends.winrt.scanner • bleak.backends.winrt.service • calendar • cmd • code • codecs • collections • concurrent.futures.process • contextlib • ctypes • ctypes._endian • dataclasses • datetime • dateutil.rrule • dateutil.tz.tz • dis • doctest • email._header_value_parser • email.generator • email.iterators • email.policy • encodings • encodings.rot_13 • encodings.utf_16 • encodings.utf_32 • enum • fractions • ftplib • getopt • getpass • gettext • glob • gzip • http.client • http.server • imp • importlib • importlib._bootstrap_external • importlib.metadata • importlib.util • inspect • jinja2.bccache • jinja2.debug • jinja2.lexer • jinja2.loaders • jinja2.runtime • linecache • locale • logging • markupsafe • matplotlib • matplotlib._api • matplotlib.backend_bases • matplotlib.backends._backend_tk • matplotlib.backends.backend_webagg • matplotlib.cbook • matplotlib.dviread • matplotlib.font_manager • matplotlib.pyplot • matplotlib.style.core • matplotlib.tri._triangulation • mimetypes • multiprocessing • multiprocessing.connection • multiprocessing.context • multiprocessing.dummy • multiprocessing.forkserver • multiprocessing.heap • multiprocessing.managers • multiprocessing.popen_spawn_win32 • multiprocessing.process • multiprocessing.queues • multiprocessing.reduction • multiprocessing.resource_sharer • multiprocessing.resource_tracker • multiprocessing.spawn • multiprocessing.synchronize • multiprocessing.util • ntpath • numpy • numpy.__config__ • numpy._pytesttester • numpy.compat.py3k • numpy.core • numpy.core._add_newdocs_scalars • numpy.core._internal • numpy.core.arrayprint • numpy.core.numeric • numpy.ctypeslib • numpy.lib.function_base • numpy.lib.index_tricks • numpy.lib.utils • numpy.matrixlib.defmatrix • numpy.testing._private.extbuild • numpy.testing._private.utils • os • packaging._manylinux • packaging._musllinux • packaging.markers • packaging.metadata • packaging.tags • pathlib • pdb • pickle • pkg_resources • pkg_resources._vendor.appdirs • pkg_resources._vendor.importlib_resources._compat • pkg_resources._vendor.more_itertools.more • pkg_resources._vendor.packaging._manylinux • pkg_resources._vendor.packaging._musllinux • pkg_resources._vendor.packaging.markers • pkg_resources._vendor.packaging.tags • pkg_resources._vendor.pyparsing.core • pkg_resources._vendor.pyparsing.exceptions • pkg_resources._vendor.pyparsing.unicode • pkg_resources._vendor.zipp • pkg_resources.extern • pkgutil • platform • posixpath • pprint • py_compile • pydoc • pyi_rth__tkinter.py • pyi_rth_inspect.py • pyi_rth_multiprocessing.py • pyi_rth_pkgres.py • pyi_rth_pkgutil.py • pyparsing.core • pyparsing.exceptions • pyparsing.helpers • pyparsing.unicode • quopri • re._compiler • runpy • selectors • shlex • shutil • six • socket • socketserver • ssl • statistics • subprocess • sysconfig • tarfile • tempfile • threading • tkinter • tkinter.filedialog • tokenize • traceback • types • typing • typing_extensions • unittest.case • unittest.loader • unittest.main • unittest.result • unittest.runner • unittest.suite • urllib.parse • urllib.request • uuid • warnings • weakref • webbrowser • xml.parsers.expat • xml.sax • xml.sax._exceptions • xml.sax.expatreader • xml.sax.saxutils • xmlrpc.client • zipfile • zipimport

sysconfig SourceModule

imports: _aix_support • _imp • ntpath • os • pprint • re • sys • types • warnings

imported by: _aix_support • numpy.ctypeslib • numpy.testing._private.extbuild • numpy.testing._private.utils • packaging._musllinux • packaging.tags • pkg_resources • pkg_resources._vendor.packaging._musllinux • pkg_resources._vendor.packaging.tags • pydoc

tarfile SourceModule

imports: argparse • builtins • bz2 • copy • grp • gzip • io • lzma • os • pwd • re • shutil • stat • struct • sys • time • zlib

imported by: dateutil.zoneinfo • shutil

tempfile SourceModule

imports: _thread • errno • functools • io • os • random • shutil • sys • types • warnings • weakref

imported by: PIL.EpsImagePlugin • PIL.Image • PIL.IptcImagePlugin • PIL.JpegImagePlugin • _pyi_rth_utils.tempfile • asyncio.windows_utils • importlib.resources._common • jinja2.bccache • matplotlib • matplotlib.texmanager • multiprocessing.connection • multiprocessing.heap • multiprocessing.synchronize • multiprocessing.util • numpy.lib._datasource • numpy.testing._private.utils • pkg_resources • pkg_resources._vendor.importlib_resources._common • pkg_resources._vendor.jaraco.context • pydoc • urllib.request • urllib.response • webbrowser

termios MissingModule

imported by: getpass • tty

textwrap SourceModule

imports: re

imported by: argparse • importlib.metadata • importlib.metadata._adapters • jinja2.filters • matplotlib.patches • matplotlib.scale • matplotlib.transforms • mpl_toolkits.mplot3d.axes3d • numpy._typing._add_docstring • numpy.lib.utils • numpy.ma.core • pkg_resources • pkg_resources._vendor.jaraco.text • pydoc • traceback

threading SourceModule

imports: _collections • _thread • _threading_local • _weakrefset • collections • functools • itertools • os • sys • time • traceback • warnings

imported by: _threading_local • asyncio.base_events • asyncio.events • asyncio.mixins • asyncio.proactor_events • asyncio.runners • asyncio.unix_events • bleak.backends.corebluetooth.CentralManagerDelegate • concurrent.futures._base • concurrent.futures.process • concurrent.futures.thread • esp_controller.py • http.cookiejar • jinja2.utils • logging • matplotlib.backends.backend_webagg • matplotlib.figure • matplotlib.font_manager • matplotlib.pyplot • multiprocessing.context • multiprocessing.dummy • multiprocessing.forkserver • multiprocessing.heap • multiprocessing.managers • multiprocessing.pool • multiprocessing.process • multiprocessing.queues • multiprocessing.resource_sharer • multiprocessing.resource_tracker • multiprocessing.synchronize • multiprocessing.util • pkg_resources._vendor.pyparsing.core • pydoc • pyi_rth_multiprocessing.py • pyparsing.core • queue • socketserver • subprocess • webbrowser • zipfile

threadpoolctl MissingModule

imported by: numpy.lib.utils

time (builtin module)

imports: _strptime

imported by: PIL.PdfImagePlugin • PIL.PdfParser • _datetime • _strptime • asyncio.base_events • asyncio.windows_events • concurrent.futures._base • datetime • dateutil.parser._parser • dateutil.tz.tz • email._parseaddr • email.generator • email.utils • gc • gzip • http.cookiejar • http.server • logging • matplotlib.backend_bases • matplotlib.backend_tools • matplotlib.cbook • matplotlib.legend • matplotlib.pyplot • multiprocessing.connection • multiprocessing.managers • multiprocessing.pool • multiprocessing.queues • multiprocessing.synchronize • numpy.testing._private.utils • pkg_resources • pkg_resources._vendor.jaraco.functools • pkg_resources._vendor.more_itertools.more • pprint • pydoc • queue • random • socketserver • ssl • subprocess • tarfile • threading • unittest.runner • urllib.request • uuid • xmlrpc.client • zipfile • zipimport

tkinter Package

imports: _tkinter • collections • enum • os • re • sys • tkinter.commondialog • tkinter.constants • tkinter.messagebox • tkinter.ttk • traceback • types

imported by: esp_controller.py • matplotlib.backends._backend_tk • tkinter.commondialog • tkinter.constants • tkinter.dialog • tkinter.filedialog • tkinter.font • tkinter.messagebox • tkinter.simpledialog • tkinter.ttk

tkinter.commondialog SourceModule

imports: tkinter

imported by: tkinter • tkinter.filedialog • tkinter.messagebox

tkinter.constants SourceModule

imports: tkinter

imported by: tkinter

tkinter.dialog SourceModule

imports: tkinter

imported by: tkinter.filedialog

tkinter.filedialog SourceModule

imports: fnmatch • locale • os • sys • tkinter • tkinter.commondialog • tkinter.dialog • tkinter.simpledialog

imported by: matplotlib.backends._backend_tk

tkinter.font SourceModule

imports: itertools • tkinter

imported by: matplotlib.backends._backend_tk

tkinter.messagebox SourceModule

imports: tkinter • tkinter.commondialog

imported by: matplotlib.backends._backend_tk • tkinter • tkinter.simpledialog

tkinter.simpledialog SourceModule

imports: tkinter • tkinter.messagebox

imported by: matplotlib.backends._backend_tk • tkinter.filedialog

tkinter.ttk SourceModule

imports: tkinter

imported by: esp_controller.py • tkinter

token SourceModule

imported by: inspect • tokenize

tokenize SourceModule

imports: _tokenize • argparse • builtins • codecs • collections • functools • io • itertools • re • sys • token

imported by: imp • importlib._bootstrap_external • inspect • linecache • numpy.lib.format • pdb • pydoc

tornado MissingModule

imported by: matplotlib.backends.backend_webagg • matplotlib.backends.backend_webagg_core

traceback SourceModule

imports: ast • collections.abc • contextlib • itertools • linecache • sys • textwrap

imported by: asyncio.base_events • asyncio.base_tasks • asyncio.coroutines • asyncio.format_helpers • code • concurrent.futures.process • doctest • esp_controller.py • http.cookiejar • logging • matplotlib.cbook • multiprocessing.managers • multiprocessing.pool • multiprocessing.process • multiprocessing.queues • multiprocessing.util • numpy.testing._private.utils • pdb • pkg_resources._vendor.pyparsing.core • py_compile • pydoc • pyparsing.core • socketserver • threading • tkinter • unittest.case • unittest.loader • unittest.result • warnings

tracemalloc SourceModule

imports: _tracemalloc • collections.abc • fnmatch • functools • linecache • ntpath • pickle

imported by: warnings

tty SourceModule

imports: termios

imported by: pydoc

types SourceModule

imports: _collections_abc • functools • sys

imported by: _weakrefset • asyncio.coroutines • asyncio.futures • asyncio.queues • asyncio.tasks • asyncio.timeouts • bleak_winrt • concurrent.futures._base • concurrent.futures.thread • contextlib • copy • ctypes • dataclasses • difflib • dis • email.headerregistry • enum • esp_controller.py • functools • imp • importlib.metadata._functools • importlib.resources._common • importlib.resources._legacy • importlib.util • inspect • jinja2.bccache • jinja2.debug • jinja2.environment • jinja2.loaders • jinja2.sandbox • jinja2.utils • logging • matplotlib._mathtext • matplotlib.axes._base • matplotlib.backend_tools • matplotlib.cbook • matplotlib.patches • matplotlib.projections.polar • multiprocessing.managers • multiprocessing.pool • multiprocessing.queues • multiprocessing.shared_memory • multiprocessing.spawn • numpy._utils._inspect • numpy.array_api._array_object • numpy.core.fromnumeric • numpy.core.function_base • numpy.lib.utils • pickle • pkg_resources • pkg_resources._vendor.importlib_resources._common • pkg_resources._vendor.importlib_resources._legacy • pkg_resources._vendor.jaraco.functools • pkg_resources._vendor.pyparsing.core • pkg_resources._vendor.pyparsing.util • pkgutil • pprint • pyparsing.core • pyparsing.util • queue • six • subprocess • sysconfig • tempfile • tkinter • typing • typing_extensions • unittest.case • unittest.loader • urllib.parse

typing SourceModule

imports: _typing • abc • collections • collections.abc • contextlib • functools • operator • re • sys • types • warnings

imported by: asyncio.staggered • asyncio.timeouts • bleak • bleak.backends.bluezdbus.advertisement_monitor • bleak.backends.bluezdbus.characteristic • bleak.backends.bluezdbus.client • bleak.backends.bluezdbus.defs • bleak.backends.bluezdbus.manager • bleak.backends.bluezdbus.scanner • bleak.backends.bluezdbus.service • bleak.backends.bluezdbus.signals • bleak.backends.bluezdbus.version • bleak.backends.characteristic • bleak.backends.client • bleak.backends.corebluetooth.CentralManagerDelegate • bleak.backends.corebluetooth.PeripheralDelegate • bleak.backends.corebluetooth.characteristic • bleak.backends.corebluetooth.client • bleak.backends.corebluetooth.scanner • bleak.backends.corebluetooth.service • bleak.backends.descriptor • bleak.backends.device • bleak.backends.p4android.characteristic • bleak.backends.p4android.client • bleak.backends.p4android.scanner • bleak.backends.p4android.service • bleak.backends.scanner • bleak.backends.service • bleak.backends.winrt.characteristic • bleak.backends.winrt.client • bleak.backends.winrt.scanner • bleak.backends.winrt.service • bleak.exc • bleak.uuids • contourpy • contourpy.array • contourpy.convert • contourpy.dechunk • contourpy.typecheck • cycler • functools • importlib.metadata • importlib.metadata._meta • importlib.resources._common • importlib.resources._itertools • importlib.resources._legacy • importlib.resources.abc • jinja2.async_utils • jinja2.bccache • jinja2.compiler • jinja2.debug • jinja2.defaults • jinja2.environment • jinja2.exceptions • jinja2.ext • jinja2.filters • jinja2.idtracking • jinja2.lexer • jinja2.loaders • jinja2.nodes • jinja2.optimizer • jinja2.parser • jinja2.runtime • jinja2.sandbox • jinja2.tests • jinja2.utils • jinja2.visitor • markupsafe • markupsafe._native • matplotlib._mathtext • matplotlib._version • matplotlib.font_manager • matplotlib.pyplot • matplotlib.typing • numpy._typing • numpy._typing._array_like • numpy._typing._char_codes • numpy._typing._dtype_like • numpy._typing._nbit • numpy._typing._nested_sequence • numpy._typing._scalars • numpy._typing._shape • numpy.array_api._array_object • numpy.array_api._creation_functions • numpy.array_api._data_type_functions • numpy.array_api._manipulation_functions • numpy.array_api._searching_functions • numpy.array_api._set_functions • numpy.array_api._statistical_functions • numpy.array_api._typing • numpy.array_api._utility_functions • numpy.array_api.linalg • numpy.linalg.linalg • packaging._elffile • packaging._manylinux • packaging._musllinux • packaging._parser • packaging._tokenizer • packaging.markers • packaging.metadata • packaging.requirements • packaging.specifiers • packaging.tags • packaging.utils • packaging.version • pdb • pkg_resources._vendor.importlib_resources._common • pkg_resources._vendor.importlib_resources._compat • pkg_resources._vendor.importlib_resources._itertools • pkg_resources._vendor.importlib_resources._legacy • pkg_resources._vendor.importlib_resources.abc • pkg_resources._vendor.importlib_resources.simple • pkg_resources._vendor.jaraco.functools • pkg_resources._vendor.packaging._manylinux • pkg_resources._vendor.packaging._musllinux • pkg_resources._vendor.packaging.markers • pkg_resources._vendor.packaging.requirements • pkg_resources._vendor.packaging.specifiers • pkg_resources._vendor.packaging.tags • pkg_resources._vendor.packaging.utils • pkg_resources._vendor.packaging.version • pkg_resources._vendor.pyparsing • pkg_resources._vendor.pyparsing.core • pkg_resources._vendor.pyparsing.diagram • pkg_resources._vendor.pyparsing.exceptions • pkg_resources._vendor.pyparsing.helpers • pkg_resources._vendor.pyparsing.results • pkg_resources._vendor.pyparsing.testing • pkg_resources._vendor.pyparsing.unicode • pkg_resources._vendor.pyparsing.util • pyparsing • pyparsing.core • pyparsing.diagram • pyparsing.exceptions • pyparsing.helpers • pyparsing.results • pyparsing.testing • pyparsing.unicode • pyparsing.util • typing_extensions

typing_extensions SourceModule

imports: abc • collections • collections.abc • functools • inspect • operator • sys • types • typing • warnings

imported by: bleak • bleak.backends.bluezdbus.client • bleak.backends.client • bleak.backends.corebluetooth.client • bleak.backends.winrt.client • jinja2.bccache • jinja2.compiler • jinja2.defaults • jinja2.environment • jinja2.ext • jinja2.filters • jinja2.lexer • jinja2.nodes • jinja2.parser • jinja2.runtime • jinja2.utils • jinja2.visitor • markupsafe • matplotlib.pyplot • packaging.metadata

unicodedata C:\Python311\DLLs\unicodedata.pyd

imported by: encodings.idna • matplotlib._mathtext • re._parser • stringprep • urllib.parse

unittest Package

imports: ntpath • unittest • unittest.async_case • unittest.case • unittest.loader • unittest.main • unittest.result • unittest.runner • unittest.signals • unittest.suite • unittest.util

imported by: doctest • numpy.testing • numpy.testing._private.utils • unittest • unittest._log • unittest.async_case • unittest.case • unittest.loader • unittest.main • unittest.result • unittest.runner • unittest.signals • unittest.suite • unittest.util

unittest._log SourceModule

imports: collections • logging • unittest • unittest.case

imported by: unittest.case

unittest.async_case SourceModule

imports: asyncio • contextvars • inspect • unittest • unittest.case • warnings

imported by: unittest

unittest.case SourceModule

imports: collections • contextlib • difflib • functools • pprint • re • sys • traceback • types • unittest • unittest._log • unittest.result • unittest.util • warnings

imported by: numpy.testing._private.utils • unittest • unittest._log • unittest.async_case • unittest.loader • unittest.runner • unittest.suite

unittest.loader SourceModule

imports: fnmatch • functools • os • re • sys • traceback • types • unittest • unittest.case • unittest.suite • unittest.util • warnings

imported by: unittest • unittest.main

unittest.main SourceModule

imports: argparse • os • sys • unittest • unittest.loader • unittest.runner • unittest.signals • warnings

imported by: unittest

unittest.result SourceModule

imports: functools • io • sys • traceback • unittest • unittest.util

imported by: unittest • unittest.case • unittest.runner

unittest.runner SourceModule

imports: sys • time • unittest • unittest.case • unittest.result • unittest.signals • warnings

imported by: unittest • unittest.main

unittest.signals SourceModule

imports: functools • signal • unittest • weakref

imported by: unittest • unittest.main • unittest.runner

unittest.suite SourceModule

imports: sys • unittest • unittest.case • unittest.util

imported by: unittest • unittest.loader

unittest.util SourceModule

imports: collections • ntpath • unittest

imported by: unittest • unittest.case • unittest.loader • unittest.result • unittest.suite

urllib Package

imported by: email._header_value_parser • matplotlib.image • urllib.error • urllib.parse • urllib.request • urllib.response

urllib.error SourceModule

imports: urllib • urllib.response

imported by: numpy.lib._datasource • urllib.request

urllib.parse SourceModule

imports: collections • functools • re • sys • types • unicodedata • urllib • warnings

imported by: email.utils • http.client • http.cookiejar • http.server • jinja2.utils • matplotlib.image • matplotlib.textpath • mimetypes • nturl2path • numpy.lib._datasource • packaging.requirements • pathlib • pkg_resources._vendor.packaging.requirements • pydoc • urllib.request • xml.sax.saxutils • xmlrpc.client

urllib.request SourceModule

imports: _scproxy • base64 • bisect • contextlib • email • email.utils • fnmatch • ftplib • getpass • hashlib • http.client • http.cookiejar • io • mimetypes • nturl2path • os • posixpath • re • socket • ssl • string • sys • tempfile • time • urllib • urllib.error • urllib.parse • urllib.response • warnings • winreg

imported by: http.cookiejar • matplotlib • numpy.lib._datasource • xml.sax.saxutils

urllib.response SourceModule

imports: tempfile • urllib

imported by: urllib.error • urllib.request

uuid SourceModule

imports: _uuid • enum • hashlib • io • os • platform • random • shutil • socket • subprocess • sys • time

imported by: bleak • bleak.backends.bluezdbus.characteristic • bleak.backends.bluezdbus.client • bleak.backends.characteristic • bleak.backends.client • bleak.backends.corebluetooth.client • bleak.backends.p4android.characteristic • bleak.backends.p4android.client • bleak.backends.service • bleak.backends.winrt.characteristic • bleak.backends.winrt.client • bleak.backends.winrt.scanner • bleak.uuids • matplotlib.backend_tools • matplotlib.backends._backend_tk

vms_lib MissingModule

imported by: platform

warnings SourceModule

imports: _warnings • builtins • linecache • re • sys • traceback • tracemalloc

imported by: PIL.IcoImagePlugin • PIL.Image • PIL.JpegImagePlugin • PIL.PngImagePlugin • PIL.TgaImagePlugin • PIL.TiffImagePlugin • PIL._deprecate • PIL.features • argparse • ast • asyncio.base_events • asyncio.base_subprocess • asyncio.events • asyncio.proactor_events • asyncio.selector_events • asyncio.sslproto • asyncio.streams • asyncio.tasks • asyncio.unix_events • asyncio.windows_utils • bleak • bleak.backends.bluezdbus.client • bleak.backends.bluezdbus.scanner • bleak.backends.client • bleak.backends.device • bleak.backends.p4android.client • bleak.backends.p4android.scanner • bleak.backends.p4android.utils • bleak.backends.winrt.client • codeop • dateutil.parser • dateutil.parser._parser • dateutil.relativedelta • dateutil.rrule • dateutil.tz.tz • dateutil.zoneinfo • enum • esp_controller.py • ftplib • getpass • gettext • gzip • hashlib • hmac • http.client • http.cookiejar • imp • importlib • importlib._abc • importlib.abc • importlib.metadata • importlib.resources._legacy • importlib.util • io • locale • logging • matplotlib • matplotlib._api • matplotlib._api.deprecation • matplotlib.artist • matplotlib.axis • matplotlib.bezier • matplotlib.collections • matplotlib.image • matplotlib.projections • matplotlib.style.core • multiprocessing.forkserver • multiprocessing.pool • multiprocessing.resource_tracker • numpy • numpy._distributor_init • numpy._pytesttester • numpy.array_api • numpy.core • numpy.core._internal • numpy.core._methods • numpy.core.arrayprint • numpy.core.fromnumeric • numpy.core.function_base • numpy.core.getlimits • numpy.core.numeric • numpy.core.numerictypes • numpy.core.records • numpy.core.shape_base • numpy.lib • numpy.lib.format • numpy.lib.function_base • numpy.lib.histograms • numpy.lib.index_tricks • numpy.lib.nanfunctions • numpy.lib.npyio • numpy.lib.polynomial • numpy.lib.ufunclike • numpy.lib.utils • numpy.linalg.linalg • numpy.ma.core • numpy.ma.extras • numpy.ma.mrecords • numpy.matrixlib.defmatrix • numpy.polynomial.polyutils • numpy.testing._private.utils • os • packaging._manylinux • pathlib • pkg_resources • pkg_resources._vendor.importlib_resources._legacy • pkg_resources._vendor.more_itertools.more • pkg_resources._vendor.more_itertools.recipes • pkg_resources._vendor.packaging._manylinux • pkg_resources._vendor.packaging.specifiers • pkg_resources._vendor.packaging.version • pkg_resources._vendor.pyparsing.core • pkg_resources._vendor.pyparsing.util • pkgutil • pydoc • pyparsing.core • pyparsing.util • random • re • re._parser • runpy • shlex • sre_compile • sre_constants • sre_parse • ssl • subprocess • sysconfig • tempfile • threading • typing • typing_extensions • unittest.async_case • unittest.case • unittest.loader • unittest.main • unittest.runner • urllib.parse • urllib.request • webbrowser • zipfile

weakref SourceModule

imports: _collections_abc • _weakref • _weakrefset • atexit • copy • gc • itertools • sys

imported by: _threading_local • asyncio.base_events • asyncio.selector_events • asyncio.streams • asyncio.tasks • asyncio.windows_events • bleak.backends.bluezdbus.manager • concurrent.futures.process • concurrent.futures.thread • copy • dateutil.tz._factories • dateutil.tz.tz • esp_controller.py • functools • jinja2.environment • jinja2.loaders • logging • matplotlib.backend_bases • matplotlib.backend_tools • matplotlib.backends._backend_tk • matplotlib.cbook • matplotlib.path • matplotlib.text • matplotlib.transforms • multiprocessing.dummy • multiprocessing.queues • multiprocessing.sharedctypes • multiprocessing.util • numpy.lib.npyio • pkg_resources._vendor.pyparsing.results • tempfile • unittest.signals • xml.sax.expatreader

webbrowser SourceModule

imports: copy • getopt • glob • os • pwd • shlex • shutil • socket • subprocess • sys • tempfile • threading • warnings

imported by: matplotlib.backends.backend_webagg • pydoc

win32api MissingModule

imported by: pkg_resources._vendor.appdirs

win32com MissingModule

imported by: pkg_resources._vendor.appdirs

win32pdh MissingModule

imported by: numpy.testing._private.utils

winreg AliasNode

imports: winreg

imported by: dateutil.tz.win • six.moves

winreg (builtin module)

imported by: importlib._bootstrap_external • matplotlib • matplotlib.font_manager • mimetypes • pkg_resources._vendor.appdirs • platform • urllib.request • winreg

winrt MissingModule

imported by: bleak.backends.winrt.scanner

xml Package

imports: xml.sax.expatreader • xml.sax.xmlreader

imported by: xml.parsers • xml.sax

xml.parsers Package

imports: xml • xml.parsers.expat

imported by: xml.parsers.expat • xml.sax.expatreader • xmlrpc.client

xml.parsers.expat SourceModule

imports: pyexpat • sys • xml.parsers

imported by: plistlib • xml.parsers • xml.sax.expatreader • xmlrpc.client

xml.sax Package

imports: 'org.python' • io • os • sys • xml • xml.sax • xml.sax._exceptions • xml.sax.expatreader • xml.sax.handler • xml.sax.saxutils • xml.sax.xmlreader

imported by: xml.sax • xml.sax._exceptions • xml.sax.expatreader • xml.sax.handler • xml.sax.saxutils • xml.sax.xmlreader

xml.sax._exceptions SourceModule

imports: 'java.lang' • sys • xml.sax

imported by: xml.sax • xml.sax.expatreader • xml.sax.xmlreader

xml.sax.expatreader SourceModule

imports: _weakref • sys • weakref • xml.parsers • xml.parsers.expat • xml.sax • xml.sax._exceptions • xml.sax.handler • xml.sax.saxutils • xml.sax.xmlreader

imported by: xml • xml.sax

xml.sax.handler SourceModule

imports: xml.sax

imported by: xml.sax • xml.sax.expatreader • xml.sax.saxutils • xml.sax.xmlreader

xml.sax.saxutils SourceModule

imports: codecs • io • os • sys • urllib.parse • urllib.request • xml.sax • xml.sax.handler • xml.sax.xmlreader

imported by: xml.sax • xml.sax.expatreader • xml.sax.xmlreader

xml.sax.xmlreader SourceModule

imports: xml.sax • xml.sax._exceptions • xml.sax.handler • xml.sax.saxutils

imported by: xml • xml.sax • xml.sax.expatreader • xml.sax.saxutils

xmlrpc Package

imported by: xmlrpc.client

xmlrpc.client SourceModule

imports: base64 • datetime • decimal • errno • gzip • http.client • io • sys • time • urllib.parse • xml.parsers • xml.parsers.expat • xmlrpc

imported by: multiprocessing.connection

zipfile SourceModule

imports: argparse • binascii • bz2 • contextlib • importlib.util • io • itertools • lzma • os • pathlib • posixpath • py_compile • shutil • stat • struct • sys • threading • time • warnings • zlib

imported by: importlib.metadata • importlib.resources.readers • jinja2.environment • numpy.lib.npyio • pkg_resources • pkg_resources._vendor.importlib_resources._compat • pkg_resources._vendor.zipp • shutil

zipimport SourceModule

imports: _frozen_importlib • _frozen_importlib_external • _imp • _io • _warnings • importlib.readers • marshal • sys • time • zlib

imported by: jinja2.loaders • pkg_resources • pkgutil

zlib (builtin module)

imported by: PIL.PdfParser • PIL.PngImagePlugin • encodings.zlib_codec • gzip • shutil • tarfile • zipfile • zipimport
