ravithakkar011/ECE445-Home-Appliance-Energy-Monitor/models/ECE445 Block Diagram.drawio.pdf

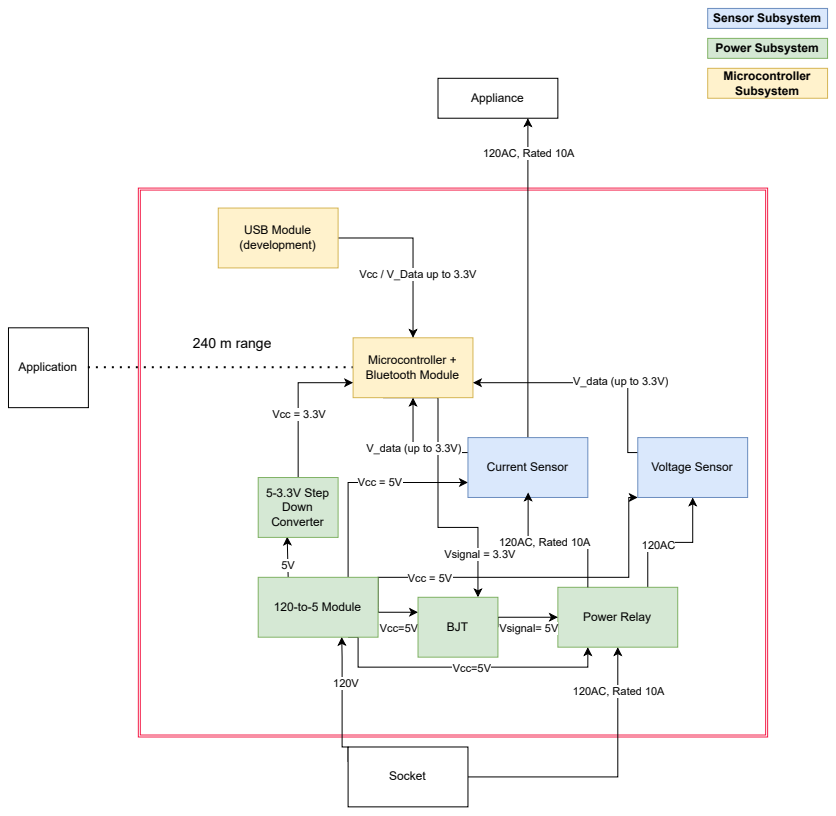
[picture p43: page 1]
Appliance; Vsignal = 3.3V; Microcontroller + Bluetooth Module; 120AC, Rated 10A; Socket; Application; 240 m range; Vcc = 5V; Vcc=5V; V_data (up to 3.3V); Voltage Sensor; Vcc = 3.3V; 5-3.3V Step Down Converter; Sensor Subsystem; Power Subsystem; Microcontroller Subsystem; USB Module (development)

Vcc / V_Data up to 3.3V

V_data (up to 3.3V)

Current Sensor

120-to-5 Module

BJT | Power Relay

Vcc=5V | Vsignal= 5V
