ravithakkar011/ECE445-Home-Appliance-Energy-Monitor/notebooks/om/445_circuit_drawing.pdf

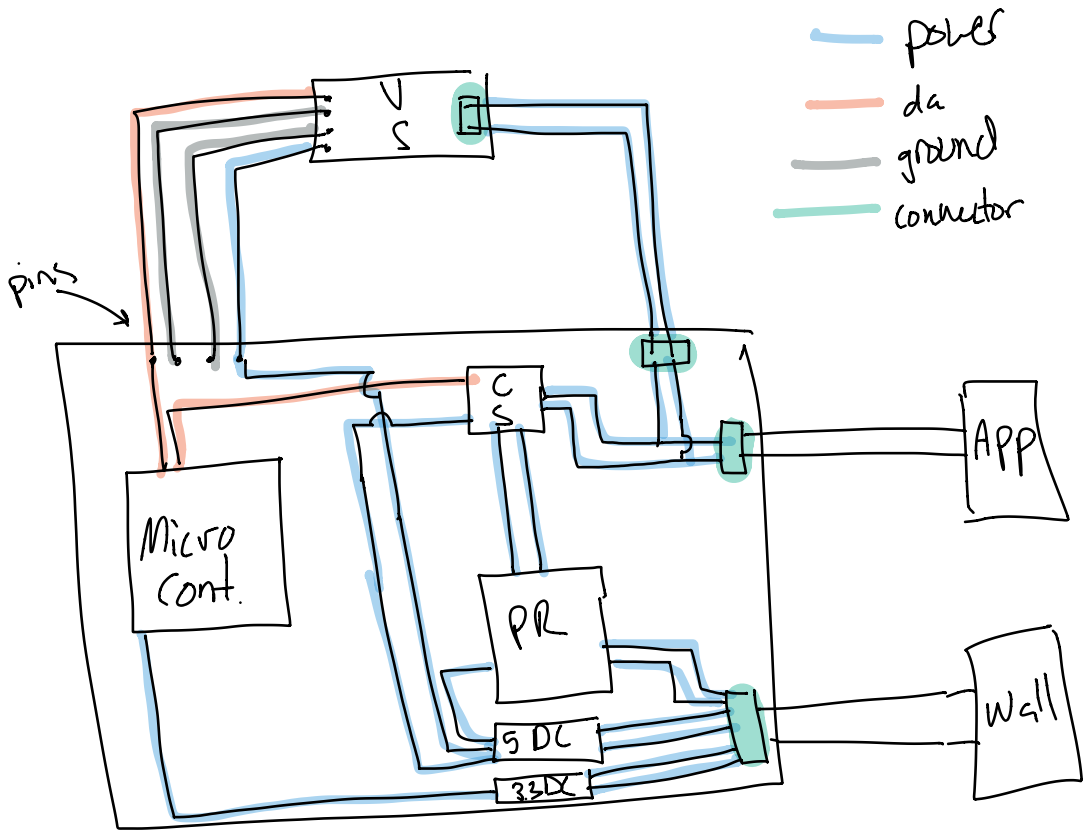
[picture p44: page 1]
