ravithakkar011/ECE445-Home-Appliance-Energy-Monitor/notebooks/om/Initial Block Diagram.pdf

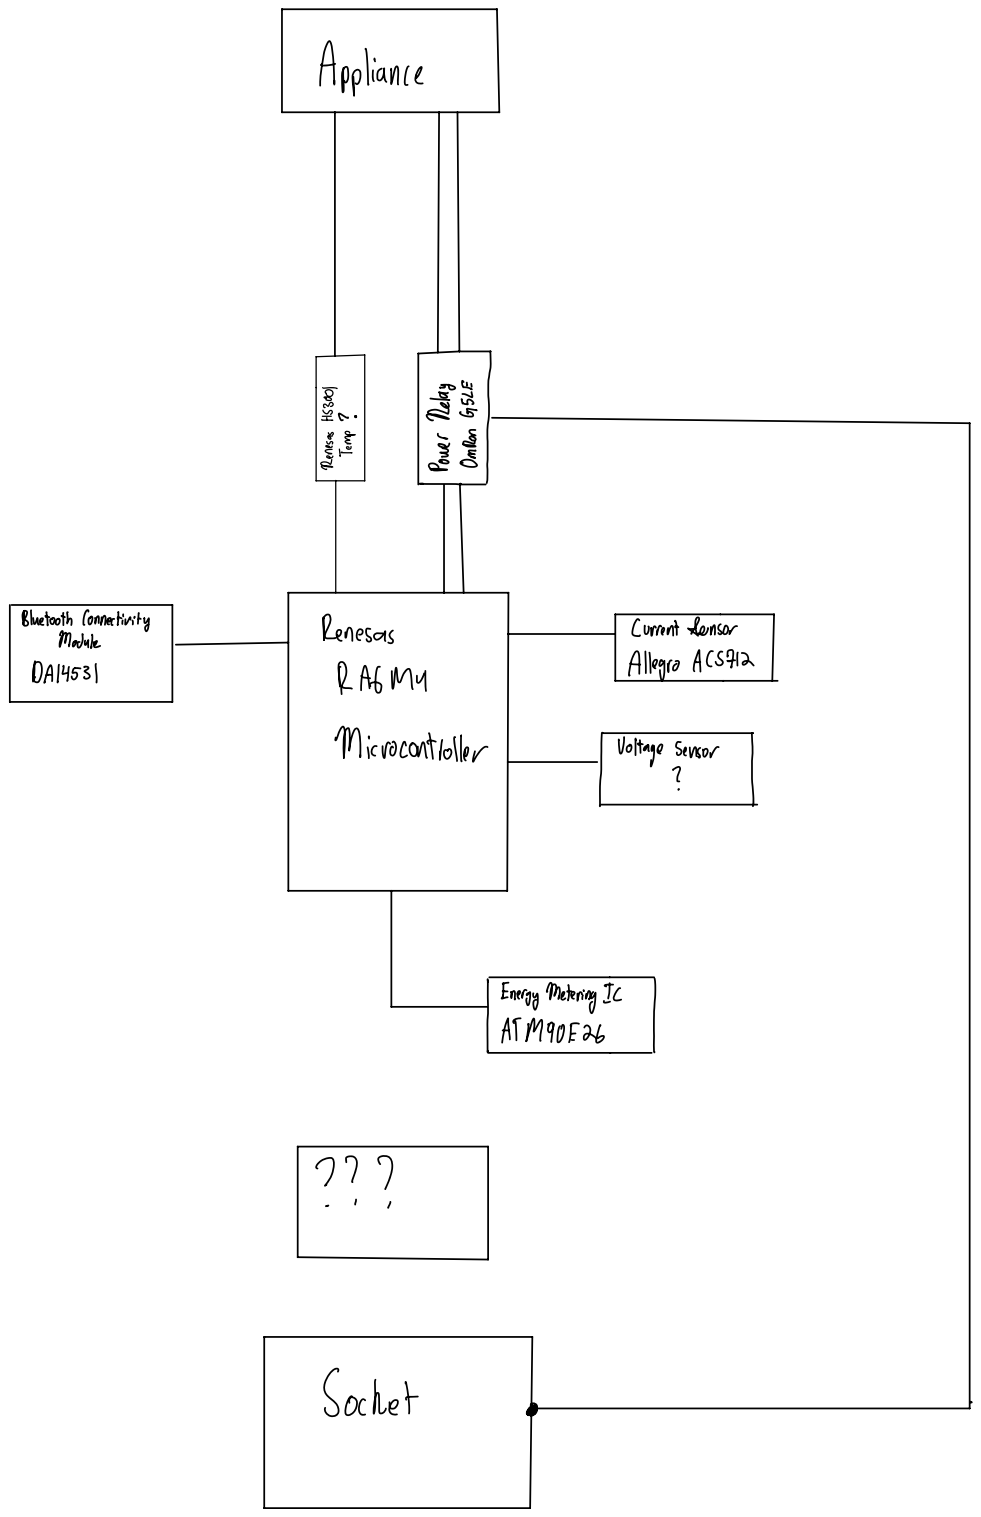
[picture p45: page 1]
