ravithakkar011/ECE445-Home-Appliance-Energy-Monitor/boards/board3/esp32_example.kicad_pcb

## KiCad design boards/board3/esp32_example.kicad_pcb (2023-12-08)

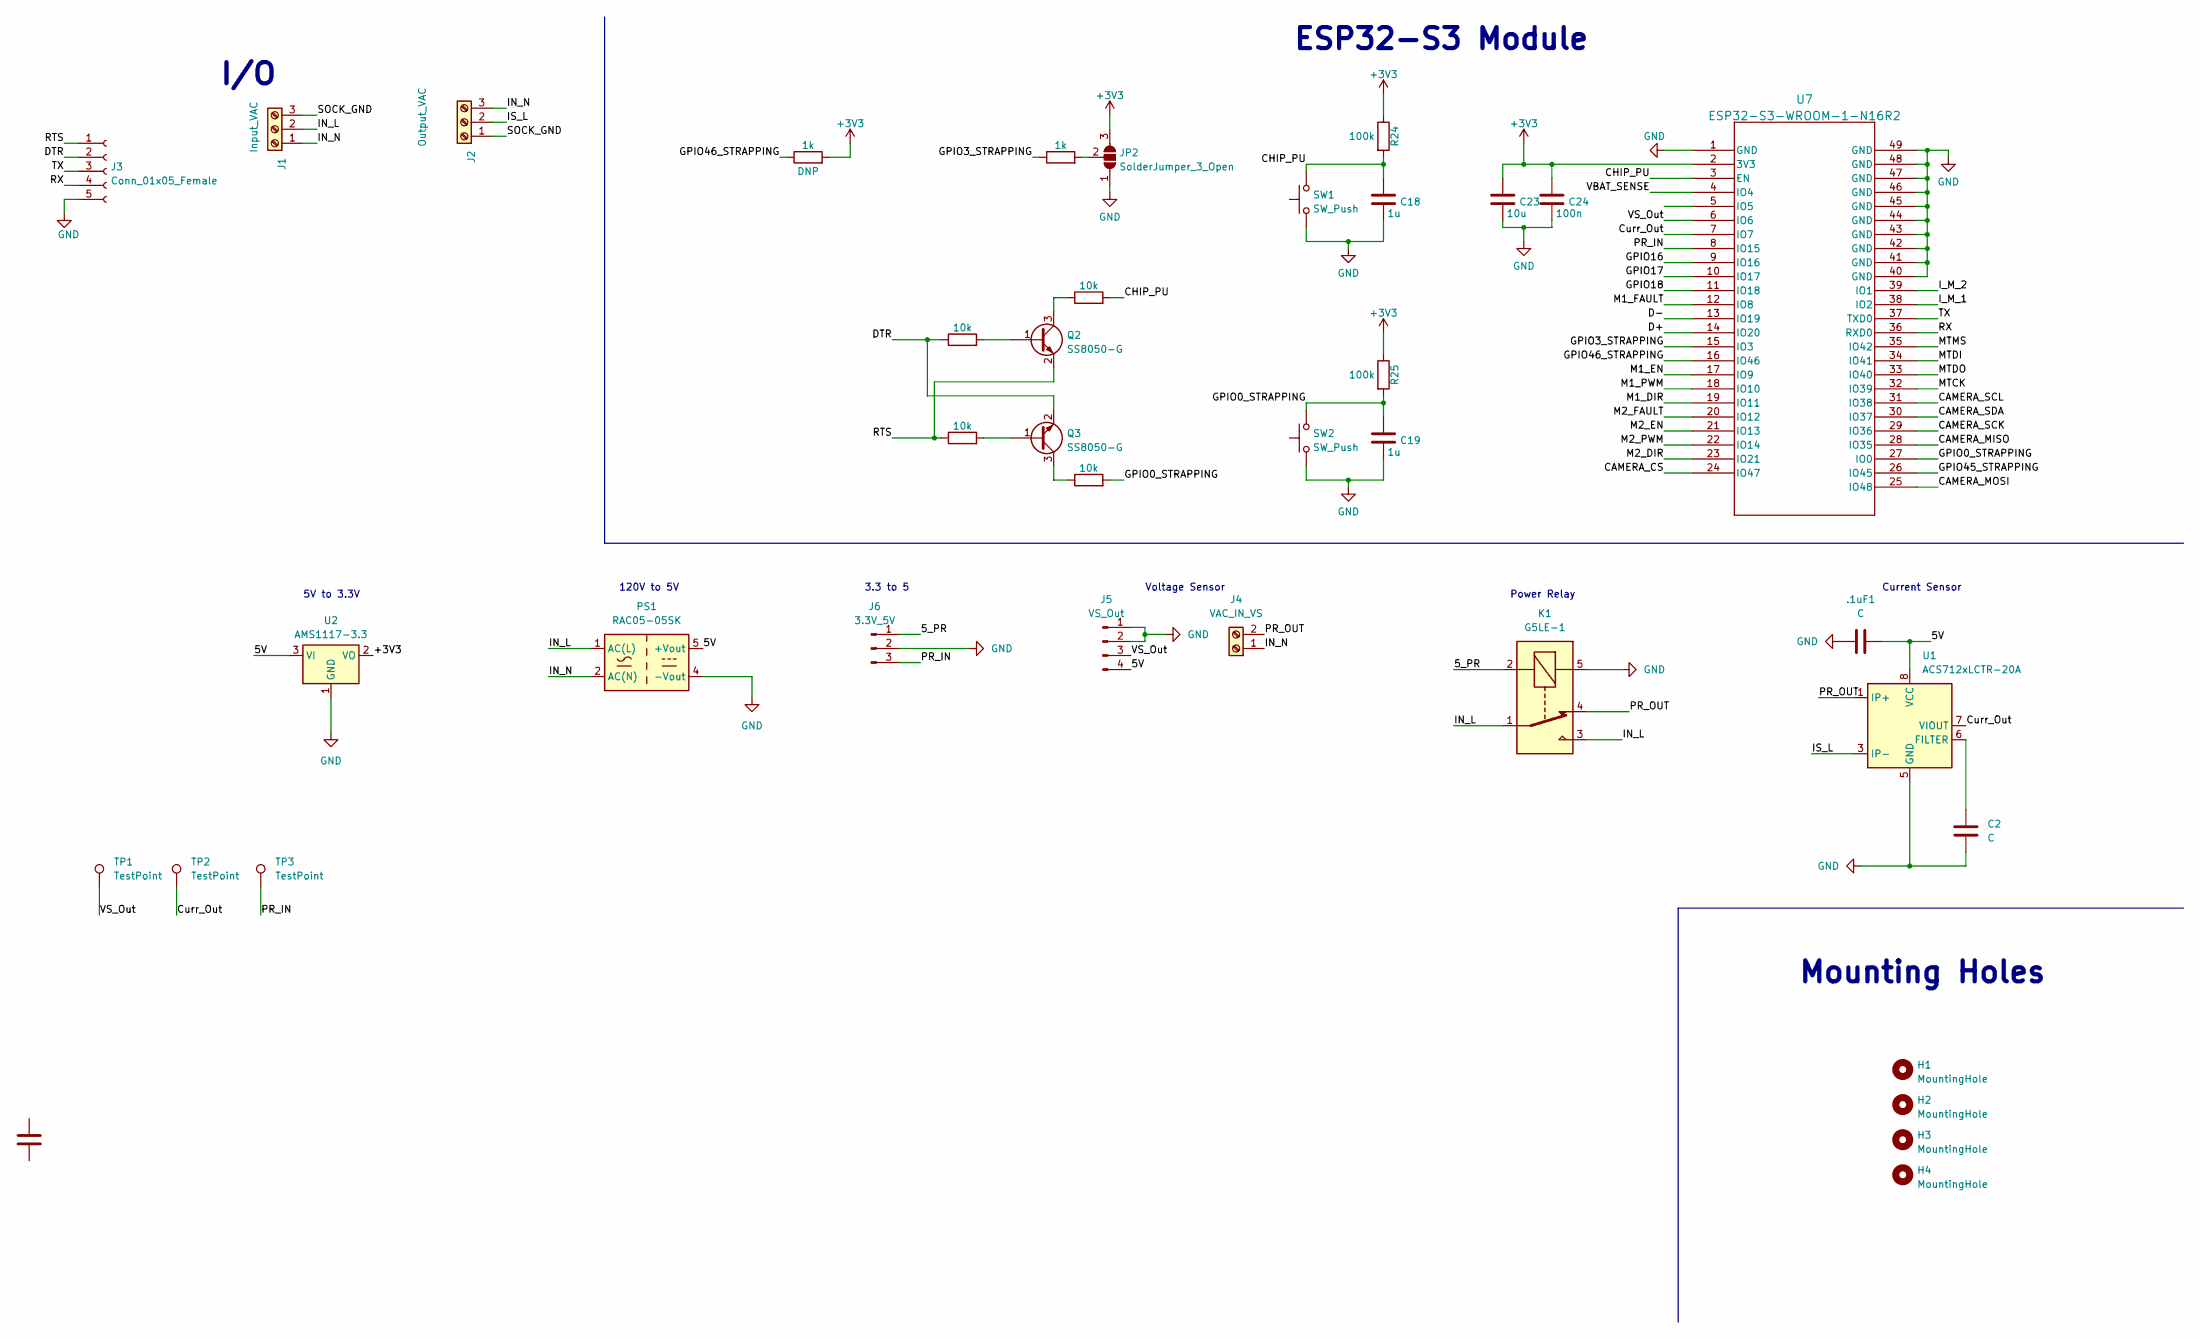
[picture p46: schematic esp32_example.kicad_sch, ESP32 Example: Motor Controller]

Parts:
.1uF1: C; C_0201_0603Metric
C1: 10u; R_1206_3216Metric
C2: C; C_0201_0603Metric
C18, C19: 1u; C_0805_2012Metric
C23: 10u; C_0805_2012Metric
C24: 100n; C_0805_2012Metric
H1, H2, H3, H4: MountingHole; MountingHole_3.2mm_M3
J1: Input_VAC; TerminalBlock_Phoenix_MKDS-1,5-3-5.08_1x03_P5.08mm_Horizont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
J2: Output_VAC; TerminalBlock_Phoenix_MKDS-1,5-3-5.08_1x03_P5.08mm_Horizont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
J3: Conn_01x05_Female; PinHeader_1x05_P2.54mm_Vertical
J4: VAC_IN_VS; TerminalBlock_Phoenix_MKDS-1,5-2_1x02_P5.00mm_Horizontal
J5: VS_Out; Molex_KK-254_AE-6410-04A_1x04_P2.54mm_Vertical
J6: 3.3V_5V; Molex_KK-254_AE-6410-03A_1x03_P2.54mm_Vertical
JP2: SolderJumper_3_Open; SolderJumper-3_P2.0mm_Open_TrianglePad1.0x1.5mm
K1: G5LE-1; Relay_SPDT_Omron-G5LE-1
PS1: RAC05-05SK; Converter_ACDC_RECOM_RAC05-xxSK_THT
Q2, Q3: SS8050-G; SOT-23
R12, R17: 1k; R_0805_2012Metric
R13, R14, R18, R19: 10k; R_0805_2012Metric
R24, R25: 100k; R_0805_2012Metric
SW1, SW2: SW_Push; SW_SPST_B3S-1000
TP1, TP2, TP3: TestPoint; TestPoint_Keystone_5010-5014_Multipurpose
U1: ACS712xLCTR-20A; SOIC-8_3.9x4.9mm_P1.27mm
U2: AMS1117-3.3; SOT-223-3_TabPin2
U7: ESP32-S3-WROOM-1-N16R2; ESP32-S3-WROOM-1_EXP

Connections:
+3V3: C23.1, C24.1, JP2.3 (B), R12.2, R24.1, R25.1, U2.2 (VO), U7.2 (3V3)
/5V: .1uF1.2, J5.4, PS1.5 (+Vout), U1.8 (VCC), U2.3 (VI)
/5_PR: J6.1, K1.2
/CAMERA_CS: U7.24 (IO47)
/CAMERA_MISO: U7.28 (IO35)
/CAMERA_MOSI: U7.25 (IO48)
/CAMERA_SCK: U7.29 (IO36)
/CAMERA_SCL: U7.31 (IO38)
/CAMERA_SDA: U7.30 (IO37)
/CHIP_PU: C18.1, R18.2, R24.2, SW1.2, U7.3 (EN)
/Curr_Out: TP2.1, U1.7 (VIOUT), U7.7 (IO7)
/D+: U7.14 (IO20)
/D-: U7.13 (IO19)
/DTR: J3.2, Q3.2 (E), R13.1
/GPIO0_STRAPPING: C19.1, R19.2, R25.2, SW2.2, U7.27 (IO0)
/GPIO3_STRAPPING: R17.1, U7.15 (IO3)
/GPIO16: U7.9 (IO16)
/GPIO17: U7.10 (IO17)
/GPIO18: U7.11 (IO18)
/GPIO45_STRAPPING: U7.26 (IO45)
/GPIO46_STRAPPING: R12.1, U7.16 (IO46)
/IN_L: J1.2, K1.1, K1.3, PS1.1 (AC(L))
/IN_N: J1.1, J2.3, J4.1, PS1.2 (AC(N))
/IS_L: J2.2, U1.3 (IP-), U1.4 (IP-)
/I_M_1: U7.38 (IO2)
/I_M_2: U7.39 (IO1)
/M1_DIR: U7.19 (IO11)
/M1_EN: U7.17 (IO9)
/M1_FAULT: U7.12 (IO8)
/M1_PWM: U7.18 (IO10)
/M2_DIR: U7.23 (IO21)
/M2_EN: U7.21 (IO13)
/M2_FAULT: U7.20 (IO12)
/M2_PWM: U7.22 (IO14)
/MTCK: U7.32 (IO39)
/MTDI: U7.34 (IO41)
/MTDO: U7.33 (IO40)
/MTMS: U7.35 (IO42)
/PR_IN: J6.3, TP3.1, U7.8 (IO15)
/PR_OUT: J4.2, K1.4, U1.1 (IP+), U1.2 (IP+)
/RTS: J3.1, Q2.2 (E), R14.1
/RX: J3.4, U7.36 (RXD0)
/SOCK_GND: J1.3, J2.1
/TX: J3.3, U7.37 (TXD0)
/VBAT_SENSE: U7.4 (IO4)
/VS_Out: J5.3, TP1.1, U7.6 (IO6)
GND: .1uF1.1, C2.2, C18.2, C19.2, C23.2, C24.2, J3.5, J5.1, J5.2, J6.2, JP2.1 (A), K1.5, PS1.4 (-Vout), SW1.1, SW2.1, U1.5 (GND), U2.1 (GND), U7.1 (GND), U7.40 (GND), U7.41 (GND), U7.42 (GND), U7.43 (GND), U7.44 (GND), U7.45 (GND), U7.46 (GND), U7.47 (GND), U7.48 (GND), U7.49 (GND)
unnamed: JP2.2 (C), R17.2
unnamed: Q2.1 (B), R13.2
unnamed: Q2.3 (C), R18.1
unnamed: Q3.1 (B), R14.2
unnamed: Q3.3 (C), R19.1
unnamed: C2.1, U1.6 (FILTER)

Notes on the sheet:
Voltage Sensor
3.3 to 5
Current Sensor
120V to 5V
ESP32-S3 Module
Mounting Holes
5V to 3.3V
Power Relay
I/O

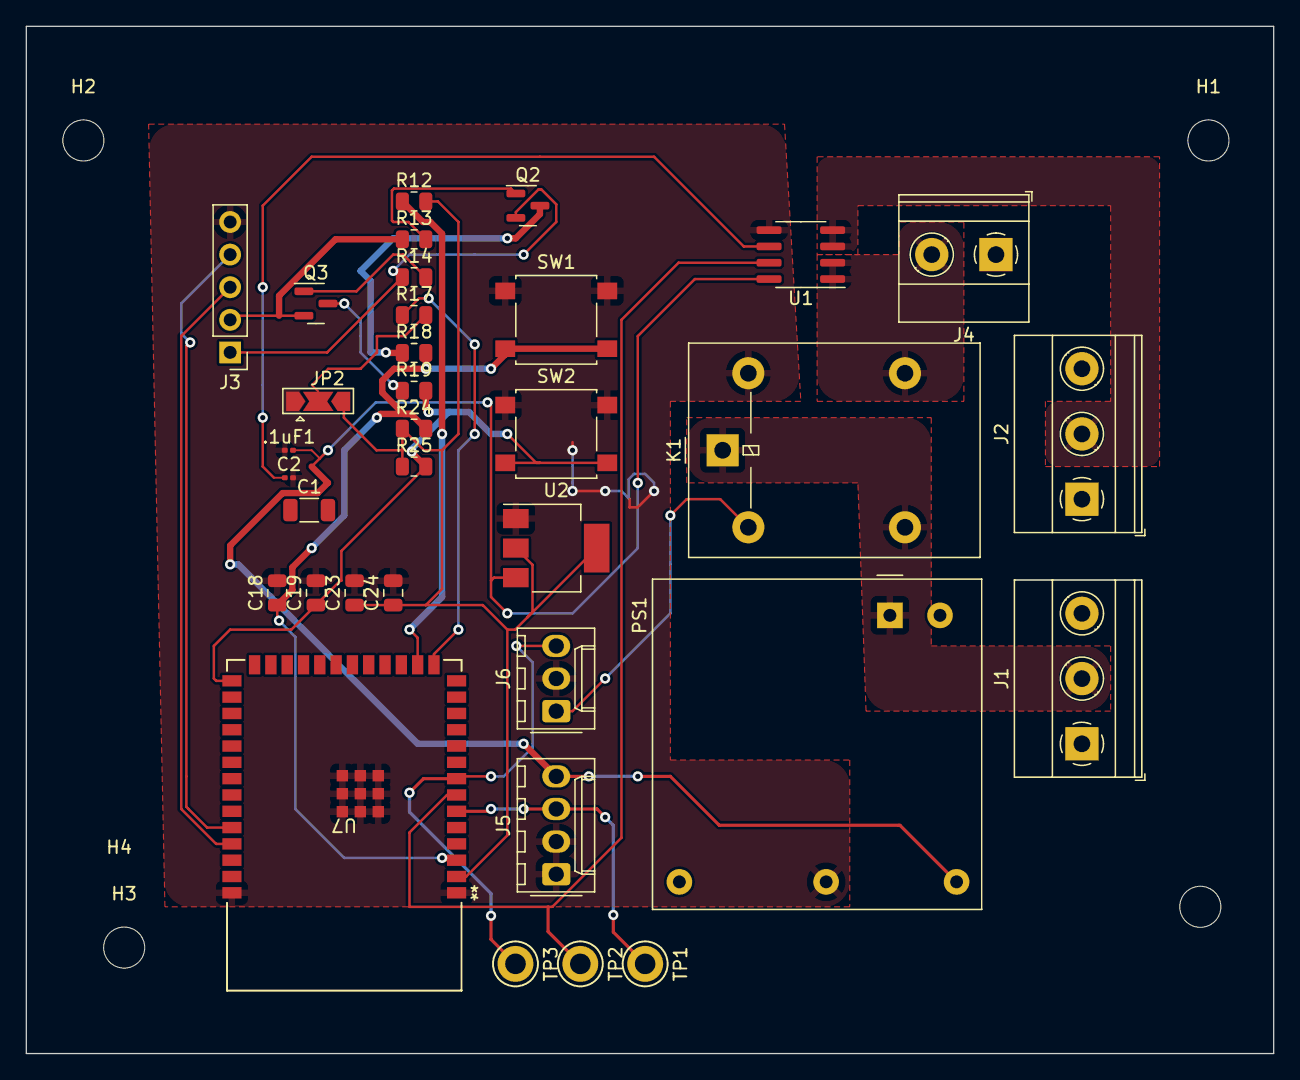
[picture p47: board esp32_example.kicad_pcb from above]

Board: 2 copper layers, 97.2 x 80.0 mm, 38 parts (0 on the bottom side), 26 nets.
