ravithakkar011/ECE445-Home-Appliance-Energy-Monitor/boards/board2/version2.kicad_pcb

## KiCad design boards/board2/version2.kicad_pcb (2023-12-08)

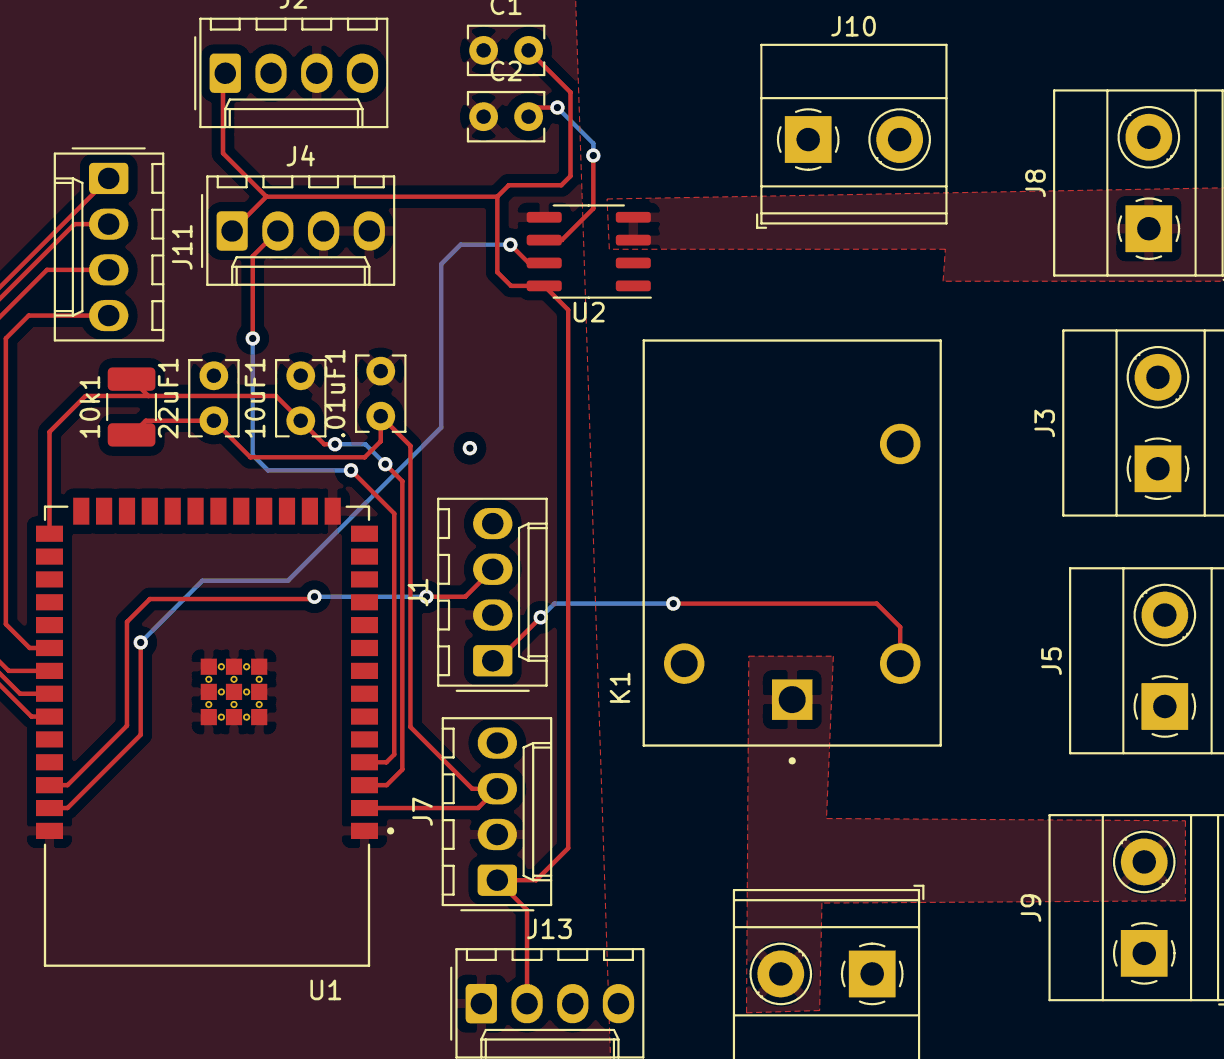
[picture p48: board version2.kicad_pcb from above]

Board: 2 copper layers, 21 parts (0 on the bottom side), 18 nets.

Parts:
10k1: R; R_1210_3225Metric_Pad1.30x2.65mm_HandSolder
10uF1, 22uF1, .01uF1: C; C_Rect_L4.0mm_W2.5mm_P2.50mm
C1, C2: C; C_Rect_L4.0mm_W2.5mm_P2.50mm
J1: 3.3_5_boost; Molex_KK-254_AE-6410-04A_1x04_P2.54mm_Vertical
J2: Scopy Connection; Molex_KK-254_AE-6410-04A_1x04_P2.54mm_Vertical
J3: SecondOutGND; TerminalBlock_Phoenix_MKDS-1,5-2-5.08_1x02_P5.08mm_Horizont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
J4: Voltage_Sensor; Molex_KK-254_AE-6410-04A_1x04_P2.54mm_Vertical
J5: SecondGNDPin; TerminalBlock_Phoenix_MKDS-1,5-2-5.08_1x02_P5.08mm_Horizont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
J7: 5_3_connector; Molex_KK-254_AE-6410-04A_1x04_P2.54mm_Vertical
J8: OutVAC; TerminalBlock_Phoenix_MKDS-1,5-2-5.08_1x02_P5.08mm_Horizont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
J9: MainPin; TerminalBlock_Phoenix_MKDS-1,5-2-5.08_1x02_P5.08mm_Horizont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
J10: Voltage_Sensor_Input; TerminalBlock_Phoenix_MKDS-1,5-2-5.08_1x02_P5.08mm_Horizont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
J11: JTAG; Molex_KK-254_AE-6410-04A_1x04_P2.54mm_Vertical
J13: OutPut and Ground; Molex_KK-254_AE-6410-04A_1x04_P2.54mm_Vertical
J14: VAC Conn; TerminalBlock_Phoenix_MKDS-1,5-2-5.08_1x02_P5.08mm_Horizont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
K1: G5LE-1A; RELAY_G5LE-1A-EDC5
U1: ESP32-S3-WROOM-1-N16R2; XCVR_ESP32-S3-WROOM-1-N16R2
U2: ACS712xLCTR-20A; SOIC-8_3.9x4.9mm_P1.27mm

Connections:
GND: 10uF1.2, 22uF1.2, .01uF1.2, C1.1, C2.1, J1.2, J2.3, J4.3, J4.4, J7.2, J13.1, K1.5, U1.1, U1.15, U1.40, U1.41_1, U1.41_2, U1.41_3, U1.41_4, U1.41_5, U1.41_6, U1.41_7, U1.41_8, U1.41_9, U2.5
unnamed: 10k1.2, 10uF1.1, U1.3, U1.27
unnamed: 10k1.1, 22uF1.1, .01uF1.1, J7.3, U1.2
unnamed: C1.2, J2.1, J4.1, J7.1, J13.2, U2.8
unnamed: C2.2, U2.6
unnamed: J1.1, K1.2
unnamed: J1.3, U1.38
unnamed: J3.2, J5.1
unnamed: J4.2, U1.4
unnamed: J8.1, U2.3, U2.4
unnamed: J10.1, K1.3, U2.1, U2.2
unnamed: J8.2, J9.1, J10.2, J14.1
unnamed: J11.1, U1.35
unnamed: J11.2, U1.34
unnamed: J11.3, U1.33
unnamed: J11.4, U1.32
unnamed: J9.2, J14.2, K1.1
unnamed: U1.39, U2.7
