ravithakkar011/ECE445-Home-Appliance-Energy-Monitor/(commit log)

2023-10-25 PCB design 2
    [esp32_example.kicad_pcb, esp32_example.kicad_sch]
2023-12-08 Create 14. 10-7-23 PCB Review
2023-12-08 Create 16. 10-16-23 PCB Review
2023-12-08 forgot to add notes
    [Stocks.csv, data_x_x2_x3.csv, msft.csv]
2023-12-08 Create 21. 11-13-23 PCB Soldering
2023-12-08 Create 22. 11-14-23 Soldering
2023-12-08 Update 22. 11-14-23 Soldering
2023-12-08 Rename 25. 11-27-23 to 25. 11-27-23 Sensor Testing
2023-12-08 Create 26. 11-28-23 Power Relay Testing
